LeeSpo/portable-display-epass-EVT1-minboot-r1/README.md

# Portable Display ePass

当前自研硬件为 **38 × 64 mm、四层 split-power 工程候选**，尚未放行生产。

- [打开当前 KiCad 工程与运行验证](portable-display/hardware/v1-WEB6-redesign/split-power-candidate/README_CN.md)
- [未完成项与实板验收](portable-display/hardware/v1-WEB6-redesign/split-power-candidate/OPEN_ISSUES_CN.md)
- [JLC 报价/预览包（未放行）](portable-display/hardware/v1-WEB6-redesign/split-power-candidate/verification/production_20261015/README_CN.md)
- [开发板学习资料](portable-display/hardware/v2-dev-board/README_CN.md)
- [项目进展、分支与旧稿恢复](portable-display/docs/PROJECT_STATUS_CN.md)

仓库只保留最新工程和验证包。旧版本、布线试验和历史报告通过 Git 历史追溯；不重写历史。
