LeeSpo/portable-display-epass-EVT1-minboot-r1/portable-display/README.md

# Portable Display

当前硬件为 38 × 64 mm 四层工程候选。电源冷启动、屏幕装配和实板功能尚未验收，**未放行投板、贴片或上电**。

| 入口 | 内容 |
|---|---|
| [当前自研工程](hardware/v1-WEB6-redesign/split-power-candidate/README_CN.md) | 原理图、PCB、本地库、约束及独立验证工具 |
| [当前工程验收记录](hardware/v1-WEB6-redesign/split-power-candidate/OPEN_ISSUES_CN.md) | 尚未关闭的工程与实板事项 |
| [开发板资料](hardware/v2-dev-board/README_CN.md) | YuzukiHD-Lizard 文档和图片，不是自研板的下一硬件版本 |
| [产品和屏幕资料](docs/README.md) | 屏幕规范、机械装配评估和项目状态 |
| [原始参考资料](reference/README.md) | 芯片/连接器资料、原始引脚表 |

工程使用 `${KIPRJMOD}` 本地库。运行命令见当前工程 README；无需历史硬件目录。
