LeeSpo/portable-display-epass-EVT1-minboot-r1/portable-display/docs/README.md

# 产品和工程文档

- [项目进展、分支及旧稿恢复](PROJECT_STATUS_CN.md)
- [屏幕/PCB 装配评估](SCREEN_STACK_CN.md)
- [KD024 屏幕工程规格](kd024_screen/KD024EGOIN152-01_engineering_spec.md)
- [KD024 原始规格书](kd024_screen/raw-pdf/KD024EGOIN152-01_SPEC_V1.pdf)
- [原始参考资料](../reference/README.md)

当前硬件入口：[split-power-candidate](../hardware/v1-WEB6-redesign/split-power-candidate/README_CN.md)。
