LeeSpo/portable-display-epass-EVT1-minboot-r1/portable-display/hardware/v1-WEB6-redesign/README_CN.md

# WEB6 自研硬件

唯一维护的硬件是 [split-power-candidate](split-power-candidate/README_CN.md)。
用 KiCad 10 打开该目录的 `ak_display_38x64_SPLIT_POWER_CANDIDATE.kicad_pro`。

旧 placement-only 布局和路由试验已从当前文件树移除；[项目状态及恢复方法](../../docs/PROJECT_STATUS_CN.md)记录其 Git 来源。
当前工程仍未放行生产。
