LeeSpo/portable-display-epass-EVT1-minboot-r1/portable-display/hardware/v2-dev-board/README_CN.md

# V851S 开发板参考资料

从 `dev-board` 的 `13f46d0` 合入。目录名 `v2-dev-board` 沿用原分支，内容是 YuzukiHD-Lizard 学习资料，并非自研 PCB 的 EVT2。

- [开发板介绍](YuzukiHD-Lizard/01-BoardIntroduction.md)
- [配套资源](YuzukiHD-Lizard/02-SupportingResources.md)
- [快速开始](YuzukiHD-Lizard/03-QuickStart.md)
- [开发环境](YuzukiHD-Lizard/06-ConfigHostEnv.md)
- [Tina SDK 开发](YuzukiHD-Lizard/07-TinaSDK_DevelopmentGuide.md)

已保留原分支的 50 个文档/图片文件，内容未修改；重复 ZIP 已移除。文档内外部资源为原资料记录，本次未重新验证其时效性。
