LeeSpo/portable-display-epass-EVT1-minboot-r1/portable-display/hardware/v1-WEB6-redesign/split-power-candidate/OPTIMIZATION_20261018_CN.md

# 2026-10-18 PCB 优化记录

本轮保留全部功能、38 × 64 mm 板框、四层叠层及原有规则。目标是改善调试、局部去耦和可制造性；工程候选状态不变。

## 已实施修改

| 修改 | 目的与范围 |
|---|---|
| TP1–TP10 裸测试点 | 从既有过孔引出十个直径 1 mm 的背面探针焊盘；只有铜和阻焊开窗，无锡膏，不采购、不贴装 |
| 电池线序丝印 | 背面新增 `1+ 2NTC 3-`，对应 J2 的 VBAT / BAT_NTC / GND；仍须按插座针号确认线材极性 |
| U2-47 独立去耦 | 增加 C64：100 nF / 0402 / C1525，复用现有料号；47 脚就近进入独立 3V3 过孔，C57 继续服务 55 脚 |
| DSI D0N 调长拐角 | 将 16 个直角换成 45° 转折，保持 0.127 mm 线宽、F.Cu 和长度匹配；D0 仍是两根独立走线 |
| 三处非 EP 过孔外移 | 外移原与 U1.6/7、C1.1、C46.2 重叠的过孔；保留 0.60/0.30 mm 尺寸，增加五段 0.30 mm 同网短线 |
| 生产包核对 | 逐颗检查 BOM 型号、封装、料号、数量，以及 CPL 坐标、面和角度；增加错误包回归案例 |

C64 位于 B 面 `(13.3, 26.1)`、180°；新 3V3 过孔位于 `(12.8, 25.025)`，新 GND 过孔位于 `(14.32, 26.425)`。为腾出回路，只调整局部 SOC_AVCC、FEL_KEY_N、PMIC_SDA 走线；C35、WAKE 和 ADC 路线保留。SOC_AVCC 末端有短段 0.127 mm 细颈，其余局部线路保持 0.18 mm；这不是载流或噪声实测结论。

新增 GND 过孔的铜环与 C64.1 角落略有重叠，钻孔本身未进入焊盘（孔边到焊盘约 0.07 mm）；该局部折中仍依赖既有全孔 POFV，不能当作普通开放通孔设计。

## 测试点

下表坐标是 KiCad 板坐标，均在 B 面；从背面查看时图像需要镜像。机器可读映射见 [testpoint_map.json](testpoint_map.json)。

| 位号 | 网络 | X / Y（mm） |
|---|---|---|
| TP1 | CORE_0V93 | 19.400 / 46.700 |
| TP2 | DRAM_1V5 | 29.550 / 44.900 |
| TP3 | 1V8 | 12.834 / 23.516 |
| TP4 | RTC_3V3 | 34.750 / 12.400 |
| TP5 | VSYS | 19.900 / 50.700 |
| TP6 | ELVDD | 6.900 / 41.100 |
| TP7 | ELVSS | 9.200 / 43.100 |
| TP8 | PMIC_SCL | 14.734 / 19.366 |
| TP9 | PMIC_SDA | 6.500 / 17.700 |
| TP10 | GND | 4.491 / 47.142 |

探针焊盘用于测量，不作为带载供电入口；PMIC I²C 测量设备须适配实际电源域。首次上电步骤见 [BRINGUP_CN.md](BRINGUP_CN.md)。

## 制造与预算影响

- 贴装数量由 130 增至 **131 颗：117 正面 / 14 背面**。C64 归入既有 C1525 行，BOM 仍为 54 行；测试点不进入 BOM/CPL。
- 本轮外移三处过孔后，U1/U2 EP 等区域仍有焊盘内过孔，**POFV 必须保留**；双面标准型贴片要求也保留。
- U12/U13 没有向 TF 卡座移动：卡座的机械占位和 courtyard 限制了位置，不宜仅按连通图强行靠近。
- 两块个人样机应按 **2 PCS 完整单板**核价。`3×2` 拼板的 `2 SET` 对应 12 PCS，不能据此当作两块单板的器件成本。
- 本轮不承诺总价 600 元。先纠正数量，再用新 BOM/CPL 取得包含 PCB、POFV 和全部贴装的正式报价。

## 验证与未完成项

当前源哈希、完整检查和预览见 [工程入口](README_CN.md)、[本轮验证](verification/current_20261018/README_CN.md)及[新生产预览包](verification/production_20261018/README_CN.md)。填铜在隔离编辑副本中受控保存；正式验证另用隔离副本，不保存维护源文件，不修改规则或豁免。

PMIC 批次 OTP 冷启动、屏幕/FPC 实物适配、装联/X-Ray、高速阻抗与实板波形仍需验收。DSI 等长和原生 DRC 通过都不能替代这些验收，详见 [OPEN_ISSUES_CN.md](OPEN_ISSUES_CN.md)。
