LeeSpo/portable-display-epass-EVT1-minboot-r1/portable-display/hardware/v1-WEB6-redesign/split-power-candidate/PREFLIGHT_DECISIONS_CN.md

# 预投板阻塞项修复：决策日志（fix/preflight-blockers）

> 历史工程决策记录：器件数量、哈希、图片和检查结果对应各段原日期。当前状态见 [README](README_CN.md)、[未完成项](OPEN_ISSUES_CN.md)及本轮验证；旧报告从固定 Git 提交读取。

> 用户把所有选择都交给了我们，原则是：**先保证能工作，再尽量便宜**。优先选 JLC/LCSC 有库存的料，basic 库优先。
> DRC 规则一律不放宽，也不加任何豁免。过孔统一 0.60/0.30。U1/U2 不移动。fabrication 仍为 **未放行**。
> 价格和库存是 2026-10-15 查询 JLC/LCSC API 得到的。

## 1. FEL 铜皮 + 原理图同步
- 详见 `FEL_REPAIR_CN.md`。原理图由 `tools/build_candidate_schematic.py` 从 PCB 重新生成。parity 0 / ERC 0。

## 2. LCD_EN 默认关断：R35 10k（C25744，basic，LCSC $0.0033 @100）
- 评审建议在 R31 上贴 100k。核对后发现 **R31 不是下拉**，它是 LCD_SWIRE↔LCD_EN 之间的 0R 跨接，应保持 DNP。如果把它贴上，SWIRE 和 EN 会被短接，所以没有采纳这条建议。
- 因此新增 R35 下拉到 GND。阻值取 10k 而不是 100k：按 GPIO 漏电最坏 10 µA 估算，10k 上的压降 ≤0.1 V，可以可靠地保持 U8 / U10 CTRL 为低；换成 100k 最坏会到 1 V，不安全。PD21 驱动为高时，10k 上的电流是 0.33 mA，可以接受。

## 3. D6–D14 ESD：ESDLC5V0LB（扬杰，C20168172，$0.0297 @20+，库存约 2900）
- 5 V 双向，约 3 pF，适合 SD 和按键这类低速信号。原来的料与封装不一致。新建 `sameat.pretty/DFN1006-2`，焊盘按数据手册 p5 绘制（±0.425，0.55×0.60）。

## 4. J2 电池座：Megastar ZX-SH1.0-3PWT（C7430445，$0.0573，库存约 67k）
- J1 和 H4 之间只有 8.49 mm。PH2.0（11.7 mm）和 MX1.25（9.4 mm）都放不下，JST S3B-PH（C265101）也缺货。SH1.0 3P 卧式能放下。
- **注意 1**：每个触点额定 1 A。1S 锂电只要平均电流 <1 A 就可以用，峰值应该由 PMIC 限流。
- **注意 2**：电池线序是 1=VBAT、2=NTC、3=GND。市售 SH1.0 电池的线序**不统一**，接电前必须用万用表核对。
- 新封装 `SH1.0_3P_RA` 按厂家图纸绘制。VBAT/NTC/VBUS/PMIC_IRQ 已重新布线，并补了一条 In2 3V3 桥接，让 3V3 带状铺铜保持连续。

## 5. J5 microSD —— **未完成（开放项）**
- 原料 MUP-M617-2（C5205359）在 JLC 缺货。选定的替代是 **XKTF-0803-0（XKB，C381083，$0.2058，库存约 1613，push-push，11.25×6 mm）**，可以放进原来的位置。
- 封装 `sameat.pretty/XKTF-0803-0.kicad_mod` 已提交。焊盘与 JLC EasyEDA 官方封装和 XKB 图纸逐一核对过。
- 没有换上板的原因：换件后引脚顺序会整体反过来。原来的 SD 走线、以及 RTC_3V3 / PMIC_SDA / PWRON_N 的长线都需要重新布线。我们写的自动布线器做不到 0 违规（freerouting 2.1 也会卡在 11–18 根未布通）。为了不让分支变脏，**PCB 目前仍然是旧的 J5（BOM 里那个料缺货）**。
- 建议：在 KiCad GUI 里用交互式推挤布线完成，大约 1–2 小时。SD 走线放在 F/B 层，不要走 In2。可以顺便把 Y1 下方的 SD 线移开（见第 9 节）。

## 6. U8 输入电容（评审 g）
- C53 1 µF（CL05A105KA5NQNC，C52923，basic，$0.0079）+ C54 100 nF（CL05B104KO5NNNC，C1525，basic，LCSC $0.0046 @100）。两颗都在顶层，距离 U8.1 焊盘边 ≤0.65 mm。GND 过孔放在焊盘外，焊盘边到孔的距离 ≥0.15 mm。

## 7. VBUS 线宽（评审 h）
- J1→C32/U1.37 主路径上，B.Cu 的两段 0.25 mm 已加宽到 0.6 mm。
- J1 附近 F.Cu 的 0.25 mm 瓶颈没有加宽：加宽到 0.6 会碰到 CC2、SBU1 焊盘和 C2 的 GND，DRC 不过。J1 A4/B9 一侧另有一条 0.6 mm 并联路径。
- U1.37 的扇出保持 0.18 mm，这是焊盘间距限制的。
- 剩下的 0.127 mm 段在 U9 那条小电流支路上。

## 8. U2 去耦（评审 f）—— **未完成（开放项）**
- 我们对 U2 的 44/47/55（3V3）、37（1V8）、13/17/75（CORE）做了自动搜索：要求顶层 0402、距焊盘 ≤2 mm、GND 过孔在焊盘外，结果**都找不到合规位置**。U2 周围的扇出和其它 courtyard 已经占满，也不能改 U2 或它的 courtyard。底层附近又没有对应电源网络的铜皮可以接。
- 现状：最近的去耦电容离引脚 5.7–11 mm，但这些电源在 In2 都有平面，In1 是 GND，所以电源回路阻抗本身不算差。
- 建议：在 GUI 里重新整理 U2 扇出，为顶层电容腾出位置。另一条路是放到底层，直接贴在 U2 背面，但这样就变成**双面 SMT**，JLC 要多收一次底面贴装的工程费和钢网费，成本明显上升。因为用户要求便宜，我们没有自动这样做。

## 9. 其它评审项
- (b) PMIC_SCL：B.Cu 上一段走线从 L2/LX_CORE 投影下方穿过。核实后，中间的 In1 在该处是**完整的 GND 铺铜**（已用 pcbnew 采样点确认），F 层到 B 层的耦合被屏蔽；I2C 只有 100/400 kHz。**决定不改线**，避免引入新的违规。
- (c) Y1：In1 和 In2 在 Y1 正下方都是 GND。B.Cu 上有 SD_D0、SD_D2、SD_DET、SD_PWR_EN、SOC_LDO_1V8 从下方穿过，它们被 In1 GND 隔开。In2 上有 SD_DET、SD_PWR_EN 两段静态信号从边缘经过。XIN 5.4 mm、XOUT 7.4 mm，受限于 U2 不能动。**留到 J5 返工时一起把 SD 线移出 Y1 区域**。
- (d) MIPI DSI：D0 skew 11.05 mm、CK 5.00 mm，CKP 有一个 90° 拐角。J4 和屏幕都还没定，**本轮不改**，等 J4 定型后再做等长和 45° 拐角。
- (e) I2C0 上拉 R15/R16：**保持接在主 3V3**。
  - 3V3 关断时，总线被拉到约 0 V。U4（LIS2DW12）和 U5（RV-3028）由 RTC_3V3 供电，它们的 IO 处于低电平，这在允许范围内，不会倒灌。
  - 如果把上拉改到 RTC_3V3，3V3 关断时总线仍是 3.3 V，电流会通过 V851S 的 IO 钳位二极管倒灌进未上电的 SoC（10k 约 0.33 mA）。这种情况更糟。
  - 代价：SoC 关机时无法访问 I2C。这没有关系，唤醒走 INT 线（缓冲器 U11 支持 Ioff）。

## 10. P1 项（只记录，不编造测量值）
- RTCLDO 精度 ±10%（PMIC C3036461），而 LIS2DW12 绝对最大值是 3.6 V。如果出厂设定是 3.3 V，+10% = 3.63 V，会略超绝对最大值。**需要实测 RTC_3V3**，或者确认 OTP 设定值。
- VSYS 与 TPS65631（U10）的输入范围 2.9–4.5 V：电池电压 4.2 V 在范围内，但 VBUS 直通或充电时 VSYS 的上限必须由 PMIC 设定值保证。**需要实测**。
- PMIC OTP：C3036461 的出厂电压、使能和时序配置，在现有资料里没有说明（`check_power_contract` 的 remaining_blocker）。

## 验证（verification/preflight_fix_20261015）
- DRC（含 --schematic-parity --refill-zones --severity-all）：0 violations / 0 unconnected / 0 parity。
- ERC：0。
- check_power_contract / check_fel_recovery / check_usb_routing / check_wake_domain：static_checks_passed = true。

## J5 microSD 换座与重布线（2026-10-15，已完成）

- **J5 换为 XKTF-0803-0（LCSC C381083，有库存，自弹式，约 11.6×10.5 mm 封装）**。原 MUP-M617-2 无库存。备选 TF PUSH C393941（深约 15 mm）、LCK-TF-110（15 mm）、TF-110（11.3 mm）因深度/板边不合适，放弃。
- **SD ESD 方案改为 2× TPD4E05U06DQAR（U12/U13，LCSC C138714，约 $0.082，库存约 9.4 万，IO 电容 0.5 pF）**，替换原来 7 颗分立 ESDLC5V0LB（D6–D12，约 3 pF/颗）。原因：
  - 0.5 pF 远低于 3 pF，对 SD_CLK 更友好；
  - 流通式（flow-through）封装可以让 6 根 SD 线直接穿过，不需要再绕线。
  - U12 接 SD_D2/D3/CMD/DET，U13 接 SD_CLK/D0/D1，U13 的 1/10 脚留空（数据手册允许）。
  - D13/D14（CC1/CC2）保留 ESDLC5V0LB。
- **SD 总线全部改为 F.Cu 0.127 mm 平行走线**，路径是 U2 → 45° 斜线 → U12/U13 → J5，**Y1 晶振投影区下方已没有任何 SD 线**（脚本检查过：Y1 区域内只剩 GND 过孔）。
- **改动和移动的元件：**
  - C13 移到 (28.4,28.85)，XOUT 走线变短。
  - C14（3V3 100 nF）原位置被 SD 总线占用，改放在 Q3 输入旁 (28.6,36.7)，作为 SD 电源开关的输入去耦。
  - C34（SOC_LDO_1V8 2.2 µF）由 0603 改为 0402 CL05A225MQ5NSNC（C12530，basic 库，$0.0054），放到 **B 面** (24.05,29.275)，避开 Y1 投影。
- **重布的网络：** PMIC_SDA、PMIC_SCL、PMIC_IRQ_N、PWRON_N、RTC_3V3、DRAM_1V5、SOC_LDO_1V8、SD_PWR_GATE、SD_3V3、SD_PWR_EN。
  - SD_3V3 从 J5.4 引出的颈部是 0.15 mm、长约 0.8 mm，夹在 CMD 与 DET 两个焊盘之间，没有更宽的空间；SD 卡峰值电流约 100–200 mA，这个宽度足够。
  - SD_PWR_EN 与原设计一样借用 In2 走一段（在 U2 下方 15.68,24.32 → 19.5,33.2）。这是低速静态使能信号；In2 是电源层，不是参考地，DRC 确认没有产生孤岛或未连接。
- 检查结果：DRC 0 违规 / 0 未连接 / 0 原理图一致性问题；ERC 0；power_contract、fel_recovery、usb_routing、wake_domain 全部通过。输出在 [verification/preflight_j5_20261015/](https://github.com/LeeSpo/portable-display-epass-EVT1-minboot-r1/tree/b14e0fbead4cc5602254eedcb0fa77d3e3236ec2/portable-display/hardware/v1-WEB6-redesign/split-power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)。

## U10 TPS65631 改由 3V3 供电（2026-10-15）

- **原因：**
  - TPS65631 输入范围是 2.9–4.5 V（TI SLVSBK1E §7.3），绝对最大 6 V。
  - VSYS 在插着 USB 或充电时可能超过 4.5 V，所以改用稳定的 3V3（AXP2101 DCDC1）。
- **改动：**
  - U10-11（AVIN）、U10-12（PVIN）、L5.1（升压电感输入）以及原 VSYS 小岛（含过孔）全部改为 3V3，与 VSYS 主网断开。U1 的 VSYS 引脚不受影响。
  - **3V3 取点：** 在 U10 上方新增 2 个 3V3 过孔 (7.25,46.75)、(8.05,46.75)，打到 In2 的 3V3 铜皮（离 U2、Y1 很远）。F 面用 0.4 mm 线接到 U10-12/11。L5 的 B 面供电线由 0.18 mm 加宽到 0.3 mm；靠近 GND 过孔 (7.76,44.18) 的那一小段只能做到 0.2–0.25 mm。
  - **输入电容：**
    - C46、C47 由 0603 改为 0402 10 µF CL05A106MQ5NUNC（C15525，basic，$0.0257）。
    - 新增 C59 100 nF（C1525）。
    - 三颗都放在 **B 面 U10 正下方**，紧挨 3V3 过孔，焊盘到 U10-11/12 的距离 ≤1 mm（≤2 mm 要求）。
    - 原来顶面 C46 的位置被 ELVSS 走线隔开，没法近距离接到 U10。
    - 数据手册推荐 2×10 µF，本方案满足。
- **软启动：** 数据手册 §8.3.3 说明，CTRL 拉高后升压级先以较低的开关电流限值启动（软启动，限制浪涌），10 ms 后负压级才启动。关断时（CTRL=0）输出与输入断开并主动放电，关断电流 0.1 µA。R35 把 LCD_EN 默认下拉为低，所以上电时 U10 不工作。**结论：不需要额外的负载开关。**
- **AXP2101 DCDC1 电流预算：**
  - DCDC1 额定 2 A。
  - U10 典型负载（屏幕约 100 mA@4.6 V / −4 V，效率约 85%）时，3V3 输入约 0.3 A；数据手册满载（各 300 mA）最坏约 1.0 A。
  - 加上 SoC IO、SD 卡（峰值约 0.2 A）等其余负载，最坏合计约 1.4–1.5 A，低于 2 A。
  - 需要实测确认屏幕全白画面的电流。
- 检查：DRC 0/0/0，ERC 0，四项静态检查通过（[verification/preflight_u10_20261015/](https://github.com/LeeSpo/portable-display-epass-EVT1-minboot-r1/tree/b14e0fbead4cc5602254eedcb0fa77d3e3236ec2/portable-display/hardware/v1-WEB6-redesign/split-power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)）。

## 2026-10-15 · 0Ω 电源隔离链接（R36–R40）
- 在 AXP2101 每路输出与负载之间加 0402 0Ω（0402WGF0000TCE，C17168，basic，≈$0.0011）。成本几乎为零，可逐路隔离短路/OTP 错误。
- 3V3 分为两路：R39（B 面，主干，经新 3V3 via (16.1,49.95) 进入 In2 3V3 带）、R38（北支路 3V3_B）。原因：两片负载区在 U2 下方无法在负载侧互连（布线失败），因此各自从 PMIC 侧取电。3V3_B 原有 0.18 mm 线段仍偏细（负载 Q3/U2.5/U2.78/D1，电流小），列入 OPEN_ISSUES。
- 反馈点保持在 PMIC 侧（U1.4/U1.9），断链接时 PMIC 可空载上电。
- R40 原放在 FPC_MATING_PROVISIONAL keepout 内，移至 (24.6,44.5) 90°，不放宽规则。
- ERC：1V8_PMIC 由 U1.18（power_out）驱动，不能加 PWR_FLAG；改为对负载侧 1V8 加 SUPPLY_SOURCE 标记（EXTRA_SUPPLY_NETS）。
- 修复：footprint 复制（pcbnew.FOOTPRINT(src)）会复制 UUID，导致 DRC 报错张冠李戴；已为 10 个重复的 footprint 重新生成 UUID。
- 流程见 BRINGUP_CN.md。验证：verification/preflight_links_20261015（DRC 0 / ERC 0 / unconnected 0 / parity 0，power_contract / fel / usb / wake 全部 True）。

## 2026-10-15 · U2 左上角去耦（pin 44 / 47 / 37）
- F 面 U2 左上角无空间（U2 courtyard 到 12.76/22.75，C31/R4/R5 紧邻），按指示改在 B 面。
- 拆除并重布 B 面 STATUS_LED、UART0_RX、WAKE_PULSE_N、KEY_BACK（全部低速 GPIO）。KEY_BACK 35.6→39.6 mm，多 2 个 via；其余长度基本不变。
- 新增 C60 100nF（CL05B104KO5NNNC，C1525，basic）B 面 (12.93,21.78)，经新 3V3 via (13.7,20.915) 接 pin 44 扇出；原最近电容 C57 6.4 mm。
- 新增 C62 100nF（C1525）B 面 (19.43,24.3)，经 B 走线接 pin 37 的 1V8 via (16.75,22.9)；原最近电容 C17 8.2 mm（布线距离约 3 mm）。
- pin 47：F 面 3V3 走线 47→55 约 2.6 mm，与 pin 55 共用 C57（B 面，经 via 12.8,28.3）。再加电容需拆 PMIC_SDA/SCL/FEL_KEY_N，风险大于收益，暂不做，记录在 OPEN_ISSUES。
- 验证：verification/preflight_u2dec_20261015，全部 0。

## 2026-10-15 · 丝印 pin-1 圆点与二极管极性
- 在库 footprint（sameat.pretty）与板上实例同时加入 F.SilkS 标记，避免 lib_footprint_mismatch：
  - pin-1 实心圆点（Ø0.3 mm）：U1、U2、U4、U5、U6、U8、U9、U10、U11、U12/U13、Q1–Q3、J2、J3、J4、J5、Y1。位置由脚本在所有实例上同时检查：与任何焊盘/丝印 ≥0.16 mm、离板边 ≥0.3 mm。
  - 阴极条（0.15 mm 线）：D1/D5 LED0603 在 pin 2（阴极，pin 1 = 阳极 3V3_B / STATUS_LED_A）；D2/D3 SOD-123 在 pin 1（阴极接 RTC_INT_N / ACCEL_INT_N，WAKE_REQ_N 为阳极侧）。
  - D13/D14 ESDLC5V0LB 为双向 TVS（Yangjie 规格书：Bidirectional，无极性标记），不加极性标记。
- L1–L3/L5/L6 电感、J1 USB-C 无方向要求。
- 注意：D2/D3 仍无 MPN/LCSC（见 OPEN_ISSUES），阴极映射需按最终选型的 SOD-123 规格书再次确认。
- 验证：verification/preflight_silk_20261015，全部 0。

## 2026-10-15 · 焊盘内过孔（via-in-pad）外移
- 脚本 /workspace/t/vmove.py：对每个与 SMD 焊盘重叠的 via（排除 U1/U2/U10 EP、J1、J5 屏蔽脚，VSYS 因 In2 孤岛风险不动），在 0.45–1.2 mm 环上寻找新位置：与任何焊盘 ≥0.1 mm、异网 ≥0.15 mm、孔间距 ≥0.6 mm 中心距、不进 keepout；原连线在各层补短线。
- 已外移 18 个：C37.2、C39.2、J4.8、C10.2、J4.30、U6.4、C17.2(一个)、C14.1、D13.2、C51.2、Y1.4、C43.1、U8.6(一个)、C4.1、U6.6、C59.2、R5.1、U5.4。明细：verification/preflight_vip_20261015/via_moves.json。
- 仍在焊盘内（20 个，空间不足）：U9.2、C18.1/.2、J4.3/.5/.9、C17.2(另一个)、C29.2、R20.1、C12.2、U8.6(另一个)、R22.1、L1.2、C23.1、C46.2、C32.1、U5.3、U5.8、C37.1、VSYS C1/C40。
  - 处理建议：下单时选 JLC “盘中孔 树脂塞孔+电镀盖帽 (POFV)” 工艺，或至少对这些 via 阻焊塞孔。四层板 POFV 加价需在下单时确认（不在本 PR 内采购）。
- 验证：verification/preflight_vip_20261015，全部 0。

## 2026-10-15 · J4 定型 + DSI 等长
- **J4 定型：Molex 502598-4593，LCSC C5365339**（JLC 扩展库，库存约 1.7 万，≈$0.46）。KD024 规格书（../../../docs/kd024_screen/KD024EGOIN152-01_engineering_spec.md）推荐 502598-4591，该型号已停产，DigiKey 标注 -4593 为直接替代（同系列 BackFlip，45P/0.3 mm，双面触点，高 1.14 mm）。
- 引脚对照 KD024 pinout.csv（与 ../../../docs/kd024_screen/KD024EGOIN152-01_pinout.csv 一致）逐脚核对：GND/ELVSS/ELVDD/VCI(LCD_3V3)/VDDIO(LCD_1V8)/TE/RESX/SWIRE/D0P/D0N/CLKP/CLKN 均正确；IM1/IM0（31/32）接 GND = MIPI 模式（规格书 §5）；MTP(43) 接 GND 符合“开路或接地”；MCU 总线 18–29 不用、悬空；TE1(13) 悬空。
- 焊盘与 LCSC/EasyEDA C5365339 封装对比：45 个信号焊盘位置/尺寸一致（行距 3.065 vs 3.06 mm，差 5 µm）；MP1/MP2 固定脚差 0.17 mm(x)/0.1 mm(y)。项目库基于 Molex SD-502598-003 图纸审过，保留不改；Molex 官网图纸此次无法下载（连接被拒），列入 OPEN_ISSUES 待人工对照。
- **DSI 等长**：错位双排使 P 线（远排）必须绕行，拓扑无法缩短。改为在 N 线上加蛇形（0.127 mm 线宽，0.3 mm 节距，与异网 ≥0.17 mm）：
  - D0：P 19.009 / N 19.007 mm（原 N 7.957）
  - CK：P 12.871 / N 12.874 mm（原 N 7.874）
  - 线对内偏差 ≤0.003 mm。D0 和 CK 之间差 6.1 mm（约 41 ps），远小于 456 Mbps 时 D-PHY 允许的时钟-数据偏差（±0.15 UI ≈ ±330 ps）。
  - 蛇形切断了 F 面一小块 GND 铺铜孤岛，新增 GND via (18.3,35.9) 接回。
  - 差分阻抗（100 Ω）和耦合：仍是单根走线、没有紧耦合，阻抗未经仿真，记录在 OPEN_ISSUES。
- 验证：verification/preflight_j4dsi_20261015（全部 0，dsi_lengths.txt）。

## 2026-10-15 · FEL_N In1 槽缩短、PMIC_SCL 说明、3V3_B 加宽
- **FEL_N**：原来在 In1(GND) 上走 8.76 mm（14.32,28.24 → 6.0,28.2），把 CORE_0V93/3V3/BOOT0/BOOT1（F）的回流参考切开。重布：In1 只剩 4.48 mm（14.32,28.24 → 10.3,27.15），之后经 via (10.3,27.15) → B 1.45 mm → via (9.4,28.225) → F 到 R33/R34。via 6.0,28.2 已删除（只剩 F 单层连接）。F/B 完全不经 In1 的路线需要绕行 72 mm，不采用。FEL_N 是上电时采样的静态 strap，没有信号完整性要求。
- **PMIC_SCL（2026-10-15 更正）：**
  - **从 L2/LX_CORE 投影下方穿过的那一段在 B.Cu 上**，就是 (27.4, 53.1) → (32.4, 48.1)。它和 F 层的 L2 之间隔着 **In1 GND** 铺铜做屏蔽，**和 In2 无关**。
  - 另有一段 2.65 mm 的内层跳线在 In2 上，位置是 x 25.1–27.5、y 15.35–15.95，离 L2 很远，在板子北侧。那里的 In2 是 GND 铺铜。
  - 以前的写法容易让人以为"L2 下方那段走在 In2 上"，这里更正。I2C 只有 100/400 kHz，两处都不改线。
- **3V3_B**：12 段 0.18 mm 加宽到 0.25 mm（含 R38 出口的一段），1 段加到 0.22 mm（受 DRAM_1V5 via 间距限制）。剩下 12 段 0.18 mm 是 U2.78 旁边贴着 DSI_D0N 的扇出线，以及 DRAM via 旁 3 段很短的线，加宽会违反 0.127 mm 间距。3V3_B 负载很小（Q3 栅极、U2.5/78 IO 电源、D1 LED），0.18 mm 足够。
- 验证：verification/preflight_fel_20261015，全部 0。

## 2026-10-15 · D2/D3 选型：BAT54W（Yangjie，LCSC C699107）
- 电路：RTC_INT_N / ACCEL_INT_N（开漏，R17/R18 10 kΩ 上拉到 RTC_3V3）经 D2/D3 做“线与”，驱动 WAKE_REQ_N → U6。阴极接 INT（pin 1），阳极接 WAKE_REQ_N（pin 2）。
- 候选对比：
  - B5819W C8598（basic，40 V/1 A）：IR 为 1 mA@40 V。一路触发时另一只管子反偏约 3 V，高温下几十到几百 µA 的漏电流流过 10 kΩ 上拉，会把未触发的 INT 拉低 0.5–3 V。可能误判，**不满足“works first”**。
  - **BAT54W C699107**（extended，库存约 2.3 万，$0.032，IR 2 µA@25 V）：漏电流小两到三个数量级。Vf 约 0.25 V@0.33 mA，WAKE_REQ_N 低电平 ≈ 0.4 + 0.25 ≈ 0.65 V，低于 74LVC1G123 的 VIL 0.8 V。选用它，代价是 JLC extended 换料费。
- 极性核对：EasyEDA C699107 符号 pin 1 = C（阴极），封装 pad 1 在 −x 并有阴极条；本库 D_SOD123 的 pad 1 在 −x，丝印阴极条在 −2.1 mm，三者一致。
- 焊盘：原 land（±1.25，1.2×1.1）外缘只到 1.85 mm，覆盖不到 SOD-123 引脚尖（最大 1.93 mm）。改为 ±1.33、1.1×1.1，外缘 1.88 mm。再往外会与 KEY_BACK 过孔和 RTC_3V3 走线冲突。库和板同步修改。
- 验证：verification/preflight_d23_20261015，全部 0。

## 2026-10-15 · J4 固定脚 MP1/MP2 按 Molex 原图修正

- 依据是 Molex 官网 SD-502598-003（5025984593_sd.pdf）的推荐焊盘图：
  - 固定脚中心在 1 脚外侧 0.975 mm 处，比信号焊盘行再往上偏一点。
  - 45 针时，尺寸表 D = 12.6、B = 13.2、A = 15.6、C = 15.15。
  - 信号焊盘 0.3 mm 宽，间距 0.6 mm 交错排列，奇数脚焊盘长 0.67 mm。这些和现在的封装一致。
- 改动：
  - MP1/MP2 的局部坐标从 (∓7.4, −0.365) 改成 (∓7.575, −0.26)，焊盘尺寸 0.35×1.0 不变。
  - 改动和 EasyEDA C5365339 的封装一致。板上和 sameat.pretty/FPC45.kicad_mod 都改了。
- 附带改动：
  - 1V8 过孔 (23.8, 43.55) 移到 (24.2, 43.55)。
  - USB_DM 在 MP1 旁边的走线随 USB 线对一起重布。

## 2026-10-15 · 阻抗叠层与 USB/DSI 耦合线对

- **叠层选 JLC04101H-3313，不选 7628。**
  - 7628（介质 h = 0.21 mm）：90 Ω 需要 w0.233/s0.15，100 Ω 需要 w0.172/s0.15，两个数都来自 JITX 发布的 JLC 数据。
  - 实测 U2 到 J4/U9 之间的走线通道只有约 0.38–0.40 mm 宽，连 0.2/0.127 的线对都放不下（router 直接失败）。要放下就得重新布局 U2 西侧。
  - 3313（h = 0.0994 mm，εr 4.1）在现有通道里就能做到目标阻抗。
- **计算方法：**
  - 用 IPC-2141 / Wadell 的边耦合微带公式：Z0 = 87/√(εr+1.41)·ln(5.98h/(0.8w+t))，Zdiff = 2Z0(1−0.48e^(−0.96s/h))，t = 0.035 mm。
  - 校准：用同一公式算 JITX/JLC 发布的 7628 数据（90 Ω 和 100 Ω 各一组），公式结果平均偏高 7.1%。下面 3313 的数值都已经除以 1.071，相当于把阻焊和 JLC 场求解器的修正折算进去了。
  - 下单时开阻抗控制，JLC 会按自己的场求解器微调线宽。
- **USB（90 Ω）：**
  - 几何：w 0.127 / s 0.140，计算值约 89 Ω（h 取 0.089 时约 84 Ω），在 USB 90 Ω ±15% 范围内。
  - 走线：U2.76/77 → U9.3/U9.1 全程在 F 层耦合，中心距 0.267，耦合段 31.24 mm。
  - 等长：正插/反插的名义路径差 0.285/0.259 mm。
  - tools/check_usb_routing.py 的线对中心距窗口改成 0.262–0.287 mm（几何 0.267，45° 斜接拐角留 −0.005/+0.020 余量），≥90% 覆盖的门槛不变：DP 96.5%，DM 91.3%。
  - 为了让线对通过，挪了几个过孔：
    - CORE_0V93 过孔到 (15.375, 33.625)，ELVDD 的一个折点移了 0.023 mm。
    - ELVSS 过孔到 (9.79, 44.41)，LCD_TE 过孔到 (11.21, 44.04)，LCD_EN 过孔到 (13.468, 33.807)。
    - J4 西侧的 GND 缝合过孔从 (9.4, 41.7) 移到 (9.6, 40.525)。这个过孔给 F 层的一块 GND 小岛接地，不在任何焊盘内。
- **DSI（100 Ω）：**
  - **CK 线对：**
    - 几何：w 0.100 / s 0.150，计算值约 101 Ω。
    - 走线：从 U2.84/85 出发，经 J4 右端进入两排焊盘之间的通道，耦合段 10.87 mm（其中 2.12 mm 收窄到 s 0.127，约 98 Ω）。CKN 从下方接近端焊盘 40，CKP 从上方接远端焊盘 39。
    - 为腾出通道，通道里的 GND 过孔 (22.08, 41.39) 移到 (22.10, 42.05)。
    - 等长：CKN 用一个 0.455 mm 的凸起补偿，结果 13.111/13.111 mm。
  - **D0 线对不做紧耦合：**
    - U2 上 D0N/D0P 在 CK 线对左边，J4 上 D0P 在远端那排。单层布线的话，D0P 必须从 CK 线对的上方和右侧绕过去（拓扑上一定会交叉）。要紧耦合就得给 D0P 加两个换层过孔，而且换到 B 层后参考面是电源和 GND 混合的 In2，反而更差。
    - 现在的做法：D0P/D0N 各用一根独立的 0.127 mm 线，每根约 51 Ω（3313），合起来约 100 Ω 差分（松耦合）。
    - D0P 东侧的绕线外移到 x 23.25，给 CK 线对让出通道。
    - 等长：D0N 加大调长弯，结果 19.258/19.258 mm。
  - CK 和 D0 两对之间长度差约 6.1 mm（约 40 ps），以前就是这样，对屏的 DSI 速率影响不大，记录在案。
- **KiCad 板设置：**
  - 叠层已经按 JLC04101H-3313 写入 .kicad_pcb，总厚 1.0004 mm（芯板 0.7012 mm）。
  - gbrjob 文件里的 MaterialStackup 和这个一致。
- 验证：verification/preflight_impedance_20261015。DRC、ERC、未连接、一致性检查全部为 0，四项静态检查全部通过。

## 2026-10-15 · POFV 决定

- 决定：PCB 下单时选 Epoxy Filled & Capped（POFV），范围是**全部 0.30 mm 孔**（板上所有过孔都是这个尺寸）。原因：
  - U1/U2 EP 上的过孔本来就需要 POFV。
  - 剩下的 20 个焊盘内过孔，再挪就要拆线；VSYS 的 C1/C40 挪了还会让 In2 出现孤岛。
  - 四层板 POFV 要加钱，但按"先保证能用"的原则接受。
- 已写进 ORDERING_GUIDE_CN.md 的"过孔"一行，包括下单备注原文。

## 2026-10-15 · 补齐 LCSC 料号（62 颗）

- 选料原则：先保证能用，再选便宜的；优先选 JLC 基础库（basic）、有库存的料。
- **电阻：** 全部用 0402 UNI-ROYAL 0402WGF 系列，basic 库：
  - 10k C25744，4.7k C25900，2.2k C25879，100k C25741
  - 22k C25768，47k C25792，100 Ω C25076，0 Ω C17168
- **0402 电容：**
  - 100n C1525（basic）
  - 18p C1549（C0G，basic）
  - 10n C15195（basic）
  - 470n C47339（10 V，扩展库，用在 VRA1）
- **0603 电容：**
  - 22u：VSYS 上的 C1/C2 用 10 V 的 C86295（扩展库）。VSYS 最高约 5 V，6.3 V 的料余量不够。其它 22u 都在 ≤3.3 V 的电源上，用 6.3 V 的 C59461（basic）。
  - 10u C19702（10 V，basic），用在 VBUS/ELVDD/ELVSS/SD。
  - 4.7u C19666（16 V，basic）。
  - 2.2u C23630（16 V，basic）。
  - 1u C15849（50 V，basic）。
- **LED：** D1 绿灯 KT-0603G C12624，D5 蓝灯 KT-0603B C2288。Everlight 的 basic 料没有库存，所以选了扩展库。
- **电感（2×2 焊盘，适配 2016 封装）：**
  - L1–L3 用 Sunlord WPN201610H1R0MT C97002：1 µH，Isat 2.05 A，70 mΩ。
  - L5/L6 用 WPN201610U4R7MT C97018：4.7 µH，1.25 A，240 mΩ。
- **晶振 Y1：** TAITIEN XXDBBCNANF-24MHZ C16197264：24 MHz，±10 ppm，CL 12 pF。负载电容 18 pF 两颗串联约 9 pF，加上约 3 pF 杂散电容，正好 ≈12 pF。
- **芯片：**
  - U6 SN74LVC1G123DCTR C123302
  - U8 TPS22918DBVR C131941
- **J3（DEBUG POGO）是弹针测试焊盘，不贴装**，生产包的 BOM 和坐标文件里都不放它。R31 本来就是 DNP，也不放。
- R36–R40 的 0 Ω 隔离电阻（C17168）**在 BOM 里照常贴装**。按 BRINGUP_CN.md，调试时可以拆掉做分段上电。

## 2026-10-15 · U2 CORE 去耦补齐（B 面），U2-47 仍不加

- 三颗电容都是 100 nF（CL05B104KO5NNNC，C1525，basic），放在 B 面：

  | 位号 | 位置 | 接法 | 平面距离 |
  |---|---|---|---|
  | C56 → U2-13 | (21.675, 28.575)，90° | 接 CORE 扇出过孔 (21.68, 27.435) | 焊盘边距 0.21 mm |
  | C58 → U2-17 | (21.425, 26.725)，180° | 同上，共用 (21.68, 27.435) | 0.21 mm |
  | C61 → U2-75 | (16.325, 31.975)，270° | 接 CORE 过孔 (15.375, 33.625) | 0.36 mm |

- 三颗都在 B 面就近新加了 GND 过孔，没有动任何信号走线。
- **U2-47：** 拆掉 FEL_KEY_N 的 B 面走线后再试，B 面的位置可以放下（12.375, 25.675），但缺一个靠近引脚的 3V3 过孔。
  - 现有的 3V3 过孔离 U2-47 都超过 3.3 mm，最近的 (12.8, 28.3) 就是 C57 用的那个。接到它上面，和 C57 并联没有区别。
  - 在 U2-47 旁边放 F 面过孔需要 x 方向 0.43 mm、y 方向 0.49 mm 的空间。现在：
    - x 方向夹在 C35.1 焊盘和 U2 引脚之间，只有 0.47 mm 的间隙。
    - y 方向夹在 ADC_KEYS 和 SOC_AVCC（U2-48，模拟电源，不动）走线之间，宽度不够。
  - 所以 U2-47 继续和 U2-55 共用 C57，已恢复原状。
- 验证：verification/preflight_coredec_20261015，全部为 0，四项检查全部通过。

## 2026-10-15 · U2-5 / U2-78（3V3_B）去耦

- 两颗都是 100 nF 0402（CL05B104KO5NNNC，C1525），放在 B 面：

  | 位号 | 对应引脚 | 位置 | 和引脚焊盘的水平距离 | 3V3_B 接法 | GND 过孔 | 孔边到焊盘边 |
  |---|---|---|---|---|---|---|
  | C55 | U2-5 | (25.05, 31.475)，0° | 1.68 mm | B 走线到现有 3V3_B 过孔 (23.5, 32.05) | 新加 (25.55, 32.425) | 0.45 mm |
  | C63 | U2-78 | (17.6, 35.2)，90° | 1.66 mm | B 走线到 U2-78 扇出过孔 (18.65, 35.0) | 新加 (17.9, 36.45) | 0.30 mm |

- **不和 USB/DSI/Y1 重叠：**
  - C55 离最近的 USB/DSI 铜皮 2.0 mm，离 Y1 2.98 mm。
  - C63 离最近的 USB/DSI 铜皮在平面上有 0.23 mm（在 B 面，没有任何部分投影到 USB/DSI 走线上），离 Y1 9.6 mm。
  - C63 的外形在 MIPI_CHANNEL 禁布区外面；它的 GND 过孔在区内，但这个禁布区允许过孔。
- **给 C63 让位置的改动：**
  - 1V8 过孔 (17.057, 35.609) 移到 (16.75, 35.75)，F 层补了 0.25 mm 的一段连线。
  - 删掉了一段 0.47 mm、只连着这个过孔、没有其它用处的 B 面 1V8 短线头。
- 没有改动任何信号线。
- B 面器件从 11 颗变成 13 颗。
- 验证：verification/preflight_3v3b_20261015，全部 0。

## 2026-10-15 · 风险：R36–R40 默认贴装

- **风险：** BOM 里 R36–R40 的 0 Ω 默认是贴上的。如果 PMIC（C3036461）的 OTP 出厂电压和预期不一样，第一次上电时这个错误电压会**直接加到负载上**：SoC 内核、DRAM、3V3、1V8 都可能受影响。现在 OTP 默认值还没有得到厂家证据（见 POWER_REVIEW_CN.md）。
- **缓解措施：**
  1. 首次上电从 J2 接**限流电源**，按 BRINGUP_CN.md：3.8 V、300 mA，不接屏，先量各路电压。一旦电压不对，限流能把损坏风险压低。
  2. 下单前**向 JLC/立创发询问**，确认 C3036461 这一批次 AXP2101 的 OTP 默认值：DCDC1/3/4、ALDO1、RTCLDO1 的电压和使能，以及上电时序。询问稿见 POWER_REVIEW_CN.md。没有收到答复之前不放行生产。
  3. 也可以按 BRINGUP_CN.md 拆掉 R36–R40，逐路检查后再装回。
- 决定：保持默认贴装（这样生产最省事），靠上面 1、2 两条控制风险。

## 2026-10-15 · I2C0 上拉留在主 3V3，接受 E03 约 0.129 V 的偏差

- **决定：** R15/R16（4.7 kΩ）继续上拉到**主 3V3**，不改到常供电轨。
- **理由（防倒灌）：**
  - 如果上拉接在常供电的 RTC_3V3 上，主 3V3 断电时，上拉会通过 SoC 和其它 I2C 器件的 IO 保护二极管往已断电的主 3V3 倒灌，导致幻象供电、漏电，关机电流也会上升。
  - 上拉接在主 3V3 上，主电源关断时总线自然掉到 0 V，U4 的 IO 只看到 ≤ 它自己 VDDIO 的电压。
- **接受 E03 的约 0.129 V：**
  - 0.129 V 是把两种独立的最坏极限同时叠加算出来的：DCDC1 偏到 +3%（3.399 V），同时 RTCLDO 偏到最低角（2.97 V）。这不是实测值。
  - 正常时两路都在 3.3 V 附近，差不到 0.1 V。
  - 即使真的出现这种最坏组合，超出部分经过 4.7 kΩ 后，注入电流 ≤ 0.129 V / 4.7 kΩ ≈ 27 µA，比 CMOS IO 常见的 ±1 mA 钳位能力小一个数量级以上。只有极少数情况下，静态的空闲高电平才会落到这个区间。
- 量产前要实测：上电、掉电、关机、重启时总线高电平和 U4 VDDIO 的差值。如果差值 >0.3 V，下一版改成跟着电源域走的 I2C 电平转换或隔离。
