LeeSpo/portable-display-epass-EVT1-minboot-r1/screen.md

# Display selection is not frozen

The original screen discussion is retained under `reference/original_notes/screen.md`.
It is historical context, not an approved panel specification.

The current PCB still contains the original 20-pin FPC placeholder and TFT/backlight circuitry. This revision does not select IPS versus OLED or certify its voltage/pinout.

Before completing the display region, provide the exact module part number and its datasheet, including FPC pin numbering/contact side, rails, DSI lane count/polarity/timing, reset sequence and LED/backlight requirements. A controller name alone (for example ST7701S) does not identify a module pinout.
