LeeSpo/portable-display-epass-EVT1-minboot-r1/reference/original_notes/screen.md

目前我们实际讨论过的屏幕，大致可以分成 4 类。其中只有 **4.0" 480×800 MIPI IPS** 是目前比较接近 V1.0 主线方案的，其余主要是为了评估 AMOLED / AOD 可行性。

| 屏幕方案 | 尺寸 | 分辨率 | 接口 | DDIC / 驱动 IC | 典型模组尺寸 | AOD / Self Refresh | 特点 | 对 V1.0 的评价 |
| --- | ---: | ---: | --- | --- | --- | --- | --- | --- |
| **4.0" IPS 方案 A** | 4.0" | **480×800** | **MIPI DSI** | **ST7701S**  | 约**58.26 × 98.10 mm** | ❌ | 尺寸小、成熟、便宜、资料相对容易找 | **目前首选方向** |
| **4.0" IPS 方案 B** | 4.0" | **480×800** | MIPI DSI | ST7701S 类 | 约**59.54 × 101 mm** | ❌ | 和方案 A 类似，供应商/结构尺寸不同 | **可作为备选** |
| **5.0" AMOLED** | 5.0" | **720×1280** | MIPI DSI | **RM67295**  | 约**64.12 × 116.72 mm**，部分约 **70.52 × 123.12 mm** | ⚠️ 不是真正理想 AOD | AMOLED、黑色功耗低、显示效果好，但驱动为 RAM-less | **不建议首版** |
| **RM690B0 AMOLED**  | 常见约 2.4" | 常见约 480×600 级 | MIPI / SPI 视模组  | **RM690B0**  | 明显小于目标 4" | ✅ 较有希望 | 内部显示 RAM、面向可穿戴、小尺寸 AOD 很有价值 | **尺寸不合适** |
| **ICNA3312 AMOLED** | 常见约 2.4" | **450×600** 左右 | MIPI 类 | **ICNA3312** | 小尺寸 | ✅/较有希望 | Smart AOD、低刷新等方向比较符合我们的理想架构 | **尺寸不合适** |

### 1. 目前最现实的是 4.0" IPS

我们现在最倾向：

**4.0 英寸 / 480×800 / MIPI DSI / ST7701S**

它最大的优势不是显示效果最好，而是**工程风险最低**。

对于 V851s：

```text
V851s
   │
   │ 2-lane MIPI DSI
   ▼
ST7701S
   │
   ▼
4.0" 480×800 IPS
```

这个组合比较接近已有 V851s 开发板/参考项目使用过的配置。

所以驱动、初始化、MIPI 时序方面更容易找到参考。

---

### 2. 4 英寸的真实尺寸比原来设想稍大

我们原来希望：

**整机约 50 × 100 mm**

但是屏幕本身就已经差不多：

**58～60 × 98～101 mm**

所以还要算上：

* 外壳边框
* FPC
* PCB
* 按键
* USB-C
* 电池

因此目前比较现实的整机尺寸是：

**约 62～65 × 105～110 mm**

而不是 50 × 100 mm。

---

### 3. 5" AMOLED 显示效果更好，但尺寸明显变大

我们讨论过：

**5.0" / 720×1280 / RM67295**

尺寸大约已经达到：

**64 × 117 mm**

部分甚至：

**70.5 × 123 mm**

所以整机最后很可能会到：

**70～75 × 125～130 mm**

这已经和最开始“小型”的目标有一定偏离。

另外还有一个更重要的问题。

RM67295 是：

**RAM-less AMOLED Driver**

简单理解：

屏幕里面没有一个可以独立保存完整图像的大 Frame Buffer。

所以你不能很理想地做到：

```text
V851s 睡眠
   ↓
屏幕继续自己显示时钟
   ↓
只消耗极低功耗
```

这就削弱了我们最想要的 AOD。

因此暂时不选它。

---

### 4. RM690B0 是我们讨论过最有意思的 AOD 方向之一

RM690B0 比较符合：

* AMOLED
* 内置显示 RAM
* 低功耗显示
* 可穿戴设备
* AOD

所以从**技术思路**上，它其实非常适合我们的 Portable Display。

问题是公开市场目前比较容易找到的 RM690B0 屏，大多数只有：

**约 2.4 英寸**

而我们的目标是：

**4～5 英寸**

因此最大的障碍不是芯片能力，而是：

> **找不到合适尺寸、资料开放、可以买到的屏幕模组。**

---

### 5. ICNA3312 情况也类似

我们找到的方向大概是：

**2.4" / 450×600 / AMOLED**

它同样比较偏：

* Smart AOD
* Wearable
* 低刷新率
* 小尺寸 AMOLED

从低功耗方向非常漂亮。

但：

**2.4 英寸太小。**

除非以后把 Portable Display 做一个 Mini 版本，否则目前不会作为 V1.0 主屏。

### 所以现在真正要找的“完美屏幕”

如果继续搜 AMOLED，我认为我们的筛选条件应该直接锁死为：

```text
尺寸：
3.8" ～ 4.3"

分辨率：
480×800
540×960
720×1280
均可考虑

接口：
2-lane MIPI DSI 优先

技术：
AMOLED

必须：
公开 Datasheet
完整 FPC Pinout
初始化寄存器代码
长期可以买到

最好：
内置 GRAM / Frame Buffer
Self Refresh
Smart AOD
1Hz / 10Hz 低刷新
Deep Standby

模组宽度：
≤ 62 mm

模组长度：
≤ 105 mm
```

如果找不到满足这些条件的 AMOLED，**V1.0 ** 就使用普通OLED，不再继续为 AOD 延误整个项目。
