LeeSpo/portable-display-epass-EVT1-minboot-r1/portable-display/reference/README.md

# 原始参考资料

- [V851S 引脚表](v851s_pinout_v0.1.xlsx)
- [Molex SD-502598-003 连接器机械图](datasheets/molex_SD-502598-003.pdf)
- [TPS65631 数据手册](datasheets/tps65631.pdf)
- [屏幕原始规格书](../docs/kd024_screen/raw-pdf/KD024EGOIN152-01_SPEC_V1.pdf)
- [屏幕工程规格](../docs/kd024_screen/KD024EGOIN152-01_engineering_spec.md)、[引脚表](../docs/kd024_screen/KD024EGOIN152-01_pinout.csv)与[结构化数据](../docs/kd024_screen/KD024EGOIN152-01_structured.json)：统一保留用户资料的有效副本，旧 `display_*_supplied.*` 与这些文件内容一致。

这些资料不构成装配或生产放行。历史工程通过 [Git 恢复索引](../docs/PROJECT_STATUS_CN.md)追溯。
