LeeSpo/portable-display-epass-EVT1-minboot-r1/portable-display/hardware/v1-WEB6-redesign/critical_pad_distances.csv

Function | From_ref | From_pad | To_ref | To_pad | Straight_line_pad_center_distance_mm | Important_note
MIPI_D0P | U2 | 81 | J4 | 35 | 10.257 | Geometric distance only; NOT routed length, impedance, timing, or electrical approval
MIPI_D0N | U2 | 80 | J4 | 36 | 7.258 | Geometric distance only; NOT routed length, impedance, timing, or electrical approval
MIPI_CKP | U2 | 85 | J4 | 39 | 10.251 | Geometric distance only; NOT routed length, impedance, timing, or electrical approval
MIPI_CKN | U2 | 84 | J4 | 40 | 7.232 | Geometric distance only; NOT routed length, impedance, timing, or electrical approval
PMIC_VBAT_BYPASS | U1 | 33 | C3 | 1 | 1.946 | Geometric distance only; NOT routed length, impedance, timing, or electrical approval
PMIC_SYS_BULK_A | U1 | 34 | C1 | 1 | 2.62 | Geometric distance only; NOT routed length, impedance, timing, or electrical approval
PMIC_SYS_BULK_B | U1 | 34 | C2 | 1 | 3.868 | Geometric distance only; NOT routed length, impedance, timing, or electrical approval
PMIC_VREF | U1 | 2 | C11 | 1 | 2.157 | Geometric distance only; NOT routed length, impedance, timing, or electrical approval
PMIC_VRTC | U1 | 28 | C33 | 1 | 1.408 | Geometric distance only; NOT routed length, impedance, timing, or electrical approval
PMIC_VIN3 | U1 | 6 | C41 | 1 | 1.991 | Geometric distance only; NOT routed length, impedance, timing, or electrical approval
PMIC_VIN1 | U1 | 23 | C40 | 1 | 1.53 | Geometric distance only; NOT routed length, impedance, timing, or electrical approval
PMIC_3V3_SWITCH | U1 | 22 | L1 | 1 | 3.4 | Geometric distance only; NOT routed length, impedance, timing, or electrical approval
PMIC_CORE_SWITCH | U1 | 5 | L2 | 1 | 2.731 | Geometric distance only; NOT routed length, impedance, timing, or electrical approval
PMIC_DRAM_SWITCH | U1 | 8 | L3 | 1 | 3.397 | Geometric distance only; NOT routed length, impedance, timing, or electrical approval
OLED_INPUT | U10 | 12 | C46 | 1 | 1.915 | Geometric distance only; NOT routed length, impedance, timing, or electrical approval
OLED_ELVDD_OUTPUT | U10 | 3 | C48 | 1 | 1.555 | Geometric distance only; NOT routed length, impedance, timing, or electrical approval
OLED_POSITIVE_SWITCH | U10 | 1 | L5 | 2 | 1.743 | Geometric distance only; NOT routed length, impedance, timing, or electrical approval
OLED_NEGATIVE_SWITCH | U10 | 10 | L6 | 1 | 2.0 | Geometric distance only; NOT routed length, impedance, timing, or electrical approval
