LeeSpo/portable-display-epass-EVT1-minboot-r1/portable-display/hardware/v1-WEB6-redesign/split-power-candidate/four_layers.png

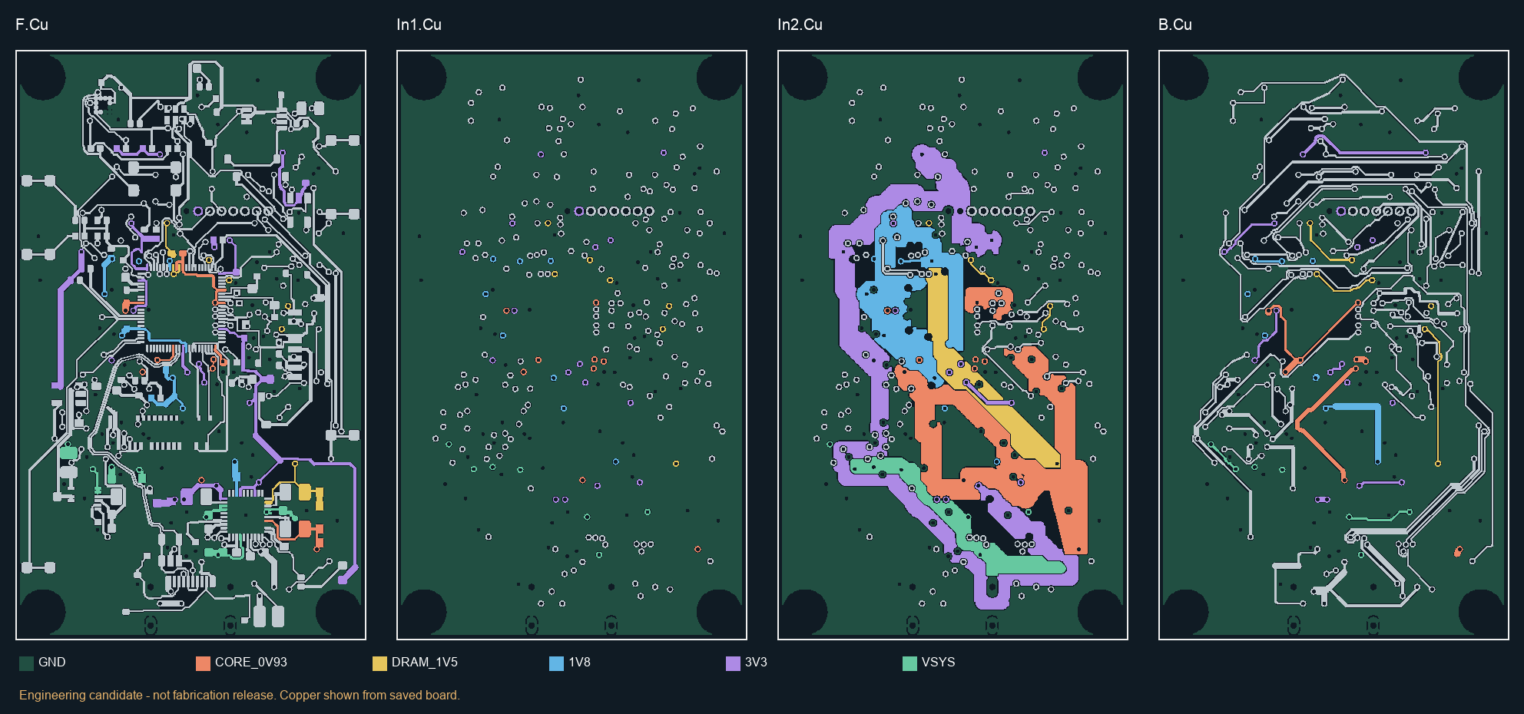
portable-display/hardware/v1-WEB6-redesign/split-power-candidate/four_layers.png
