LeeSpo/portable-display-epass-EVT1-minboot-r1/portable-display/hardware/v1-WEB6-redesign/split-power-candidate/verification/preflight_review_20261009/sources/MUP_M617_2_mechanical.png

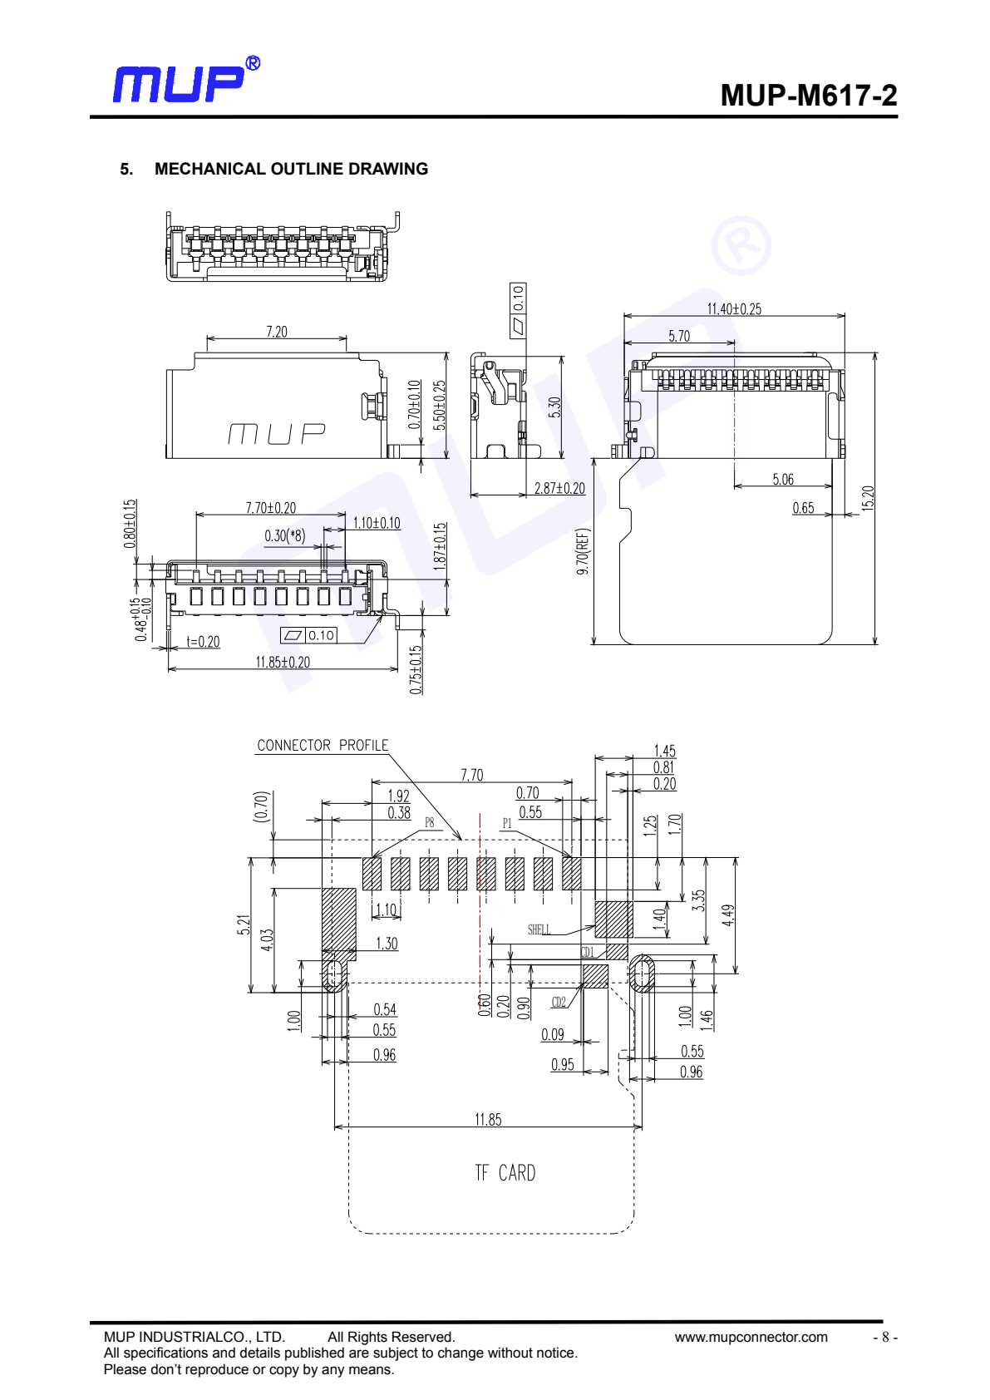
portable-display/hardware/v1-WEB6-redesign/split-power-candidate/verification/preflight_review_20261009/sources/MUP_M617_2_mechanical.png
