LeeSpo/portable-display-epass-EVT1-minboot-r1/portable-display/hardware/v1-WEB6-redesign/split-power-candidate/verification/production_20261018/BOM_JLC.csv

Comment | Designator | Footprint | LCSC Part # | Quantity
22u | C1,C2 | 0603 | C86295 | 2
1u | C3,C11,C33,C40,C41,C42,C44 | 0603 | C15849 | 7
22u | C4,C5,C6,C7,C8,C9 | 0603 | C59461 | 6
2.2u | C10,C35,C38 | 0603 | C23630 | 3
18p | C12,C13 | 0402 | C1549 | 2
100n | C14,C15,C16,C17,C18,C19,C20,C21,C24,C25,C26,C37,C39,C43,C45,C51,C52,C54,C55,C56,C57,C58,C59,C60,C61,C62,C63,C64 | 0402 | C1525 | 28
3.3u | C23 | C_0805_2012Metric | C7393948 | 1
4.7u | C29 | 0603 | C19666 | 1
10u | C30,C32,C48,C49,C50 | 0603 | C19702 | 5
10n | C31 | 0402 | C15195 | 1
2.2u | C34 | 0402 | C12530 | 1
470n | C36 | 0402 | C47339 | 1
10u | C46,C47 | 0402 | C15525 | 2
1u | C53 | 0402 | C52923 | 1
CHARGE | D1 | LED0603 | C12624 | 1
BAT54 | D2,D3 | D_SOD123 | C699107 | 2
STATUS | D5 | LED0603 | C2288 | 1
ESDLC5V0LB | D13,D14 | DFN1006-2 | C20168172 | 2
USB4105-GF-A-060 | J1 | USB4105 | C3025063 | 1
1S LiPo + NTC | J2 | SH1.0_3P_RA | C7430445 | 1
KD024EGOIN152-01 | J4 | FPC45 | C5365339 | 1
MicroSD | J5 | XKTF-0803-0 | C381083 | 1
1uH/2A | L1,L2,L3 | IND_2x2 | C97002 | 3
4.7uH | L5,L6 | IND_2x2 | C97018 | 2
2N7002 | Q1,Q2 | SOT23-3 | C8545 | 2
AO3401A | Q3 | SOT23-3 | C15127 | 1
5.1k | R1,R2 | 0402 | C25905 | 2
4.7k | R3,R15,R16 | 0402 | C25900 | 3
2.2k | R4,R5,R6,R27 | 0402 | C25879 | 4
10k | R10,R11,R13,R14,R17,R18,R20,R28,R32,R34,R35 | 0402 | C25744 | 11
910k | R12 | 0402 | C352384 | 1
100 | R21 | 0402 | C25076 | 1
100k | R22,R26 | 0402 | C25741 | 2
0R | R23,R29,R36,R37,R38,R39,R40 | 0402 | C17168 | 7
22k | R24 | 0402 | C25768 | 1
47k | R25 | 0402 | C25792 | 1
1k | R33 | 0402 | C11702 | 1
UP | SW1 | SW_SIDE | C5117859 | 1
DOWN | SW2 | SW_SIDE | C5117859 | 1
OK | SW3 | SW_SIDE | C5117859 | 1
BACK | SW4 | SW_SIDE | C5117859 | 1
POWER | SW5 | SW_SIDE | C5117859 | 1
FEL | SW6 | SW_SIDE | C5117859 | 1
AXP2101 | U1 | QFN40 | C3036461 | 1
V851s | U2 | QFN88 | C5365286 | 1
LIS2DW12TR | U4 | LGA-12 | C189624 | 1
RV-3028-C7 | U5 | RTC-8 | C3019759 | 1
SN74LVC1G123DCTR | U6 | SN74LVC1G123_DCT8 | C123302 | 1
TPS22918DBVR | U8 | TPS22918_DBV6 | C131941 | 1
USBLC6-2SC6 | U9 | USBLC6-2SC6_SOT23-6 | C2827654 | 1
TPS65631DPDR | U10 | WSON-12 | C165127 | 1
SN74LVC2G17DBVR | U11 | SN74LVC2G17_DBV6 | C10429 | 1
TPD4E05U06DQAR | U12,U13 | TPD4E05U06_DQA | C138714 | 2
24MHz 10ppm | Y1 | XTAL4 | C16197264 | 1
