LeeSpo/portable-display-epass-EVT1-minboot-r1/verification/native-20260905T074102Z-76d649/net_pin_report.csv

Reference | Pin | Pin Name | Net
J1 | A1 | GND | GND
J1 | A4 | VBUS | VBUS
J1 | A5 | CC1 | USB_CC1
J1 | A6 | DP1 | USB_DP
J1 | A7 | DM1 | USB_DM
J1 | A8 | SBU1 | NC
J1 | A9 | VBUS | VBUS
J1 | A12 | GND | GND
J1 | B1 | GND | GND
J1 | B4 | VBUS | VBUS
J1 | B5 | CC2 | USB_CC2
J1 | B6 | DP2 | USB_DP
J1 | B7 | DM2 | USB_DM
J1 | B8 | SBU2 | NC
J1 | B9 | VBUS | VBUS
J1 | B12 | GND | GND
J1 | SH1 | SHIELD | GND
J1 | SH2 | SHIELD | GND
J1 | SH3 | SHIELD | GND
J1 | SH4 | SHIELD | GND
R1 | 1 | 1 | USB_CC1
R1 | 2 | 2 | GND
R2 | 1 | 1 | USB_CC2
R2 | 2 | 2 | GND
U1 | 1 | CHGLED | CHGLED_N
U1 | 2 | VREF | VREF
U1 | 3 | GND | GND
U1 | 4 | FB3 | CORE_0V93
U1 | 5 | LX3 | LX_CORE
U1 | 6 | VIN3 | VSYS
U1 | 7 | VIN4 | VSYS
U1 | 8 | LX4 | LX_DRAM
U1 | 9 | FB4 | DRAM_1V5
U1 | 10 | CPUSLDO | NC
U1 | 11 | DLDO2_DC4SW | NC
U1 | 12 | BLDO1 | NC
U1 | 13 | BLDOIN | 3V3
U1 | 14 | BLDO2 | NC
U1 | 15 | ALDO4 | NC
U1 | 16 | ALDO3 | NC
U1 | 17 | ALDOIN | 3V3
U1 | 18 | ALDO1 | 1V8
U1 | 19 | ALDO2 | NC
U1 | 20 | DLDO1_DC1SW | NC
U1 | 21 | FB1 | 3V3
U1 | 22 | LX1 | LX_3V3
U1 | 23 | VIN1 | VSYS
U1 | 24 | VIN2 | VSYS
U1 | 25 | LX2 | NC
U1 | 26 | FB2 | NC
U1 | 27 | VBACKUP | PMIC_BACKUP
U1 | 28 | VRTC | RTC_3V3
U1 | 29 | PWROK | NC
U1 | 30 | PWRON | PWRON_N
U1 | 31 | TS | BAT_NTC
U1 | 32 | GPIO1_FB5_RTCLDO2 | NC
U1 | 33 | BAT | VBAT
U1 | 34 | VSYS | VSYS
U1 | 35 | SW | NC
U1 | 36 | VMID | VSYS
U1 | 37 | VBUS | VBUS
U1 | 38 | IRQ | PMIC_IRQ_N
U1 | 39 | SDA | PMIC_SDA
U1 | 40 | SCK | PMIC_SCL
U1 | 41 | EPAD | GND
L1 | 1 | 1 | LX_3V3
L1 | 2 | 2 | 3V3
L2 | 1 | 1 | LX_CORE
L2 | 2 | 2 | CORE_0V93
L3 | 1 | 1 | LX_DRAM
L3 | 2 | 2 | DRAM_1V5
C1 | 1 | 1 | VSYS
C1 | 2 | 2 | GND
C2 | 1 | 1 | VSYS
C2 | 2 | 2 | GND
C3 | 1 | 1 | VBAT
C3 | 2 | 2 | GND
C4 | 1 | 1 | 3V3
C4 | 2 | 2 | GND
C5 | 1 | 1 | 3V3
C5 | 2 | 2 | GND
C6 | 1 | 1 | CORE_0V93
C6 | 2 | 2 | GND
C7 | 1 | 1 | CORE_0V93
C7 | 2 | 2 | GND
C8 | 1 | 1 | DRAM_1V5
C8 | 2 | 2 | GND
C9 | 1 | 1 | DRAM_1V5
C9 | 2 | 2 | GND
C10 | 1 | 1 | 1V8
C10 | 2 | 2 | GND
C11 | 1 | 1 | VREF
C11 | 2 | 2 | GND
J2 | 1 | VBAT | VBAT
J2 | 2 | NTC | BAT_NTC
J2 | 3 | GND | GND
SW5 | 1 | PWRON | PWRON_N
SW5 | 2 | PWRON | PWRON_N
SW5 | 3 | GND | GND
R3 | 1 | 1 | 3V3
R3 | 2 | 2 | PMIC_IRQ_N
R4 | 1 | 1 | 3V3
R4 | 2 | 2 | PMIC_SCL
R5 | 1 | 1 | 3V3
R5 | 2 | 2 | PMIC_SDA
D1 | 1 | 1 | 3V3
D1 | 2 | 2 | CHGLED_A
R6 | 1 | 1 | CHGLED_A
R6 | 2 | 2 | CHGLED_N
U9 | 1 | I/O1 | USB_DP
U9 | 2 | GND | GND
U9 | 3 | I/O2 | USB_DM
U9 | 4 | I/O2 | USB_DM
U9 | 5 | VBUS | VBUS
U9 | 6 | I/O1 | USB_DP
D13 | 1 | 1 | USB_CC1
D13 | 2 | 2 | GND
D14 | 1 | 1 | USB_CC2
D14 | 2 | 2 | GND
C32 | 1 | 1 | VBUS
C32 | 2 | 2 | GND
C33 | 1 | 1 | RTC_3V3
C33 | 2 | 2 | GND
C38 | 1 | 1 | VSYS
C38 | 2 | 2 | GND
C39 | 1 | 1 | PMIC_BACKUP
C39 | 2 | 2 | GND
C40 | 1 | 1 | VSYS
C40 | 2 | 2 | GND
C41 | 1 | 1 | VSYS
C41 | 2 | 2 | GND
U2 | 1 | PD18 | NC
U2 | 2 | PD19 | LCD_RST
U2 | 3 | PD20 | LCD_PWM
U2 | 4 | PD21 | LCD_EN
U2 | 5 | VCC33_PF_PD | 3V3
U2 | 6 | PF0_SDC0_D1 | SD_D1
U2 | 7 | PF1_SDC0_D0 | SD_D0
U2 | 8 | PF2_SDC0_CLK | SD_CLK
U2 | 9 | PF3_SDC0_CMD | SD_CMD
U2 | 10 | PF4_SDC0_D3 | SD_D3
U2 | 11 | PF5_SDC0_D2 | SD_D2
U2 | 12 | PF6_DBG_CLK | SD_DET
U2 | 13 | VDD_SYS0 | CORE_0V93
U2 | 14 | VCC_LDOA_PLL | SOC_LDO_1V8
U2 | 15 | DXOUT | XOUT
U2 | 16 | DXIN | XIN
U2 | 17 | VDD_SYS1 | CORE_0V93
U2 | 18 | PE13 | NC
U2 | 19 | PE12 | NC
U2 | 20 | PE11 | NC
U2 | 21 | PE4 | I2C0_SCL
U2 | 22 | VCC_PE | 3V3
U2 | 23 | PE2 | PMIC_IRQ_N
U2 | 24 | PE7 | RTC_INT_N
U2 | 25 | PE0 | E907_TX
U2 | 26 | PE5 | I2C0_SDA
U2 | 27 | PE8 | NC
U2 | 28 | PE9 | NC
U2 | 29 | PE3 | NC
U2 | 30 | PE6 | ACCEL_INT_N
U2 | 31 | PE1 | E907_RX
U2 | 32 | PE10 | NC
U2 | 33 | VDD_SYS2 | CORE_0V93
U2 | 34 | VCC_DRAM0 | DRAM_1V5
U2 | 35 | VDD_SYS3 | CORE_0V93
U2 | 36 | VCC_DRAM1 | DRAM_1V5
U2 | 37 | VDD18_DRAM | SOC_LDO_1V8
U2 | 38 | PH14 | PMIC_SDA
U2 | 39 | PH13 | PMIC_SCL
U2 | 40 | PH12 | SD_PWR_EN
U2 | 41 | PH11 | STATUS_LED
U2 | 42 | PH10 | UART0_RX
U2 | 43 | PH9 | UART0_TX
U2 | 44 | VCC_IO | 3V3
U2 | 45 | PH0 | WAKE_PULSE_N
U2 | 46 | GPADC0 | ADC_KEYS
U2 | 47 | VDD33 | 3V3
U2 | 48 | AVCC | SOC_AVCC
U2 | 49 | LINEOUTP | NC
U2 | 50 | VRA1 | VRA1
U2 | 51 | AGND | GND
U2 | 52 | MICIN1N | NC
U2 | 53 | MICIN1P | NC
U2 | 54 | VDD_SYS4 | CORE_0V93
U2 | 55 | VCC_PC | 3V3
U2 | 56 | PC1_SPI0_CS | NAND_CS
U2 | 57 | PC0_SPI0_CLK | NAND_CLK
U2 | 58 | PC3_SPI0_MISO_BOOT1 | NAND_MISO
U2 | 59 | PC2_SPI0_MOSI_BOOT0 | NAND_MOSI
U2 | 60 | PC5_SPI0_HOLD | NAND_HOLD
U2 | 61 | PC4_SPI0_WP | NAND_WP
U2 | 62 | VCC_PA_MCSI | SOC_LDO_1V8
U2 | 63 | PA11 | NC
U2 | 64 | PA10 | NC
U2 | 65 | PA9 | NC
U2 | 66 | PA8 | NC
U2 | 67 | PA7 | NC
U2 | 68 | PA6 | NC
U2 | 69 | PA5 | NC
U2 | 70 | PA4 | NC
U2 | 71 | PA3 | NC
U2 | 72 | PA2 | NC
U2 | 73 | PA1 | NC
U2 | 74 | PA0 | NC
U2 | 75 | VDD_SYS5 | CORE_0V93
U2 | 76 | USB0_DP | USB_DP
U2 | 77 | USB0_DM | USB_DM
U2 | 78 | VCC33_USB | 3V3
U2 | 79 | VCC18_MDSI | SOC_LDO_1V8
U2 | 80 | PD1_DSI_D0N | DSI_D0N
U2 | 81 | PD2_DSI_D0P | DSI_D0P
U2 | 82 | PD3_DSI_D1N | DSI_D1N
U2 | 83 | PD4_DSI_D1P | DSI_D1P
U2 | 84 | PD5_DSI_CKN | DSI_CKN
U2 | 85 | PD6_DSI_CKP | DSI_CKP
U2 | 86 | PD7 | NC
U2 | 87 | PD8 | NC
U2 | 88 | VDD_SYS6 | CORE_0V93
U2 | 89 | EPAD | GND
Y1 | 1 | XIN | XIN
Y1 | 2 | GND | GND
Y1 | 3 | XOUT | XOUT
Y1 | 4 | GND | GND
C12 | 1 | 1 | XIN
C12 | 2 | 2 | GND
C13 | 1 | 1 | XOUT
C13 | 2 | 2 | GND
C34 | 1 | 1 | SOC_LDO_1V8
C34 | 2 | 2 | GND
C35 | 1 | 1 | SOC_AVCC
C35 | 2 | 2 | GND
C36 | 1 | 1 | VRA1
C36 | 2 | 2 | GND
C37 | 1 | 1 | SOC_LDO_1V8
C37 | 2 | 2 | GND
C14 | 1 | 1 | 3V3
C14 | 2 | 2 | GND
C15 | 1 | 1 | 3V3
C15 | 2 | 2 | GND
C16 | 1 | 1 | 1V8
C16 | 2 | 2 | GND
C17 | 1 | 1 | 1V8
C17 | 2 | 2 | GND
C18 | 1 | 1 | CORE_0V93
C18 | 2 | 2 | GND
C19 | 1 | 1 | CORE_0V93
C19 | 2 | 2 | GND
C20 | 1 | 1 | CORE_0V93
C20 | 2 | 2 | GND
C21 | 1 | 1 | DRAM_1V5
C21 | 2 | 2 | GND
U3 | 1 | CS | NAND_CS
U3 | 2 | MISO | NAND_MISO
U3 | 3 | WP | NAND_WP
U3 | 4 | GND | GND
U3 | 5 | MOSI | NAND_MOSI
U3 | 6 | CLK | NAND_CLK
U3 | 7 | HOLD | NAND_HOLD
U3 | 8 | VCC | 3V3
C22 | 1 | 1 | 3V3
C22 | 2 | 2 | GND
R7 | 1 | 1 | 3V3
R7 | 2 | 2 | NAND_CS
R8 | 1 | 1 | 3V3
R8 | 2 | 2 | NAND_WP
R9 | 1 | 1 | 3V3
R9 | 2 | 2 | NAND_HOLD
J3 | 1 | GND | GND
J3 | 2 | 3V3 | 3V3
J3 | 3 | UART0_TX | UART0_TX
J3 | 4 | UART0_RX | UART0_RX
J3 | 5 | E907_TX | E907_TX
J3 | 6 | E907_RX | E907_RX
J3 | 7 | FEL_PC2 | NAND_MOSI
J3 | 8 | PWRON_N | PWRON_N
SW6 | 1 | FEL_PC2 | NAND_MOSI
SW6 | 2 | FEL_PC2 | NAND_MOSI
SW6 | 3 | GND | GND
R10 | 1 | 1 | 3V3
R10 | 2 | 2 | NAND_MOSI
R28 | 1 | 1 | 3V3
R28 | 2 | 2 | NAND_MISO
U4 | 1 | SCL | I2C0_SCL
U4 | 2 | CS | RTC_3V3
U4 | 3 | SDO_SA0 | NC
U4 | 4 | SDA | I2C0_SDA
U4 | 5 | NC | NC
U4 | 6 | GND | GND
U4 | 7 | RES | GND
U4 | 8 | GND | GND
U4 | 9 | VDD | RTC_3V3
U4 | 10 | VDDIO | RTC_3V3
U4 | 11 | INT2 | NC
U4 | 12 | INT1 | ACCEL_INT_N
U5 | 1 | CLKOUT | NC
U5 | 2 | INT | RTC_INT_N
U5 | 3 | SCL | I2C0_SCL
U5 | 4 | SDA | I2C0_SDA
U5 | 5 | VSS | GND
U5 | 6 | VBACKUP | RTC_VBACKUP
U5 | 7 | VDD | RTC_3V3
U5 | 8 | EVI | RTC_EVI
U6 | 1 | Q | WAKE_PULSE
U6 | 2 | GND | GND
U6 | 3 | CEXT | WAKE_CEXT
U6 | 4 | REXT_CEXT | WAKE_REXT
U6 | 5 | A | WAKE_REQ_N
U6 | 6 | B | RTC_3V3
U6 | 7 | CLR | RTC_3V3
U6 | 8 | VCC | RTC_3V3
Q1 | 1 | G | WAKE_PULSE
Q1 | 2 | S | GND
Q1 | 3 | D | PWRON_N
Q2 | 1 | G | WAKE_PULSE
Q2 | 2 | S | GND
Q2 | 3 | D | WAKE_PULSE_N
R11 | 1 | 1 | RTC_3V3
R11 | 2 | 2 | WAKE_REQ_N
R12 | 1 | 1 | RTC_3V3
R12 | 2 | 2 | WAKE_REXT
C23 | 1 | 1 | WAKE_REXT
C23 | 2 | 2 | WAKE_CEXT
R13 | 1 | 1 | RTC_VBACKUP
R13 | 2 | 2 | GND
R14 | 1 | 1 | RTC_EVI
R14 | 2 | 2 | GND
R15 | 1 | 1 | 3V3
R15 | 2 | 2 | I2C0_SCL
R16 | 1 | 1 | 3V3
R16 | 2 | 2 | I2C0_SDA
R17 | 1 | 1 | 3V3
R17 | 2 | 2 | RTC_INT_N
R18 | 1 | 1 | 3V3
R18 | 2 | 2 | ACCEL_INT_N
D2 | 1 | 1 | RTC_INT_N
D2 | 2 | 2 | WAKE_REQ_N
D3 | 1 | 1 | ACCEL_INT_N
D3 | 2 | 2 | WAKE_REQ_N
C24 | 1 | 1 | RTC_3V3
C24 | 2 | 2 | GND
C25 | 1 | 1 | RTC_3V3
C25 | 2 | 2 | GND
C26 | 1 | 1 | RTC_3V3
C26 | 2 | 2 | GND
J4 | 1 | PIN1 | NC
J4 | 2 | PIN2 | NC
J4 | 3 | PIN3 | NC
J4 | 4 | PIN4 | NC
J4 | 5 | PIN5 | NC
J4 | 6 | VCI | LCD_3V3
J4 | 7 | IOVCC | LCD_3V3
J4 | 8 | GND | GND
J4 | 9 | D1P | DSI_D1P
J4 | 10 | D1N | DSI_D1N
J4 | 11 | GND | GND
J4 | 12 | DCKP | DSI_CKP
J4 | 13 | DCKN | DSI_CKN
J4 | 14 | GND | GND
J4 | 15 | D0P | DSI_D0P
J4 | 16 | D0N | DSI_D0N
J4 | 17 | GND | GND
J4 | 18 | RESX | LCD_RST
J4 | 19 | LEDK | LEDK
J4 | 20 | LEDA | LEDA
U7 | 1 | SW | BL_SW
U7 | 2 | GND | GND
U7 | 3 | FB | LEDK
U7 | 4 | CTRL | LCD_PWM
U7 | 5 | VIN | VSYS
L4 | 1 | 1 | VSYS
L4 | 2 | 2 | BL_SW
D4 | 1 | 1 | BL_SW
D4 | 2 | 2 | LEDA
R19 | 1 | 1 | LEDK
R19 | 2 | 2 | GND
C27 | 1 | 1 | LEDA
C27 | 2 | 2 | GND
C28 | 1 | 1 | VSYS
C28 | 2 | 2 | GND
U8 | 1 | VIN | 3V3
U8 | 2 | GND | GND
U8 | 3 | ON | LCD_EN
U8 | 4 | CT | NC
U8 | 5 | QOD | NC
U8 | 6 | VOUT | LCD_3V3
C29 | 1 | 1 | LCD_3V3
C29 | 2 | 2 | GND
J5 | 1 | DAT2 | SD_D2
J5 | 2 | DAT3 | SD_D3
J5 | 3 | CMD | SD_CMD
J5 | 4 | VDD | SD_3V3
J5 | 5 | CLK | SD_CLK
J5 | 6 | VSS | GND
J5 | 7 | DAT0 | SD_D0
J5 | 8 | DAT1 | SD_D1
J5 | 9 | CD | SD_DET
J5 | 10 | SH | GND
J5 | 11 | SH | GND
J5 | 12 | SH | GND
J5 | 13 | SH | GND
Q3 | 1 | G | SD_PWR_GATE
Q3 | 2 | S | 3V3
Q3 | 3 | D | SD_3V3
R20 | 1 | 1 | 3V3
R20 | 2 | 2 | SD_PWR_GATE
R21 | 1 | 1 | SD_PWR_EN
R21 | 2 | 2 | SD_PWR_GATE
C30 | 1 | 1 | SD_3V3
C30 | 2 | 2 | GND
D6 | 1 | 1 | SD_D2
D6 | 2 | 2 | GND
D7 | 1 | 1 | SD_D3
D7 | 2 | 2 | GND
D8 | 1 | 1 | SD_CMD
D8 | 2 | 2 | GND
D9 | 1 | 1 | SD_CLK
D9 | 2 | 2 | GND
D10 | 1 | 1 | SD_D0
D10 | 2 | 2 | GND
D11 | 1 | 1 | SD_D1
D11 | 2 | 2 | GND
D12 | 1 | 1 | SD_DET
D12 | 2 | 2 | GND
SW1 | 1 | KEY | KEY_UP
SW1 | 2 | KEY | KEY_UP
SW1 | 3 | GND | GND
SW2 | 1 | KEY | KEY_DOWN
SW2 | 2 | KEY | KEY_DOWN
SW2 | 3 | GND | GND
SW3 | 1 | KEY | KEY_OK
SW3 | 2 | KEY | KEY_OK
SW3 | 3 | GND | GND
SW4 | 1 | KEY | KEY_BACK
SW4 | 2 | KEY | KEY_BACK
SW4 | 3 | GND | GND
R22 | 1 | 1 | 1V8
R22 | 2 | 2 | ADC_KEYS
R23 | 1 | 1 | KEY_UP
R23 | 2 | 2 | ADC_KEYS
R24 | 1 | 1 | KEY_DOWN
R24 | 2 | 2 | ADC_KEYS
R25 | 1 | 1 | KEY_OK
R25 | 2 | 2 | ADC_KEYS
R26 | 1 | 1 | KEY_BACK
R26 | 2 | 2 | ADC_KEYS
C31 | 1 | 1 | ADC_KEYS
C31 | 2 | 2 | GND
D5 | 1 | 1 | STATUS_LED_A
D5 | 2 | 2 | GND
R27 | 1 | 1 | STATUS_LED
R27 | 2 | 2 | STATUS_LED_A
