LeeSpo/portable-display-epass-EVT1-minboot-r1/verification/design_metadata/placement_PREVIEW_NOT_FOR_ASSEMBLY.csv

Reference | X_mm_from_origin | Y_mm_up_from_origin | Side | KiCad_Rotation_deg | Board_X_mm | Board_Y_mm | Status
J1 | 29.0 | 4.0 | Top | 0.0 | 29.0 | 106.0 | PREVIEW - feeder rotation and assembly not approved
R1 | 20.0 | 9.0 | Top | 0.0 | 20.0 | 101.0 | PREVIEW - feeder rotation and assembly not approved
R2 | 22.0 | 9.0 | Top | 0.0 | 22.0 | 101.0 | PREVIEW - feeder rotation and assembly not approved
U1 | 18.0 | 25.0 | Top | 0.0 | 18.0 | 85.0 | PREVIEW - feeder rotation and assembly not approved
L1 | 9.0 | 26.0 | Top | 0.0 | 9.0 | 84.0 | PREVIEW - feeder rotation and assembly not approved
L2 | 9.0 | 22.0 | Top | 0.0 | 9.0 | 88.0 | PREVIEW - feeder rotation and assembly not approved
L3 | 9.0 | 18.0 | Top | 0.0 | 9.0 | 92.0 | PREVIEW - feeder rotation and assembly not approved
C1 | 10.0 | 32.0 | Top | 0.0 | 10.0 | 78.0 | PREVIEW - feeder rotation and assembly not approved
C2 | 14.0 | 32.0 | Top | 0.0 | 14.0 | 78.0 | PREVIEW - feeder rotation and assembly not approved
C3 | 18.0 | 32.0 | Top | 0.0 | 18.0 | 78.0 | PREVIEW - feeder rotation and assembly not approved
C4 | 5.0 | 28.0 | Top | 0.0 | 5.0 | 82.0 | PREVIEW - feeder rotation and assembly not approved
C5 | 5.0 | 25.0 | Top | 0.0 | 5.0 | 85.0 | PREVIEW - feeder rotation and assembly not approved
C6 | 5.0 | 22.0 | Top | 0.0 | 5.0 | 88.0 | PREVIEW - feeder rotation and assembly not approved
C7 | 5.0 | 19.0 | Top | 0.0 | 5.0 | 91.0 | PREVIEW - feeder rotation and assembly not approved
C8 | 5.0 | 16.0 | Top | 0.0 | 5.0 | 94.0 | PREVIEW - feeder rotation and assembly not approved
C9 | 5.0 | 13.0 | Top | 0.0 | 5.0 | 97.0 | PREVIEW - feeder rotation and assembly not approved
C10 | 13.0 | 17.0 | Top | 0.0 | 13.0 | 93.0 | PREVIEW - feeder rotation and assembly not approved
C11 | 13.0 | 14.0 | Top | 0.0 | 13.0 | 96.0 | PREVIEW - feeder rotation and assembly not approved
J2 | 45.0 | 11.0 | Top | 0.0 | 45.0 | 99.0 | PREVIEW - feeder rotation and assembly not approved
SW5 | 55.0 | 28.0 | Top | 90.0 | 55.0 | 82.0 | PREVIEW - feeder rotation and assembly not approved
R3 | 22.0 | 32.0 | Top | 0.0 | 22.0 | 78.0 | PREVIEW - feeder rotation and assembly not approved
R4 | 24.0 | 32.0 | Top | 0.0 | 24.0 | 78.0 | PREVIEW - feeder rotation and assembly not approved
R5 | 26.0 | 32.0 | Top | 0.0 | 26.0 | 78.0 | PREVIEW - feeder rotation and assembly not approved
D1 | 30.0 | 28.0 | Top | 0.0 | 30.0 | 82.0 | PREVIEW - feeder rotation and assembly not approved
R6 | 34.0 | 28.0 | Top | 0.0 | 34.0 | 82.0 | PREVIEW - feeder rotation and assembly not approved
U9 | 29.0 | 12.0 | Top | 90.0 | 29.0 | 98.0 | PREVIEW - feeder rotation and assembly not approved
D13 | 19.5 | 6.0 | Top | 0.0 | 19.5 | 104.0 | PREVIEW - feeder rotation and assembly not approved
D14 | 38.5 | 6.0 | Top | 0.0 | 38.5 | 104.0 | PREVIEW - feeder rotation and assembly not approved
C32 | 15.0 | 9.0 | Top | 0.0 | 15.0 | 101.0 | PREVIEW - feeder rotation and assembly not approved
C33 | 13.0 | 20.0 | Top | 0.0 | 13.0 | 90.0 | PREVIEW - feeder rotation and assembly not approved
C38 | 22.0 | 29.0 | Top | 0.0 | 22.0 | 81.0 | PREVIEW - feeder rotation and assembly not approved
C39 | 18.0 | 19.0 | Top | 0.0 | 18.0 | 91.0 | PREVIEW - feeder rotation and assembly not approved
C40 | 13.0 | 27.0 | Top | 0.0 | 13.0 | 83.0 | PREVIEW - feeder rotation and assembly not approved
C41 | 23.0 | 23.0 | Top | 0.0 | 23.0 | 87.0 | PREVIEW - feeder rotation and assembly not approved
U2 | 30.0 | 54.0 | Top | 0.0 | 30.0 | 56.0 | PREVIEW - feeder rotation and assembly not approved
Y1 | 19.0 | 54.0 | Top | 0.0 | 19.0 | 56.0 | PREVIEW - feeder rotation and assembly not approved
C12 | 17.0 | 57.0 | Top | 0.0 | 17.0 | 53.0 | PREVIEW - feeder rotation and assembly not approved
C13 | 17.0 | 51.0 | Top | 0.0 | 17.0 | 59.0 | PREVIEW - feeder rotation and assembly not approved
C34 | 15.5 | 49.0 | Top | 0.0 | 15.5 | 61.0 | PREVIEW - feeder rotation and assembly not approved
C35 | 40.0 | 54.0 | Top | 0.0 | 40.0 | 56.0 | PREVIEW - feeder rotation and assembly not approved
C36 | 40.0 | 52.0 | Top | 0.0 | 40.0 | 58.0 | PREVIEW - feeder rotation and assembly not approved
C37 | 20.5 | 50.0 | Top | 0.0 | 20.5 | 60.0 | PREVIEW - feeder rotation and assembly not approved
C14 | 40.0 | 50.0 | Top | 0.0 | 40.0 | 60.0 | PREVIEW - feeder rotation and assembly not approved
C15 | 44.0 | 50.0 | Top | 0.0 | 44.0 | 60.0 | PREVIEW - feeder rotation and assembly not approved
C16 | 40.0 | 47.0 | Top | 0.0 | 40.0 | 63.0 | PREVIEW - feeder rotation and assembly not approved
C17 | 44.0 | 47.0 | Top | 0.0 | 44.0 | 63.0 | PREVIEW - feeder rotation and assembly not approved
C18 | 40.0 | 44.0 | Top | 0.0 | 40.0 | 66.0 | PREVIEW - feeder rotation and assembly not approved
C19 | 44.0 | 44.0 | Top | 0.0 | 44.0 | 66.0 | PREVIEW - feeder rotation and assembly not approved
C20 | 40.0 | 41.0 | Top | 0.0 | 40.0 | 69.0 | PREVIEW - feeder rotation and assembly not approved
C21 | 44.0 | 41.0 | Top | 0.0 | 44.0 | 69.0 | PREVIEW - feeder rotation and assembly not approved
U3 | 50.0 | 48.0 | Top | 0.0 | 50.0 | 62.0 | PREVIEW - feeder rotation and assembly not approved
C22 | 50.0 | 43.0 | Top | 0.0 | 50.0 | 67.0 | PREVIEW - feeder rotation and assembly not approved
R7 | 50.0 | 35.0 | Top | 0.0 | 50.0 | 75.0 | PREVIEW - feeder rotation and assembly not approved
R8 | 53.0 | 35.0 | Top | 0.0 | 53.0 | 75.0 | PREVIEW - feeder rotation and assembly not approved
R9 | 56.0 | 35.0 | Top | 0.0 | 56.0 | 75.0 | PREVIEW - feeder rotation and assembly not approved
J3 | 44.0 | 38.0 | Top | 0.0 | 44.0 | 72.0 | PREVIEW - feeder rotation and assembly not approved
SW6 | 55.0 | 19.0 | Top | 90.0 | 55.0 | 91.0 | PREVIEW - feeder rotation and assembly not approved
R10 | 47.0 | 19.0 | Top | 0.0 | 47.0 | 91.0 | PREVIEW - feeder rotation and assembly not approved
R28 | 44.0 | 19.0 | Top | 0.0 | 44.0 | 91.0 | PREVIEW - feeder rotation and assembly not approved
U4 | 8.0 | 91.0 | Top | 0.0 | 8.0 | 19.0 | PREVIEW - feeder rotation and assembly not approved
U5 | 15.0 | 91.0 | Top | 0.0 | 15.0 | 19.0 | PREVIEW - feeder rotation and assembly not approved
U6 | 24.0 | 91.0 | Top | 0.0 | 24.0 | 19.0 | PREVIEW - feeder rotation and assembly not approved
Q1 | 32.0 | 91.0 | Top | 0.0 | 32.0 | 19.0 | PREVIEW - feeder rotation and assembly not approved
Q2 | 38.0 | 91.0 | Top | 0.0 | 38.0 | 19.0 | PREVIEW - feeder rotation and assembly not approved
R11 | 10.0 | 86.0 | Top | 0.0 | 10.0 | 24.0 | PREVIEW - feeder rotation and assembly not approved
R12 | 24.0 | 86.0 | Top | 0.0 | 24.0 | 24.0 | PREVIEW - feeder rotation and assembly not approved
C23 | 28.0 | 86.0 | Top | 0.0 | 28.0 | 24.0 | PREVIEW - feeder rotation and assembly not approved
R13 | 15.0 | 86.0 | Top | 0.0 | 15.0 | 24.0 | PREVIEW - feeder rotation and assembly not approved
R14 | 17.0 | 86.0 | Top | 0.0 | 17.0 | 24.0 | PREVIEW - feeder rotation and assembly not approved
R15 | 8.0 | 83.0 | Top | 0.0 | 8.0 | 27.0 | PREVIEW - feeder rotation and assembly not approved
R16 | 10.0 | 83.0 | Top | 0.0 | 10.0 | 27.0 | PREVIEW - feeder rotation and assembly not approved
R17 | 12.0 | 83.0 | Top | 0.0 | 12.0 | 27.0 | PREVIEW - feeder rotation and assembly not approved
R18 | 14.0 | 83.0 | Top | 0.0 | 14.0 | 27.0 | PREVIEW - feeder rotation and assembly not approved
D2 | 17.0 | 82.0 | Top | 90.0 | 17.0 | 28.0 | PREVIEW - feeder rotation and assembly not approved
D3 | 21.0 | 82.0 | Top | 90.0 | 21.0 | 28.0 | PREVIEW - feeder rotation and assembly not approved
C24 | 8.0 | 79.0 | Top | 0.0 | 8.0 | 31.0 | PREVIEW - feeder rotation and assembly not approved
C25 | 15.0 | 79.0 | Top | 0.0 | 15.0 | 31.0 | PREVIEW - feeder rotation and assembly not approved
C26 | 24.0 | 79.0 | Top | 0.0 | 24.0 | 31.0 | PREVIEW - feeder rotation and assembly not approved
J4 | 30.0 | 71.0 | Top | 0.0 | 30.0 | 39.0 | PREVIEW - feeder rotation and assembly not approved
U7 | 45.0 | 68.0 | Top | 0.0 | 45.0 | 42.0 | PREVIEW - feeder rotation and assembly not approved
L4 | 45.0 | 74.0 | Top | 0.0 | 45.0 | 36.0 | PREVIEW - feeder rotation and assembly not approved
D4 | 49.0 | 74.0 | Top | 0.0 | 49.0 | 36.0 | PREVIEW - feeder rotation and assembly not approved
R19 | 49.0 | 68.0 | Top | 0.0 | 49.0 | 42.0 | PREVIEW - feeder rotation and assembly not approved
C27 | 46.0 | 78.0 | Top | 0.0 | 46.0 | 32.0 | PREVIEW - feeder rotation and assembly not approved
C28 | 42.0 | 64.0 | Top | 0.0 | 42.0 | 46.0 | PREVIEW - feeder rotation and assembly not approved
U8 | 20.0 | 70.0 | Top | 0.0 | 20.0 | 40.0 | PREVIEW - feeder rotation and assembly not approved
C29 | 16.0 | 70.0 | Top | 0.0 | 16.0 | 40.0 | PREVIEW - feeder rotation and assembly not approved
J5 | 29.0 | 103.0 | Top | 0.0 | 29.0 | 7.0 | PREVIEW - feeder rotation and assembly not approved
Q3 | 41.0 | 102.0 | Top | 0.0 | 41.0 | 8.0 | PREVIEW - feeder rotation and assembly not approved
R20 | 45.0 | 102.0 | Top | 0.0 | 45.0 | 8.0 | PREVIEW - feeder rotation and assembly not approved
R21 | 49.0 | 102.0 | Top | 0.0 | 49.0 | 8.0 | PREVIEW - feeder rotation and assembly not approved
C30 | 39.0 | 98.0 | Top | 0.0 | 39.0 | 12.0 | PREVIEW - feeder rotation and assembly not approved
D6 | 36.0 | 95.0 | Top | 270.0 | 36.0 | 15.0 | PREVIEW - feeder rotation and assembly not approved
D7 | 38.2 | 95.0 | Top | 270.0 | 38.2 | 15.0 | PREVIEW - feeder rotation and assembly not approved
D8 | 40.4 | 95.0 | Top | 270.0 | 40.4 | 15.0 | PREVIEW - feeder rotation and assembly not approved
D9 | 42.6 | 95.0 | Top | 270.0 | 42.6 | 15.0 | PREVIEW - feeder rotation and assembly not approved
D10 | 44.8 | 95.0 | Top | 270.0 | 44.8 | 15.0 | PREVIEW - feeder rotation and assembly not approved
D11 | 47.0 | 95.0 | Top | 270.0 | 47.0 | 15.0 | PREVIEW - feeder rotation and assembly not approved
D12 | 49.2 | 95.0 | Top | 270.0 | 49.2 | 15.0 | PREVIEW - feeder rotation and assembly not approved
SW1 | 3.0 | 80.0 | Top | 90.0 | 3.0 | 30.0 | PREVIEW - feeder rotation and assembly not approved
SW2 | 3.0 | 70.0 | Top | 90.0 | 3.0 | 40.0 | PREVIEW - feeder rotation and assembly not approved
SW3 | 55.0 | 80.0 | Top | 270.0 | 55.0 | 30.0 | PREVIEW - feeder rotation and assembly not approved
SW4 | 55.0 | 70.0 | Top | 270.0 | 55.0 | 40.0 | PREVIEW - feeder rotation and assembly not approved
R22 | 47.0 | 60.0 | Top | 0.0 | 47.0 | 50.0 | PREVIEW - feeder rotation and assembly not approved
R23 | 49.0 | 60.0 | Top | 0.0 | 49.0 | 50.0 | PREVIEW - feeder rotation and assembly not approved
R24 | 51.0 | 60.0 | Top | 0.0 | 51.0 | 50.0 | PREVIEW - feeder rotation and assembly not approved
R25 | 53.0 | 60.0 | Top | 0.0 | 53.0 | 50.0 | PREVIEW - feeder rotation and assembly not approved
R26 | 55.0 | 60.0 | Top | 0.0 | 55.0 | 50.0 | PREVIEW - feeder rotation and assembly not approved
C31 | 45.0 | 60.0 | Top | 0.0 | 45.0 | 50.0 | PREVIEW - feeder rotation and assembly not approved
D5 | 45.0 | 55.0 | Top | 0.0 | 45.0 | 55.0 | PREVIEW - feeder rotation and assembly not approved
R27 | 42.0 | 58.0 | Top | 0.0 | 42.0 | 52.0 | PREVIEW - feeder rotation and assembly not approved
