LeeSpo/portable-display-epass-EVT1-minboot-r1/portable-display/hardware/v1-WEB6-redesign/placement_coordinates.csv

Reference | Value | X_mm | Y_mm | KiCad_rotation_deg | Side | Footprint | Status
C1 | 22u | 26.35 | 58.3 | 270 | F | Sameat:0603 | PLACEMENT ONLY - DO NOT ASSEMBLE
C2 | 22u | 27.85 | 58.3 | 270 | F | Sameat:0603 | PLACEMENT ONLY - DO NOT ASSEMBLE
C3 | 1u | 24.85 | 58.3 | 270 | F | Sameat:0603 | PLACEMENT ONLY - DO NOT ASSEMBLE
C4 | 22u | 14.6 | 51.5 | 90 | F | Sameat:0603 | PLACEMENT ONLY - DO NOT ASSEMBLE
C5 | 22u | 15.45 | 49.25 | 180 | F | Sameat:0603 | PLACEMENT ONLY - DO NOT ASSEMBLE
C6 | 22u | 34.75 | 52.1 | 0 | F | Sameat:0603 | PLACEMENT ONLY - DO NOT ASSEMBLE
C7 | 22u | 33.8 | 54.3 | 0 | F | Sameat:0603 | PLACEMENT ONLY - DO NOT ASSEMBLE
C8 | 22u | 34.75 | 49.7 | 0 | F | Sameat:0603 | PLACEMENT ONLY - DO NOT ASSEMBLE
C9 | 22u | 34.75 | 47.95 | 0 | F | Sameat:0603 | PLACEMENT ONLY - DO NOT ASSEMBLE
C10 | 2.2u | 24.1 | 47.8 | 90 | F | Sameat:0603 | PLACEMENT ONLY - DO NOT ASSEMBLE
C11 | 1u | 30.1 | 55.9 | 0 | F | Sameat:0603 | PLACEMENT ONLY - DO NOT ASSEMBLE
C12 | 18p | 28.1 | 29.8 | 0 | F | Sameat:0402 | PLACEMENT ONLY - DO NOT ASSEMBLE
C13 | 18p | 24.8 | 29.8 | 180 | F | Sameat:0402 | PLACEMENT ONLY - DO NOT ASSEMBLE
C14 | 100n | 25.2 | 31.05 | 0 | F | Sameat:0402 | PLACEMENT ONLY - DO NOT ASSEMBLE
C15 | 100n | 24.8 | 23.9 | 0 | F | Sameat:0402 | PLACEMENT ONLY - DO NOT ASSEMBLE
C16 | 100n | 17.25 | 34.8 | 270 | F | Sameat:0402 | PLACEMENT ONLY - DO NOT ASSEMBLE
C17 | 100n | 10.2 | 32.3 | 180 | F | Sameat:0402 | PLACEMENT ONLY - DO NOT ASSEMBLE
C18 | 100n | 25.2 | 32.7 | 0 | F | Sameat:0402 | PLACEMENT ONLY - DO NOT ASSEMBLE
C19 | 100n | 18.0 | 21.55 | 90 | F | Sameat:0402 | PLACEMENT ONLY - DO NOT ASSEMBLE
C20 | 100n | 10.3 | 25.75 | 180 | F | Sameat:0402 | PLACEMENT ONLY - DO NOT ASSEMBLE
C21 | 100n | 16.7 | 21.35 | 90 | F | Sameat:0402 | PLACEMENT ONLY - DO NOT ASSEMBLE
C22 | 100n | 11.9 | 30.8 | 270 | F | Sameat:0402 | PLACEMENT ONLY - DO NOT ASSEMBLE
C23 | 100n | 31.0 | 9.3 | 0 | F | Sameat:0402 | PLACEMENT ONLY - DO NOT ASSEMBLE
C24 | 100n | 9.8 | 3.55 | 0 | F | Sameat:0402 | PLACEMENT ONLY - DO NOT ASSEMBLE
C25 | 100n | 21.35 | 6.75 | 180 | F | Sameat:0402 | PLACEMENT ONLY - DO NOT ASSEMBLE
C26 | 100n | 30.7 | 6.55 | 180 | F | Sameat:0402 | PLACEMENT ONLY - DO NOT ASSEMBLE
C29 | 4.7u | 8.8 | 37.3 | 270 | F | Sameat:0603 | PLACEMENT ONLY - DO NOT ASSEMBLE
C30 | 10u | 27.2 | 39.85 | 90 | F | Sameat:0603 | PLACEMENT ONLY - DO NOT ASSEMBLE
C31 | 10n | 11.7 | 22.3 | 90 | F | Sameat:0402 | PLACEMENT ONLY - DO NOT ASSEMBLE
C32 | 10u | 29.35 | 58.3 | 270 | F | Sameat:0603 | PLACEMENT ONLY - DO NOT ASSEMBLE
C33 | 1u | 20.1 | 53.6 | 180 | F | Sameat:0603 | PLACEMENT ONLY - DO NOT ASSEMBLE
C34 | 2.2u | 26.8 | 23.6 | 90 | F | Sameat:0603 | PLACEMENT ONLY - DO NOT ASSEMBLE
C35 | 2.2u | 10.3 | 24.35 | 180 | F | Sameat:0603 | PLACEMENT ONLY - DO NOT ASSEMBLE
C36 | 470n | 11.9 | 27.45 | 270 | F | Sameat:0402 | PLACEMENT ONLY - DO NOT ASSEMBLE
C37 | 100n | 19.45 | 21.5 | 90 | F | Sameat:0402 | PLACEMENT ONLY - DO NOT ASSEMBLE
C38 | 2.2u | 33.3 | 56.7 | 0 | F | Sameat:0603 | PLACEMENT ONLY - DO NOT ASSEMBLE
C39 | 100n | 20.45 | 55.85 | 180 | F | Sameat:0402 | PLACEMENT ONLY - DO NOT ASSEMBLE
C40 | 1u | 20.75 | 50.9 | 90 | F | Sameat:0603 | PLACEMENT ONLY - DO NOT ASSEMBLE
C41 | 1u | 30.1 | 54.05 | 0 | F | Sameat:0603 | PLACEMENT ONLY - DO NOT ASSEMBLE
C42 | 1u | 6.9 | 41.3 | 270 | F | Sameat:0603 | PLACEMENT ONLY - DO NOT ASSEMBLE
C43 | 100n | 15.1 | 47.85 | 0 | F | Sameat:0402 | PLACEMENT ONLY - DO NOT ASSEMBLE
C44 | 1u | 11.0 | 37.75 | 270 | F | Sameat:0603 | PLACEMENT ONLY - DO NOT ASSEMBLE
C45 | 100n | 13.4 | 38.0 | 270 | F | Sameat:0402 | PLACEMENT ONLY - DO NOT ASSEMBLE
C46 | 10u | 11.3 | 46.45 | 0 | F | Sameat:0603 | PLACEMENT ONLY - DO NOT ASSEMBLE
C47 | 10u | 14.8 | 46.4 | 180 | F | Sameat:0603 | PLACEMENT ONLY - DO NOT ASSEMBLE
C48 | 10u | 3.7 | 48.6 | 180 | F | Sameat:0603 | PLACEMENT ONLY - DO NOT ASSEMBLE
C49 | 10u | 12.0 | 51.0 | 0 | F | Sameat:0603 | PLACEMENT ONLY - DO NOT ASSEMBLE
C50 | 10u | 12.0 | 53.1 | 0 | F | Sameat:0603 | PLACEMENT ONLY - DO NOT ASSEMBLE
C51 | 100n | 9.4 | 52.3 | 180 | F | Sameat:0402 | PLACEMENT ONLY - DO NOT ASSEMBLE
D1 | CHARGE | 35.5 | 56.75 | 90 | F | Sameat:LED0603 | PLACEMENT ONLY - DO NOT ASSEMBLE
D2 | BAT54 | 17.4 | 14.0 | 90 | F | Sameat:D_SOD123 | PLACEMENT ONLY - DO NOT ASSEMBLE
D3 | BAT54 | 12.8 | 14.0 | 90 | F | Sameat:D_SOD123 | PLACEMENT ONLY - DO NOT ASSEMBLE
D5 | STATUS | 20.5 | 2.0 | 0 | F | Sameat:LED0603 | PLACEMENT ONLY - DO NOT ASSEMBLE
D6 | PESD4V0 | 28.1 | 34.25 | 180 | F | Sameat:0402 | PLACEMENT ONLY - DO NOT ASSEMBLE
D7 | PESD4V0 | 28.1 | 33.0 | 180 | F | Sameat:0402 | PLACEMENT ONLY - DO NOT ASSEMBLE
D8 | PESD4V0 | 28.1 | 31.75 | 180 | F | Sameat:0402 | PLACEMENT ONLY - DO NOT ASSEMBLE
D9 | PESD4V0 | 25.85 | 34.0 | 180 | F | Sameat:0402 | PLACEMENT ONLY - DO NOT ASSEMBLE
D10 | PESD4V0 | 24.1 | 28.0 | 270 | F | Sameat:0402 | PLACEMENT ONLY - DO NOT ASSEMBLE
D11 | PESD4V0 | 28.85 | 24.25 | 180 | F | Sameat:0402 | PLACEMENT ONLY - DO NOT ASSEMBLE
D12 | PESD4V0 | 31.15 | 24.4 | 180 | F | Sameat:0402 | PLACEMENT ONLY - DO NOT ASSEMBLE
D13 | PESD4V0 | 13.25 | 57.5 | 270 | F | Sameat:0402 | PLACEMENT ONLY - DO NOT ASSEMBLE
D14 | PESD4V0 | 24.85 | 61.4 | 90 | F | Sameat:0402 | PLACEMENT ONLY - DO NOT ASSEMBLE
H1 | M2 | 3 | 3 | 0 | F | MountingHole_1 | PLACEMENT ONLY - DO NOT ASSEMBLE
H2 | M2 | 35 | 3 | 0 | F | MountingHole_2 | PLACEMENT ONLY - DO NOT ASSEMBLE
H3 | M2 | 3 | 61 | 0 | F | MountingHole_3 | PLACEMENT ONLY - DO NOT ASSEMBLE
H4 | M2 | 35 | 61 | 0 | F | MountingHole_4 | PLACEMENT ONLY - DO NOT ASSEMBLE
J1 | USB4105-GF-A-060 | 19 | 61.4 | 0 | F | Sameat:USB4105 | PLACEMENT ONLY - DO NOT ASSEMBLE
J2 | 1S LiPo + NTC | 28.5 | 61.5 | 0 | F | Sameat:BAT3 | PLACEMENT ONLY - DO NOT ASSEMBLE
J3 | DEBUG POGO | 23 | 17.5 | 0 | F | Sameat:HDR8 | PLACEMENT ONLY - DO NOT ASSEMBLE
J4 | KD024EGOIN152-01 | 16 | 43 | 0 | F | Sameat:FPC45 | PLACEMENT ONLY - DO NOT ASSEMBLE
J5 | MicroSD | 34.7 | 32 | 90 | F | Sameat:MICROSD | PLACEMENT ONLY - DO NOT ASSEMBLE
L1 | 1uH/2A | 17.8 | 51.6 | 180 | F | Sameat:IND_2x2 | PLACEMENT ONLY - DO NOT ASSEMBLE
L2 | 1uH/2A | 31.3 | 52.1 | 0 | F | Sameat:IND_2x2 | PLACEMENT ONLY - DO NOT ASSEMBLE
L3 | 1uH/2A | 31.3 | 49.7 | 0 | F | Sameat:IND_2x2 | PLACEMENT ONLY - DO NOT ASSEMBLE
L5 | 4.7uH | 5.8 | 44.8 | 270 | F | Sameat:IND_2x2 | PLACEMENT ONLY - DO NOT ASSEMBLE
L6 | 4.7uH | 12 | 48.5 | 0 | F | Sameat:IND_2x2 | PLACEMENT ONLY - DO NOT ASSEMBLE
Q1 | 2N7002 | 24 | 12.8 | 0 | F | Sameat:SOT23-3 | PLACEMENT ONLY - DO NOT ASSEMBLE
Q2 | 2N7002 | 29.3 | 12.8 | 0 | F | Sameat:SOT23-3 | PLACEMENT ONLY - DO NOT ASSEMBLE
Q3 | AO3401A | 26.7 | 36.7 | 0 | F | Sameat:SOT23-3 | PLACEMENT ONLY - DO NOT ASSEMBLE
R1 | 5.1k | 14.75 | 55.5 | 270 | F | Sameat:0402 | PLACEMENT ONLY - DO NOT ASSEMBLE
R2 | 5.1k | 12.0 | 60.5 | 90 | F | Sameat:0402 | PLACEMENT ONLY - DO NOT ASSEMBLE
R3 | 4.7k | 22.0 | 20.6 | 0 | F | Sameat:0402 | PLACEMENT ONLY - DO NOT ASSEMBLE
R4 | 2.2k | 15.3 | 20.0 | 90 | F | Sameat:0402 | PLACEMENT ONLY - DO NOT ASSEMBLE
R5 | 2.2k | 14.0 | 20.0 | 90 | F | Sameat:0402 | PLACEMENT ONLY - DO NOT ASSEMBLE
R6 | 2.2k | 31.0 | 57.75 | 90 | F | Sameat:0402 | PLACEMENT ONLY - DO NOT ASSEMBLE
R7 | 10k | 8.0 | 33.5 | 0 | F | Sameat:0402 | PLACEMENT ONLY - DO NOT ASSEMBLE
R8 | 10k | 10.5 | 33.75 | 0 | F | Sameat:0402 | PLACEMENT ONLY - DO NOT ASSEMBLE
R9 | 10k | 5.5 | 33.5 | 0 | F | Sameat:0402 | PLACEMENT ONLY - DO NOT ASSEMBLE
R10 | 10k | 6.5 | 25.0 | 0 | F | Sameat:0402 | PLACEMENT ONLY - DO NOT ASSEMBLE
R11 | 10k | 13.0 | 8.0 | 0 | F | Sameat:0402 | PLACEMENT ONLY - DO NOT ASSEMBLE
R12 | 820k | 31.0 | 8.0 | 0 | F | Sameat:0402 | PLACEMENT ONLY - DO NOT ASSEMBLE
R13 | 10k | 21.0 | 9.6 | 90 | F | Sameat:0402 | PLACEMENT ONLY - DO NOT ASSEMBLE
R14 | 10k | 21.25 | 5.3 | 180 | F | Sameat:0402 | PLACEMENT ONLY - DO NOT ASSEMBLE
R15 | 4.7k | 11.5 | 10.7 | 0 | F | Sameat:0402 | PLACEMENT ONLY - DO NOT ASSEMBLE
R16 | 4.7k | 14.3 | 10.7 | 0 | F | Sameat:0402 | PLACEMENT ONLY - DO NOT ASSEMBLE
R17 | 10k | 17.1 | 10.7 | 0 | F | Sameat:0402 | PLACEMENT ONLY - DO NOT ASSEMBLE
R18 | 10k | 8.7 | 10.7 | 0 | F | Sameat:0402 | PLACEMENT ONLY - DO NOT ASSEMBLE
R20 | 100k | 24.05 | 34.4 | 90 | F | Sameat:0402 | PLACEMENT ONLY - DO NOT ASSEMBLE
R21 | 10k | 24.0 | 36.15 | 180 | F | Sameat:0402 | PLACEMENT ONLY - DO NOT ASSEMBLE
R22 | 100k | 10.4 | 22.1 | 90 | F | Sameat:0402 | PLACEMENT ONLY - DO NOT ASSEMBLE
R23 | 0R | 7.0 | 18.5 | 0 | F | Sameat:0402 | PLACEMENT ONLY - DO NOT ASSEMBLE
R24 | 22k | 7.0 | 20.2 | 0 | F | Sameat:0402 | PLACEMENT ONLY - DO NOT ASSEMBLE
R25 | 47k | 9.4 | 18.5 | 0 | F | Sameat:0402 | PLACEMENT ONLY - DO NOT ASSEMBLE
R26 | 100k | 9.4 | 20.2 | 0 | F | Sameat:0402 | PLACEMENT ONLY - DO NOT ASSEMBLE
R27 | 2.2k | 20.5 | 4.0 | 0 | F | Sameat:0402 | PLACEMENT ONLY - DO NOT ASSEMBLE
R28 | 10k | 7.65 | 23.75 | 0 | F | Sameat:0402 | PLACEMENT ONLY - DO NOT ASSEMBLE
R29 | 0R | 15.25 | 37.8 | 0 | F | Sameat:0402 | PLACEMENT ONLY - DO NOT ASSEMBLE
R31 | 0R | 13.5 | 35.9 | 0 | F | Sameat:0402 | PLACEMENT ONLY - DO NOT ASSEMBLE
SW1 | UP | 2.5 | 12 | 90 | F | Sameat:SW_SIDE | PLACEMENT ONLY - DO NOT ASSEMBLE
SW2 | DOWN | 2.5 | 20 | 90 | F | Sameat:SW_SIDE | PLACEMENT ONLY - DO NOT ASSEMBLE
SW3 | OK | 35.5 | 12 | 270 | F | Sameat:SW_SIDE | PLACEMENT ONLY - DO NOT ASSEMBLE
SW4 | BACK | 35.5 | 20 | 270 | F | Sameat:SW_SIDE | PLACEMENT ONLY - DO NOT ASSEMBLE
SW5 | POWER | 35.5 | 44 | 270 | F | Sameat:SW_SIDE | PLACEMENT ONLY - DO NOT ASSEMBLE
SW6 | FEL | 2.5 | 54 | 90 | F | Sameat:SW_SIDE | PLACEMENT ONLY - DO NOT ASSEMBLE
U1 | AXP2101 | 25 | 53 | 180 | F | Sameat:QFN40 | PLACEMENT ONLY - DO NOT ASSEMBLE
U2 | V851s | 18 | 28 | 180 | F | Sameat:QFN88 | PLACEMENT ONLY - DO NOT ASSEMBLE
U3 | W25N01GVZEIG | 6.9 | 29 | 180 | F | Sameat:WSON-8 | PLACEMENT ONLY - DO NOT ASSEMBLE
U4 | LIS2DW12TR | 9.5 | 6 | 0 | F | Sameat:LGA-12 | PLACEMENT ONLY - DO NOT ASSEMBLE
U5 | RV-3028-C7 | 17.8 | 7 | 0 | F | Sameat:RTC-8 | PLACEMENT ONLY - DO NOT ASSEMBLE
U6 | SN74LVC1G123DCTR | 27 | 7.5 | 0 | F | Sameat:SSOP-8 | PLACEMENT ONLY - DO NOT ASSEMBLE
U8 | TPS22918DBVR | 6.1 | 37.5 | 0 | F | Sameat:SOT23-6 | PLACEMENT ONLY - DO NOT ASSEMBLE
U9 | USBLC6-2SC6 | 17.05 | 54.75 | 270 | F | Sameat:SOT23-6 | PLACEMENT ONLY - DO NOT ASSEMBLE
U10 | TPS65631DPDR | 7.5 | 48.7 | 0 | F | Sameat:WSON-12 | PLACEMENT ONLY - DO NOT ASSEMBLE
Y1 | 24MHz 10ppm | 26.9 | 26.8 | 180 | F | Sameat:XTAL4 | PLACEMENT ONLY - DO NOT ASSEMBLE
