LeeSpo/portable-display-epass-EVT1-minboot-r1/verification/design_metadata/bom_PREVIEW_NOT_FOR_PURCHASE.csv

Reference | Value | Footprint | Manufacturer Part | LCSC | Datasheet | DNP | Status
J1 | USB4105-GF-A-060 | Sameat:USB4105 | USB4105-GF-A-060 | C3025063 | https://gct.co/files/drawings/usb4105.pdf | no | ENGINEERING PREVIEW
R1 | 5.1k | Sameat:0402 | 0402 5.1k 1% | C25905 |  | no | ENGINEERING PREVIEW
R2 | 5.1k | Sameat:0402 | 0402 5.1k 1% | C25905 |  | no | ENGINEERING PREVIEW
U1 | AXP2101 | Sameat:QFN40 | AXP2101 | C3036461 | https://www.x-powers.com/en.php/Info/product_detail/article_id/95 | no | ENGINEERING PREVIEW
L1 | 1uH/2A | Sameat:IND_2x2 | 1uH 2A shielded |  |  | no | ENGINEERING PREVIEW
L2 | 1uH/2A | Sameat:IND_2x2 | 1uH 2A shielded |  |  | no | ENGINEERING PREVIEW
L3 | 1uH/2A | Sameat:IND_2x2 | 1uH 2A shielded |  |  | no | ENGINEERING PREVIEW
C1 | 22u | Sameat:0603 | 0603 22u X5R |  |  | no | ENGINEERING PREVIEW
C2 | 22u | Sameat:0603 | 0603 22u X5R |  |  | no | ENGINEERING PREVIEW
C3 | 1u | Sameat:0603 | 0603 1u X5R |  |  | no | ENGINEERING PREVIEW
C4 | 22u | Sameat:0603 | 0603 22u X5R |  |  | no | ENGINEERING PREVIEW
C5 | 22u | Sameat:0603 | 0603 22u X5R |  |  | no | ENGINEERING PREVIEW
C6 | 22u | Sameat:0603 | 0603 22u X5R |  |  | no | ENGINEERING PREVIEW
C7 | 22u | Sameat:0603 | 0603 22u X5R |  |  | no | ENGINEERING PREVIEW
C8 | 22u | Sameat:0603 | 0603 22u X5R |  |  | no | ENGINEERING PREVIEW
C9 | 22u | Sameat:0603 | 0603 22u X5R |  |  | no | ENGINEERING PREVIEW
C10 | 2.2u | Sameat:0603 | 0603 2.2u X5R |  |  | no | ENGINEERING PREVIEW
C11 | 1u | Sameat:0603 | 0603 1u X5R |  |  | no | ENGINEERING PREVIEW
J2 | 1S LiPo + NTC | Sameat:BAT3 | S3B-PH-SM4-TB(LF)(SN) | C265101 |  | no | ENGINEERING PREVIEW
SW5 | POWER | Sameat:SW_SIDE | GT-TC072B-H045-L1 | C5117859 |  | no | ENGINEERING PREVIEW
R3 | 4.7k | Sameat:0402 |  | C25900 |  | no | ENGINEERING PREVIEW
R4 | 2.2k | Sameat:0402 |  | C25879 |  | no | ENGINEERING PREVIEW
R5 | 2.2k | Sameat:0402 |  | C25879 |  | no | ENGINEERING PREVIEW
D1 | CHARGE | Sameat:LED0603 | 0603 Green LED |  |  | no | ENGINEERING PREVIEW
R6 | 2.2k | Sameat:0402 |  | C25879 |  | no | ENGINEERING PREVIEW
U9 | USBLC6-2SC6 | Sameat:SOT23-6 | USBLC6-2SC6 | C2827654 | https://www.st.com/resource/en/datasheet/usblc6-2.pdf | no | ENGINEERING PREVIEW
D13 | PESD4V0 | Sameat:0402 | PESD4V0Y1BBSF |  |  | no | ENGINEERING PREVIEW
D14 | PESD4V0 | Sameat:0402 | PESD4V0Y1BBSF |  |  | no | ENGINEERING PREVIEW
C32 | 10u | Sameat:0603 | 0603 10u X5R |  |  | no | ENGINEERING PREVIEW
C33 | 1u | Sameat:0603 | 0603 1u X5R |  |  | no | ENGINEERING PREVIEW
C38 | 2.2u | Sameat:0603 |  |  |  | no | ENGINEERING PREVIEW
C39 | 100n | Sameat:0402 |  |  |  | no | ENGINEERING PREVIEW
C40 | 1u | Sameat:0603 |  |  |  | no | ENGINEERING PREVIEW
C41 | 1u | Sameat:0603 |  |  |  | no | ENGINEERING PREVIEW
U2 | V851s | Sameat:QFN88 | V851s | C5365286 | https://www.allwinnertech.com/index.php?a=index&c=product&id=118 | no | ENGINEERING PREVIEW
Y1 | 24MHz 10ppm | Sameat:XTAL4 | 24MHz 10ppm 3225 |  |  | no | ENGINEERING PREVIEW
C12 | 18p | Sameat:0402 |  |  |  | no | ENGINEERING PREVIEW
C13 | 18p | Sameat:0402 |  |  |  | no | ENGINEERING PREVIEW
C34 | 2.2u | Sameat:0603 |  |  |  | no | ENGINEERING PREVIEW
C35 | 2.2u | Sameat:0603 |  |  |  | no | ENGINEERING PREVIEW
C36 | 470n | Sameat:0402 |  |  |  | no | ENGINEERING PREVIEW
C37 | 100n | Sameat:0402 |  |  |  | no | ENGINEERING PREVIEW
C14 | 100n | Sameat:0402 | 0402 100n X7R | C1525 |  | no | ENGINEERING PREVIEW
C15 | 100n | Sameat:0402 | 0402 100n X7R | C1525 |  | no | ENGINEERING PREVIEW
C16 | 100n | Sameat:0402 | 0402 100n X7R | C1525 |  | no | ENGINEERING PREVIEW
C17 | 100n | Sameat:0402 | 0402 100n X7R | C1525 |  | no | ENGINEERING PREVIEW
C18 | 100n | Sameat:0402 | 0402 100n X7R | C1525 |  | no | ENGINEERING PREVIEW
C19 | 100n | Sameat:0402 | 0402 100n X7R | C1525 |  | no | ENGINEERING PREVIEW
C20 | 100n | Sameat:0402 | 0402 100n X7R | C1525 |  | no | ENGINEERING PREVIEW
C21 | 100n | Sameat:0402 | 0402 100n X7R | C1525 |  | no | ENGINEERING PREVIEW
U3 | W25N01GVZEIG | Sameat:WSON-8 | W25N01GVZEIG | C907680 | https://www.winbond.com/hq/product/code-storage-flash-memory/qspinand-flash/?__locale=en&partNo=W25N01GV | no | ENGINEERING PREVIEW
C22 | 100n | Sameat:0402 |  | C1525 |  | no | ENGINEERING PREVIEW
R7 | 10k | Sameat:0402 |  |  |  | no | ENGINEERING PREVIEW
R8 | 10k | Sameat:0402 |  |  |  | no | ENGINEERING PREVIEW
R9 | 10k | Sameat:0402 |  |  |  | no | ENGINEERING PREVIEW
J3 | DEBUG POGO | Sameat:HDR8 |  |  |  | no | ENGINEERING PREVIEW
SW6 | FEL | Sameat:SW_SIDE | GT-TC072B-H045-L1 | C5117859 |  | no | ENGINEERING PREVIEW
R10 | 10k | Sameat:0402 |  |  |  | no | ENGINEERING PREVIEW
R28 | 10k | Sameat:0402 |  |  |  | no | ENGINEERING PREVIEW
U4 | LIS2DW12TR | Sameat:LGA-12 | LIS2DW12TR | C189624 | https://www.st.com/resource/en/datasheet/lis2dw12.pdf | no | ENGINEERING PREVIEW
U5 | RV-3028-C7 | Sameat:RTC-8 | RV-3028-C7-32.768kHz-1ppm-TA-QC | C3019759 | https://www.microcrystal.com/fileadmin/Media/Products/RTC/App.Manual/RV-3028-C7_App-Manual.pdf | no | ENGINEERING PREVIEW
U6 | SN74LVC1G123DCTR | Sameat:SSOP-8 | SN74LVC1G123DCTR |  | https://www.ti.com/lit/ds/symlink/sn74lvc1g123.pdf | no | ENGINEERING PREVIEW
Q1 | 2N7002 | Sameat:SOT23-3 | 2N7002 | C8545 |  | no | ENGINEERING PREVIEW
Q2 | 2N7002 | Sameat:SOT23-3 | 2N7002 | C8545 |  | no | ENGINEERING PREVIEW
R11 | 10k | Sameat:0402 |  |  |  | no | ENGINEERING PREVIEW
R12 | 820k | Sameat:0402 |  |  |  | no | ENGINEERING PREVIEW
C23 | 100n | Sameat:0402 |  |  |  | no | ENGINEERING PREVIEW
R13 | 10k | Sameat:0402 |  |  |  | no | ENGINEERING PREVIEW
R14 | 10k | Sameat:0402 |  |  |  | no | ENGINEERING PREVIEW
R15 | 4.7k | Sameat:0402 |  |  |  | no | ENGINEERING PREVIEW
R16 | 4.7k | Sameat:0402 |  |  |  | no | ENGINEERING PREVIEW
R17 | 10k | Sameat:0402 |  |  |  | no | ENGINEERING PREVIEW
R18 | 10k | Sameat:0402 |  |  |  | no | ENGINEERING PREVIEW
D2 | BAT54 | Sameat:D_SOD123 |  |  |  | no | ENGINEERING PREVIEW
D3 | BAT54 | Sameat:D_SOD123 |  |  |  | no | ENGINEERING PREVIEW
C24 | 100n | Sameat:0402 |  | C1525 |  | no | ENGINEERING PREVIEW
C25 | 100n | Sameat:0402 |  | C1525 |  | no | ENGINEERING PREVIEW
C26 | 100n | Sameat:0402 |  | C1525 |  | no | ENGINEERING PREVIEW
J4 | TFT-H035B22WVIST8N20_V3-0 | Sameat:FPC20 | FH12-20S-0.5SH(55) | C596730 | https://www.hotlcd.com/productdetail/1973 | no | ENGINEERING PREVIEW
U7 | TPS61169DCKR | Sameat:SC70-5 | TPS61169DCKR | C71045 | https://www.ti.com/lit/ds/symlink/tps61169.pdf | no | ENGINEERING PREVIEW
L4 | 10uH/1.5A | Sameat:IND_2x2 |  |  |  | no | ENGINEERING PREVIEW
D4 | SS16 | Sameat:D_SOD123 |  |  |  | no | ENGINEERING PREVIEW
R19 | 2.55R 1% | Sameat:0603 |  |  |  | no | ENGINEERING PREVIEW
C27 | 1u/25V | Sameat:0603 |  |  |  | no | ENGINEERING PREVIEW
C28 | 100n | Sameat:0402 |  |  |  | no | ENGINEERING PREVIEW
U8 | TPS22918DBVR | Sameat:SOT23-6 | TPS22918DBVR |  | https://www.ti.com/lit/ds/symlink/tps22918.pdf | no | ENGINEERING PREVIEW
C29 | 4.7u | Sameat:0603 |  |  |  | no | ENGINEERING PREVIEW
J5 | MicroSD | Sameat:MICROSD | MUP-M617-2 | C5205359 |  | no | ENGINEERING PREVIEW
Q3 | AO3401A | Sameat:SOT23-3 | AO3401A | C15127 |  | no | ENGINEERING PREVIEW
R20 | 100k | Sameat:0402 |  |  |  | no | ENGINEERING PREVIEW
R21 | 10k | Sameat:0402 |  |  |  | no | ENGINEERING PREVIEW
C30 | 10u | Sameat:0603 |  |  |  | no | ENGINEERING PREVIEW
D6 | PESD4V0 | Sameat:0402 | PESD4V0Y1BBSF |  |  | no | ENGINEERING PREVIEW
D7 | PESD4V0 | Sameat:0402 | PESD4V0Y1BBSF |  |  | no | ENGINEERING PREVIEW
D8 | PESD4V0 | Sameat:0402 | PESD4V0Y1BBSF |  |  | no | ENGINEERING PREVIEW
D9 | PESD4V0 | Sameat:0402 | PESD4V0Y1BBSF |  |  | no | ENGINEERING PREVIEW
D10 | PESD4V0 | Sameat:0402 | PESD4V0Y1BBSF |  |  | no | ENGINEERING PREVIEW
D11 | PESD4V0 | Sameat:0402 | PESD4V0Y1BBSF |  |  | no | ENGINEERING PREVIEW
D12 | PESD4V0 | Sameat:0402 | PESD4V0Y1BBSF |  |  | no | ENGINEERING PREVIEW
SW1 | UP | Sameat:SW_SIDE | GT-TC072B-H045-L1 | C5117859 |  | no | ENGINEERING PREVIEW
SW2 | DOWN | Sameat:SW_SIDE | GT-TC072B-H045-L1 | C5117859 |  | no | ENGINEERING PREVIEW
SW3 | OK | Sameat:SW_SIDE | GT-TC072B-H045-L1 | C5117859 |  | no | ENGINEERING PREVIEW
SW4 | BACK | Sameat:SW_SIDE | GT-TC072B-H045-L1 | C5117859 |  | no | ENGINEERING PREVIEW
R22 | 100k | Sameat:0402 |  |  |  | no | ENGINEERING PREVIEW
R23 | 0R | Sameat:0402 |  |  |  | no | ENGINEERING PREVIEW
R24 | 22k | Sameat:0402 |  |  |  | no | ENGINEERING PREVIEW
R25 | 47k | Sameat:0402 |  |  |  | no | ENGINEERING PREVIEW
R26 | 100k | Sameat:0402 |  |  |  | no | ENGINEERING PREVIEW
C31 | 10n | Sameat:0402 |  |  |  | no | ENGINEERING PREVIEW
D5 | STATUS | Sameat:LED0603 | 0603 Blue LED |  |  | no | ENGINEERING PREVIEW
R27 | 2.2k | Sameat:0402 |  |  |  | no | ENGINEERING PREVIEW
