LeeSpo/portable-display-epass-EVT1-minboot-r1/portable-display/hardware/v1-WEB6-redesign/split-power-candidate/ORDERING_GUIDE_CN.md

# 嘉立创（JLC）下单指南（候选版，尚未放行生产）

> **重要：当前板子仍是 `fabrication_released = false`。** 在电源 OTP 回复、J4 最终确认和下面 OPEN_ISSUES 列出的工程项关闭之前，本文只用来报价和预览，不要直接下单生产。

## PCB 选项

| 选项 | 选择 | 原因 |
|---|---|---|
| 层数 | 4 层 | F / In1(GND) / In2(GND+电源) / B |
| 板厚 | **1.0 mm** | USB/DSI 走线按 1.0 mm 叠层规划 |
| 叠层 | **阻抗控制：是；叠层选 JLC04101H-3313**（L1/L2 和 L3/L4 之间是 3313 半固化片 0.0994 mm、εr 4.1；芯板约 0.70 mm、εr 4.6；外层 1 oz，内层 0.5 oz）。KiCad 板设置里的叠层已经按这个填好 | 顶层走线的参考平面是 In1 GND。USB 90 Ω 用 0.127/0.140 mm（线宽/线距）耦合线对；MIPI CK 100 Ω 用 0.100/0.150 mm 耦合线对；MIPI D0 用两根独立的 0.127 mm 线（每根约 50 Ω，合起来约 100 Ω 差分）。**不要选 7628 叠层**：7628 的介质厚度是 0.21 mm，在这块板的空间里线宽做不到 90/100 Ω。下单备注：`Impedance control: USB 90ohm diff w0.127/s0.14, MIPI 100ohm diff w0.10/s0.15, both on L1 ref L2, stackup JLC04101H-3313` |
| 表面处理 | **ENIG（沉金）** | U2 为 0.35 mm、U1 为 0.40 mm 间距 QFN，需平整焊盘并审核钢网 |
| 过孔 | 0.60/0.30 mm；**决定：Via Covering 选 "Epoxy Filled & Capped"（POFV，树脂塞孔 + 电镀封帽），范围是全部 0.30 mm 孔**。下单备注：`POFV all 0.30mm vias (via-in-pad on U1/U2 EP and small passives)` | 板上所有过孔都是 0.30 mm 孔，所以"全部 0.30 mm 孔做 POFV"就能覆盖 U1/U2 EP 过孔和仍保留的其他焊盘内过孔，不用一个个标注。POFV 的具体费用以工厂报价为准。按"先保证能用"的原则接受这笔费用。不做 POFV 的话，锡会被吸进 EP 和 0402 焊盘里的孔，可能造成虚焊或立碑 |
| 最小线宽/间距 | **0.100 mm 线宽 / 约 0.127 mm 级间距（4/5 mil）** | DSI CK 实际使用 0.100 mm 线宽，不能按 5/5 mil 核价；最终以 Gerber DFM 和指定叠层确认 |
| 铜厚 | 外层 1 oz，内层 0.5 oz（默认） | |
| 阻焊/丝印 | 任意颜色；丝印白色 | |
| 安装孔 | 4 × 2.4 mm（M2 螺丝） | 保持不变 |

## SMT 贴片选项

- **贴片面：双面**（B 面 14 颗，见下面"预览检查"第 5 条）。除顶面外，**底面（B 面）也有 0402 器件**，例如：
  - C34：SOC_LDO_1V8 2.2 µF
  - C57：U2-55 3V3 100 nF
- **全部功能器件由工厂完成双面贴装。** 底面去耦与供电链接照常贴装，不能为省第二面费用直接设为 DNP。裸测试点 TP1–TP10 没有钢网开口，不采购、不贴装，不进入 BOM/CPL。
- **嘉立创标准型 PCBA。** U2 的引脚间距为 0.35 mm；[国内产线说明](https://www.jlc.com/portal/server_guide_30669.html)列明经济型不支持引脚中心距 ≤0.35 mm 的芯片。即使将来改为单面，也不能仅凭贴装面数认定可走经济型。U1/U2 隐蔽焊点及 EP 仍须装联与 X-Ray 验收。
- BOM 和坐标文件（CPL）由 KiCad 导出；导出前确认 LCSC 字段都已填写。

## 两块个人样机的数量口径

- 目标是 **2 PCS 单板完整 PCBA**，不是两个拼板 SET。
- 例如 `3×2` 拼板选 `2 SET` 会制造、贴装 **12 PCS**；元件用量也按 12 块计算。这是此前报价偏高的主要原因。
- 由工厂安排工艺边和生产拼板时，确认最终交货的已贴装单板数量，并区分 PCB 裸板数量、拼板数量和 SMT 数量。数量页面须明确显示两块单板，不能只看数字“2”。
- 当前仍有双面贴装、POFV 和标准型固定费用；本次工程优化不构成两块合计 600 元的报价承诺。

## 首次上电用的线材（另外采购）

- 买一根 **SH1.0（1.0 mm 间距）3 针单头引线**：一头是 SH1.0 母头，另一头是裸线，用来把 J2 接到限流电源。
- **插到 J2 之后、给电之前，先用万用表确认 pin1 是正极**（pin3 是 GND）。不同厂家的单头线颜色顺序可能不一样，不能看线的颜色。和 BRINGUP_CN.md 第一步的极性检查是同一件事。板上没有反接保护。

## JLC 预览时必须检查的方向

在 JLC 的 PCBA 预览页面，逐个确认：

1. **U1（AXP2101）、U2（V851s）、U4、U5、U6、U8、U9、U11、U12、U13** 的 1 脚圆点与丝印 1 脚标记对齐。
2. **J1（USB-C）** 开口朝板边；**J5（XKTF-0803-0 TF 座）** 插卡口朝板边。
3. **D1/D2/D3/D5** 的阴极方向与丝印一致。D13/D14（ESDLC5V0LB）为双向器件，无极性。
4. **Q1/Q2/Q3**（SOT-23）三个脚的位置。
5. 底面器件（14 颗：C34/C46/C47/C55/C56/C57/C58/C59/C60/C61/C62/C63/C64/R39）显示在底面视图里。

如果发现任何器件旋转了 90°/180°，在 JLC 页面上手动修正，并把修正结果记录回本仓库。
