LeeSpo/portable-display-epass-EVT1-minboot-r1/portable-display/hardware/v1-WEB6-redesign/split-power-candidate/verification/preflight_review_20261009/MANUFACTURING_REVIEW_CN.md

# 制造、封装与机械审查

初审：2026-10-09；完成及重新核对：2026-10-14（Asia/Shanghai）。审查对象为 split-power-candidate 当前工作区，包含未提交 FEL 修改。源 PCB SHA-256：`9801b487f879cf5314230d11dbd18dc759a0dfbec91ab028c0c4b6da58afe1ae`；本次没有修改任何设计文件。

**结论：发现三组明确的实际料号/封装不匹配，当前不能按现有 BOM 投板贴装。** 本次复算为 124 个封装（120 个电气器件、4 个机械孔）。120 个 Sameat 电气封装的焊盘几何均与本地库一致；这不能证明库本身适合实际器件。完整字段、焊盘坐标、原厂依据、库哈希及物料缺口见 [结构化审查](manufacturing_audit.json)。

## 1. 已确认的制造阻断

| 优先级 / 对象 | 当前设计 | 原厂依据 | 影响与处置 |
|---|---|---|---|
| P1 — J5 MicroSD | MPN=`MUP-M617-2`，LCSC=`C5205359`，封装 `Sameat:MICROSD`；8 个信号焊盘节距 **1.00 mm**、首尾 **7.00 mm** | MUP 型号相同的厂家原始 PDF Rev 1.1，2017-08-02，第 8 页机械及推荐板图：节距 **1.10 mm**、首尾 **7.70 mm** | 与指定连接器不匹配；TF 供电逻辑通过也不能保证可装配/启动。按最终采购图重建封装，整体核对 CD1/CD2、壳体脚、定位结构、视图和脚序，再布线及 DRC。 |
| P1 — J2 电池座 | MPN=`S3B-PH-SM4-TB(LF)(SN)`；`Sameat:BAT3` 仅 3 个 1.2×2.2 mm 信号焊盘，无固定脚；Fab/Courtyard 仅 **5.4×2.4 mm** | JST 官方 PH 资料第 4 页 SMT Side entry 表：3 位型号宽度 B=**9.9 mm**；第 2 页侧插推荐板图有 **2 个加固焊盘** | 缺固定焊盘且装配包络失真，DRC无法按实物排除干涉；需重建专用封装并复查 USB 邻近布局、板边、出线和外壳空间。 |
| P1 — D6–D14 ESD | 9 个器件 MPN=`PESD4V0Y1BBSF`，均使用 `Sameat:0402`：焊盘中心距 **1.00 mm**、单焊盘 **0.60×0.70 mm** | Nexperia 官方产品页确认 DSN0603-2 / SOD962-2；2021-01-06 包封 PDF 第 1–2 页：端子节距 **0.40 mm**、本体 **0.60×0.30×0.30 mm**，第 3 页有专用 land 图 | 实际器件不是英制0402。不能签核当前焊盘上的可靠装配；更换专用封装或明确采用匹配封装且电气合格的替代料。D6–D12涉及 SD 数据、时钟、命令、检测，D13/D14涉及 USB CC1/CC2。 |

设计定位均相对本候选目录：

- J5：主 PCB Reference 第 16081 行；`sameat.pretty/MICROSD.kicad_mod` 第 11–18 行为八个信号焊盘。
- J2：主 PCB Reference 第 2971 行；`sameat.pretty/BAT3.kicad_mod` 第 28–39 行为包络，第 57–74 行为全部三个焊盘。
- ESD：主 PCB D6 Reference 第 6523 行、D14 第 5632 行；`sameat.pretty/0402.kicad_mod` 第 11–12 行为两焊盘。

以上是料号与物理几何不一致，并非静态网表短路结论；不能依靠放宽 DRC 或复制板上封装到库来关闭。

## 2. 原厂来源及证据边界

- **J5**：[MUP-M617-2 厂家原始 PDF](https://p.globalsources.com/IMAGES/PDT/SPEC/363/K1189584363.pdf)，由 GlobalSources 托管，文件署名 MUP INDUSTRIAL CO., LTD。第 1 页型号/版本和第 8 页型号标题、机械图已目视重核；不是相似型号的图。第 7 页通用信号说明含 M616 字样，本次没有用该处作为机械依据。2026-10-14 重新下载 SHA-256 为 `85b1f6a7ae7be07a5e930ea74d76a56aa939231379391acf11ad1ebc2882657f`，与初审相同。
- **J2**：[JST 官方 PH 数据手册](https://www.jst-mfg.com/product/pdf/eng/ePH.pdf)，第 2 页侧插板图、第 4 页型号尺寸表。图中有两个固定焊脚，信号脚节距为 2 mm。3.4 mm 是相对位置标注，不能将其当作固定焊盘长度；本报告不据此给出完整固定焊盘 XY 尺寸，修复应按受控连接器图落实。2026-10-14 重新下载并目视复核，SHA-256 为 `447624f4f2f7d37c58c1eaa7ee314ad757fe7aff48f6186491ef6f69fbc00b96`，与初审相同。
- **ESD**：[Nexperia 官方型号页](https://www.nexperia.com/product/PESD4V0Y1BBSF)、[官方封装页](https://www.nexperia.com/packages/SOD962-2.html)、[SOD962-2 包封 PDF](https://assets.nexperia.com/documents/package-information/SOD962-2.pdf)。2026-10-14 已重新读取官方产品页和 PDF 文本；PDF 下载端点返回 HTTP 403，因此没有声称保存了本地原厂 PDF。封装型号、端子节距和本体尺寸同时可由官方 HTML 复核。

## 3. 保留修复与剩余签核条件

**已保留的修复。** U1/U2 外围铜焊盘、EP 与钢网分窗的工程修复仍在；其余此前专用封装修复不能重新报成旧故障。独立库比较包含所有焊盘的编号、类型、形状、局部位置、对称旋转、尺寸、钻孔、层、圆角及 mask/paste 设置，至 1 nm 精度归一后 120/120 相同。该比较不代替厂商 land、三维包络或全图形审查。

**物料仍未定版。** 120 个电气器件中 54 个 MPN 字段空白、79 个 LCSC 字段空白，包含 J3 调试焊盘；空平台料号本身不是电气错误。非空 MPN 也可能只是描述：L1–L3 为 `1uH 2A shielded`，L5/L6 为 `4.7uH 1.5A`，Y1 为 `24MHz 10ppm 3225`，部分电容为 `0603 22u X5R`。电感具体 Isat/Irms/DCR、MLCC 耐压和直流偏压有效容量、晶振 CL/ESR/驱动等级均不能据此验收。D2/D3 的 BAT54 值与二脚 SOD123 库也必须由最终明确 MPN 核定，本次不把缺料号直接判作已确定封装错误。

**层叠和工艺未定。** 当前 PCB 仅声明总厚 1.0 mm，无显式 stackup、分层介质厚度、Dk 或铜厚，不能签核 USB/MIPI 实际阻抗、电源载流或压降。setup 仅启用 tenting，covering/plugging/capping/filling 均为 no；现存焊盘内过孔详见本轮 [几何证据](via_in_pad_audit.json)，不能把阻焊盖孔视作填孔封帽。最终板厂工艺、钢网厚度、锡膏转移、QFN 空洞率及试焊仍未验收。

**J4 是已按工程图建立、但装配未确认的候选。** 当前 `502598-4593` 含 45 个信号及 2 个固定焊盘；仓库 Molex SD-502598-003 厂家图的 0.3 mm 配接/0.6 mm 交错尾端节距、45 位对应 B=13.2、D=12.6、A=15.6 mm，与当前基本几何相符。仍需落实屏幕指定 -4591 与本板 -4593 的实际兼容、FPC Pin1/触点方向、0.20±0.03 mm 厚度、折弯/插拔/架高空间。不能把 J4 与仅三个焊盘的 J2 占位混为同一问题。[Molex 官方产品页](https://www.molex.com/en-us/products/part-detail/5025984593)。

本审查未进行实物贴装、上电或功能测量，也未生成生产文件。修正以上确定问题后仍须同步 PCB、原理图、本地库与 BOM，重新跑 ERC/DRC/一致性检查并完成装配和功能验收。
