LeeSpo/portable-display-epass-EVT1-minboot-r1/portable-display/hardware/v1-WEB6-redesign/split-power-candidate/verification/production_20261018/preview/front_assembly.png

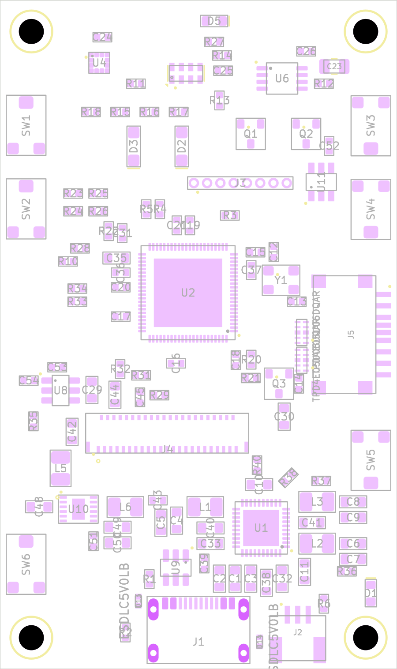
portable-display/hardware/v1-WEB6-redesign/split-power-candidate/verification/production_20261018/preview/front_assembly.png
