LeeSpo/portable-display-epass-EVT1-minboot-r1/portable-display/hardware/v1-WEB6-redesign/split-power-candidate/BRINGUP_CN.md

# 首次上电 / Bring-up 流程（EVT1 split-power candidate）

> 状态：设计文档。Fabrication **NOT released**。

## 0Ω 隔离链接（全部 0402WGF0000TCE，LCSC C17168，JLC basic，≈$0.0011）

| 位号 | PMIC 侧网络 | 负载侧网络 | 位置 / 层 | 隔离的负载 |
|---|---|---|---|---|
| R39 | 3V3_PMIC (L1.2, C4, C5, U1.13/17/21) | 3V3 | (17.6,50.2) B.Cu | 3V3 主干：U10(AMOLED 偏置电源)、U8、U2.22/44/47/55、SD、传感器… |
| R38 | 3V3_PMIC | 3V3_B | (27.6,45.7) F.Cu 45° | 北侧支路：Q3.2、U2.5、U2.78、D1.1、C14 |
| R36 | CORE_0V93_PMIC (L2.2, C6, C7, U1.4 FB) | CORE_0V93 | (33.2,54.65) F.Cu | V851S 内核 |
| R37 | DRAM_1V5_PMIC (L3.2, C8, C9, U1.9 FB) | DRAM_1V5 | (30.75,46.0) F.Cu | 片内 DRAM |
| R40 | 1V8_PMIC (U1.18 ALDO1, C10) | 1V8 | (24.6,44.5) F.Cu 90° | U2.37/62/79 等 1V8 负载 |

注意：DCDC 反馈点（U1.4 / U1.9）在 PMIC 侧，链接断开时 PMIC 可空载稳压；链接压降（<50mΩ×电流）在负载侧不被补偿，CORE 在 ~0.5A 时约 −10…−25 mV，可接受，首板实测确认。

交付板的 R36–R40 **全部由工厂贴装**。下面拆除/恢复链接的步骤用于故障定位，由具备返修条件的工厂或实验室执行；正常交付不要求用户补焊。

## 背面探针焊盘

新增 TP1=CORE_0V93、TP2=DRAM_1V5、TP3=1V8、TP4=RTC_3V3、TP5=VSYS、TP6=ELVDD、TP7=ELVSS、TP8=PMIC_SCL、TP9=PMIC_SDA、TP10=GND。测量电源时可用 TP10 作参考地；观察 PMIC I²C 需匹配实际电源域。测试点不作为带载供电入口。

[测试点坐标与改动说明](OPTIMIZATION_20261018_CN.md)；[背面预览](verification/production_20261018/preview/bottom_assembly.png)。

## 首次上电：从 J2 接限流电源（不要先接 USB）

> 下面的电压和限流值是**保守的经验值，不是实测值**。首板量到实际数据后再修订。

1. **先确认 J2 极性。** 板上没有反接保护，接反会直接损坏 PMIC。
   - J2 是 SH1.0 3 针：pin1 = VBAT（+），pin2 = BAT_NTC，pin3 = GND（−）。
   - 用 SH1.0 单头引线（采购见 ORDERING_GUIDE_CN.md）。线插上 J2 之后、给电之前，用万用表确认 **pin1 是正极**、pin3 是 GND。
   - pin2（NTC）悬空，或者接一个 10 kΩ 电阻到 GND。
2. **第一阶段：不接屏（J4 不插排线）。**
   - 电源设 **3.8 V、限流 300 mA**，从 J2 的 pin1/pin3 接入。
   - 按 PWRON。量 **3V3、CORE_0V93、DRAM_1V5（1V5）、1V8**，和 POWER_REVIEW 的预期值对照。
   - 如果碰到限流（电压被拉低）或者有一路电压不对，马上断电，按下面的流程拆 R36–R40 排查。
3. **第二阶段：接屏。** 断电后插上屏，限流改为 **500 mA**，重新上电，检查 ELVDD/ELVSS 及点屏。
4. 上面两步都正常之后，再试 USB 供电（VBUS）和枚举。**不要一开始就从 USB 上电**：USB 口一般没有可调限流，PMIC 默认电压不对的时候保护不了负载。

## 逐路排查流程（建议使用限流电源，VBAT/VBUS 先限 200 mA）

1. **目检**：U1/U2 方向、J4/J5、二极管极性丝印。
2. **对地电阻（不上电）**：分别量 3V3、3V3_B、CORE_0V93、DRAM_1V5、1V8、VSYS、VBUS 及各 *_PMIC 网络对 GND。任何 <10 Ω（CORE 允许较低但应 >1 Ω）先排查短路。
3. **拆链接上电**：R36–R40 全部开路，接电池/USB，按 PWRON。量 3V3_PMIC≈3.3V、CORE_0V93_PMIC≈0.93V、DRAM_1V5_PMIC≈1.5V、1V8_PMIC≈1.8V、VSYS。核对与 OTP 默认值一致（见 POWER_REVIEW_CN.md / power_requirements.json rail_requirements；VSYS-max OTP 问题仍待 X-Powers 确认）。电压不对 → 不要装链接，先查 OTP/I²C（PMIC_SDA/SCL 可用 I²C 读 0x82/0x84/0x85/0x92）。
4. **逐路恢复**（每步断电焊接，复测电流和电压）：
   1. R39（3V3 主干）→ 电流应 <30 mA（U10 关断，LCD_EN 低）。
   2. R38（3V3_B 北支路）。
   3. R40（1V8）。
   4. R37（DRAM 1.5V）。
   5. R36（CORE 0.93V）→ SoC 开始启动，电流跳升正常；观察 UART / USB FEL。
5. **功能**：FEL（按 FEL 键上电）、USB 枚举、SD、LCD_EN→U10 AMOLED 偏置电源（TPS65631）。
6. 任何一步电流异常或电压跌落：立即断电，记录网络和电流，不要继续下一步。
