LeeSpo/portable-display-epass-EVT1-minboot-r1/portable-display/hardware/v1-WEB6-redesign/split-power-candidate/verification/preflight_review_20261009/REVIEW_CN.md

# 电源、USB 与关键信号投板前审查

原生检查日期：2026-10-09；DRC 重新核验：2026-10-14。报告整理、资料复核和当前源文件确认：2026-10-14（Asia/Shanghai）。对象为 `split-power-candidate` 当前工作区，包括未提交的 FEL 修改。源 PCB SHA-256：`9801b487f879cf5314230d11dbd18dc759a0dfbec91ab028c0c4b6da58afe1ae`。

**结论：当前不能投板放行，也不能认定整板功能可用。** 明确问题包括 FEL 铜连接未完成、PCB 与原理图不同步，以及指定器件与封装不匹配。USB 的候选布线检查通过，其他既有电路修复仍保留；电源冷启动、容差、高速接口和制造条件尚有未验收项。本次只新增审查证据，没有修改电路、工程规则、本地库或器件要求。

## 1. 实际检查结果

| 检查 | 当前结果 | 证据与边界 |
|---|---|---|
| KiCad 原生 ERC，全严重级 | 0 项 | [erc.json](erc.json)；检查的是尚未同步 FEL 的原理图，不能据此认可新 PCB |
| 原生 DRC，一致性、全部走线错误、重新填铜 | 3 项悬空警告、5 项未连接、9 项一致性问题 | [drc.json](drc.json)；非零退出码 5；包括全部严重级，未降低规则或新增豁免 |
| 独立逐脚、数值及原生报告检查 | 总体失败 | [power_audit.json](power_audit.json)；120 个电气器件、503 个唯一编号焊盘；168 项指定焊盘网络声明符合约束，但原理图差异和 DRC 失败仍存在 |
| 填铜后的实际焊盘连通组 | 84 个非 NC 网络中，81 个各有一个焊盘组；3 个网络断开 | [geometry_audit.json](geometry_audit.json)；断开的是 `3V3`、`FEL_KEY_N`、`FEL_N` |
| USB 专项候选几何 | 通过 | [usb_audit.json](usb_audit.json)；未验证实际阻抗、眼图、480 Mb/s 通信或系统 ESD |
| 唤醒域拓扑与装配约束 | 通过；6 项故障注入均被拒绝 | [wake_audit.json](wake_audit.json)、[wake_faults.json](wake_faults.json)；不证明实板脉宽、关机保持或重复唤醒 |
| FEL 网络声明及电阻静态计算 | 通过声明约束，实际铜连通失败 | [fel_audit.json](fel_audit.json)；不能作为下载入口已修复的证据 |
| 焊盘内过孔复核 | 38 处交叠，涉及 37 个过孔 | [via_in_pad_audit.json](via_in_pad_audit.json)；含边界相切，需与板厂确认填孔封帽或移孔 |
| 原厂规格、封装及接口对照 | 有新发现和未闭合项 | [电气依据](ELECTRICAL_REVIEW_CN.md)、[制造审查](MANUFACTURING_REVIEW_CN.md) |

填铜只保存到隔离副本。检查副本 SHA-256 为 `6921247488934becacd4f2205facfa68f950939ae91285556c1f78c191d273b7`；与原件的封装、走线、过孔及板框几何在数值规范化后相同，差别包括保存格式及铜区填充。2026-10-14 恢复隔离副本并重新执行同版本 DRC，填铜哈希及全部发现与初审完全一致，见 [重新核验](drc_revalidation_20261014.json)和[原生报告](drc_refill_20261014.json)。各专项报告记录的是检查副本哈希，源文件哈希及对应关系见 [provenance.json](provenance.json)。

ERC/DRC、逐脚比对和几何报告中可能重复描述同一个问题，不能把所有记录条数相加当作独立故障数量。原理图部分引脚类型为 passive，且由 PCB 连接恢复，仍需依据器件手册独立核对功能。

## 2. 明确的连接与装配问题

### P1：FEL 实际布线未完成

当前修改意图是 `SW6 / J3.7 → R33 1 kΩ → U2.56 / PC1`，以 R34 10 kΩ 上拉到主 3V3，BOOT0/BOOT1 独立保持 `11`。但实际铜连通结果为：

| 网络 | 分离的焊盘组 | 影响 |
|---|---|---|
| `3V3` | 既有主 3V3 焊盘组；单独的 `R34.1` | 新 FEL 上拉未得到供电；不是所有既有主控 3V3 焊盘都断电 |
| `FEL_KEY_N` | `R33.1`；`J3.7`；`SW6.1/SW6.2` | 按键、治具和串联电阻之间没有完整通路 |
| `FEL_N` | `R33.2`；`U2.56`；`R34.2` | 串联电阻、CPU 输入和上拉彼此断开 |

原生 DRC 另报告 FEL_KEY_N 悬空走线和两颗 FEL 相关悬空过孔。位置及对象 UUID 保存在原始报告中；[FEL 铜线图](fel_copper.png)白圈标出原生发现。必须完成铜连接并重跑所有相关检查，不能只依赖焊盘具有相同网络名。

### P1：FEL 修改尚未同步到原理图

原理图缺少 R33/R34，SW6/J3.7 仍属于 BOOT0，U2.56 仍为 NC。原生一致性报告包含 6 项错误和 3 项属性警告。独立比对另产生 11 条器件、数值或逐脚差异，与原生问题有重叠。`power_requirements.json` 引用的 `FEL_REPAIR_CN.md` 也未提供。

修复时先按原厂脚位与功能确定最终电路，再同步原理图、PCB、本地符号和要求。重新生成原理图不能代替独立电气审查。当前审查保留了旧图与新板的差异证据。

### P1：BOM 指定型号与实际焊盘不匹配

制造审查发现以下需要修正的对象，尺寸、料号和原厂依据见 [MANUFACTURING_REVIEW_CN.md](MANUFACTURING_REVIEW_CN.md)：

- D6–D14 指定 `PESD4V0Y1BBSF`，使用通用 `Sameat:0402`。该器件的 DSN0603-2 / SOD962-2 机械封装需对应专用焊盘，不能按当前通用 0402 默认装配。
- J2 指定 `JST S3B-PH-SM4-TB`，当前 `BAT3` 仅有三个信号焊盘，机械外形与固定脚未与所选侧插连接器图匹配。
- J5 指定 `MUP-M617-2`，当前 `MICROSD` 信号焊盘节距 1.00 mm；所查厂家型号图给出 1.10 mm，并包含卡检测及机械结构。

这些问题涉及实物贴装与接口功能。板上封装与本地库一致、DRC 无封装间距错误，都不能证明它们与采购器件匹配。应修正对应封装并重布，或选择与已审核封装匹配的器件；完成原厂图、BOM、板上封装和装配空间一致性验收。

## 3. 电源与电平的未闭合项

### P1：PMIC 冷启动配置缺少批次证据

目标分配为 DCDC1 → 3V3、DCDC3 → CORE 0.93 V、DCDC4 → DRAM 1.5 V、ALDO1 → 1.8 V、RTCLDO1 → 常供电 3.3 V。VMID 与 VSYS、主控内部 LDOA 与外部 1V8 保持独立。网络连接符合设计意图，但 C3036461 批次的默认电压、使能、顺序、PWRON 模式及未用 DCDC2/5 关闭状态尚无证据。

必须由可追溯批次配置和冷启动波形共同验收；主控启动后写 I²C 寄存器不能证明第一次启动满足供电要求。依据：[AXP2101 V1.4](https://wiki.lilygo.cc/datasheet/AXP2101_Datasheet_V1.4_en.pdf)、[V851S 原厂数据手册](https://bbs.aw-ol.com/assets/uploads/files/1664112156052-c55b9458-9847-4731-873e-c98d352589ea-v851s-amp-v851se_datasheet_v0.1.pdf)，具体页码见电气依据。

### P1：常供电域及 I²C 的最坏角电压裕量不足

公开 AXP2101 手册给 RTCLDO ±10% 精度，3.3 V 目标包络为 2.97–3.63 V，超出 LIS2DW12 正常工作上限 3.6 V，也未完整覆盖现有唤醒定时验收假设 3.0–3.6 V。

R15/R16 将 I²C 上拉至主 3V3，U4 VDDIO 使用常供电域。若 DCDC1 在 PWM 模式按公开 ±3% 取高角 3.399 V，同时 RTCLDO 取低角 2.97 V，LIS2DW12 控制脚 `VDDIO+0.3 V` 为 3.27 V，独立最坏角可能相差约 129 mV。这里是缺少关联或更紧保证时的规格包络分析，没有实测过压证据。

需要收紧供电保证、调整供电/接口方案或提供覆盖全工况的依据，并检查启动顺序及关机漏电。不能直接把上拉迁入常供电域，否则还需处理掉电主控输入。依据：[LIS2DW12 Rev9](https://www.st.com/resource/en/datasheet/lis2dw12.pdf)、AXP2101，页码与计算条件见电气依据。

### P1：VSYS 与屏幕偏压芯片输入范围尚未兼容验收

U10 TPS65631 的 AVIN/PVIN 接 VSYS，其推荐工作输入为 2.9–4.5 V。AXP2101 的 VSYS DPM 默认设置为 4.7 V；该设置不是恒定输出电压或实测值，但说明不能从连接名直接推断输入总在 U10 工作范围内。

要覆盖 USB 单供电、电池单供电、充电、热插拔、低电量及负载跳变，保证偏压开启时输入在允许范围，或修改供电路径/器件。依据：[TPS65631](https://www.ti.com/lit/ds/symlink/tps65631.pdf)和 AXP2101。

### P1：LCD_EN 默认关屏与掉电时序缺少保证

LCD_EN 同时接主控 PD21、U8 TPS22918 ON 和 U10 CTRL，没有外部下拉。U10 内部下拉最弱角不足以覆盖主控允许漏电，不能证明复位高阻期间必然满足有效低电平。U8 QOD 未接，VCI 放电时间也尚未受控。

应补明确的默认电平保证并验收复位、爬升及掉电。屏资料中的电源图标注 SPI Interface，而本板使用 MIPI，共用 VCI/偏压使能方案需屏厂确认。依据：[TPS22918](https://www.ti.com/lit/ds/symlink/tps22918.pdf)、TPS65631、V851S 和项目原始面板规格。

### P1：电池、充电与热保护配置未定版

BAT_NTC 接 J2.2/U1.31，但电池化学体系、容量、保护板、NTC 曲线及最终充电参数缺失。AXP2101 的 TS 模式/电流源配置含 EFUSE 条件，不能由连上 NTC 认定温度保护已工作。输入限流、终止电压/电流及温升需与实际电池及 USB 供电条件匹配；原厂部分热阈值说明存在差异，需按实际寄存器和温度试验验收。

CC 的 5.1 kΩ 下拉只建立受电端连接条件。当前没有 CC 电流能力检测路径的证据；AXP2101 REG16 的通用 POR 输入限流为 1.5 A，不能把该数值当成所接 USB 主机或电源已经允许的电流，也不能当作 C3036461 的已验证批次配置。需要启动前和枚举后的输入电流策略、供电能力识别或受限的使用条件，才能验收 USB 供电。具体寄存器与版本依据见电气审查。

## 4. USB、显示与其余关键信号

| 子系统 | 当前能确认的内容 | 继续验收要求 |
|---|---|---|
| USB-C 输入 | CC1/CC2 各经 5.1 kΩ 下拉，VBUS/GND 连通 | 输入电流限制、插拔、压降、充电及热测试；Rd 不代替可用输入电流配置 |
| USB 数据 | DP/DM 正反插和 U9 通道对应，实际铜路径连通；正插差 0.4036 mm，反插名义差 0.3773 mm | 实际 90 Ω、正反插枚举/480 Mb/s/持续传输/ESD；反插值包含按 1.0 mm 板厚估计的两次过孔 |
| USB 参考地 | 填铜后候选中心线覆盖检查通过；底层短支路 1.0698 mm | 完整回流和阻抗需实际层叠，中心线覆盖不是场分析 |
| TF | SDC0 引脚对应、PH12 高阻/低默认开卡、高关卡的修复保留 | 先修正 J5 实物封装；再验不同卡启动、读写、断电防倒灌；无 1.8 V 总线切换结构，软件不得启用该电压切换 |
| FEL | PC1 接法有官方参考依据，BOOT0/1 与按键独立 | 先补铜与同步原理图；再测有有效 TF 卡时强制进入、无卡回退、按键释放启动；BROM 先 UART 握手、超时后 USB |
| LCD RESET/TE | PA8/PA9 与 VDDIO 共 1.8 V；R29 0 Ω 和 R32 下拉保留 | 固件迁脚、复位低脉宽、sleep-out 等待及 TE 中断 |
| 屏偏压 | 默认 +4.6/−4.0 V 在面板给出的 DC 条件范围内 | 与典型 ±3.6 V 测试点不同，工作点、功耗、光学和时序需确认；不能仅因不同于典型值判为过压 |
| UART / I²C | PH9/10 UART0、PE0/1 UART3、PH13/14 TWI3、PE4/5 TWI0 的映射相符 | 固件复用、日志路由、地址、总线恢复；治具供电跟随或隔离，避免向掉电主板输入高电平 |
| 唤醒 | 常供电上拉与 U11 隔离修复保留 | RTC 常供电保持、低有效开漏锁存初始化、2.2–3.8 s 实际脉宽、连续触发和反复唤醒；LIS2DW12 默认 INT1 状态需初始化 |
| PH0 唤醒通知 | Q2 开漏连接 PH0 | 没有外部上拉，需可靠固件上拉或硬件保证；PH0 不等同于主控硬复位 |
| 24 MHz | XIN/XOUT 顶层连通、无过孔，C12/C13 为 18 pF | Y1 准确料号、CL/ESR、起振及频偏 |
| ADC 按键 | 梯形电阻与 1V8/GPADC0 路径合理 | 电源/ADC/电阻容差下阈值、去抖及同时按键行为 |

SA0 有内部上拉，不能把当前未外接判为浮空地址错误。I²C 使用主电源上拉，传感器相关脚为输入/开漏，未发现常供电强拉高通路，不能仅因跨域就断言关机必倒灌；仍需电压裕量和关机电流测量。详见电气依据。

### MIPI 仍需重审耦合与匹配

| 差分对 | N 总铜长 | P 总铜长 | 铜长差 |
|---|---:|---:|---:|
| CK | 7.8743 mm | 12.8715 mm | 4.9972 mm |
| D0 | 7.9571 mm | 19.0095 mm | 11.0524 mm |

四线均在 F.Cu、无过孔，但当前长距离分离路径不能作为已验收高速接口。屏厂资料已经给出 MIPI 参考参数 456 MHz、DCLK 18.5 MHz；仍需确认该参数含义、最终主控配置、叠层和允许时延差，不能仅由总铜长差宣称某个协议限值超标或一定无法亮屏。先定 J4/FPC 实物，再按受控阻抗和时延预算重布。见 [MIPI 铜线图](mipi_copper.png)。

屏资料还包含复位和初始化等待参数：RESX 低至少 30 μs、sleep-out 后等待 120 ms 再显示开启等，具体条件见电气依据。不能沿用历史报告中“无任何速率或时序资料”的表述。

## 5. 制造与采购门槛

当前 PCB 只有名义 1.0 mm 板厚，缺少板厂确认的介质厚度、介电常数、成品铜厚和阻抗控制条件。0.127 mm 线宽及当前线距不能据此称为实际 90 Ω USB 或合格 MIPI。

焊盘内过孔需要板厂/装联确认；当前数量已重新计算，不能默认按普通开放通孔生产。U1/U2 修复后的 EP、钢网分窗仍需钢网厚度、填孔封帽、空洞率和试焊资格。J4/FPC 的接触面、连接器型号、折弯及插拔空间未定版。通用电感、晶体、电容、二极管等还需准确料号和特性；名义电容及连通不能证明有效容量、稳定性、载流、压降或温升。详见制造审查和电气依据。

## 6. 关闭顺序与验收条件

**投板前设计门槛：** 完成 FEL 铜与原理图同步；修正 BOM/封装；关闭电源域容差、VSYS 输入和 LCD_EN 默认态问题；确定 PMIC 采购配置、电池/NTC、连接器和层叠；完成 MIPI/USB 受控参数、载流与装联审核。然后重跑原生 ERC/DRC、一致性、逐脚/数值及专项约束，相关问题须有明确关闭证据。

**首板功能验收：** 在设计门槛满足后进行下表测试；本次没有执行实板测量，也没有可核验配套固件。测试记录必须包含源文件哈希、器件批次、固件版本、仪器、条件和原始波形/日志。

| 顺序 | 条件与操作 | 接受证据 |
|---|---|---|
| 1 | 上电前测短路；在匹配电池/充电配置和限流条件下测试 USB 单供电、电池单供电及切换 | 所有负载端电压、纹波、压降与上下电时序满足受控规格；未用 PMIC 通道关闭；U10 输入及常供电容差合格 |
| 2 | 冷启动、低电量及负载跳变 | 电源时序、24 MHz 起振/频偏、UART 启动日志；不依赖启动后补配置来维持首次启动 |
| 3 | USB 正反插；有有效 TF 启动卡时按住 FEL；无卡回退；正常释放启动 | BROM UART 超时后的 USB 枚举、目标高速模式及持续传输正常；有卡强制入口确实跳过启动；按键不影响正常 BOOT 绑带 |
| 4 | 多种 TF 卡冷启动和目标速率读写；按流程停总线再关卡 | 启动、读写校验、掉电/重初始化、残压与倒灌电流满足要求；禁用不支持的 1.8 V 切换 |
| 5 | I²C 通信、关机、常供电棕断电和卡低恢复；分别触发 RTC/加速度计并重复测试 | 默认配置恢复可靠、关机电流与常供电保持合格、唤醒脉宽合格、无连续触发误关机；PH0 输入有效 |
| 6 | 按面板确认的偏压/VCI/RESET 顺序点屏，执行 TE 和目标 MIPI 配置 | 开关屏和复位符合时序，图像稳定；包含低电量、热插拔和工作温度条件 |
| 7 | 电池充电、NTC 开短路/冷热、峰值负载及 ESD | 充电和温保阈值/行为与电池及输入条件匹配；温升、压降、热稳定和系统 ESD 有实测记录 |

本审查提出修复要求和验收标准，不构成生产 Gerber、PCBA 订单或硬件放行。

## 7. 证据与复现

- [源文件与执行记录](provenance.json)、[专项执行命令](checks_execution.json)、[原生 ERC](erc_execution.json)、[DRC](drc_execution.json)、[网表导出](netlist_execution.json)。
- [审查源快照](reviewed_sources.zip)同时保存原 PCB 和填铜后的完整候选工程/本地库/检查依赖。解压后 `checked_sources` 内保留原相对目录；原 PCB 单独位于 `original_board`。它不是已修复或可生产版本。
- [JST 原厂资料](sources/JST_PH.pdf)、[MUP 厂家型号资料](sources/MUP_M617_2.pdf)及关键机械图已归档。J2 固定焊盘尺寸误读已在最终报告中删除，见 [独立制造复核](manufacturing_crosscheck.json)。
- [几何复核脚本](audit_geometry.py)读取工程并生成报告/区域图；二维模型仅补充原生检查，不进行阻抗、载流或功能仿真。
- [USB 铜线图](usb_copper.png)、[电源铜线图](power_copper.png)、[FEL 铜线图](fel_copper.png)、[MIPI 铜线图](mipi_copper.png)均从实际几何生成。
- 核查时保留完整本地符号/封装库和原有相对目录。执行命令中的临时绝对路径应替换为解压后的隔离副本路径；`--save-board` 只可用于该副本。
- Python 依赖采用仓库 `v0_legacy/requirements.txt`，区域图另需 Pillow。没有安装到项目源目录，也没有执行原理图生成器、布线修复器或生产导出。
- 原生填铜曾在沙箱中因 macOS 图形服务初始化崩溃。最终在沙箱外检查隔离副本，成功生成报告；失败日志一并保留，最终 DRC 结果是发现问题，不是工具崩溃。

历史 2026-10-04 的全通过报告对应不同 PCB 哈希，不能覆盖当前未完成的 FEL 改动。报告后任何设计、规则、料号或层叠变化均需产生对应新证据。
