LeeSpo/portable-display-epass-EVT1-minboot-r1/verification/routing_backlog.csv

Net | Group | Distinct_pad_groups_excluding_zones | Minimum_joins_excluding_zones | Endpoints | Status
1V8 | Power / ground; zones excluded | 5 | 4 | U1.18; C10.1; C16.1; C17.1; R22.1 | STATIC ESTIMATE - not KiCad DRC; plane connections excluded
3V3 | Power / ground; zones excluded | 33 | 32 | U1.13; U1.17; U1.21; L1.2; C4.1; C5.1; R3.1; R4.1; R5.1; D1.1; U2.5; U2.22; U2.44; U2.47; U2.55; U2.78; C14.1; C15.1; U3.8; C22.1; R7.1; R8.1; R9.1; J3.2; R10.1; R28.1; R15.1; R16.1; R17.1; R18.1; U8.1; Q3.2; R20.1 | STATIC ESTIMATE - not KiCad DRC; plane connections excluded
ACCEL_INT_N | Other control / sensor / keys | 4 | 3 | U2.30; U4.12; R18.2; D3.1 | STATIC ESTIMATE - not KiCad DRC; plane connections excluded
ADC_KEYS | Other control / sensor / keys | 7 | 6 | U2.46; R22.2; R23.2; R24.2; R25.2; R26.2; C31.1 | STATIC ESTIMATE - not KiCad DRC; plane connections excluded
BAT_NTC | Other control / sensor / keys | 2 | 1 | U1.31; J2.2 | STATIC ESTIMATE - not KiCad DRC; plane connections excluded
BL_SW | Display - model not frozen | 3 | 2 | U7.1; L4.2; D4.1 | STATIC ESTIMATE - not KiCad DRC; plane connections excluded
CHGLED_A | Other control / sensor / keys | 2 | 1 | D1.2; R6.1 | STATIC ESTIMATE - not KiCad DRC; plane connections excluded
CHGLED_N | Other control / sensor / keys | 2 | 1 | U1.1; R6.2 | STATIC ESTIMATE - not KiCad DRC; plane connections excluded
CORE_0V93 | Power / ground; zones excluded | 14 | 13 | U1.4; L2.2; C6.1; C7.1; U2.13; U2.17; U2.33; U2.35; U2.54; U2.75; U2.88; C18.1; C19.1; C20.1 | STATIC ESTIMATE - not KiCad DRC; plane connections excluded
DRAM_1V5 | Power / ground; zones excluded | 7 | 6 | U1.9; L3.2; C8.1; C9.1; U2.34; U2.36; C21.1 | STATIC ESTIMATE - not KiCad DRC; plane connections excluded
DSI_CKN | Display - model not frozen | 2 | 1 | U2.84; J4.13 | STATIC ESTIMATE - not KiCad DRC; plane connections excluded
DSI_CKP | Display - model not frozen | 2 | 1 | U2.85; J4.12 | STATIC ESTIMATE - not KiCad DRC; plane connections excluded
DSI_D0N | Display - model not frozen | 2 | 1 | U2.80; J4.16 | STATIC ESTIMATE - not KiCad DRC; plane connections excluded
DSI_D0P | Display - model not frozen | 2 | 1 | U2.81; J4.15 | STATIC ESTIMATE - not KiCad DRC; plane connections excluded
DSI_D1N | Display - model not frozen | 2 | 1 | U2.82; J4.10 | STATIC ESTIMATE - not KiCad DRC; plane connections excluded
DSI_D1P | Display - model not frozen | 2 | 1 | U2.83; J4.9 | STATIC ESTIMATE - not KiCad DRC; plane connections excluded
E907_RX | Other control / sensor / keys | 2 | 1 | U2.31; J3.6 | STATIC ESTIMATE - not KiCad DRC; plane connections excluded
E907_TX | Other control / sensor / keys | 2 | 1 | U2.25; J3.5 | STATIC ESTIMATE - not KiCad DRC; plane connections excluded
GND | Power / ground; zones excluded | 95 | 94 | J1.A1; J1.A12; J1.B1; J1.B12; J1.SH1; J1.SH2; J1.SH3; J1.SH4; R1.2; R2.2; U1.3; U1.41; C1.2; C2.2; C3.2; C4.2; C5.2; C6.2; C7.2; C8.2; C9.2; C10.2; C11.2; J2.3; SW5.3; U9.2; D13.2; D14.2; C32.2; C33.2; C38.2; C39.2; C40.2; C41.2; U2.51; U2.89; Y1.2; Y1.4; C12.2; C13.2; C34.2; C35.2; C36.2; C37.2; C14.2; C15.2; C16.2; C17.2; C18.2; C19.2; C20.2; C21.2; U3.4; C22.2; J3.1; SW6.3; U4.6; U4.7; U4.8; U5.5; U6.2; Q1.2; Q2.2; R13.2; R14.2; C24.2; C25.2; C26.2; J4.8; J4.11; J4.14; J4.17; U7.2; R19.2; C27.2; C28.2; U8.2; C29.2; J5.6; J5.10; J5.11; J5.12; J5.13; C30.2; D6.2; D7.2; D8.2; D9.2; D10.2; D11.2; D12.2; SW1.3; SW2.3; SW3.3; SW4.3; C31.2; D5.2 | STATIC ESTIMATE - not KiCad DRC; plane connections excluded
I2C0_SCL | Other control / sensor / keys | 4 | 3 | U2.21; U4.1; U5.3; R15.2 | STATIC ESTIMATE - not KiCad DRC; plane connections excluded
I2C0_SDA | Other control / sensor / keys | 4 | 3 | U2.26; U4.4; U5.4; R16.2 | STATIC ESTIMATE - not KiCad DRC; plane connections excluded
KEY_BACK | Other control / sensor / keys | 3 | 2 | SW4.1; SW4.2; R26.1 | STATIC ESTIMATE - not KiCad DRC; plane connections excluded
KEY_DOWN | Other control / sensor / keys | 3 | 2 | SW2.1; SW2.2; R24.1 | STATIC ESTIMATE - not KiCad DRC; plane connections excluded
KEY_OK | Other control / sensor / keys | 3 | 2 | SW3.1; SW3.2; R25.1 | STATIC ESTIMATE - not KiCad DRC; plane connections excluded
KEY_UP | Other control / sensor / keys | 3 | 2 | SW1.1; SW1.2; R23.1 | STATIC ESTIMATE - not KiCad DRC; plane connections excluded
LCD_3V3 | Display - model not frozen | 4 | 3 | J4.6; J4.7; U8.6; C29.1 | STATIC ESTIMATE - not KiCad DRC; plane connections excluded
LCD_EN | Display - model not frozen | 2 | 1 | U2.4; U8.3 | STATIC ESTIMATE - not KiCad DRC; plane connections excluded
LCD_PWM | Display - model not frozen | 2 | 1 | U2.3; U7.4 | STATIC ESTIMATE - not KiCad DRC; plane connections excluded
LCD_RST | Display - model not frozen | 2 | 1 | U2.2; J4.18 | STATIC ESTIMATE - not KiCad DRC; plane connections excluded
LEDA | Display - model not frozen | 3 | 2 | J4.20; D4.2; C27.1 | STATIC ESTIMATE - not KiCad DRC; plane connections excluded
LEDK | Display - model not frozen | 3 | 2 | J4.19; U7.3; R19.1 | STATIC ESTIMATE - not KiCad DRC; plane connections excluded
LX_3V3 | Other control / sensor / keys | 2 | 1 | U1.22; L1.1 | STATIC ESTIMATE - not KiCad DRC; plane connections excluded
LX_CORE | Other control / sensor / keys | 2 | 1 | U1.5; L2.1 | STATIC ESTIMATE - not KiCad DRC; plane connections excluded
LX_DRAM | Other control / sensor / keys | 2 | 1 | U1.8; L3.1 | STATIC ESTIMATE - not KiCad DRC; plane connections excluded
NAND_CLK | NAND | 2 | 1 | U2.57; U3.6 | STATIC ESTIMATE - not KiCad DRC; plane connections excluded
NAND_CS | NAND | 3 | 2 | U2.56; U3.1; R7.2 | STATIC ESTIMATE - not KiCad DRC; plane connections excluded
NAND_HOLD | NAND | 3 | 2 | U2.60; U3.7; R9.2 | STATIC ESTIMATE - not KiCad DRC; plane connections excluded
NAND_MISO | NAND | 3 | 2 | U2.58; U3.2; R28.2 | STATIC ESTIMATE - not KiCad DRC; plane connections excluded
NAND_MOSI | NAND | 6 | 5 | U2.59; U3.5; J3.7; SW6.1; SW6.2; R10.2 | STATIC ESTIMATE - not KiCad DRC; plane connections excluded
NAND_WP | NAND | 3 | 2 | U2.61; U3.3; R8.2 | STATIC ESTIMATE - not KiCad DRC; plane connections excluded
PMIC_BACKUP | PMIC control / power | 2 | 1 | U1.27; C39.1 | STATIC ESTIMATE - not KiCad DRC; plane connections excluded
PMIC_IRQ_N | PMIC control / power | 3 | 2 | U1.38; R3.2; U2.23 | STATIC ESTIMATE - not KiCad DRC; plane connections excluded
PMIC_SCL | PMIC control / power | 3 | 2 | U1.40; R4.2; U2.39 | STATIC ESTIMATE - not KiCad DRC; plane connections excluded
PMIC_SDA | PMIC control / power | 3 | 2 | U1.39; R5.2; U2.38 | STATIC ESTIMATE - not KiCad DRC; plane connections excluded
PWRON_N | Other control / sensor / keys | 5 | 4 | U1.30; SW5.1; SW5.2; J3.8; Q1.3 | STATIC ESTIMATE - not KiCad DRC; plane connections excluded
RTC_3V3 | Power / ground; zones excluded | 14 | 13 | U1.28; C33.1; U4.2; U4.9; U4.10; U5.7; U6.6; U6.7; U6.8; R11.1; R12.1; C24.1; C25.1; C26.1 | STATIC ESTIMATE - not KiCad DRC; plane connections excluded
RTC_EVI | Power / ground; zones excluded | 2 | 1 | U5.8; R14.1 | STATIC ESTIMATE - not KiCad DRC; plane connections excluded
RTC_INT_N | Power / ground; zones excluded | 4 | 3 | U2.24; U5.2; R17.2; D2.1 | STATIC ESTIMATE - not KiCad DRC; plane connections excluded
RTC_VBACKUP | Power / ground; zones excluded | 2 | 1 | U5.6; R13.1 | STATIC ESTIMATE - not KiCad DRC; plane connections excluded
SD_3V3 | SD | 3 | 2 | J5.4; Q3.3; C30.1 | STATIC ESTIMATE - not KiCad DRC; plane connections excluded
SD_CLK | SD | 3 | 2 | U2.8; J5.5; D9.1 | STATIC ESTIMATE - not KiCad DRC; plane connections excluded
SD_CMD | SD | 3 | 2 | U2.9; J5.3; D8.1 | STATIC ESTIMATE - not KiCad DRC; plane connections excluded
SD_D0 | SD | 3 | 2 | U2.7; J5.7; D10.1 | STATIC ESTIMATE - not KiCad DRC; plane connections excluded
SD_D1 | SD | 3 | 2 | U2.6; J5.8; D11.1 | STATIC ESTIMATE - not KiCad DRC; plane connections excluded
SD_D2 | SD | 3 | 2 | U2.11; J5.1; D6.1 | STATIC ESTIMATE - not KiCad DRC; plane connections excluded
SD_D3 | SD | 3 | 2 | U2.10; J5.2; D7.1 | STATIC ESTIMATE - not KiCad DRC; plane connections excluded
SD_DET | SD | 3 | 2 | U2.12; J5.9; D12.1 | STATIC ESTIMATE - not KiCad DRC; plane connections excluded
SD_PWR_EN | SD | 2 | 1 | U2.40; R21.1 | STATIC ESTIMATE - not KiCad DRC; plane connections excluded
SD_PWR_GATE | SD | 3 | 2 | Q3.1; R20.2; R21.2 | STATIC ESTIMATE - not KiCad DRC; plane connections excluded
SOC_AVCC | Power / ground; zones excluded | 2 | 1 | U2.48; C35.1 | STATIC ESTIMATE - not KiCad DRC; plane connections excluded
SOC_LDO_1V8 | Power / ground; zones excluded | 6 | 5 | U2.14; U2.37; U2.62; U2.79; C34.1; C37.1 | STATIC ESTIMATE - not KiCad DRC; plane connections excluded
STATUS_LED | Other control / sensor / keys | 2 | 1 | U2.41; R27.1 | STATIC ESTIMATE - not KiCad DRC; plane connections excluded
STATUS_LED_A | Other control / sensor / keys | 2 | 1 | D5.1; R27.2 | STATIC ESTIMATE - not KiCad DRC; plane connections excluded
UART0_RX | Other control / sensor / keys | 2 | 1 | U2.42; J3.4 | STATIC ESTIMATE - not KiCad DRC; plane connections excluded
UART0_TX | Other control / sensor / keys | 2 | 1 | U2.43; J3.3 | STATIC ESTIMATE - not KiCad DRC; plane connections excluded
USB_CC1 | USB | 3 | 2 | J1.A5; R1.1; D13.1 | STATIC ESTIMATE - not KiCad DRC; plane connections excluded
USB_CC2 | USB | 3 | 2 | J1.B5; R2.1; D14.1 | STATIC ESTIMATE - not KiCad DRC; plane connections excluded
USB_DM | USB | 5 | 4 | J1.A7; J1.B7; U9.3; U9.4; U2.77 | STATIC ESTIMATE - not KiCad DRC; plane connections excluded
USB_DP | USB | 5 | 4 | J1.A6; J1.B6; U9.1; U9.6; U2.76 | STATIC ESTIMATE - not KiCad DRC; plane connections excluded
VBAT | Power / ground; zones excluded | 3 | 2 | U1.33; C3.1; J2.1 | STATIC ESTIMATE - not KiCad DRC; plane connections excluded
VBUS | Power / ground; zones excluded | 5 | 4 | J1.A4; J1.A9; J1.B4; J1.B9; U1.37; U9.5; C32.1 | STATIC ESTIMATE - not KiCad DRC; plane connections excluded
VRA1 | Power / ground; zones excluded | 2 | 1 | U2.50; C36.1 | STATIC ESTIMATE - not KiCad DRC; plane connections excluded
VREF | Power / ground; zones excluded | 2 | 1 | U1.2; C11.1 | STATIC ESTIMATE - not KiCad DRC; plane connections excluded
VSYS | Power / ground; zones excluded | 12 | 11 | U1.6; U1.7; U1.23; U1.24; U1.34; U1.36; C1.1; C2.1; C38.1; C40.1; C41.1; U7.5; L4.1; C28.1 | STATIC ESTIMATE - not KiCad DRC; plane connections excluded
WAKE_CEXT | Other control / sensor / keys | 2 | 1 | U6.3; C23.2 | STATIC ESTIMATE - not KiCad DRC; plane connections excluded
WAKE_PULSE | Other control / sensor / keys | 3 | 2 | U6.1; Q1.1; Q2.1 | STATIC ESTIMATE - not KiCad DRC; plane connections excluded
WAKE_PULSE_N | Other control / sensor / keys | 2 | 1 | U2.45; Q2.3 | STATIC ESTIMATE - not KiCad DRC; plane connections excluded
WAKE_REQ_N | Other control / sensor / keys | 4 | 3 | U6.5; R11.2; D2.2; D3.2 | STATIC ESTIMATE - not KiCad DRC; plane connections excluded
WAKE_REXT | Other control / sensor / keys | 3 | 2 | U6.4; R12.2; C23.1 | STATIC ESTIMATE - not KiCad DRC; plane connections excluded
XIN | Other control / sensor / keys | 3 | 2 | U2.16; Y1.1; C12.1 | STATIC ESTIMATE - not KiCad DRC; plane connections excluded
XOUT | Other control / sensor / keys | 3 | 2 | U2.15; Y1.3; C13.1 | STATIC ESTIMATE - not KiCad DRC; plane connections excluded
