LeeSpo/portable-display-epass-EVT1-minboot-r1/portable-display/hardware/v0_legacy/verification/minboot_completion/README.md

# 布线过程证据

当前结论见 summary.json 和根目录 verification/latest_attempt.json。board_layers.png 是最终源 PCB 对应的原生重填铜皮预览。

本目录的 before、candidate、usb_candidate、round2 等 PCB 均为过程快照，只作追溯；请打开项目根目录的 portable_display_epass.kicad_pro。所有过程候选均不是制造输入。最终原生副本在 verification/native-20260905T074324Z-5a4357/checked_project。
