LeeSpo/portable-display-epass-EVT1-minboot-r1/portable-display/hardware/v1-WEB6-redesign/split-power-candidate/verification/preflight_review_20261009/usb_copper.png

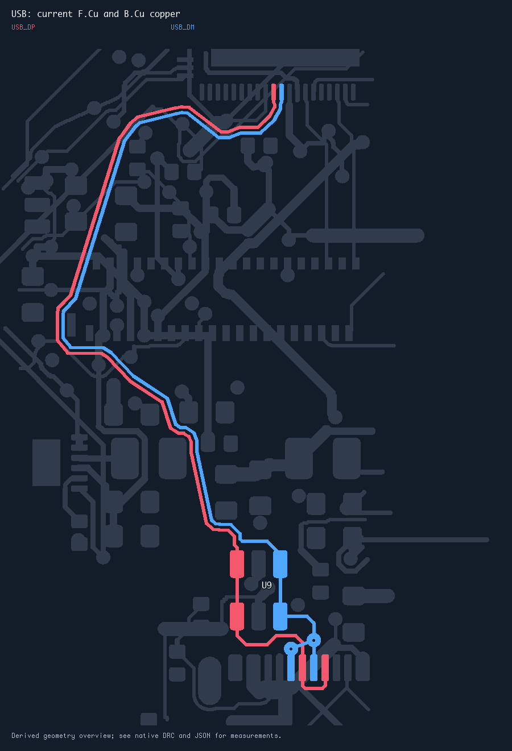
portable-display/hardware/v1-WEB6-redesign/split-power-candidate/verification/preflight_review_20261009/usb_copper.png
