LeeSpo/portable-display-epass-EVT1-minboot-r1/portable-display/hardware/v1-WEB6-redesign/split-power-candidate/verification/usb_routing_20261002/usb_before_after.png

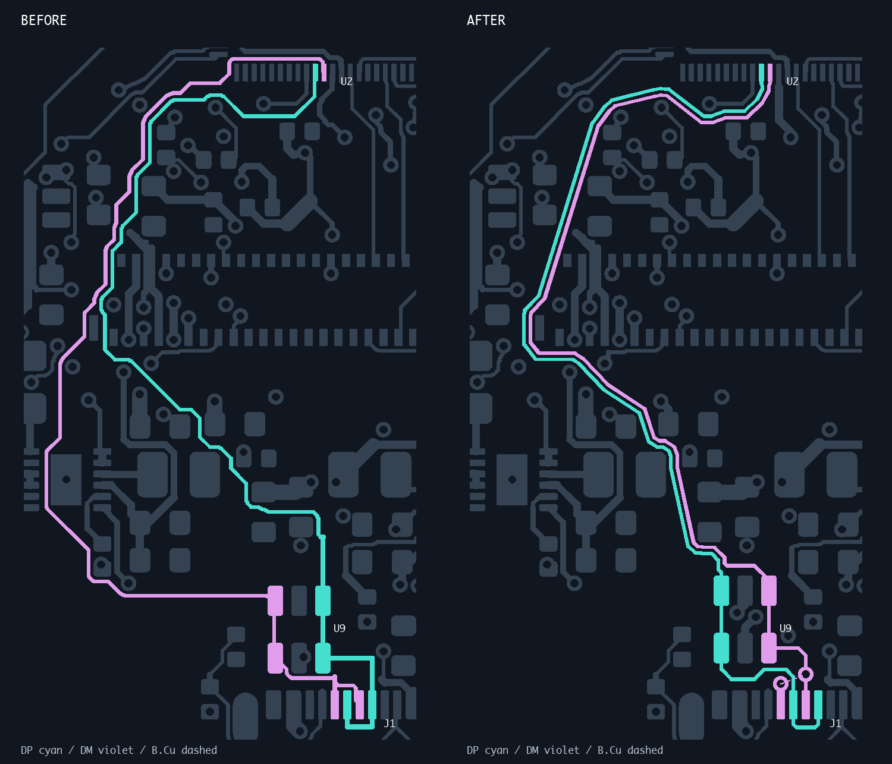
portable-display/hardware/v1-WEB6-redesign/split-power-candidate/verification/usb_routing_20261002/usb_before_after.png
