LeeSpo/portable-display-epass-EVT1-minboot-r1/verification/minboot_completion/F.Cu.png

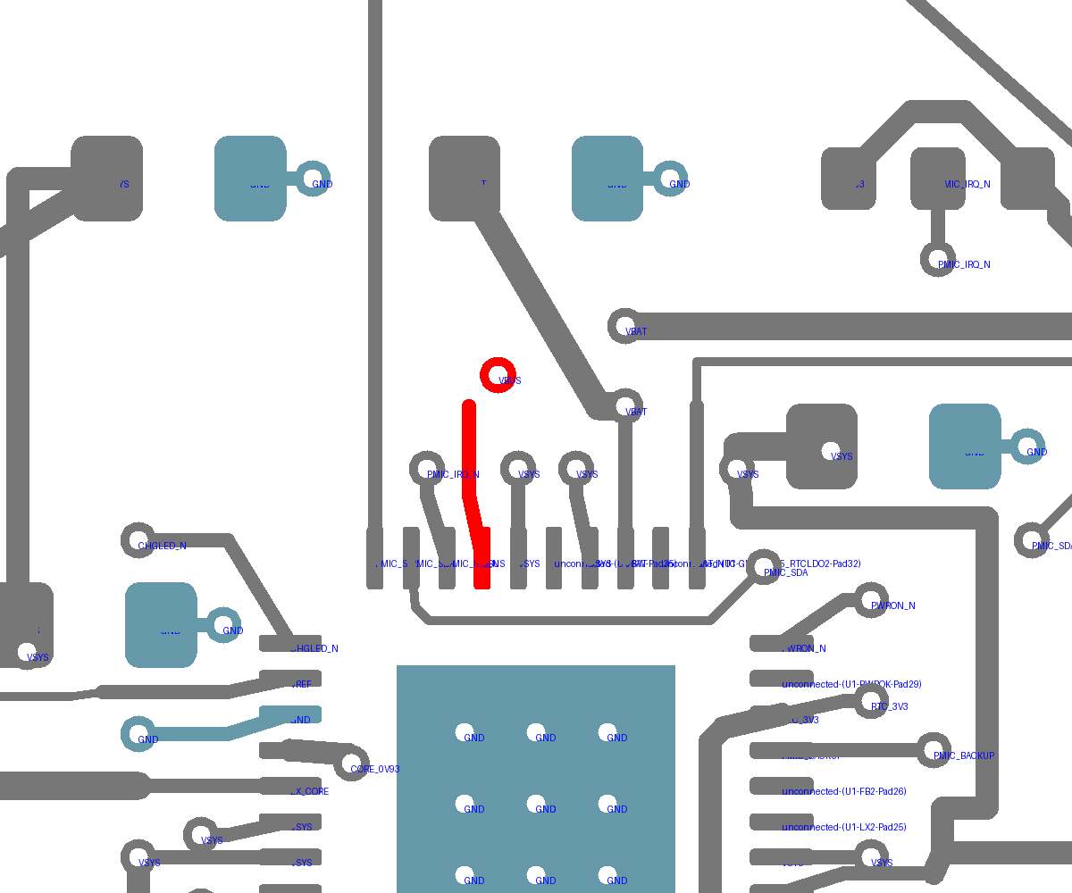
verification/minboot_completion/F.Cu.png
