LeeSpo/portable-display-epass-EVT1-minboot-r1/verification/minboot_completion/usb_back.png

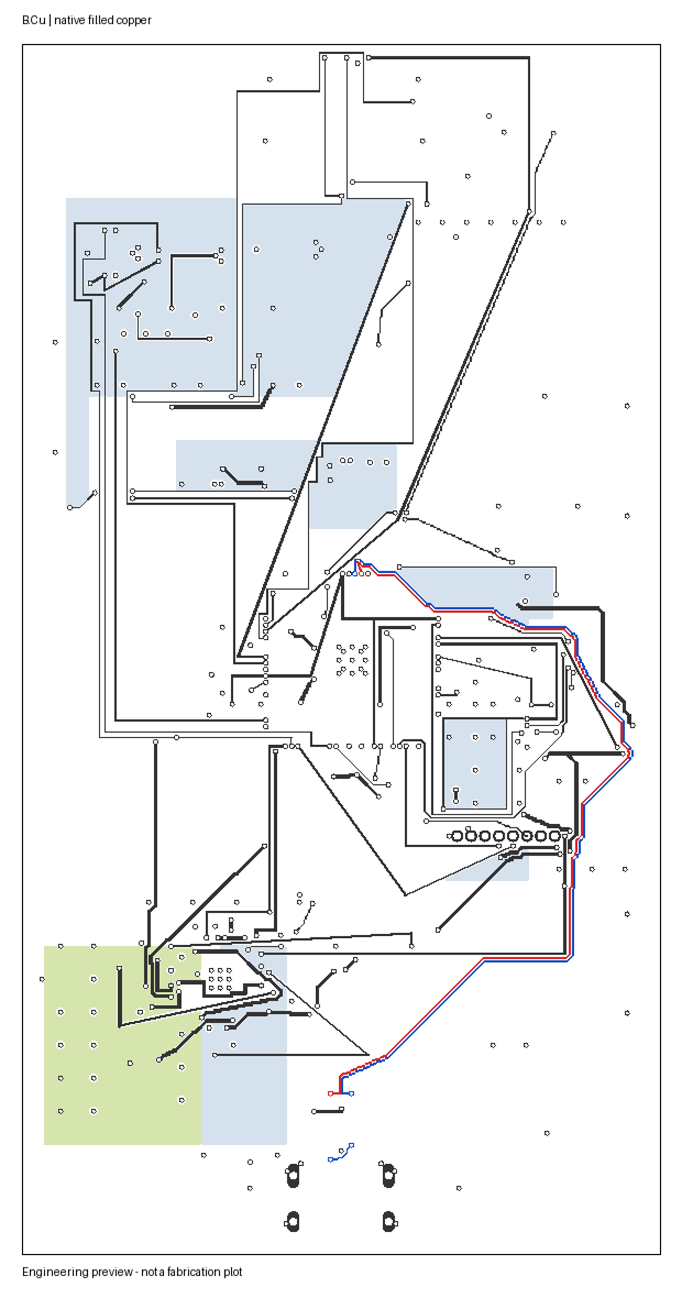
verification/minboot_completion/usb_back.png
