LeeSpo/portable-display-epass-EVT1-minboot-r1/verification/pcb_top_preview.png

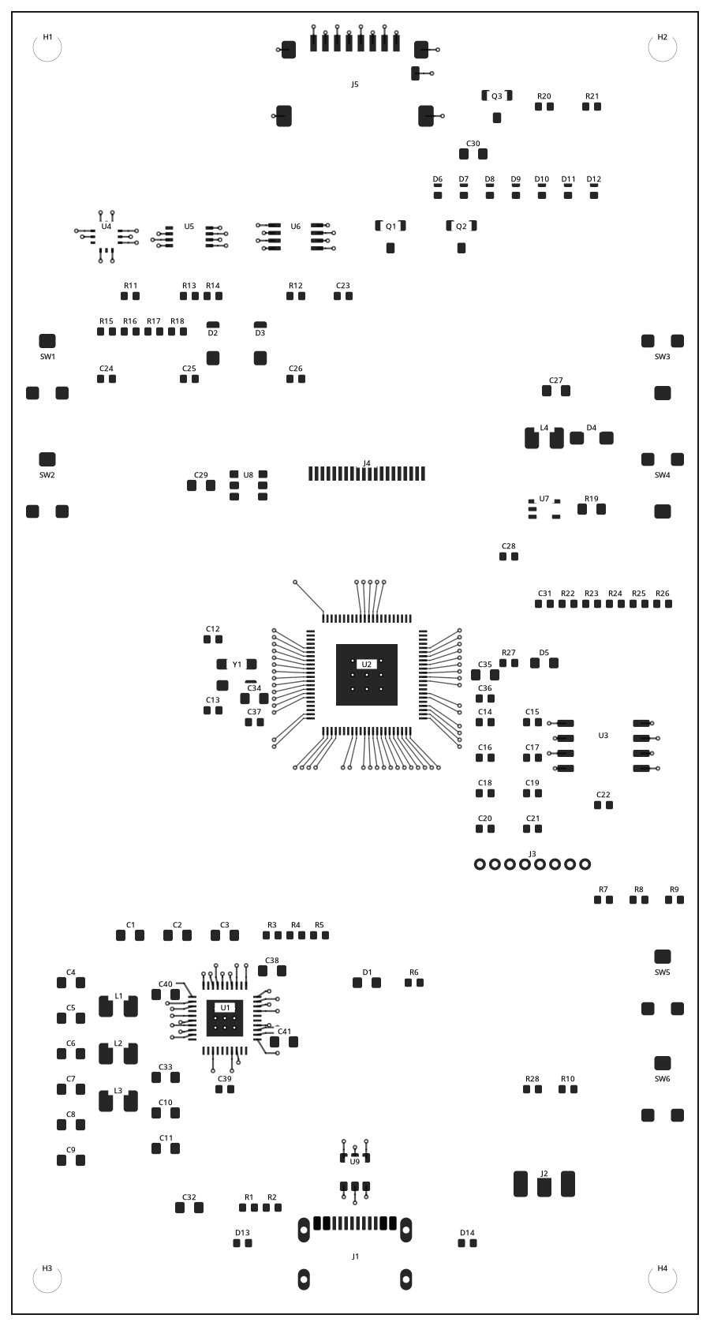
verification/pcb_top_preview.png
