LeeSpo/portable-display-epass-EVT1-minboot-r1/verification/u2_escape_preview.png

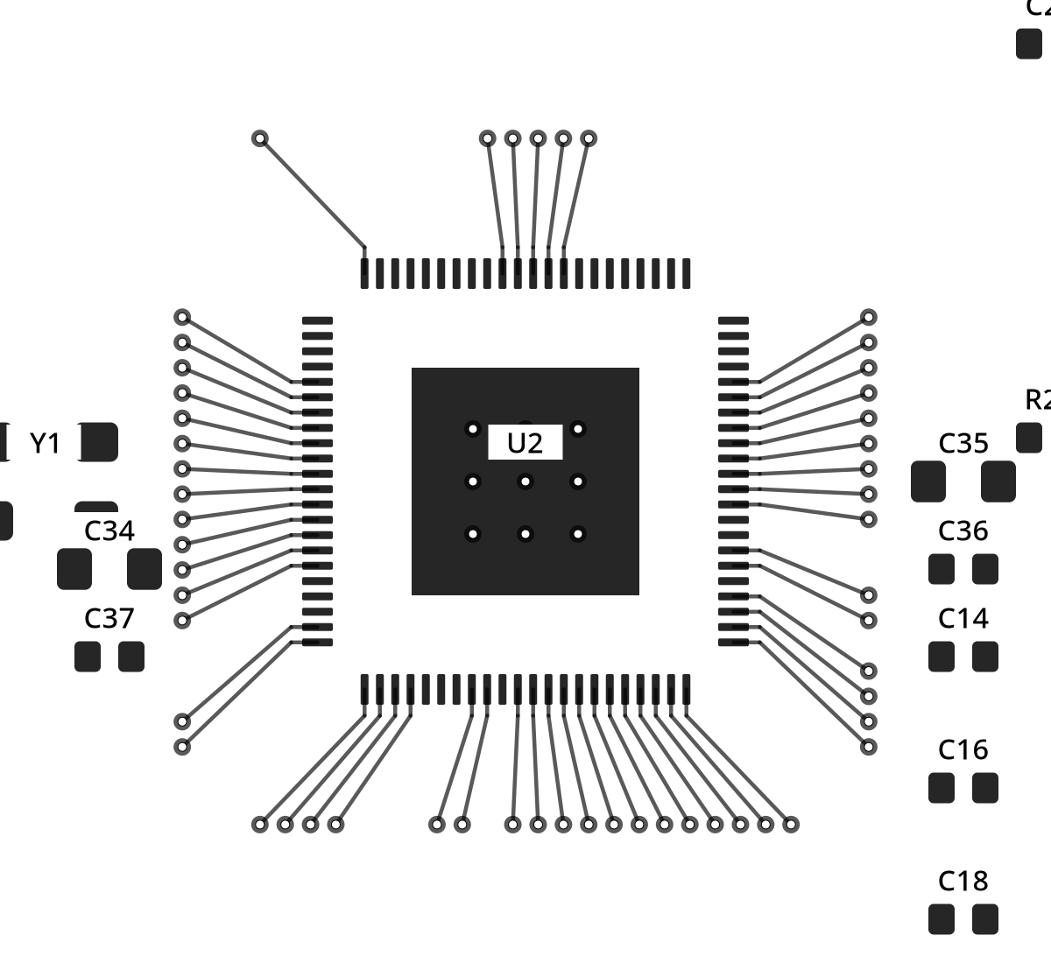
verification/u2_escape_preview.png
