LeeSpo/portable-display-epass-EVT1-minboot-r1/CHANGELOG.md

## 2026-09-05 最小系统布线闭合

- 补齐非显示信号和电源连接；原生 ERC / DRC / parity 无未解决项，保留 16 项显示未连接豁免。
- USB 主干并行布线；清理冗余过孔、悬空线段和丝印冲突。
- 静态 U2 逃逸检查支持实际同层焊盘连接，并新增断开 XIN 的负向测试。45 项测试通过。
- 未改变制造规则、显示豁免清单或人工放行项；未导出制造文件。

# EVT1-minboot-r1

基于上传根目录工作区；不是回退到旧 main。所有改变均为工程候选，原生与实物验证未通过。

- 本机 KiCad 10.0.6 首次跑通原生 ERC/DRC/覆铜重填。ERC 现为 0；庭院重叠、安装孔 extra footprint、NC 焊盘一致性已处理。
- 增加 `tools/route_minboot.py`：在现有 PCB 上追加电源缝合过孔、局部电源覆铜和部分非显示走线，不重生成整板。
- `PMIC_PWROK` 改为 no-connect；C34/R27 微移以消除庭院重叠。
- 接上 A* 走线并补 3V3/CORE/DRAM/VSYS/VBUS 局部覆铜。USB_DP、VSYS、NAND、多数 SD、PWRON 已连；USB_DM、PMIC_SDA、部分按键仍未连。原生检查仍未通过。

- 修复 PCB y-down 坐标系的旋转方向，以及旋转封装中的焊盘绝对角度。
- 按独立焊盘的物理连通链修正 U9 的 12 段走线、6 个过孔网络归属。
- U8 改为六脚 TPS22918，修正 CT/QOD/VOUT，原理图/PCB/库/引脚约定同步。
- 以单圈分散候选扇出替换 U2 原有 44 个非显示扇出，形成 54 个同网过孔连接。
- C34/C37 向左移动 0.5 mm；源生成器与实际 PCB 的其他电容位置同步。
- 修复残留 24 个重复铜线 UUID；路径补齐根原理图 UUID，补充层级实例记录。
- 清除过期覆铜填充缓存；辅助坐标原点设为 `(0,110)`，并明确坐标预览含义。
- 工程约束中最小铜间距设为 0.09 mm；若干连接/孔间距/一致性问题提升为 error，未降低规则绕过检查。
- 增加固定引脚约定、静态检查、原生验证隔离快照、哈希追踪、严格报表校验和人工发布门槛。
- 贴片坐标改从 PCB 导出，旧制造文件归档隔离。工程没有新的可投板 Gerber。
- 生成器不再默认写工程；整板重生成及旧坐标导出入口禁用。
- 子原理图使用 A2 纸张以容纳已有电路块；脚本标识如实标为第三方生成。
- 原文档与屏幕讨论移入 reference/original_notes，只作历史对照。
