LeeSpo/portable-display-epass-EVT1-minboot-r1/portable-display/hardware/v1-WEB6-redesign/split-power-candidate/OPEN_ISSUES_CN.md

# 未完成项与验收记录

更新：2026-10-18。**`fabrication_released = false`。**

PCB SHA-256：`514d29a0e2d06c731260da512aed54bfc88a098491cf9f4e367444c9fee9d8cc`。
最新结果见 [本轮验证](verification/current_20261018/README_CN.md)，对应生产预览见 [production_20261018](verification/production_20261018/README_CN.md)。

## 已完成的工程修改

既有 TF 默认供电、显示 1.8 V 电平、唤醒与中断隔离、PC1 FEL、U10 供电、隔离链接、J4 和指定叠层均保留。本轮新增 U2-47 独立去耦 C64、TP1–TP10、J2 电池线序丝印，改善 DSI D0N 拐角并外移三处非 EP 过孔，详见 [优化记录](OPTIMIZATION_20261018_CN.md)。BOM/CPL 为 131 颗，正面 117 / 背面 14。

旧保存铜皮与重新填铜不一致的问题已通过临时编辑副本受控填铜保存、源文件同步及重新导出处理。正式验证另在隔离副本运行，不保存维护源文件；保存铜皮和重新填铜的检查均保留，不再沿用旧生产包。

## 放行前必须确认

1. **PMIC 冷启动与批次 OTP。** C3036461 的 DCDC1/3/4、ALDO1、RTCLDO1 默认电压、使能和时序未获得证据；未用 DCDC2/5 的关闭状态也须确认。上电后 I²C 配置不能代替冷启动证据。见 [电源审查及询问稿](POWER_REVIEW_CN.md)。
2. **屏幕及机械接口。** J4 已选 502598-4593 / C5365339，但屏幕原规格所列连接器、排线触点面、针 1、折弯、支撑高度和插拔空间仍需实物核对。ELVDD/ELVSS 工作点尚未确认。见 [装配评估](../../../docs/SCREEN_STACK_CN.md)。
3. **装联资格和 POFV。** U1/U2 铜焊盘、EP、钢网分窗仍需钢网厚度、锡膏转移、空洞率、试焊及 X-Ray 验收。残留焊盘内过孔继续按全部 0.30 mm 孔树脂塞孔并电镀封帽处理，须由制造商确认。新包未取得工厂 DFM 与贴装方向签核。
4. **高速信号和实际阻抗。** USB 0.127/0.140、DSI CK 0.100/0.150 mm 来自指定叠层估算，尚无场求解及阻抗测试条结果。DSI D0N 的直角已改善，但 D0 仍是两根独立走线，等长不等于高速合格。USB 正反插高速、ESD 和实板点屏仍待验收。
5. **供电、回流与去耦。** U2-47 已增加独立 C64；连通和局部缩短不证明电源完整性、峰值载流、压降或温升。SOC_AVCC 局部细颈与内层跨接需结合铜厚、负载及噪声实测评估。
6. **功能及固件配合。** TF 冷启动/关断/重初始化，PA8 RESET 和 PA9 TE 的固件迁移，RTC 保持，锁存中断、关机漏电和重复唤醒均未完成实板验证。唤醒名义约 3 s，偏压/温度/批次下 2.2–3.8 s 窗口仍须实测，连续触发必须避免误关机。
7. **BOM 与装配方向。** 料号和导出一致不证明采购批次、实物封装或贴装方向合格。CPL 为 KiCad 原始旋转角，须按 [下单说明](ORDERING_GUIDE_CN.md)核对极性和针 1；保持全部功能器件由工厂贴装。

## 后续布局评估

结合首板波形、阻抗和温升评估 DSI D0 重新耦合及供电回流。U12/U13 暂不向 J5 移动：当前卡座机械占位限制了可用空间，后续须连同卡座/机构重新评估。

历史决策见 [PREFLIGHT_DECISIONS_CN.md](PREFLIGHT_DECISIONS_CN.md)及各修复说明；旧报告通过 [恢复索引](../../../docs/PROJECT_STATUS_CN.md)访问，不再作为当前结果。
