LeeSpo/portable-display-epass-EVT1-minboot-r1/portable-display/hardware/v1-WEB6-redesign/split-power-candidate/TF_POWER_REPAIR_CN.md

# TF 默认上电修复

> 历史工程决策记录：器件数量、哈希、图片和检查结果对应各段原日期。当前状态见 [README](README_CN.md)、[未完成项](OPEN_ISSUES_CN.md)及本轮验证；旧报告从固定 Git 提交读取。

2026-09-21，修订 TF-ON1。已修改候选 PCB、原理图及独立连接/阻值检查。此项关闭的是“主控复位高阻时，TF 被上拉栅极默认关断”的电路问题；实板启动尚未验证。第一项的 AXP2101 平台料默认配置仍待确认。

## 电路与控制

| 项目 | 修改前 | 修改后 |
|---|---|---|
| R20 | 100 kΩ，3V3 → SD_PWR_GATE | 10 kΩ，GND → SD_PWR_GATE；采购要求 1% |
| R21 | 10 kΩ，PH12 → SD_PWR_GATE | 100 Ω，PH12 → SD_PWR_GATE；采购要求 1% |
| Q3 | AO3401A，S 接 3V3、D 接 SD_3V3 | 保留，G 接 SD_PWR_GATE |

供电关系：3V3 → Q3 → SD_3V3 → J5.4；U2.40（PH12）经 R21 控制栅极。沿用网络名 `SD_PWR_EN`，其控制极性为低有效。

| PH12 状态 | 预期行为（3V3 已正常建立） |
|---|---|
| 复位高阻、无上拉 | R20 拉低栅极，TF 默认有电 |
| 输出低电平 | Q3 导通，TF 有电 |
| 输出高电平 | Q3 关断；卡侧残压取决于负载和其他引脚，不能保证瞬间为 0 V |

V851S 数据手册给出的 GPIO 高阻漏电流上限为 ±10 µA、VOH 下限为 VCC-IO−0.2 V。采用 10 kΩ 下拉，可将该漏电流引起的栅极抬升限制在约 0.10 V；保留原来的 100 kΩ 下拉则可能达到约 1 V。复位默认状态按 PH12 高阻设计，启动固件不得在卡初始化前启用 PH12 上拉或输出高电平。

3.3 V、理想高电平时，100 Ω/10 kΩ 分压使栅极约为 3.267 V，VGS 约 −0.033 V，静态电流约 0.327 mA（约 1.08 mW）。按 1% 阻值、3.0–3.6 V 供电范围作为计算条件，计入 VOH 最大 0.2 V 压降，关断时 |VGS| 约不超过 0.235 V；高阻时计入 GPIO 10 µA 和 MOS 栅漏 0.1 µA，3.0 V 下 |VGS| 仍约为 2.898 V。3.0–3.6 V 是本项裕量计算范围，不是对平台 PMIC 默认输出的确认。

AO3401A 的 RDS(on) 在 VGS=−2.5 V 下有规格；VGS(th) 的绝对值最小为 0.5 V（250 µA 测试条件）。阈值只用于关断趋势判断，不能当作充分导通条件，也不能证明卡侧无漏电或已放电。实际浪涌、压降和时序仍需测量。

依据：[AOS AO3401A 官方数据手册](https://www.aosmd.com/res/data_sheets/AO3401A.pdf)；[全志开发者社区提供的 V851S/V851SE 数据手册](https://bbs.aw-ol.com/assets/uploads/files/1664112156052-c55b9458-9847-4731-873e-c98d352589ea-v851s-amp-v851se_datasheet_v0.1.pdf)，GPIO DC 参数见印刷页 28（PDF 第 42 页）。

## PCB 与验证

R20 原 3V3 焊盘同时承担电源转接，不能只改网络名。现将该焊盘及原过孔改为 GND，绕开该焊盘重接顶层 3V3；原底层电源跨接改走 In2.Cu，新增一个 0.60/0.30 mm 3V3 过孔（25.4, 38.3），不在 SMD 焊盘内。所有器件位置、封装尺寸和其他信号走线保持不变；In1.Cu 仍无信号走线。

原生 KiCad 10.0.6 检查：DRC 0 违规、0 未连接、0 原理图一致性问题；ERC 0 违规。核对 115 个电气器件、489 个编号焊盘、84 项独立引脚约束和全部 115 个器件值，结果一致。另用“R20 恢复上拉”和“R21 恢复 10 kΩ”两种故障验证检查器，均被拒绝。未降低规则或新增豁免。

报告在 [verification/tf_power_20260921/](https://github.com/LeeSpo/portable-display-epass-EVT1-minboot-r1/tree/b14e0fbead4cc5602254eedcb0fa77d3e3236ec2/portable-display/hardware/v1-WEB6-redesign/split-power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)：`drc.json`、`erc.json`、`netlist.xml`、`power_audit.json`、`change_audit.json`、`negative_checks.json`、`provenance.json`。本次 PCB SHA-256：`05af2af6138012e6b749530d8bcedb3d7fa88d8564eebb4ffb727f2124159fbb`。旧报告仅用于追溯。四层预览已更新。

## 固件与实板验收

1. 上电保持 PH12 高阻且无上拉，或输出低；若使用 GPIO 控制的固定稳压器节点，应配置为低有效、启动默认开启。当前工程没有对应固件可同步修改。
2. 完全断电后冷启动，用示波器同时观察 3V3、SD_3V3、PH12 和 SD_CLK，确认卡电源先稳定，再发生初始化通信；测试多次启动和不同 TF 卡。
3. 软件关卡电源前先卸载文件系统、停止 SD 控制器，并将 CLK/CMD/DAT 配置为不会向断电卡灌电的状态，再拉高 PH12。复核断电残压、漏电及重新初始化。
4. 若平台 PMIC 默认未提供正常 3V3/其他必要电源，本修复仍不能让整板启动；必须同时关闭第一项遗留的出厂配置和冷启动验证问题。
