LeeSpo/portable-display-epass-EVT1-minboot-r1/portable-display/hardware/v1-WEB6-redesign/split-power-candidate/USB_ROUTING_REPAIR_CN.md

# USB 差分布线修复

> 历史工程决策记录：器件数量、哈希、图片和检查结果对应各段原日期。当前状态见 [README](README_CN.md)、[未完成项](OPEN_ISSUES_CN.md)及本轮验证；旧报告从固定 Git 提交读取。

更新：2026-10-02。主 PCB SHA-256：`c60d34a61d91977091526055a69a3e2fe428a5c76689d51b27c738f2bd9dcb34`。

**USB 布线候选已写回主工程并同步原理图。** 原生 ERC、DRC、未连接及原理图一致性检查均为 0 问题。此结论只覆盖连接与几何；90 Ω 阻抗、USB 高速通信和系统 ESD 尚未实测，整板尚未投板放行。MIPI 本次未修改。

[查看走线对照预览](https://github.com/LeeSpo/portable-display-epass-EVT1-minboot-r1/tree/b14e0fbead4cc5602254eedcb0fa77d3e3236ec2/portable-display/hardware/v1-WEB6-redesign/split-power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)。

## 电路和布局变化

- U2.76 / USB_DP 仍接 J1.A6、B6；U2.77 / USB_DM 仍接 J1.A7、B7，数据极性不变。
- U9 的等效保护通道对调：I/O2（3、4）用于 DP，I/O1（1、6）用于 DM；GND（2）和 VBUS（5）不变。器件仍为 USBLC6-2SC6。其厂家功能图明确了这两组通道，采用此映射是本板的布线选择。[ST 数据手册，首页及第 6、11 页](https://www.st.com/resource/en/datasheet/usblc6-2.pdf)
- 主干在 F.Cu 成对布线，线宽 0.127 mm，直线段边到边间距 0.130 mm；转弯和焊盘扇出另经原生间距检查。成对中心路径约 30.90 mm。CPU 到 ESD 的两根线路按 0.253–0.270 mm 中心距离采样，分别约 94.7% / 90.9% 具有邻近配对线；这是几何指标，不是电磁耦合仿真。
- J1.B7 重复触点采用 1.0698 mm 的 B.Cu 短支路、两颗 0.60/0.30 mm 通孔，位置为 (18.25, 56.88) 与 (19.25, 56.50) mm。主干与 A6/A7 路径无换层。DP 的 A6/B6 在连接器焊盘后方短接。重复触点支路仍须纳入实板正反插测试。
- U9 向板内移动 0.40 mm 至 (16.825, 54.30)；C47 向右移动 0.30 mm 至 (14.55, 46.475)，器件值不变。U2.78 到原 3V3 过孔的局部引出线重布；C47 的 VSYS 连接接回原过孔；LCD_TE 的过孔由 (10.90, 44.05) 移至 (11.20, 44.05)。
- U9 的 GND/VBUS 局部连接使用 0.30 mm 铜线，VBUS 原焊盘内过孔移出。增加 U9 接地过孔 (16.50, 54.03)，以及 USB 支路附近的接地过孔 (18.55, 54.95)。没有新增钻孔与 SMD 焊盘相交；全板此类交叠由 39 处 / 38 个过孔降为 38 处 / 37 个过孔，其余装联问题仍未关闭。

## 端到端长度

按实际走线图计算 U2 焊盘中心到对应 J1 焊盘中心的最短铜路径，不能用整条网络的总铜长代替。下表的修复后 B 方向 D− 长度包含两次 F/B 换层，各按工程当前名义板厚 **1.0 mm** 计；它是几何长度估算，不是传播时延或眼图结果。

| 插入方向对应触点 | 修复前 D+ / D−（mm） | 修复前差值 | 修复后 D+ / D−（mm） | 修复后差值 |
|---|---:|---:|---:|---:|
| A6 / A7 | 43.4277 / 44.5344 | 1.1067 | 40.2102 / 39.8067 | **0.4036** |
| B6 / B7 | 40.6677 / 43.7740 | 3.1062 | 42.8738 / 42.4964 | **0.3773** |

B7 路径的平面铜长单独为 40.4964 mm，加上两次 1.0 mm 过孔得到 42.4964 mm。实际板厚、过孔与 F/B 层传播速度改变时必须重新评估。本次独立检查采用不超过 1 mm 的名义几何差值目标；它不是 USB 协议认证限值。USB 2.0 的 90 Ω 差分阻抗和长度匹配原则参考 [TI USB 布局说明](https://www.ti.com/video/6087491555001)及[高速布局指南](https://www.ti.com/lit/an/slla414/slla414.pdf)。

## 验证和边界

- 120 个封装、116 个电气器件、491 个编号焊盘；仅 U9 的四个数据焊盘更换网络，126 个独立指定引脚及原理图网表比对通过。器件属性/数值、其余封装、MIPI 和其他非关联铜线均保持原样；板级规则和铜区边界未改。
- F.Cu 的参考层为 In1.Cu 地；B.Cu 短支路下方为 In2.Cu 地。排除 USB 信号过孔自身的 0.44 mm 半径避空窗口后，中心线未跨越参考地缺口；这项二维检查不代表完整回流场或阻抗分析。新增支路附近接地过孔距两个信号过孔约 1.70 / 1.95 mm。
- GND、VBUS、各复查电源、RESET/TE、唤醒定时与 PWRON 焊盘均为单一连通组。新增 USB 检查能拒绝保护通道接错、重复触点支路断线、线宽变更及 U9 未装配四类故障注入。
- 当前线宽/线距是已通过几何检查的候选参数。尚无嘉立创实际层叠、介质厚度/介电常数、成品铜厚或阻抗控制单，不能据此宣称已实现 90 Ω。确定层叠后须重新计算并必要时调整线宽、线距及局部避让。
- 实板需分别验证 Type-C 正反插的枚举、480 Mb/s 模式、持续传输与插拔；系统 ESD、连接器装配和参考地/电源噪声也需验收。PMIC C3036461 默认配置与冷启动、MIPI 差分、显示电源和其他未完成项仍见 [OPEN_ISSUES_CN.md](OPEN_ISSUES_CN.md)。

原生报告、独立检查、变化审计和哈希记录均在 [verification/usb_routing_20261002/](https://github.com/LeeSpo/portable-display-epass-EVT1-minboot-r1/tree/b14e0fbead4cc5602254eedcb0fa77d3e3236ec2/portable-display/hardware/v1-WEB6-redesign/split-power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)。`tools/check_usb_routing.py` 可复跑；检查通过不表示 `impedance_verified`、`hardware_verified` 或 `fabrication_released`。

## 2026-10-15 更新：阻抗几何

- 叠层定为 JLC04101H-3313：L1→L2 是 0.0994 mm 的 3313 半固化片，εr 4.1。
- U2 到 U9 这一段重布成 0.127/0.140 mm 的耦合线对，中心距 0.267 mm。按 IPC-2141 公式计算并用 JLC 数据校准后约 89 Ω。
- `tools/check_usb_routing.py` 的中心距窗口相应改成 0.262–0.287 mm，门槛仍是 ≥90%。
- 计算过程见 PREFLIGHT_DECISIONS_CN.md。
