LeeSpo/portable-display-epass-EVT1-minboot-r1/portable-display/hardware/v1-WEB6-redesign/split-power-candidate/WAKE_PULSE_REPAIR_CN.md

# 自动唤醒脉宽修复

> 历史工程决策记录：器件数量、哈希、图片和检查结果对应各段原日期。当前状态见 [README](README_CN.md)、[未完成项](OPEN_ISSUES_CN.md)及本轮验证；旧报告从固定 Git 提交读取。

2026-10-04 补充：中断上拉及跨主控电源域的连接已另行修复，见 [唤醒电源域修复](WAKE_DOMAIN_REPAIR_CN.md)。本记录的 R12 / C23 名义定时和实板验收要求继续适用。

2026-10-01。已完成定时电路候选修改及静态检查；实际脉宽、批次容差和整机唤醒尚未验收。

## 修改结果

| 器件 | 原值 | 当前值 / 平台料 |
|---|---|---|
| R12 | 820 kΩ，未绑定料号 | 910 kΩ ±1%，0402；RESI AECR0402F910KK9，C352384 |
| C23 | 100 nF，0402 | 3.3 µF ±10%，25 V X7R，0805；CCTC TCC0805X7R335K250FT，C7393948 |

C23 移至 (32.00, 6.35) mm，使用随工程保存的 `Sameat:C_0805_2012Metric` 封装。该封装来自 KiCad 标准库；焊盘 1.00×1.45 mm，中心间距 1.90 mm。已检查与安装孔及邻近器件的装配边界。平台料号已写入原理图和 PCB；以上为平台选型，未下单或锁定库存。

U6 保持 SN74LVC1G123DCTR：1=A、2=B、3=CLR、4=GND、5=Q、6=CEXT、7=REXT/CEXT、8=VCC。B、CLR、VCC 接 RTC_3V3；A 收到低有效中断下降沿后，Q 经 Q1 拉低 AXP2101 的 PWRON_N。Q2 同时拉低主控 PH0 / U2.45 的 WAKE_PULSE_N，它不是主控复位引脚。

R12 从 RTC_3V3 接到 U6.7；C23 跨接 U6.7 与 U6.6，不能把 CEXT 端改接地。仅重布 WAKE_REXT / WAKE_CEXT；其余器件位置、引脚网络、走线和电源区定义保持。铺铜已重新填充。

## 脉宽选择与边界

[AXP2101 厂家手册 V1.4](https://wiki.lilygo.cc/datasheet/AXP2101_Datasheet_V1.4_en.pdf) 第 19–20 页及第 38 页 REG27：PWRON 开机门限有 128 ms、512 ms、1 s、2 s 四档，默认来自 EFUSE；长按关机门限最短为 4 s。因此不能只围绕 128 ms 修改。

依据 [TI SN74LVC1G123 手册](https://www.ti.com/lit/ds/symlink/sn74lvc1g123.pdf) 第 9、15 页的典型定时曲线，以 K≈1 作初选，t≈KRC：原值约 82 ms，当前名义值约 3.003 s。R12 小于 1 MΩ，符合 [TI 对定时电阻漏电限制的建议](https://e2e.ti.com/support/logic-group/logic/f/logic-forum/992841/sn74lvc1g123-operation)。

只计 R ±1%、C ±10%，估算为 2.676–3.336 s；再单独叠加 X7R ±15% 温度变化，约为 2.274–3.837 s。这些数值**不是保证的最坏情况范围**，尚未覆盖电容偏压/老化、U6 系数和漏电、板面漏电及电源变化。25 V 额定值也不证明电容在 3.3 V 下没有衰减。现有资料不足以证明全温全批次满足 2–4 s，必须测量后确认或调整选型。

工程实测验收窗口设为 **PWRON_N 连续低电平 2.2–3.8 s**，给 2 s 开机和 4 s 关机门限留余量。这是验收要求，不是本次测量结果。RTC_3V3 需在关机时有效且维持 3.0–3.6 V；U1.30 必须配置为 PWRON，定制 EN 模式不适用。第一项 PMIC 出厂供电配置依然待确认。

## 中断及固件约束

U6 可重复触发，新的有效边沿会延长输出；本次没有增加硬件脉宽上限。RTC/加速度计必须配置为低有效、锁存中断，避免周期脉冲或抖动持续触发。主控应在初始化时读取唤醒原因，先屏蔽对应中断源，等待脉冲结束后清除并重新使能；两个来源先后触发也需验证。若产品必须在持续触发下硬性保证不超过 4 s，需另加不可重触发的定时/限宽电路，本项不能作为该功能已实现的证明。

固件还需识别自动唤醒产生的按键事件，避免把约 3 s 的合成按键当作用户关机请求。本仓库没有可直接同步的固件实现。这条路径是 PWRON 开机及主控 GPIO 通知，不等于已验证 AXP2101 的 REG26 睡眠恢复流程。

## 检查与实板验收

KiCad 10.0.6：ERC、DRC、未连接、原理图一致性均为 0 问题。116 个电气器件、491 个编号焊盘逐项一致，独立约束覆盖 114 个引脚；定时值、料号和封装已加入检查。负向检查能拒绝旧阻容值、缺失 C23 料号或 U6 不装配。

复查 GND、电源、显示及唤醒网络均为单个焊盘连通组；新增 4 个定时网络过孔均未与 SMD 焊盘钻孔相交。此前 TF 和屏幕电平修改保持。原生铺铜重新计算引起较多文件文本差异，语义比对确认其余网络走线不变。报告位于 [verification/wake_pulse_20261001/](https://github.com/LeeSpo/portable-display-epass-EVT1-minboot-r1/tree/b14e0fbead4cc5602254eedcb0fa77d3e3236ec2/portable-display/hardware/v1-WEB6-redesign/split-power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)。

实板应分别用 RTC 和加速度计触发，示波器同时观察 RTC_3V3、WAKE_REQ_N、WAKE_PULSE、PWRON_N 和主电源，检查低电量/温度/批次条件下的 2.2–3.8 s 窗口、可靠开机、松开和连续触发行为。包含已开机时触发及两个来源交错触发，确认不会长按关机。若不满足窗口，应调整 R12/C23 或定时方案后重测，不能只凭名义 RC 放行。

选型依据：[R12 嘉立创页面](https://jlcpcb.com/partdetail/RESI-AECR0402F910KK9/C352384)、[C23 嘉立创页面](https://jlcpcb.com/partdetail/CCTC-TCC0805X7R335K250FT/C7393948)。
