LeeSpo/portable-display-epass-EVT1-minboot-r1/portable-display/hardware/v1-WEB6-redesign/split-power-candidate/verification/u1u2_repair_20260919/topright.png

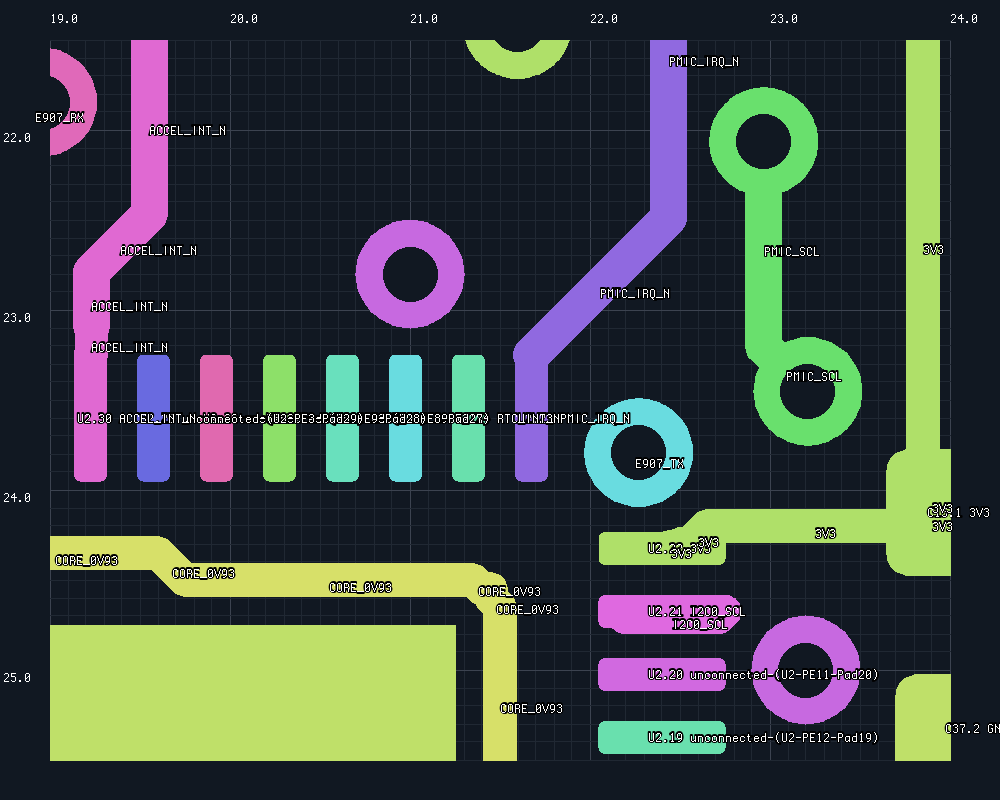
portable-display/hardware/v1-WEB6-redesign/split-power-candidate/verification/u1u2_repair_20260919/topright.png
