LeeSpo/portable-display-epass-EVT1-minboot-r1/portable-display/hardware/v1-WEB6-redesign/split-power-candidate/ak_display_38x64_SPLIT_POWER_CANDIDATE.kicad_pcb

## KiCad design portable-display/hardware/v1-WEB6-redesign/split-power-candidate/ak_display_38x64_SPLIT_POWER_CANDIDATE.kicad_pcb (2026-10-18)

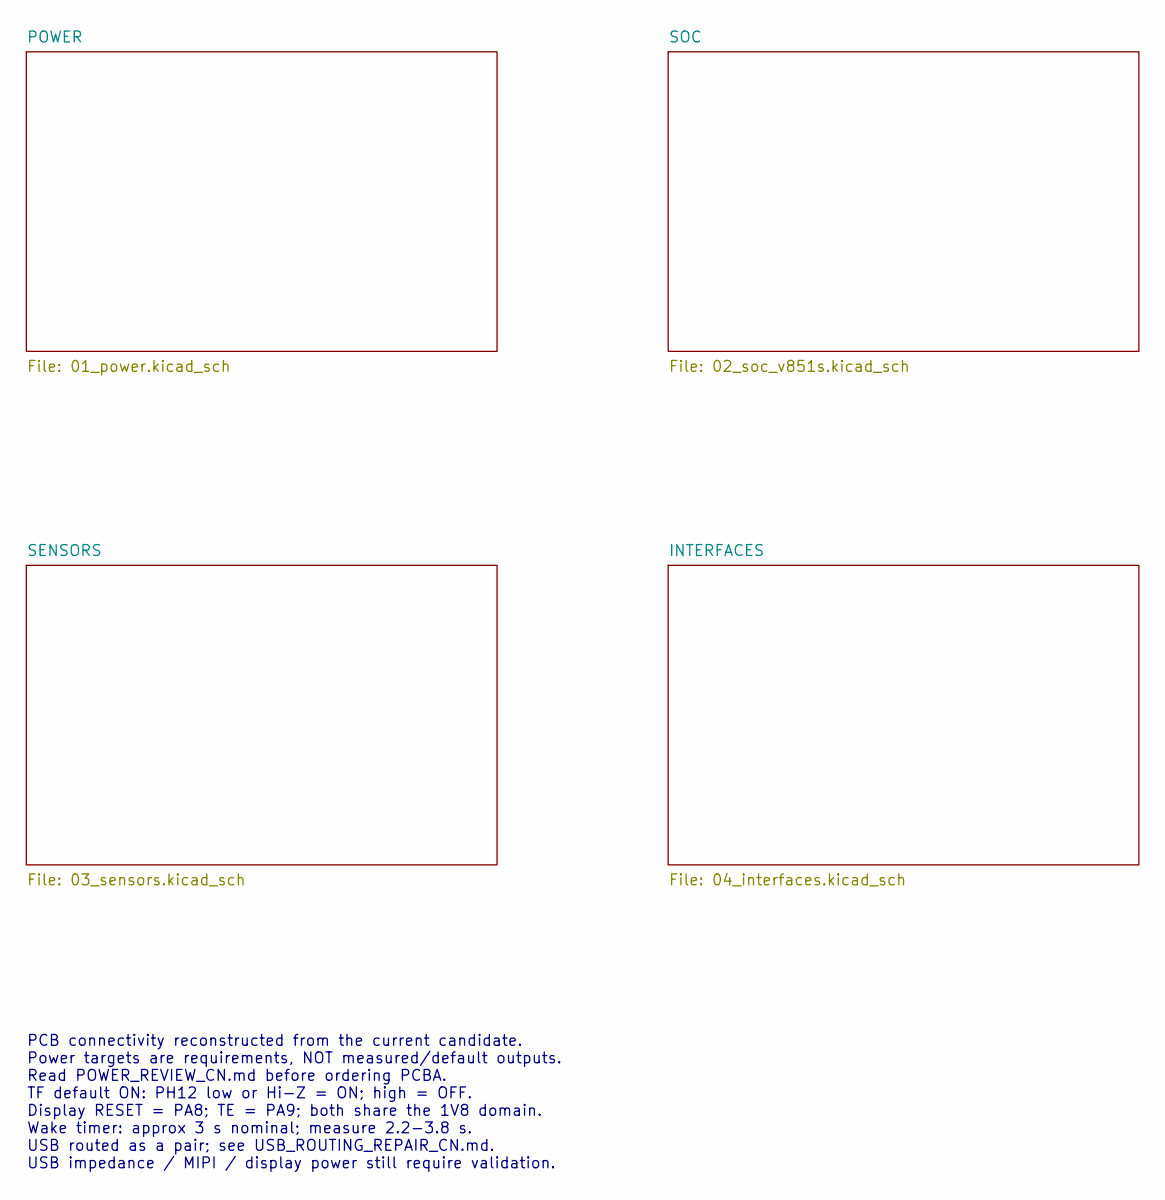
[picture p18: schematic ak_display_38x64_SPLIT_POWER_CANDIDATE.kicad_sch, 38x64 split-power candidate - connectivity schematic]

Notes on the sheet:
PCB connectivity reconstructed from the current candidate. Power targets are requirements, NOT measured/default outputs. Read POWER_REVIEW_CN.md before ordering PCBA. TF default ON: PH12 low or Hi-Z = ON; high = OFF. Display RESET = PA8; TE = PA9; both share the 1V8 domain. Wake timer: approx 3 s n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

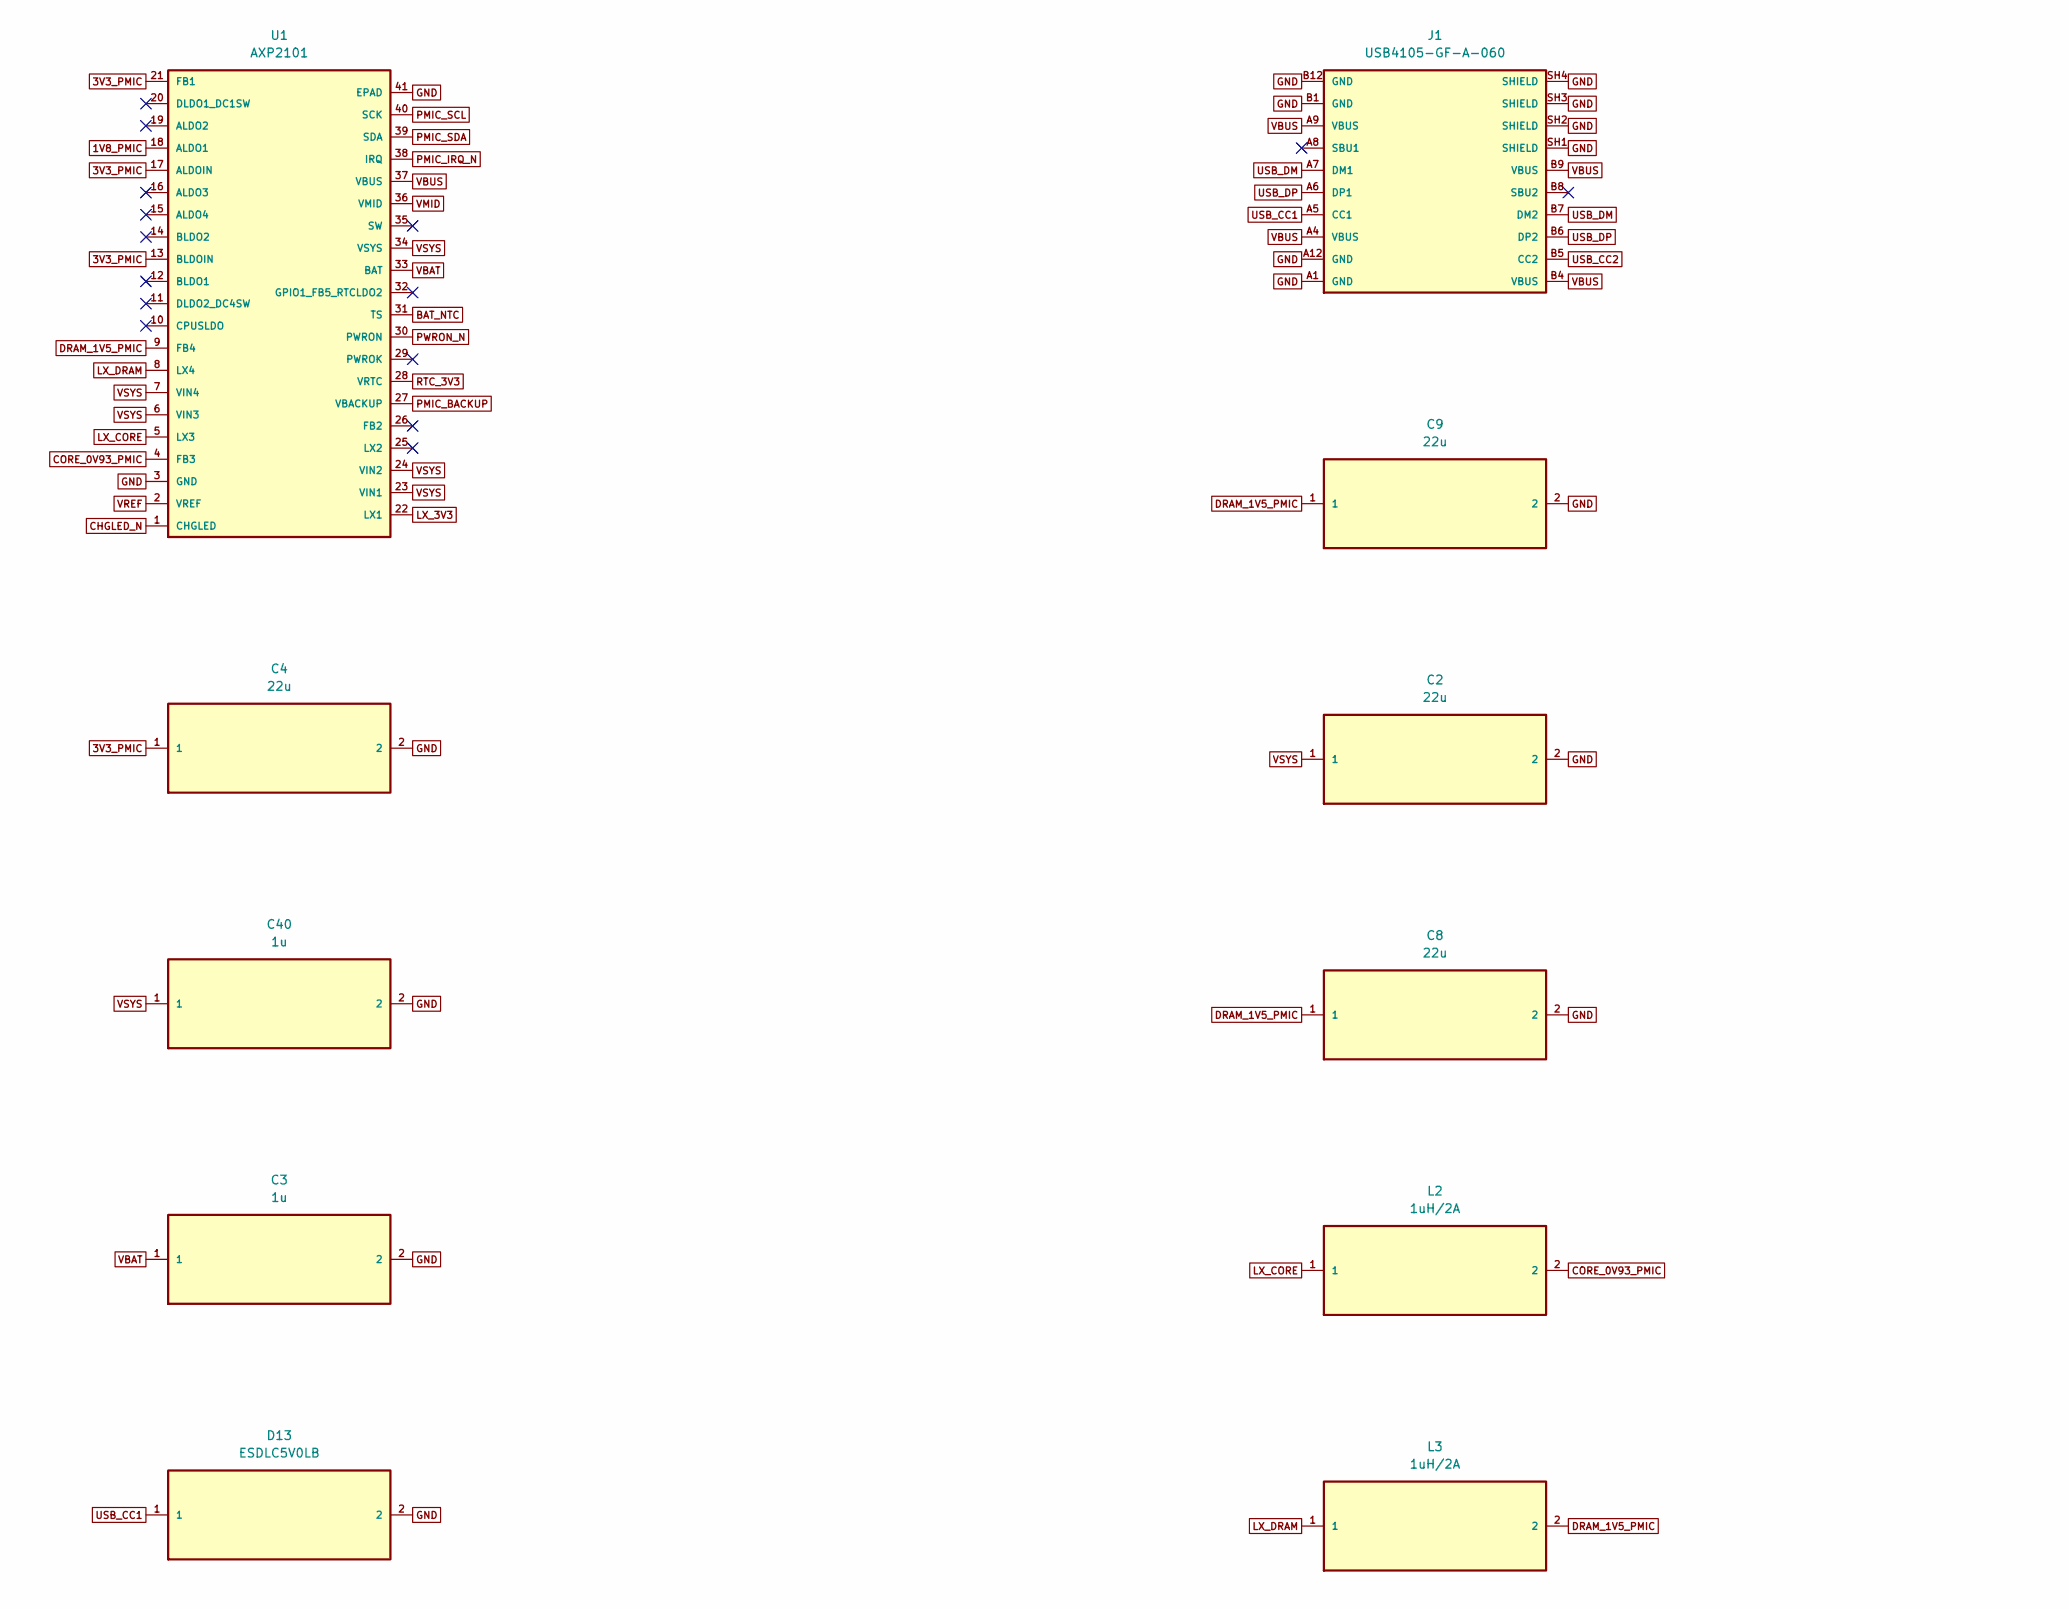
[picture p19: schematic 01_power.kicad_sch, 01 Power / Charger / PMIC, part in row 1, column 1]

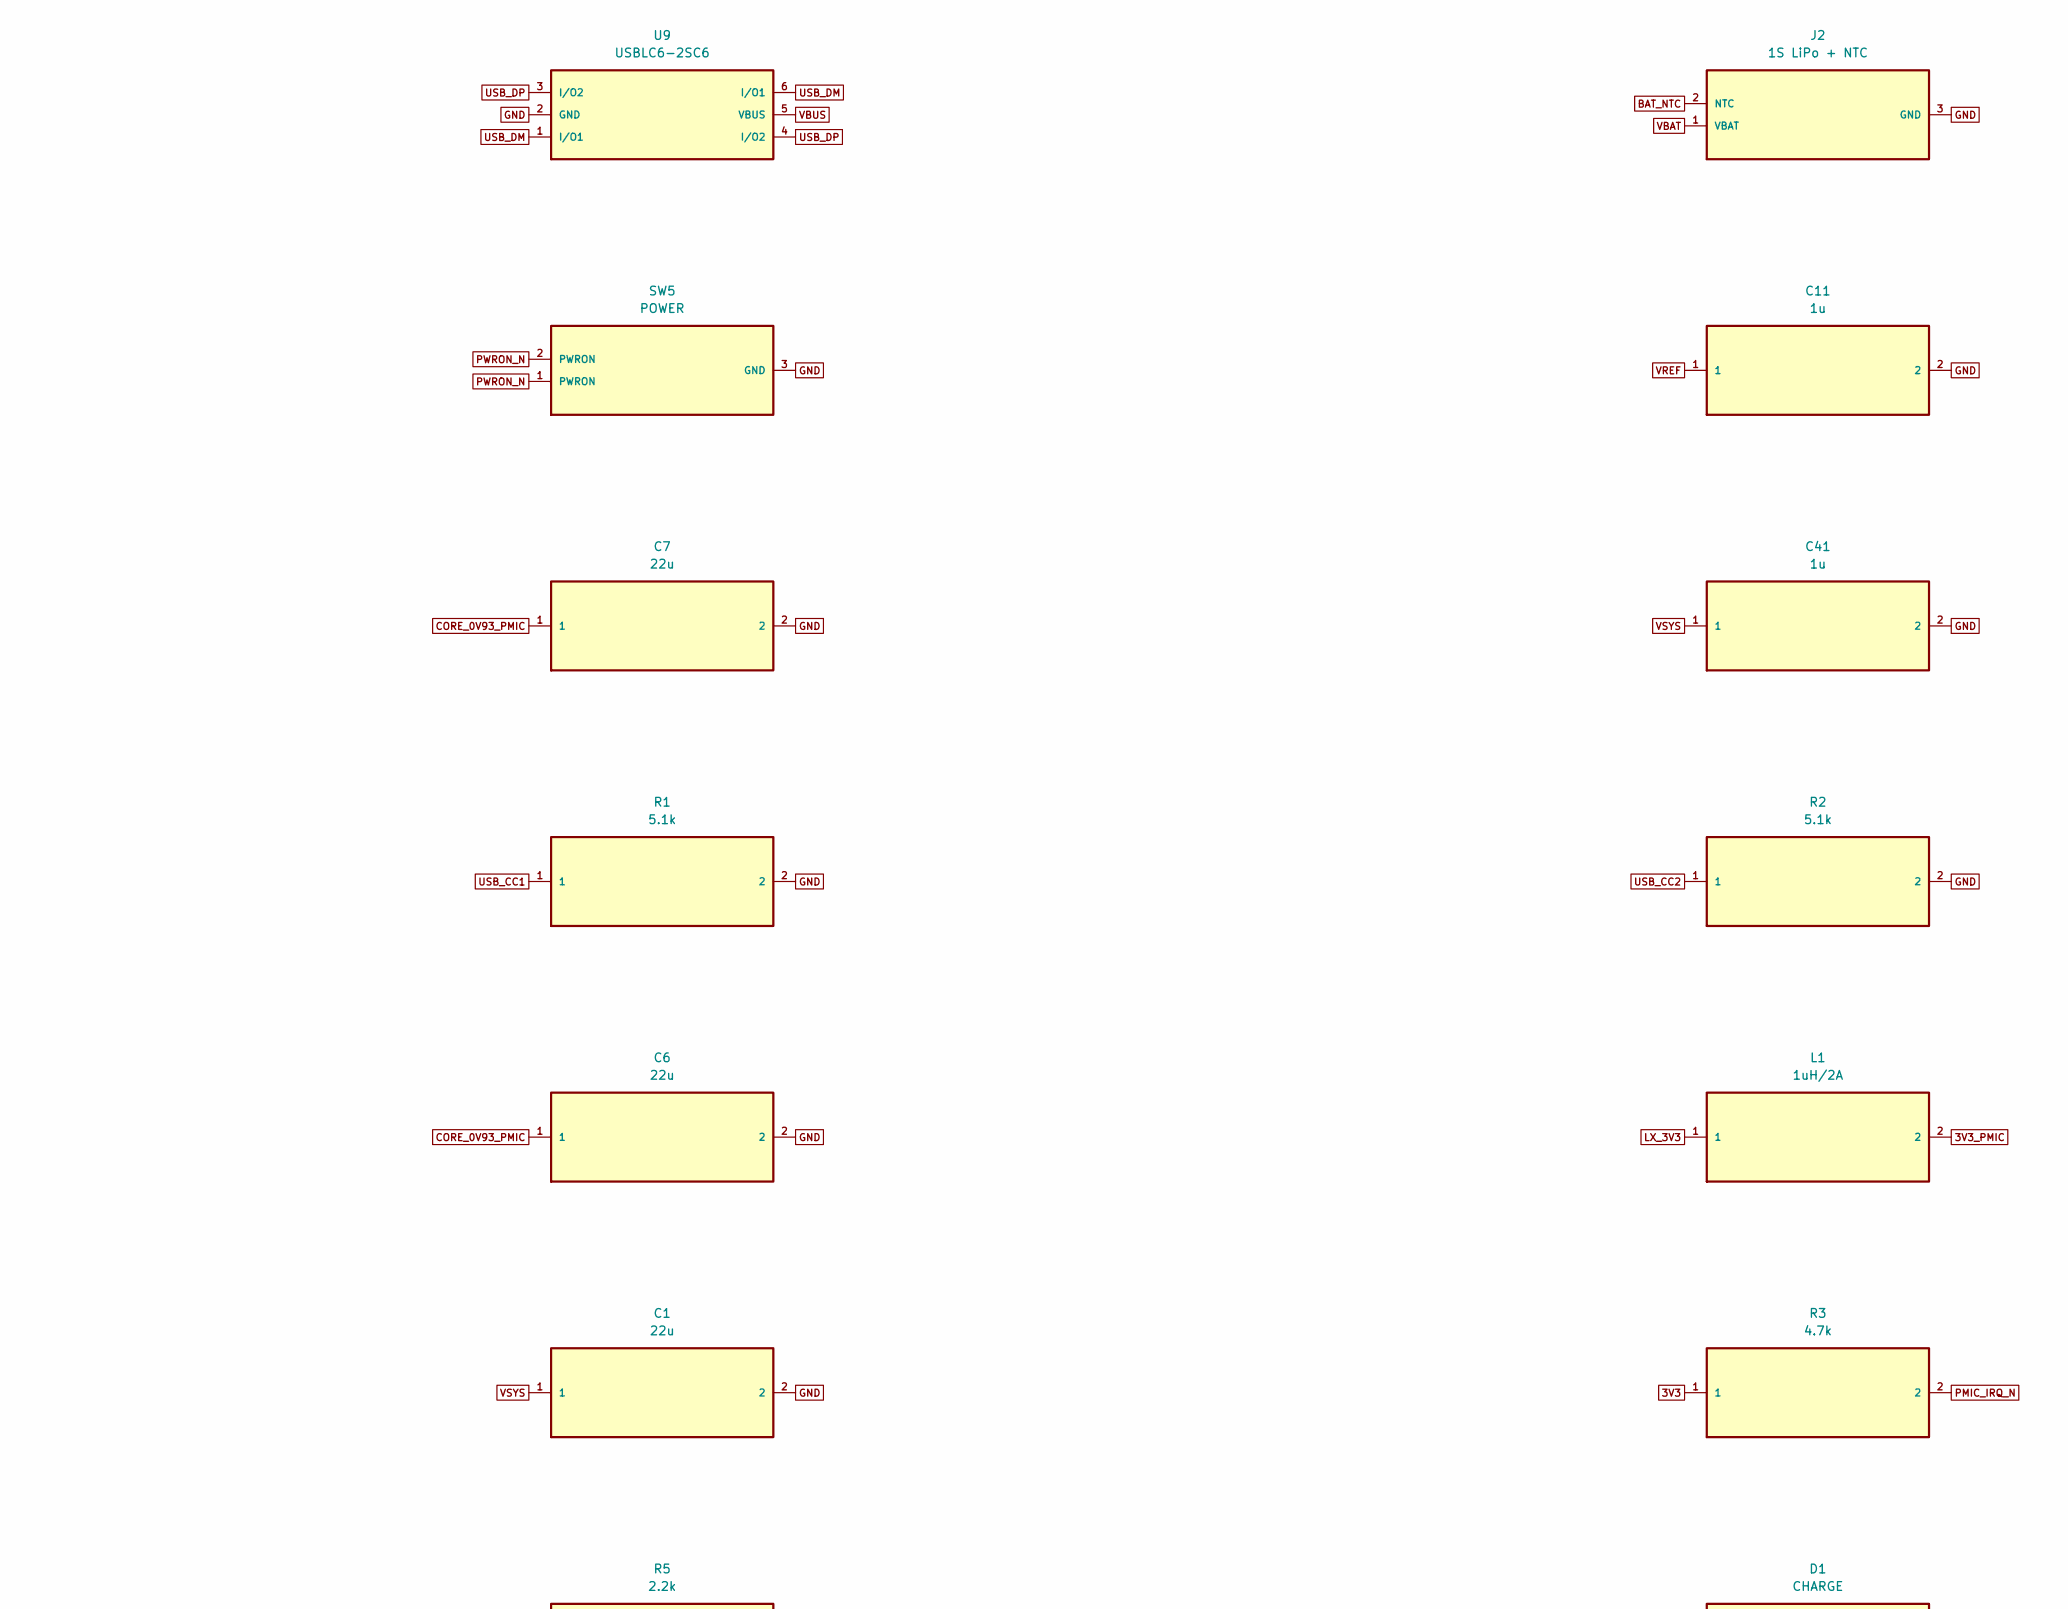
[picture p20: schematic 01_power.kicad_sch, 01 Power / Charger / PMIC, part in row 1, column 2]

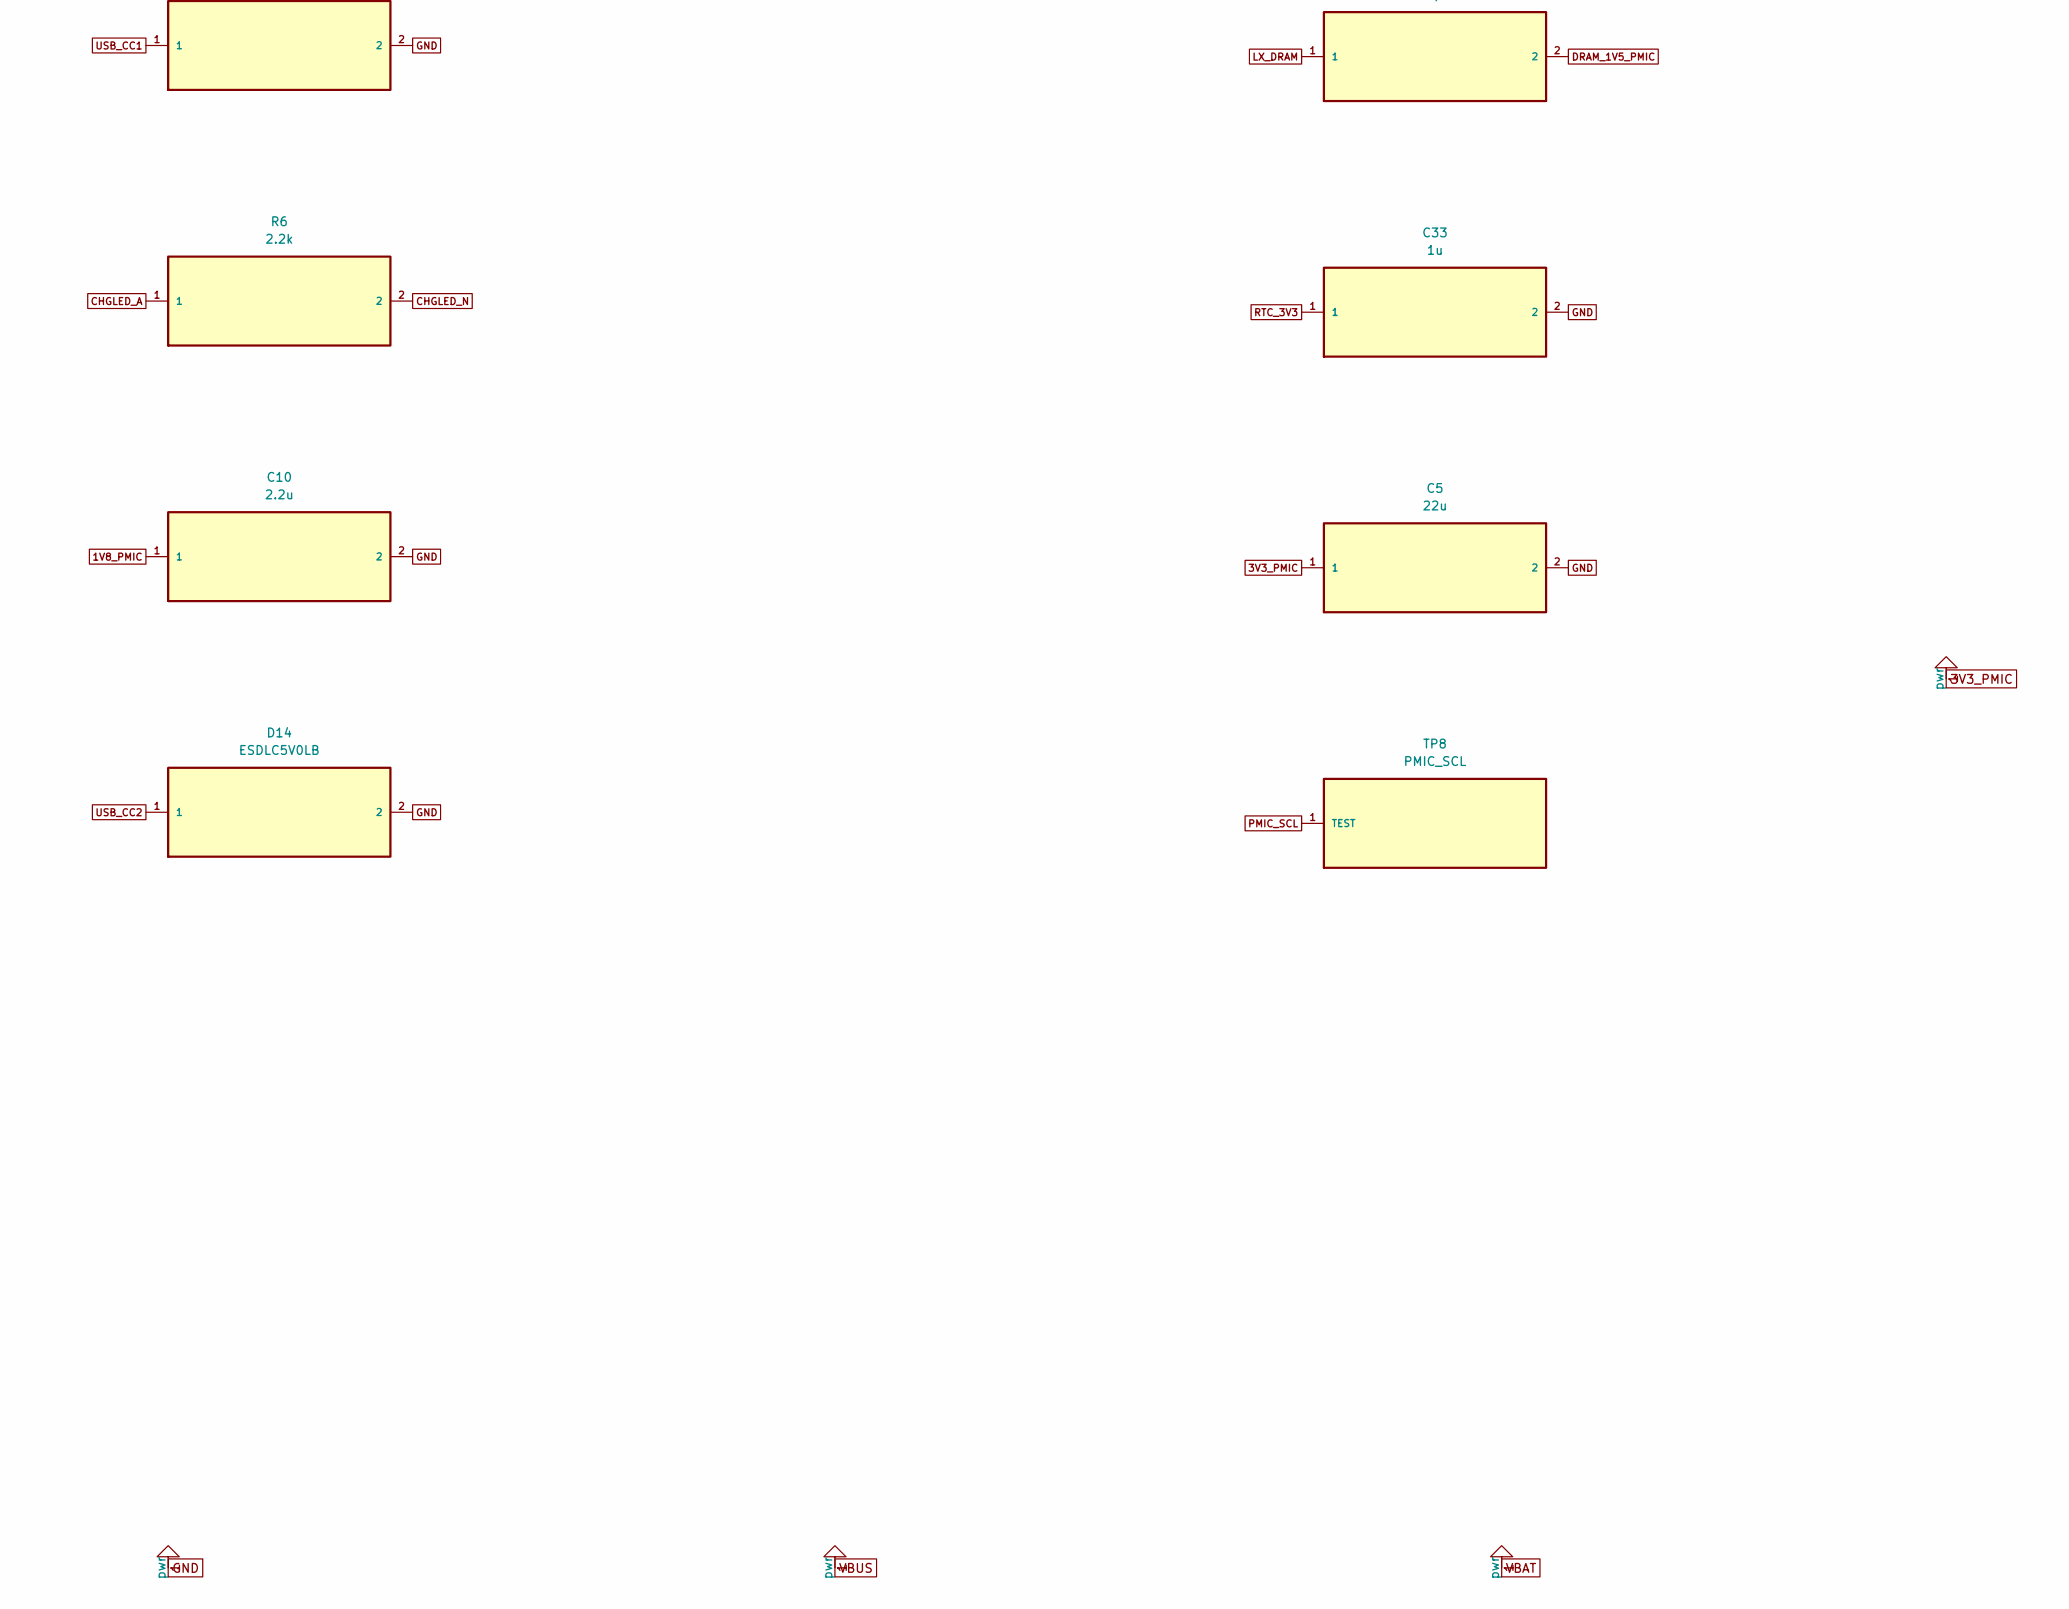
[picture p21: schematic 01_power.kicad_sch, 01 Power / Charger / PMIC, part in row 2, column 1]

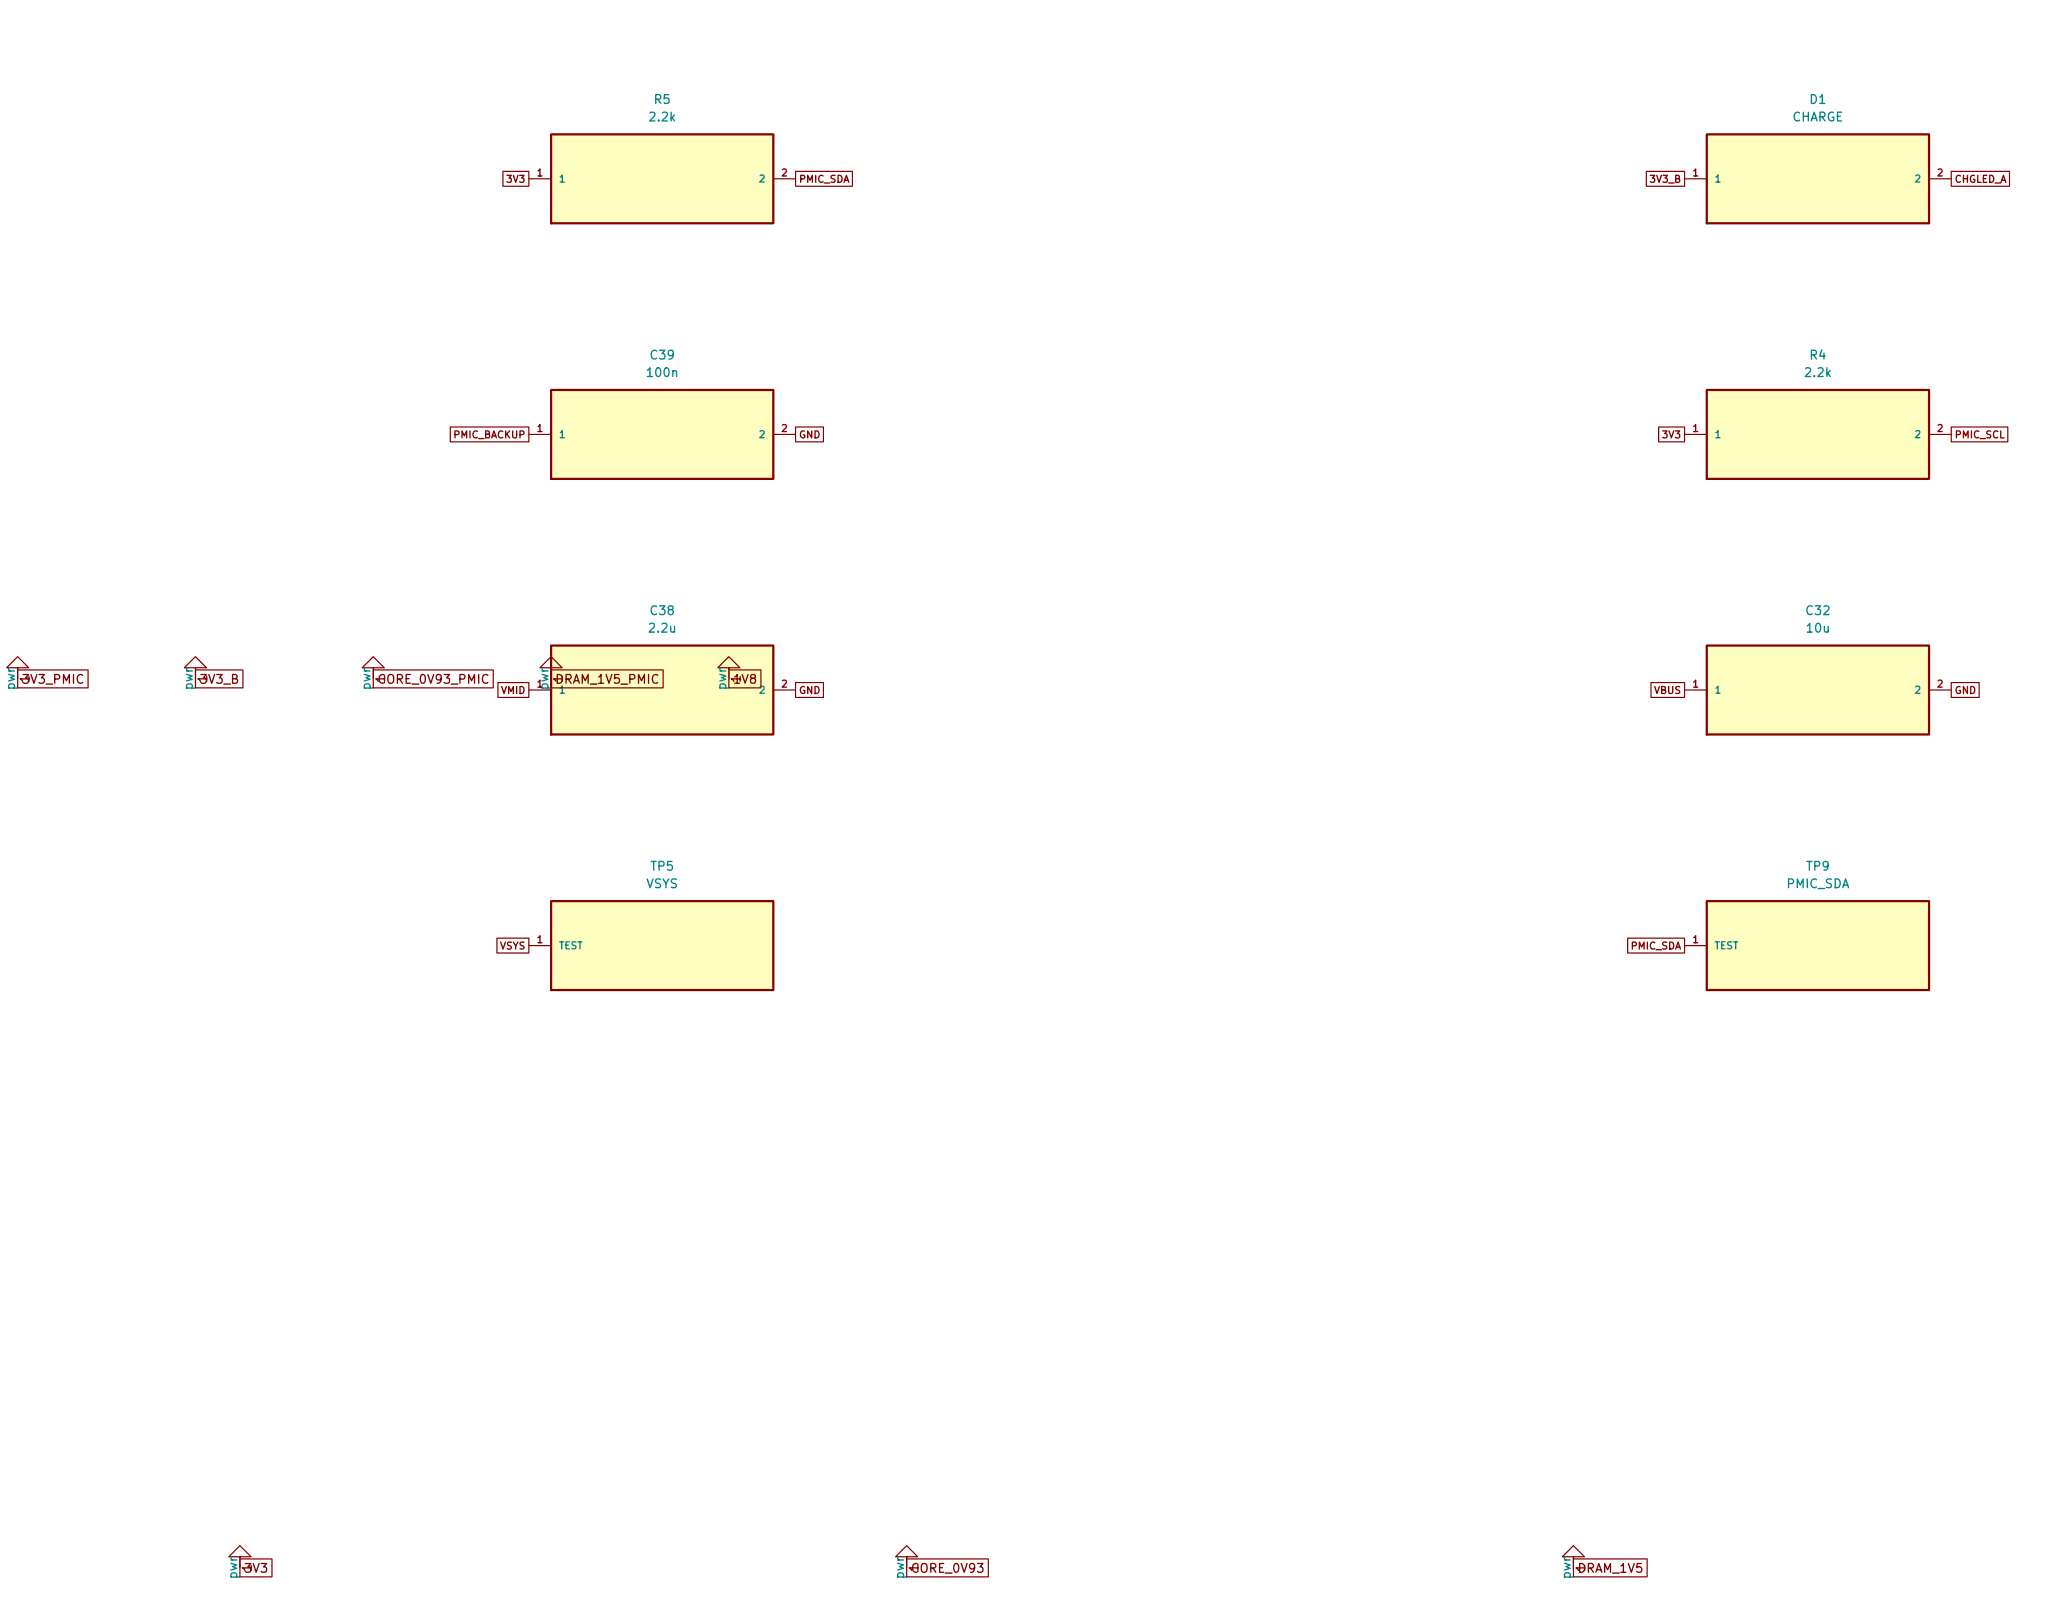
[picture p22: schematic 01_power.kicad_sch, 01 Power / Charger / PMIC, part in row 2, column 2]

Parts:
C1, C2: 22u; 0603; MPN CL10A226MP8NUNE; LCSC C86295
C3, C11, C33, C40, C41: 1u; 0603; MPN CL10A105KB8NNNC; LCSC C15849
C4, C5, C6, C7, C8, C9: 22u; 0603; MPN CL10A226MQ8NRNC; LCSC C59461
C10, C38: 2.2u; 0603; MPN CL10A225KO8NNNC; LCSC C23630
C32: 10u; 0603; MPN CL10A106KP8NNNC; LCSC C19702
C39: 100n; 0402; MPN CL05B104KO5NNNC; LCSC C1525
D1: CHARGE; LED0603; MPN KT-0603G; LCSC C12624
D13, D14: ESDLC5V0LB; DFN1006-2; MPN ESDLC5V0LB; LCSC C20168172
J1: USB4105-GF-A-060; USB4105; MPN USB4105-GF-A-060; LCSC C3025063
J2: 1S LiPo + NTC; SH1.0_3P_RA; MPN ZX-SH1.0-3PWT; LCSC C7430445
L1, L2, L3: 1uH/2A; IND_2x2; MPN WPN201610H1R0MT; LCSC C97002
R1, R2: 5.1k; 0402; MPN 0402 5.1k 1%; LCSC C25905
R3: 4.7k; 0402; LCSC C25900
R4, R5, R6: 2.2k; 0402; LCSC C25879
SW5: POWER; SW_SIDE; MPN GT-TC072B-H045-L1; LCSC C5117859
TP5: VSYS; TestPoint_Pad_D1.0mm
TP8: PMIC_SCL; TestPoint_Pad_D1.0mm
TP9: PMIC_SDA; TestPoint_Pad_D1.0mm
U1: AXP2101; QFN40; MPN AXP2101; LCSC C3036461
U9: USBLC6-2SC6; USBLC6-2SC6_SOT23-6; MPN USBLC6-2SC6; LCSC C2827654

Connections:
1V8_PMIC: C10.1, U1.18 (ALDO1); also elsewhere on the board
3V3: R3.1, R4.1, R5.1; also elsewhere on the board
3V3_B: D1.1; also elsewhere on the board
3V3_PMIC: C4.1, C5.1, L1.2, U1.13 (BLDOIN), U1.17 (ALDOIN), U1.21 (FB1); also elsewhere on the board
BAT_NTC: J2.2 (NTC), U1.31 (TS)
CHGLED_A: D1.2, R6.1
CHGLED_N: R6.2, U1.1 (CHGLED)
CORE_0V93_PMIC: C6.1, C7.1, L2.2, U1.4 (FB3); also elsewhere on the board
DRAM_1V5_PMIC: C8.1, C9.1, L3.2, U1.9 (FB4); also elsewhere on the board
GND: C1.2, C2.2, C3.2, C4.2, C5.2, C6.2, C7.2, C8.2, C9.2, C10.2, C11.2, C32.2, C33.2, C38.2, C39.2, C40.2, C41.2, D13.2, D14.2, J1.A1 (GND), J1.A12 (GND), J1.B1 (GND), J1.B12 (GND), J1.SH1 (SHIELD), J1.SH2 (SHIELD), J1.SH3 (SHIELD), J1.SH4 (SHIELD), J2.3 (GND), R1.2, R2.2, SW5.3 (GND), U1.3 (GND), U1.41 (EPAD), U9.2 (GND); also elsewhere on the board
LX_3V3: L1.1, U1.22 (LX1)
LX_CORE: L2.1, U1.5 (LX3)
LX_DRAM: L3.1, U1.8 (LX4)
PMIC_BACKUP: C39.1, U1.27 (VBACKUP)
PMIC_IRQ_N: R3.2, U1.38 (IRQ); also elsewhere on the board
PMIC_SCL: R4.2, TP8.1 (TEST), U1.40 (SCK); also elsewhere on the board
PMIC_SDA: R5.2, TP9.1 (TEST), U1.39 (SDA); also elsewhere on the board
PWRON_N: SW5.1 (PWRON), SW5.2 (PWRON), U1.30 (PWRON); also elsewhere on the board
RTC_3V3: C33.1, U1.28 (VRTC); also elsewhere on the board
USB_CC1: D13.1, J1.A5 (CC1), R1.1
USB_CC2: D14.1, J1.B5 (CC2), R2.1
USB_DM: J1.A7 (DM1), J1.B7 (DM2), U9.1 (I/O1), U9.6 (I/O1); also elsewhere on the board
USB_DP: J1.A6 (DP1), J1.B6 (DP2), U9.3 (I/O2), U9.4 (I/O2); also elsewhere on the board
VBAT: C3.1, J2.1 (VBAT), U1.33 (BAT)
VBUS: C32.1, J1.A4 (VBUS), J1.A9 (VBUS), J1.B4 (VBUS), J1.B9 (VBUS), U1.37 (VBUS), U9.5 (VBUS)
VMID: C38.1, U1.36 (VMID)
VREF: C11.1, U1.2 (VREF)
VSYS: C1.1, C2.1, C40.1, C41.1, TP5.1 (TEST), U1.6 (VIN3), U1.7 (VIN4), U1.23 (VIN1), U1.24 (VIN2), U1.34 (VSYS)
