LeeSpo/portable-display-epass-EVT1-minboot-r1/portable-display/hardware/v1-WEB6-redesign/split-power-candidate/ak_display_38x64_SPLIT_POWER_CANDIDATE.kicad_pcb

## KiCad design portable-display/hardware/v1-WEB6-redesign/split-power-candidate/ak_display_38x64_SPLIT_POWER_CANDIDATE.kicad_pcb (continued)

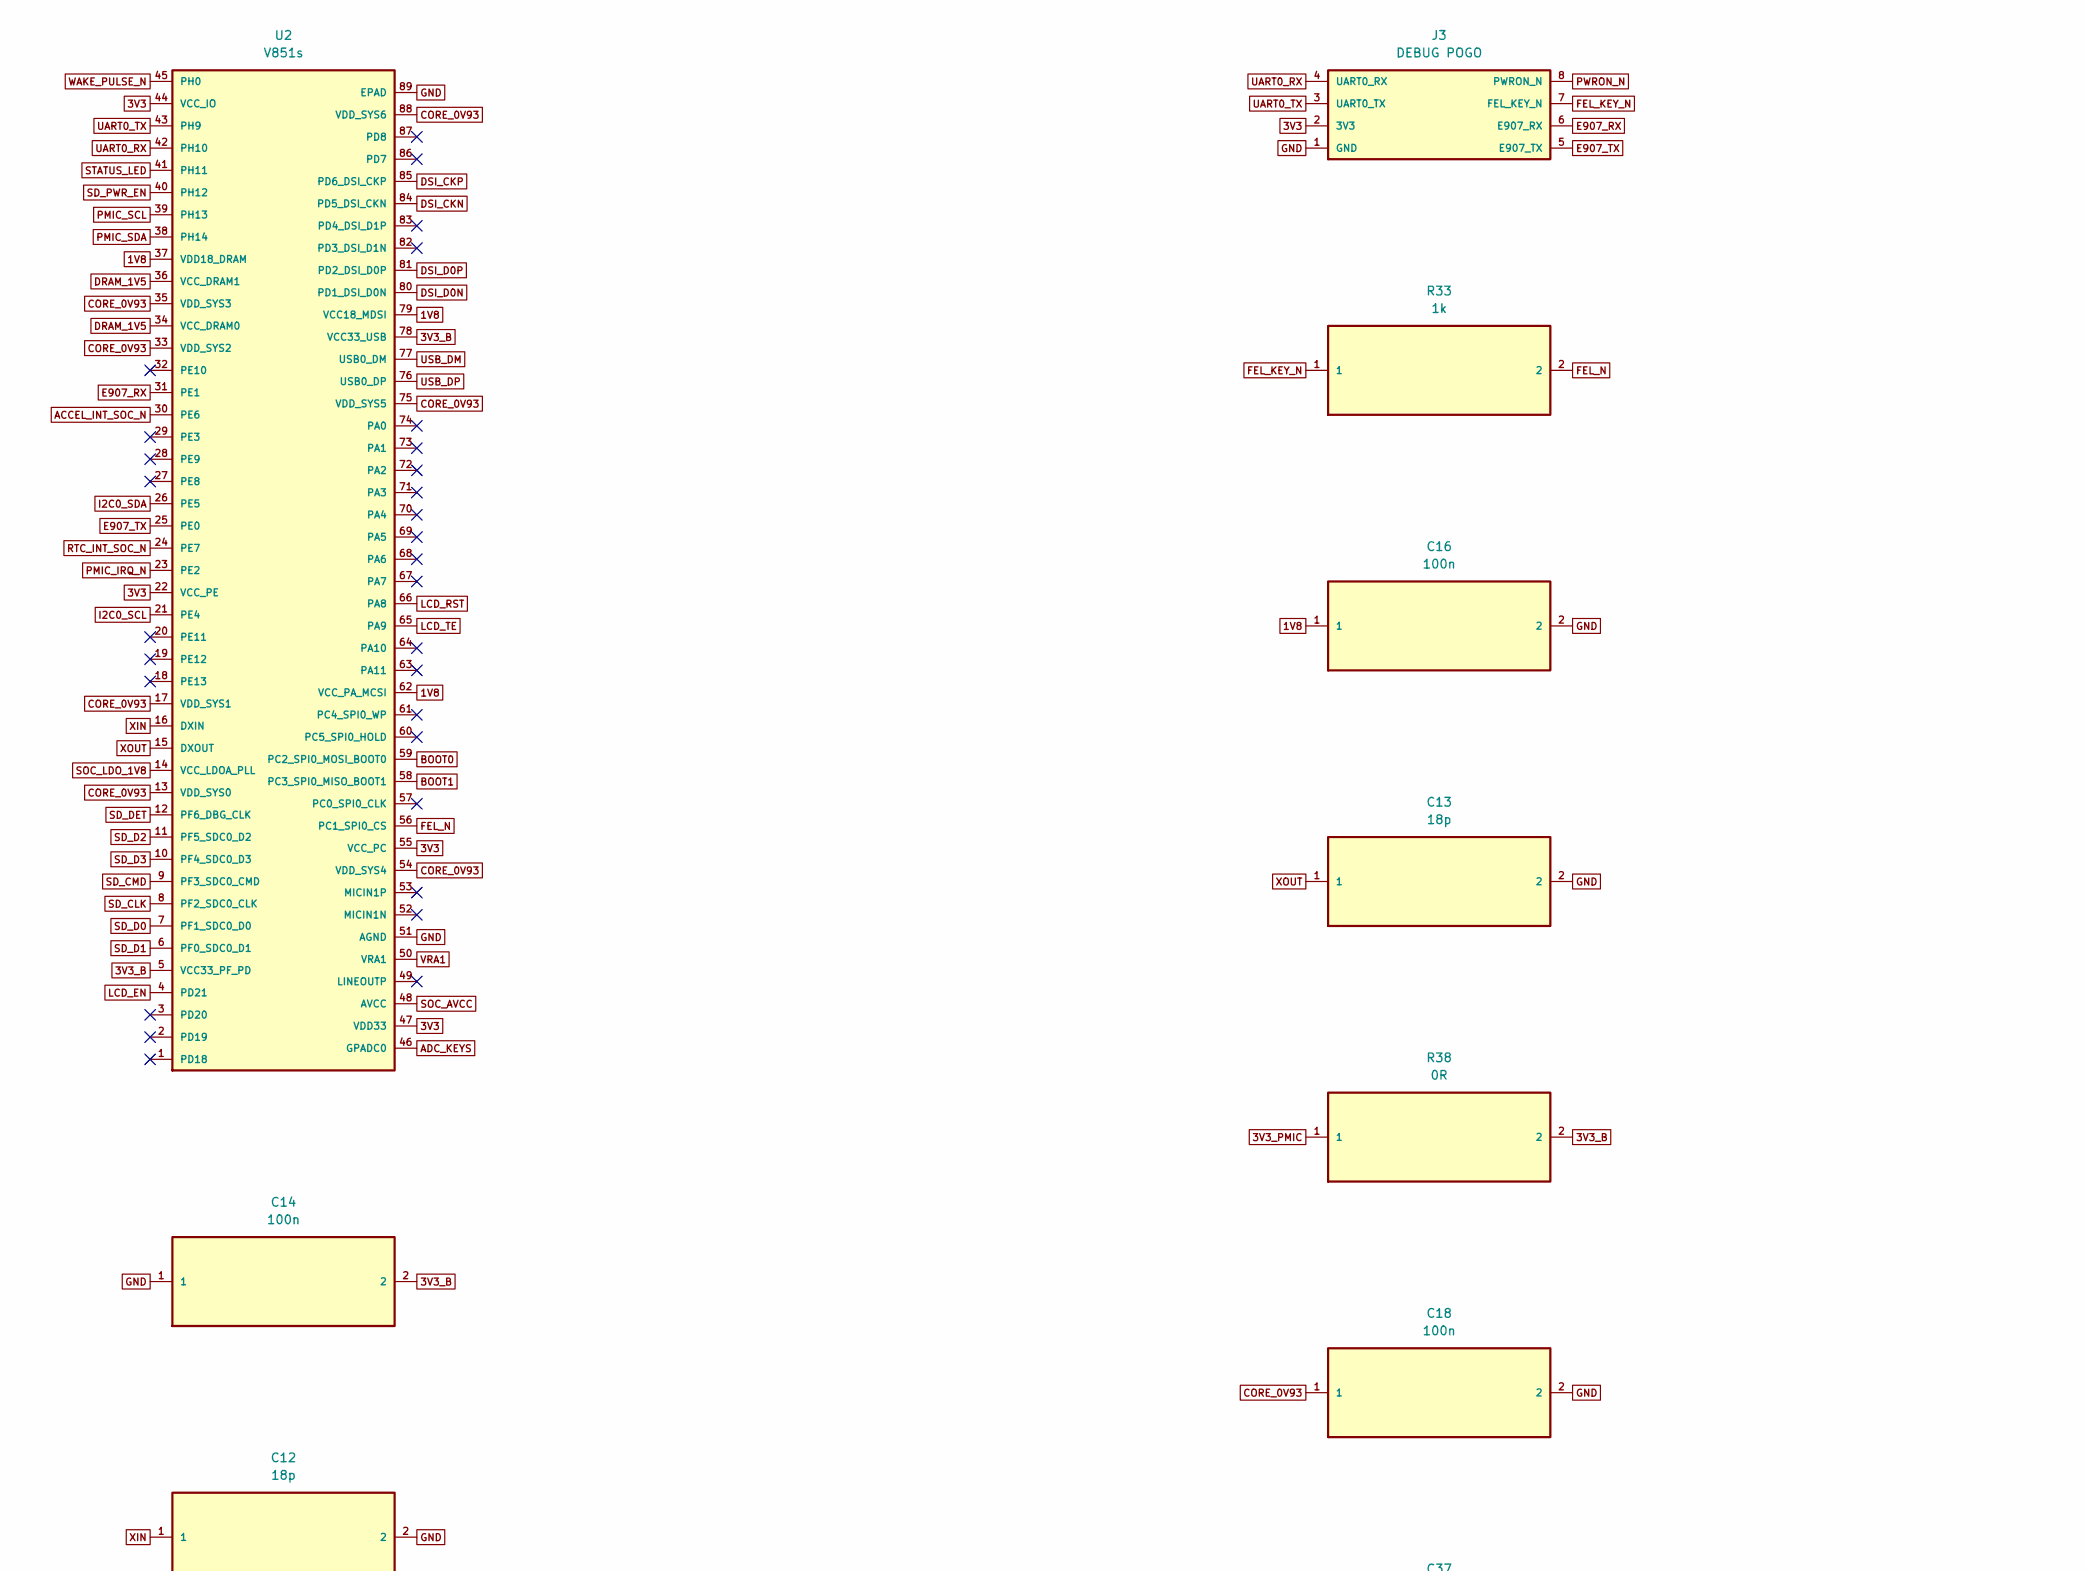
[picture p23: schematic 02_soc_v851s.kicad_sch, 02 V851s / Boot / Storage, part in row 1, column 1]

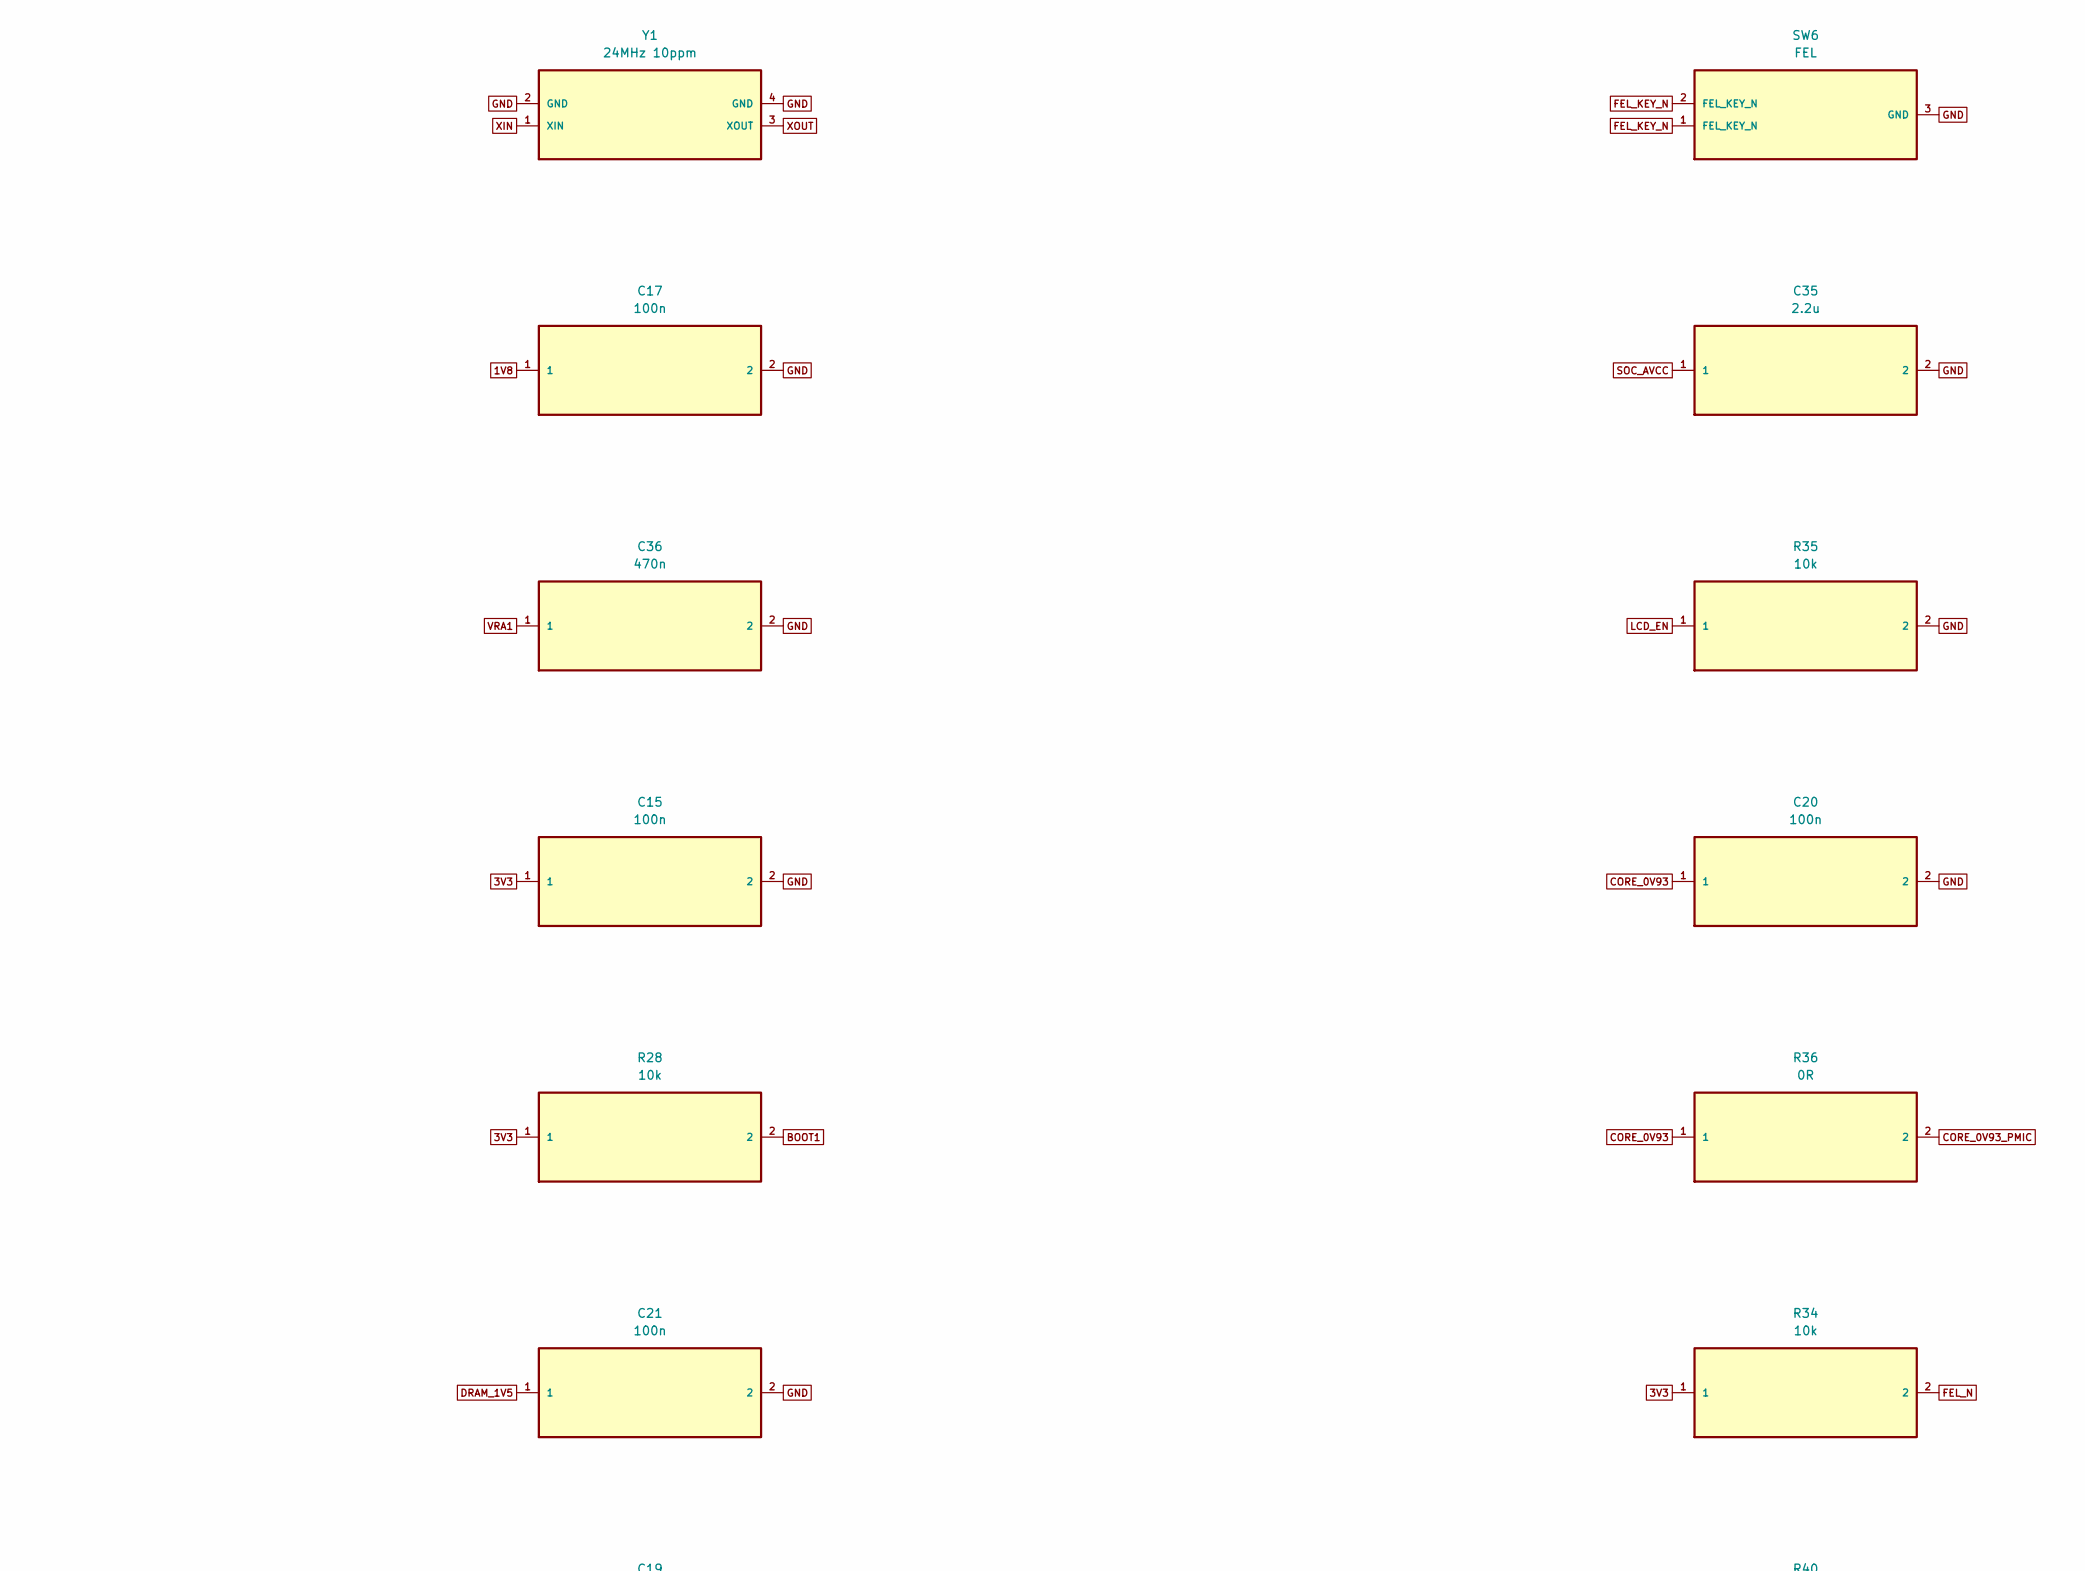
[picture p24: schematic 02_soc_v851s.kicad_sch, 02 V851s / Boot / Storage, part in row 1, column 2]

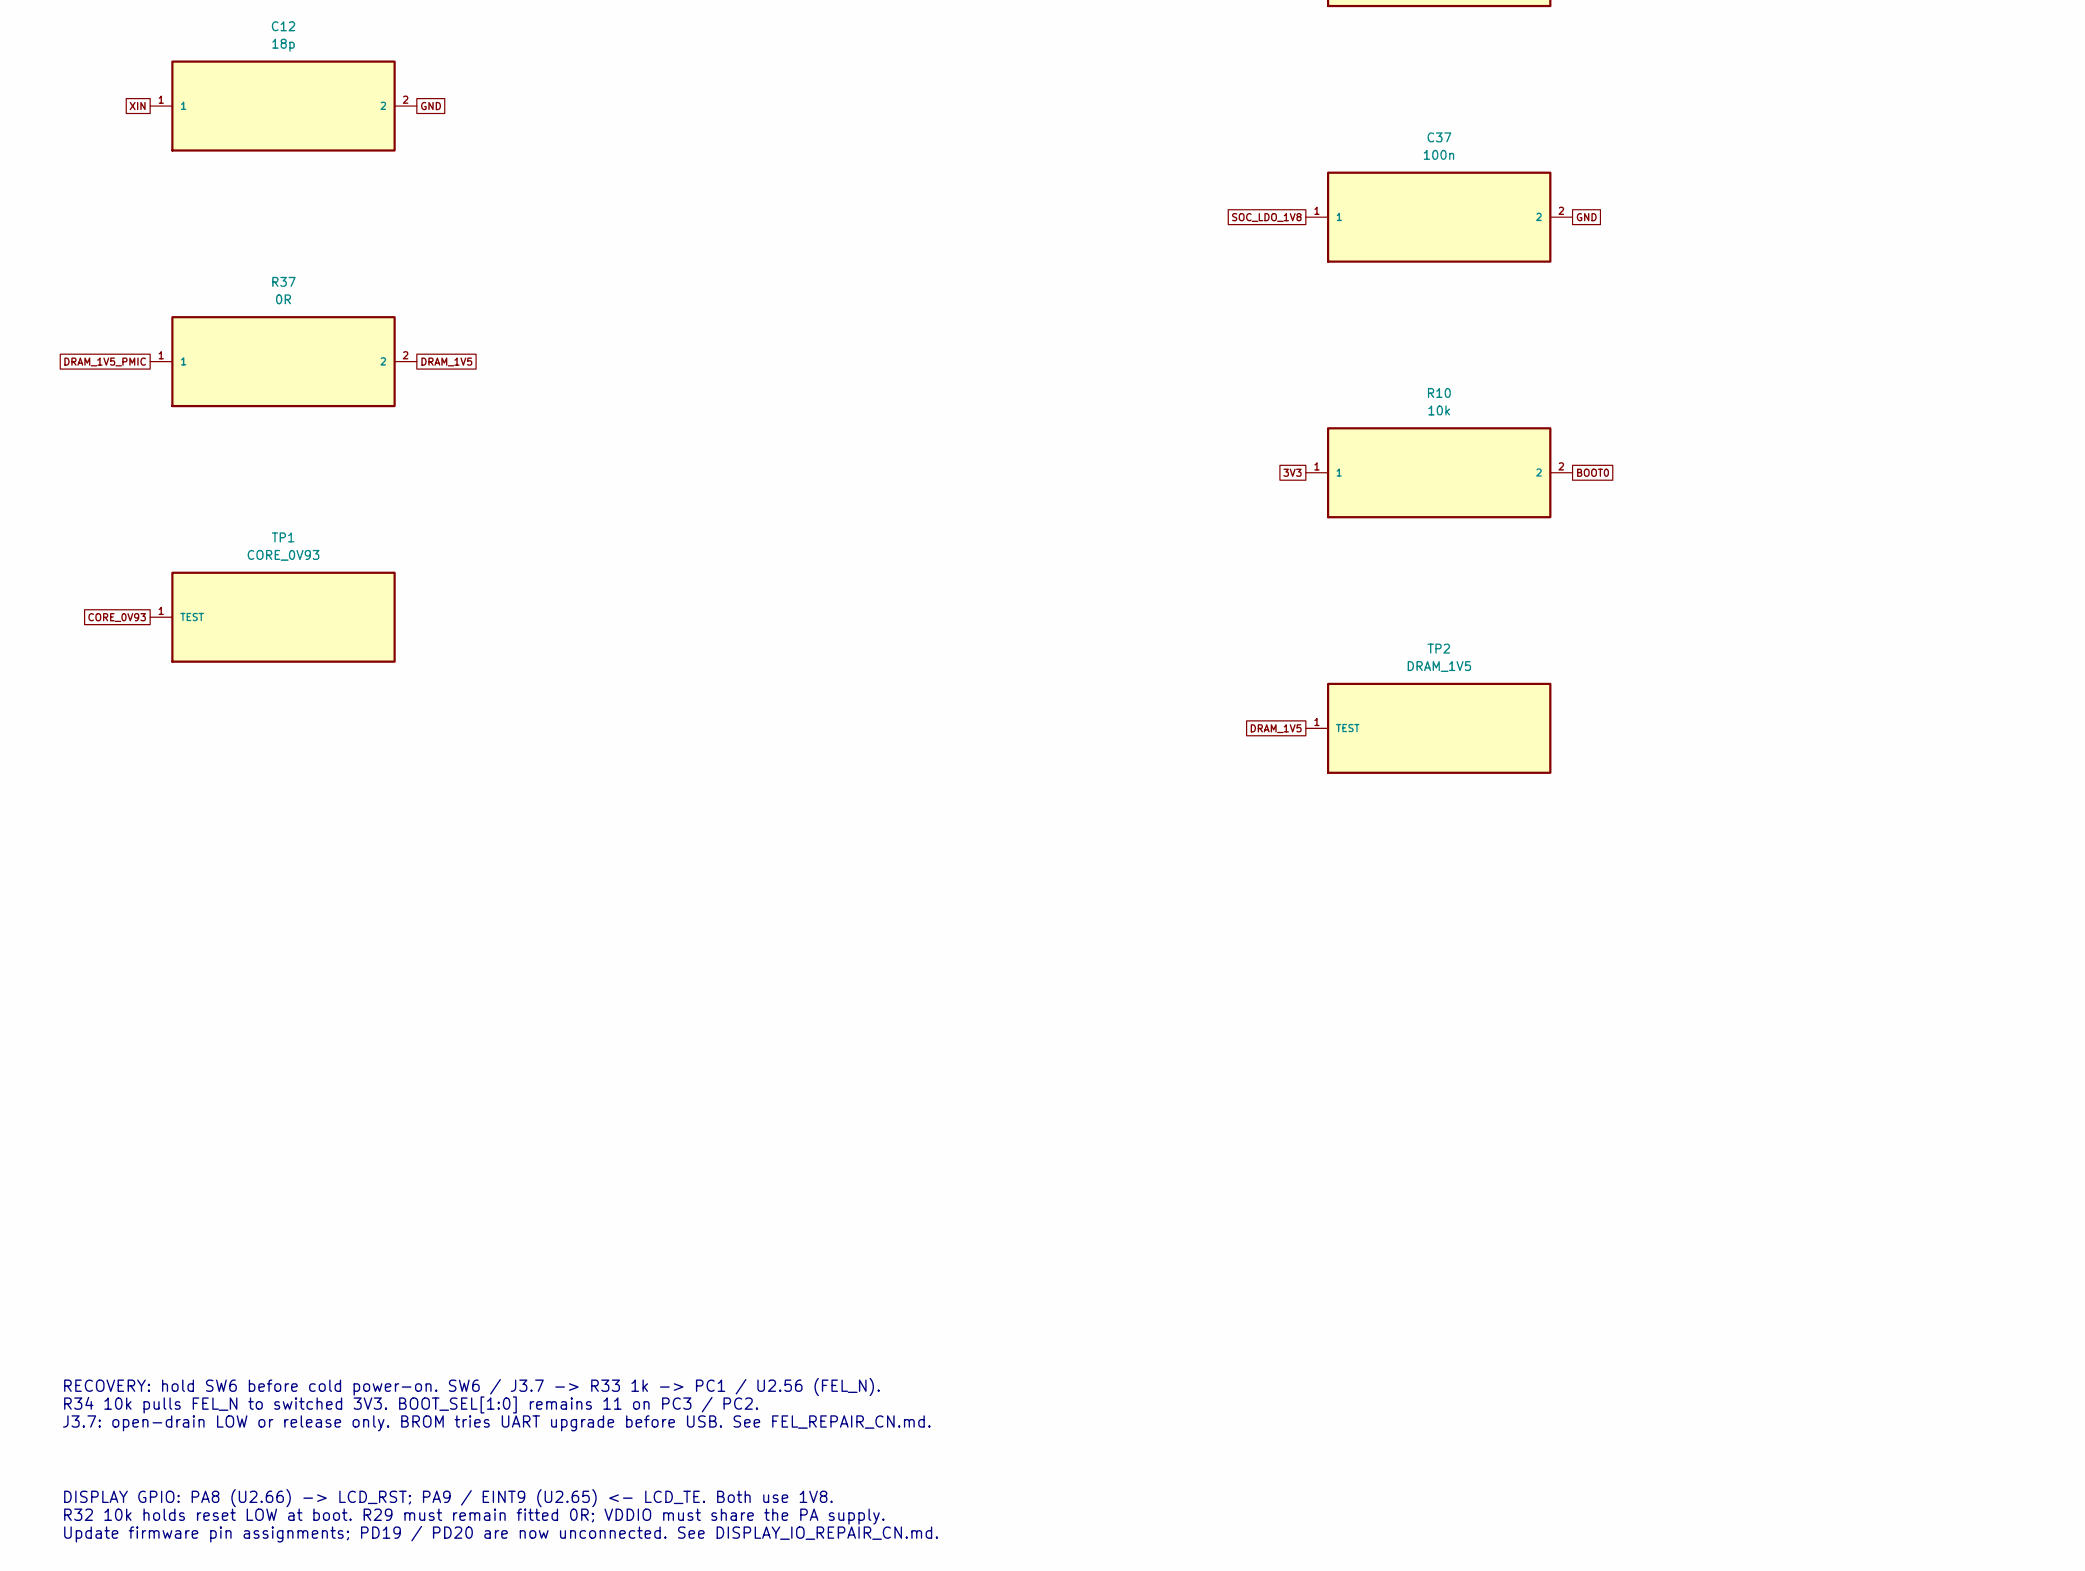
[picture p25: schematic 02_soc_v851s.kicad_sch, 02 V851s / Boot / Storage, part in row 2, column 1]

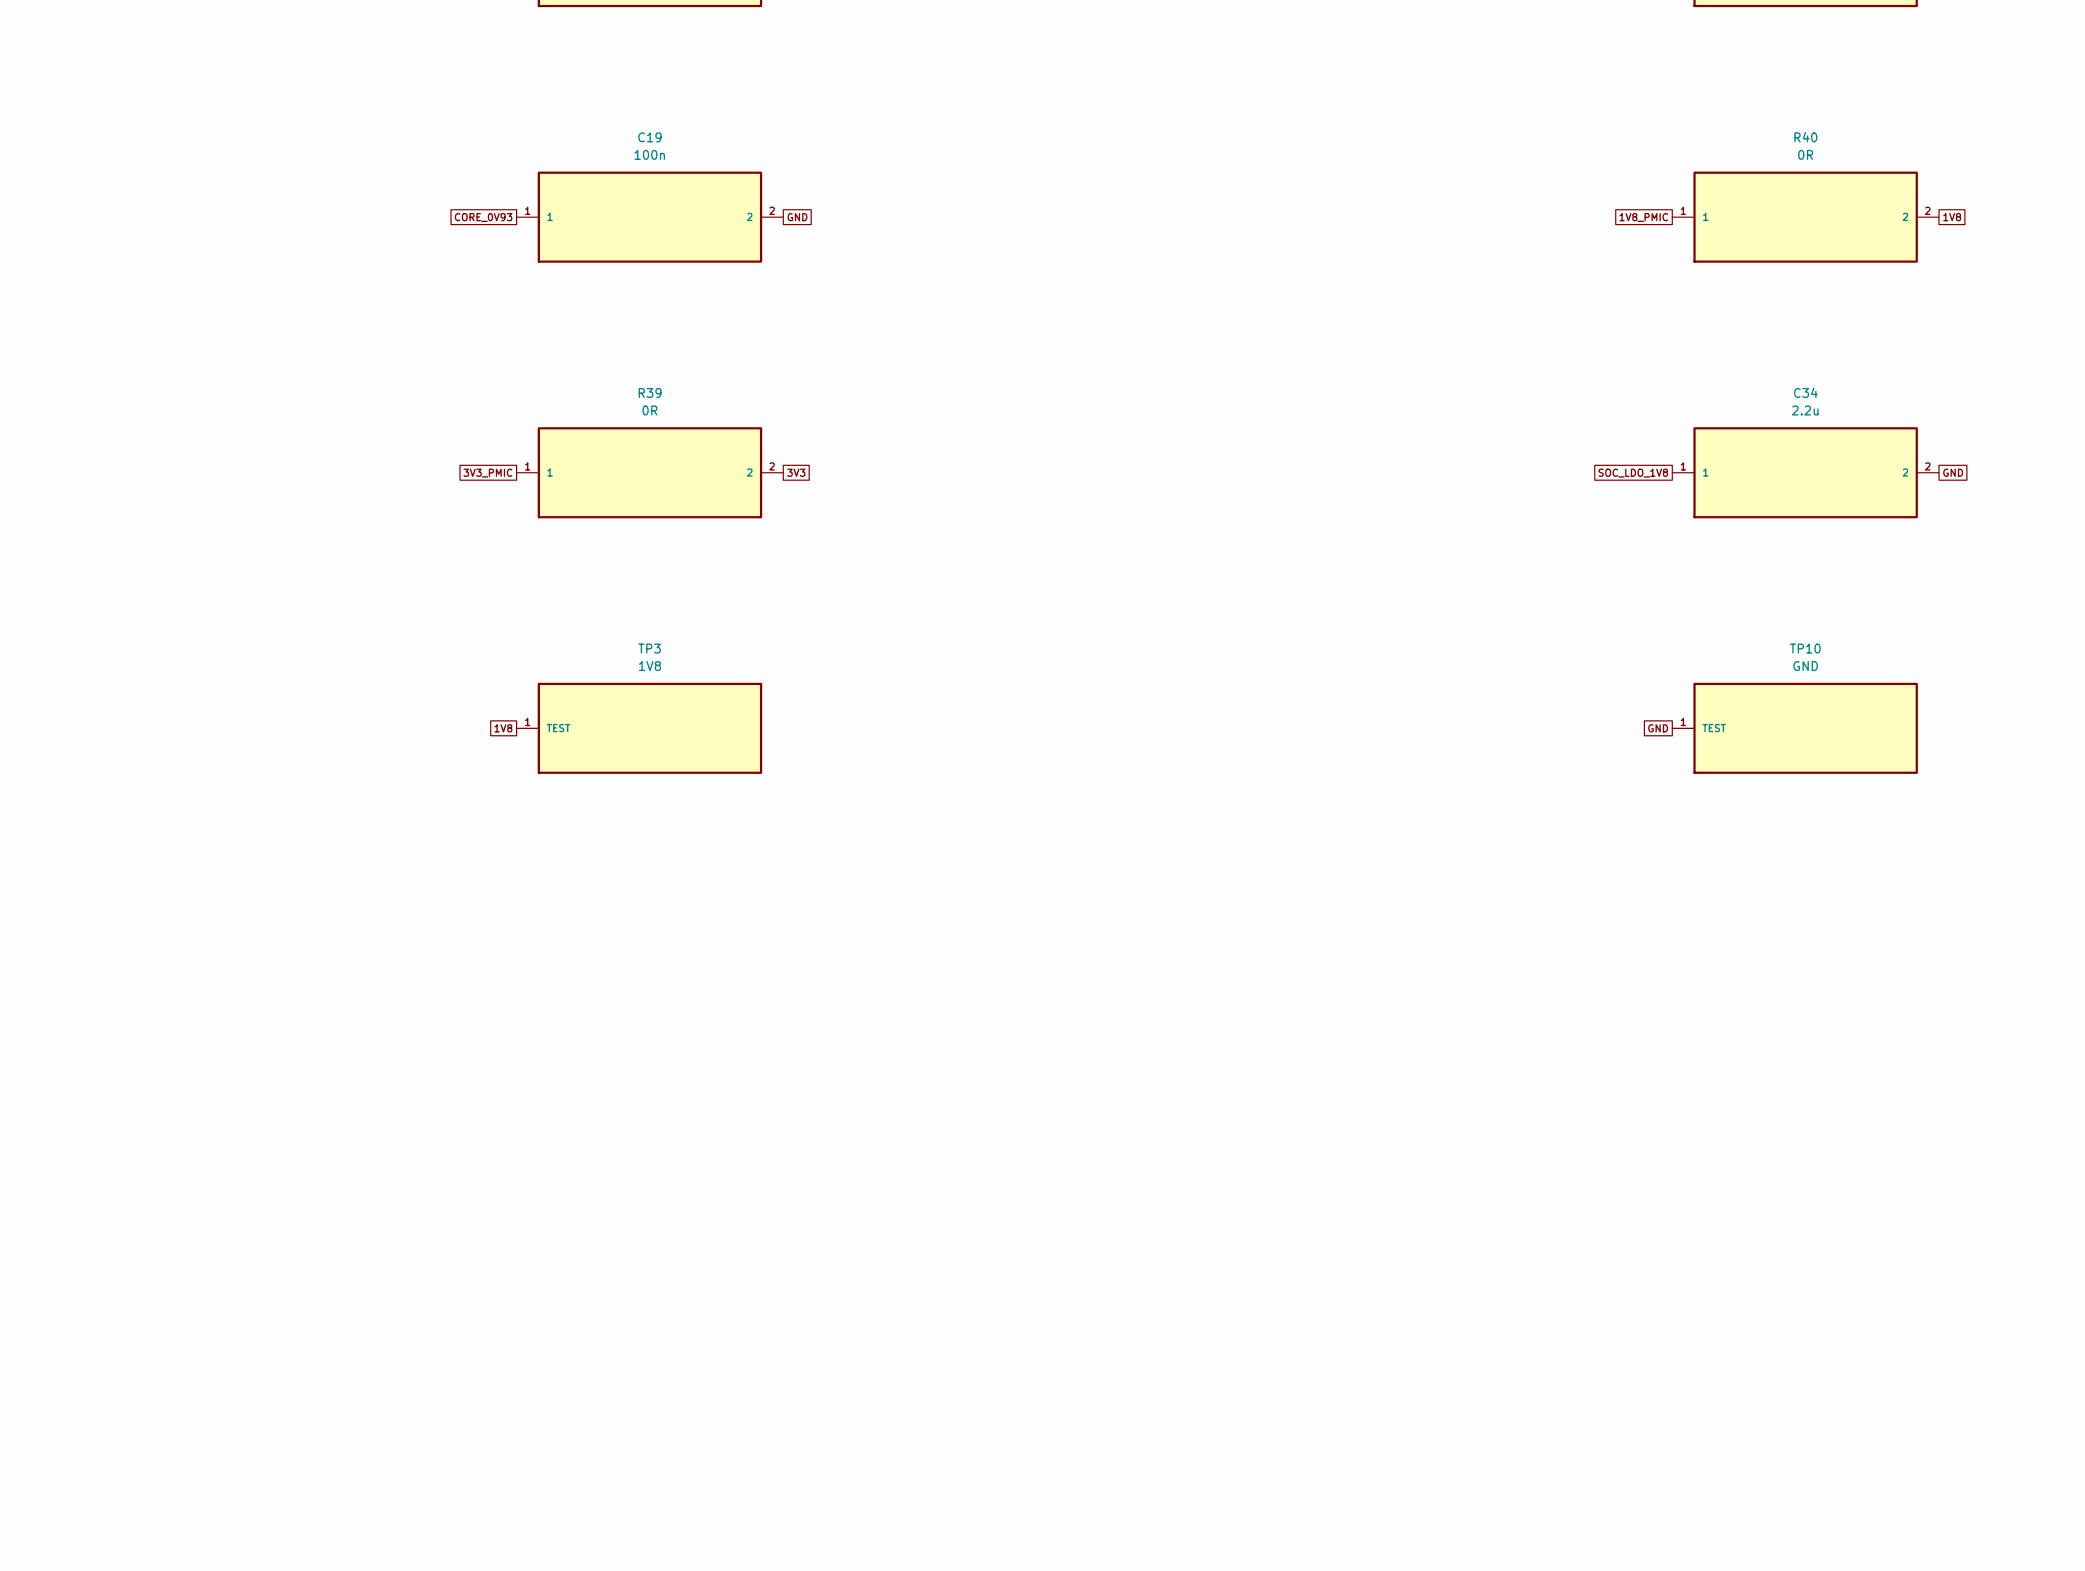
[picture p26: schematic 02_soc_v851s.kicad_sch, 02 V851s / Boot / Storage, part in row 2, column 2]

Parts:
C12, C13: 18p; 0402; MPN 0402CG180J500NT; LCSC C1549
C14, C37: 100n; 0402; MPN CL05B104KO5NNNC; LCSC C1525
C15, C16, C17, C18, C19, C20, C21: 100n; 0402; MPN 0402 100n X7R; LCSC C1525
C34: 2.2u; 0402; MPN CL05A225MQ5NSNC; LCSC C12530
C35: 2.2u; 0603; MPN CL10A225KO8NNNC; LCSC C23630
C36: 470n; 0402; MPN CL05A474KP5NNNC; LCSC C47339
J3: DEBUG POGO; HDR8
R10, R28, R34, R35: 10k; 0402; MPN 0402WGF1002TCE; LCSC C25744
R33: 1k; 0402; MPN 0402WGF1001TCE; LCSC C11702
R36, R37, R38, R39, R40: 0R; 0402; MPN 0402WGF0000TCE; LCSC C17168
SW6: FEL; SW_SIDE; MPN GT-TC072B-H045-L1; LCSC C5117859
TP1: CORE_0V93; TestPoint_Pad_D1.0mm
TP2: DRAM_1V5; TestPoint_Pad_D1.0mm
TP3: 1V8; TestPoint_Pad_D1.0mm
TP10: GND; TestPoint_Pad_D1.0mm
U2: V851s; QFN88; MPN V851s; LCSC C5365286
Y1: 24MHz 10ppm; XTAL4; MPN XXDBBCNANF-24MHZ; LCSC C16197264

Connections:
1V8: C16.1, C17.1, R40.2, TP3.1 (TEST), U2.37 (VDD18_DRAM), U2.62 (VCC_PA_MCSI), U2.79 (VCC18_MDSI); also elsewhere on the board
1V8_PMIC: R40.1; also elsewhere on the board
3V3: C15.1, J3.2 (3V3), R10.1, R28.1, R34.1, R39.2, U2.22 (VCC_PE), U2.44 (VCC_IO), U2.47 (VDD33), U2.55 (VCC_PC); also elsewhere on the board
3V3_B: C14.2, R38.2, U2.5 (VCC33_PF_PD), U2.78 (VCC33_USB); also elsewhere on the board
3V3_PMIC: R38.1, R39.1; also elsewhere on the board
ACCEL_INT_SOC_N: U2.30 (PE6); also elsewhere on the board
ADC_KEYS: U2.46 (GPADC0); also elsewhere on the board
BOOT0: R10.2, U2.59 (PC2_SPI0_MOSI_BOOT0)
BOOT1: R28.2, U2.58 (PC3_SPI0_MISO_BOOT1)
CORE_0V93: C18.1, C19.1, C20.1, R36.1, TP1.1 (TEST), U2.13 (VDD_SYS0), U2.17 (VDD_SYS1), U2.33 (VDD_SYS2), U2.35 (VDD_SYS3), U2.54 (VDD_SYS4), U2.75 (VDD_SYS5), U2.88 (VDD_SYS6); also elsewhere on the board
CORE_0V93_PMIC: R36.2; also elsewhere on the board
DRAM_1V5: C21.1, R37.2, TP2.1 (TEST), U2.34 (VCC_DRAM0), U2.36 (VCC_DRAM1)
DRAM_1V5_PMIC: R37.1; also elsewhere on the board
DSI_CKN: U2.84 (PD5_DSI_CKN); also elsewhere on the board
DSI_CKP: U2.85 (PD6_DSI_CKP); also elsewhere on the board
DSI_D0N: U2.80 (PD1_DSI_D0N); also elsewhere on the board
DSI_D0P: U2.81 (PD2_DSI_D0P); also elsewhere on the board
E907_RX: J3.6 (E907_RX), U2.31 (PE1)
E907_TX: J3.5 (E907_TX), U2.25 (PE0)
FEL_KEY_N: J3.7 (FEL_KEY_N), R33.1, SW6.1 (FEL_KEY_N), SW6.2 (FEL_KEY_N)
FEL_N: R33.2, R34.2, U2.56 (PC1_SPI0_CS)
GND: C12.2, C13.2, C14.1, C15.2, C16.2, C17.2, C18.2, C19.2, C20.2, C21.2, C34.2, C35.2, C36.2, C37.2, J3.1 (GND), R35.2, SW6.3 (GND), TP10.1 (TEST), U2.51 (AGND), U2.89 (EPAD), Y1.2 (GND), Y1.4 (GND); also elsewhere on the board
I2C0_SCL: U2.21 (PE4); also elsewhere on the board
I2C0_SDA: U2.26 (PE5); also elsewhere on the board
LCD_EN: R35.1, U2.4 (PD21); also elsewhere on the board
LCD_RST: U2.66 (PA8); also elsewhere on the board
LCD_TE: U2.65 (PA9); also elsewhere on the board
PMIC_IRQ_N: U2.23 (PE2); also elsewhere on the board
PMIC_SCL: U2.39 (PH13); also elsewhere on the board
PMIC_SDA: U2.38 (PH14); also elsewhere on the board
PWRON_N: J3.8 (PWRON_N); also elsewhere on the board
RTC_INT_SOC_N: U2.24 (PE7); also elsewhere on the board
SD_CLK: U2.8 (PF2_SDC0_CLK); also elsewhere on the board
SD_CMD: U2.9 (PF3_SDC0_CMD); also elsewhere on the board
SD_D0: U2.7 (PF1_SDC0_D0); also elsewhere on the board
SD_D1: U2.6 (PF0_SDC0_D1); also elsewhere on the board
SD_D2: U2.11 (PF5_SDC0_D2); also elsewhere on the board
SD_D3: U2.10 (PF4_SDC0_D3); also elsewhere on the board
SD_DET: U2.12 (PF6_DBG_CLK); also elsewhere on the board
SD_PWR_EN: U2.40 (PH12); also elsewhere on the board
SOC_AVCC: C35.1, U2.48 (AVCC)
SOC_LDO_1V8: C34.1, C37.1, U2.14 (VCC_LDOA_PLL)
STATUS_LED: U2.41 (PH11); also elsewhere on the board
UART0_RX: J3.4 (UART0_RX), U2.42 (PH10)
UART0_TX: J3.3 (UART0_TX), U2.43 (PH9)
USB_DM: U2.77 (USB0_DM); also elsewhere on the board
USB_DP: U2.76 (USB0_DP); also elsewhere on the board
VRA1: C36.1, U2.50 (VRA1)
WAKE_PULSE_N: U2.45 (PH0); also elsewhere on the board
XIN: C12.1, U2.16 (DXIN), Y1.1 (XIN)
XOUT: C13.1, U2.15 (DXOUT), Y1.3 (XOUT)

Notes on the sheet:
RECOVERY: hold SW6 before cold power-on. SW6 / J3.7 -> R33 1k -> PC1 / U2.56 (FEL_N). R34 10k pulls FEL_N to switched 3V3. BOOT_SEL[1:0] remains 11 on PC3 / PC2. J3.7: open-drain LOW or release only. BROM tries UART upgrade before USB. See FEL_REPAIR_CN.md.
DISPLAY GPIO: PA8 (U2.66) -> LCD_RST; PA9 / EINT9 (U2.65) <- LCD_TE. Both use 1V8. R32 10k holds reset LOW at boot. R29 must remain fitted 0R; VDDIO must share the PA supply. Update firmware pin assignments; PD19 / PD20 are now unconnected. See DISPLAY_IO_REPAIR_CN.md.
