LeeSpo/portable-display-epass-EVT1-minboot-r1/portable-display/hardware/v1-WEB6-redesign/split-power-candidate/ak_display_38x64_SPLIT_POWER_CANDIDATE.kicad_pcb

## KiCad design portable-display/hardware/v1-WEB6-redesign/split-power-candidate/ak_display_38x64_SPLIT_POWER_CANDIDATE.kicad_pcb (continued)

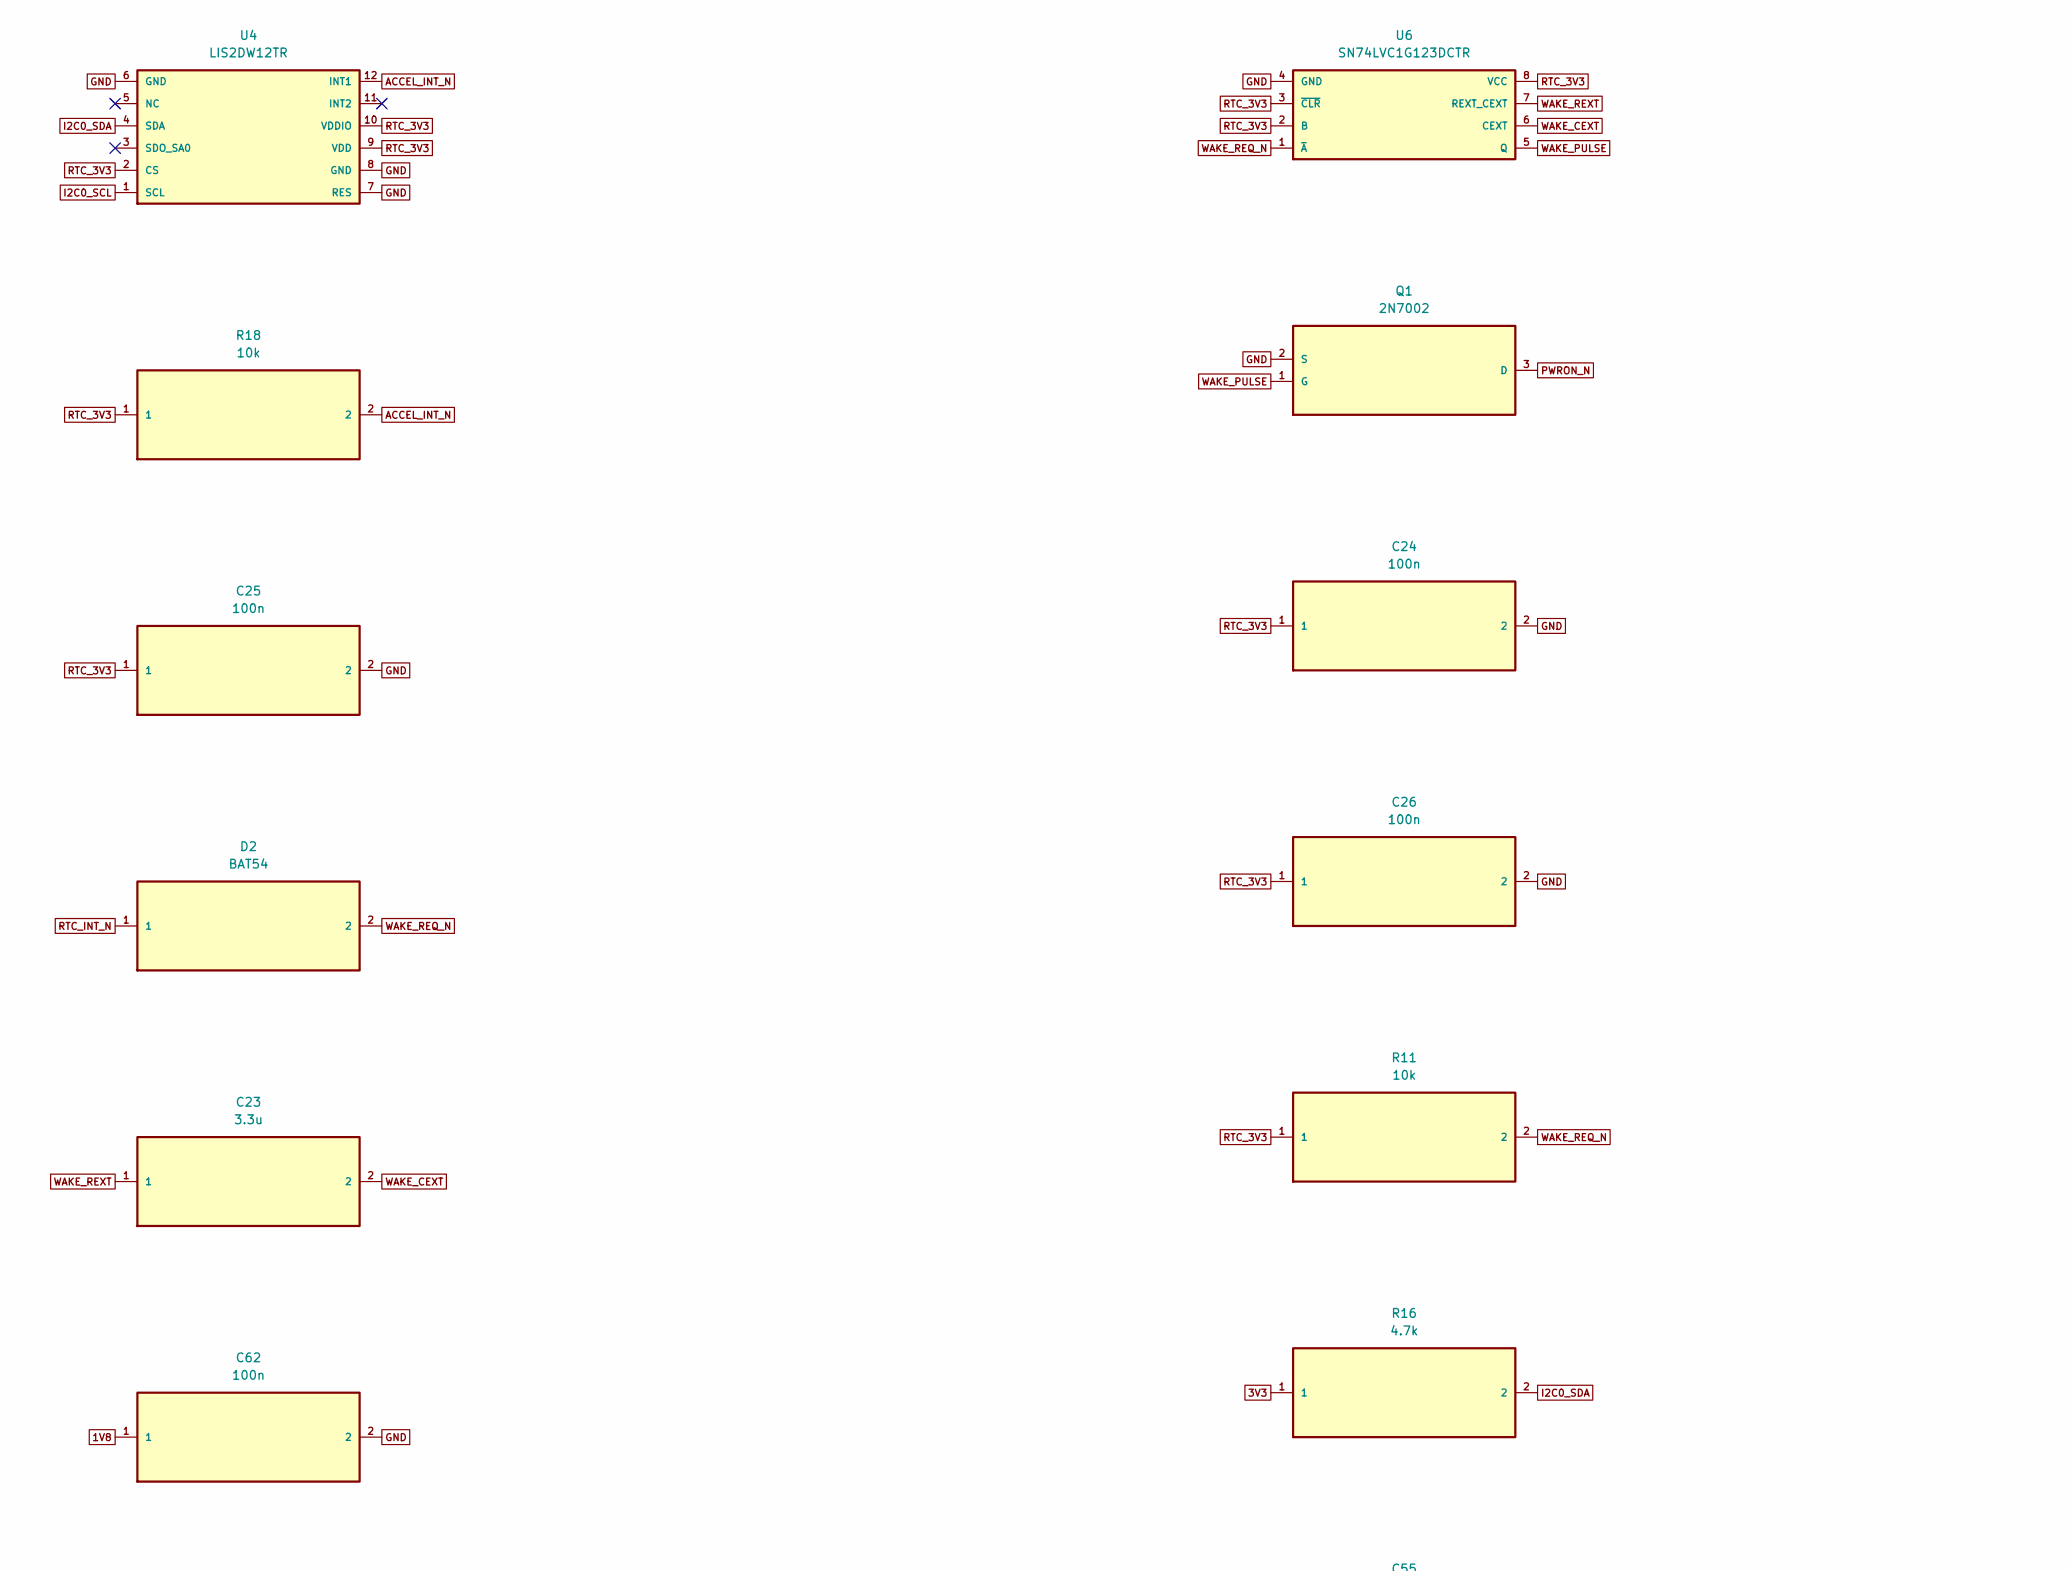
[picture p27: schematic 03_sensors.kicad_sch, 03 Always-on Sensors / Wake, part in row 1, column 1]

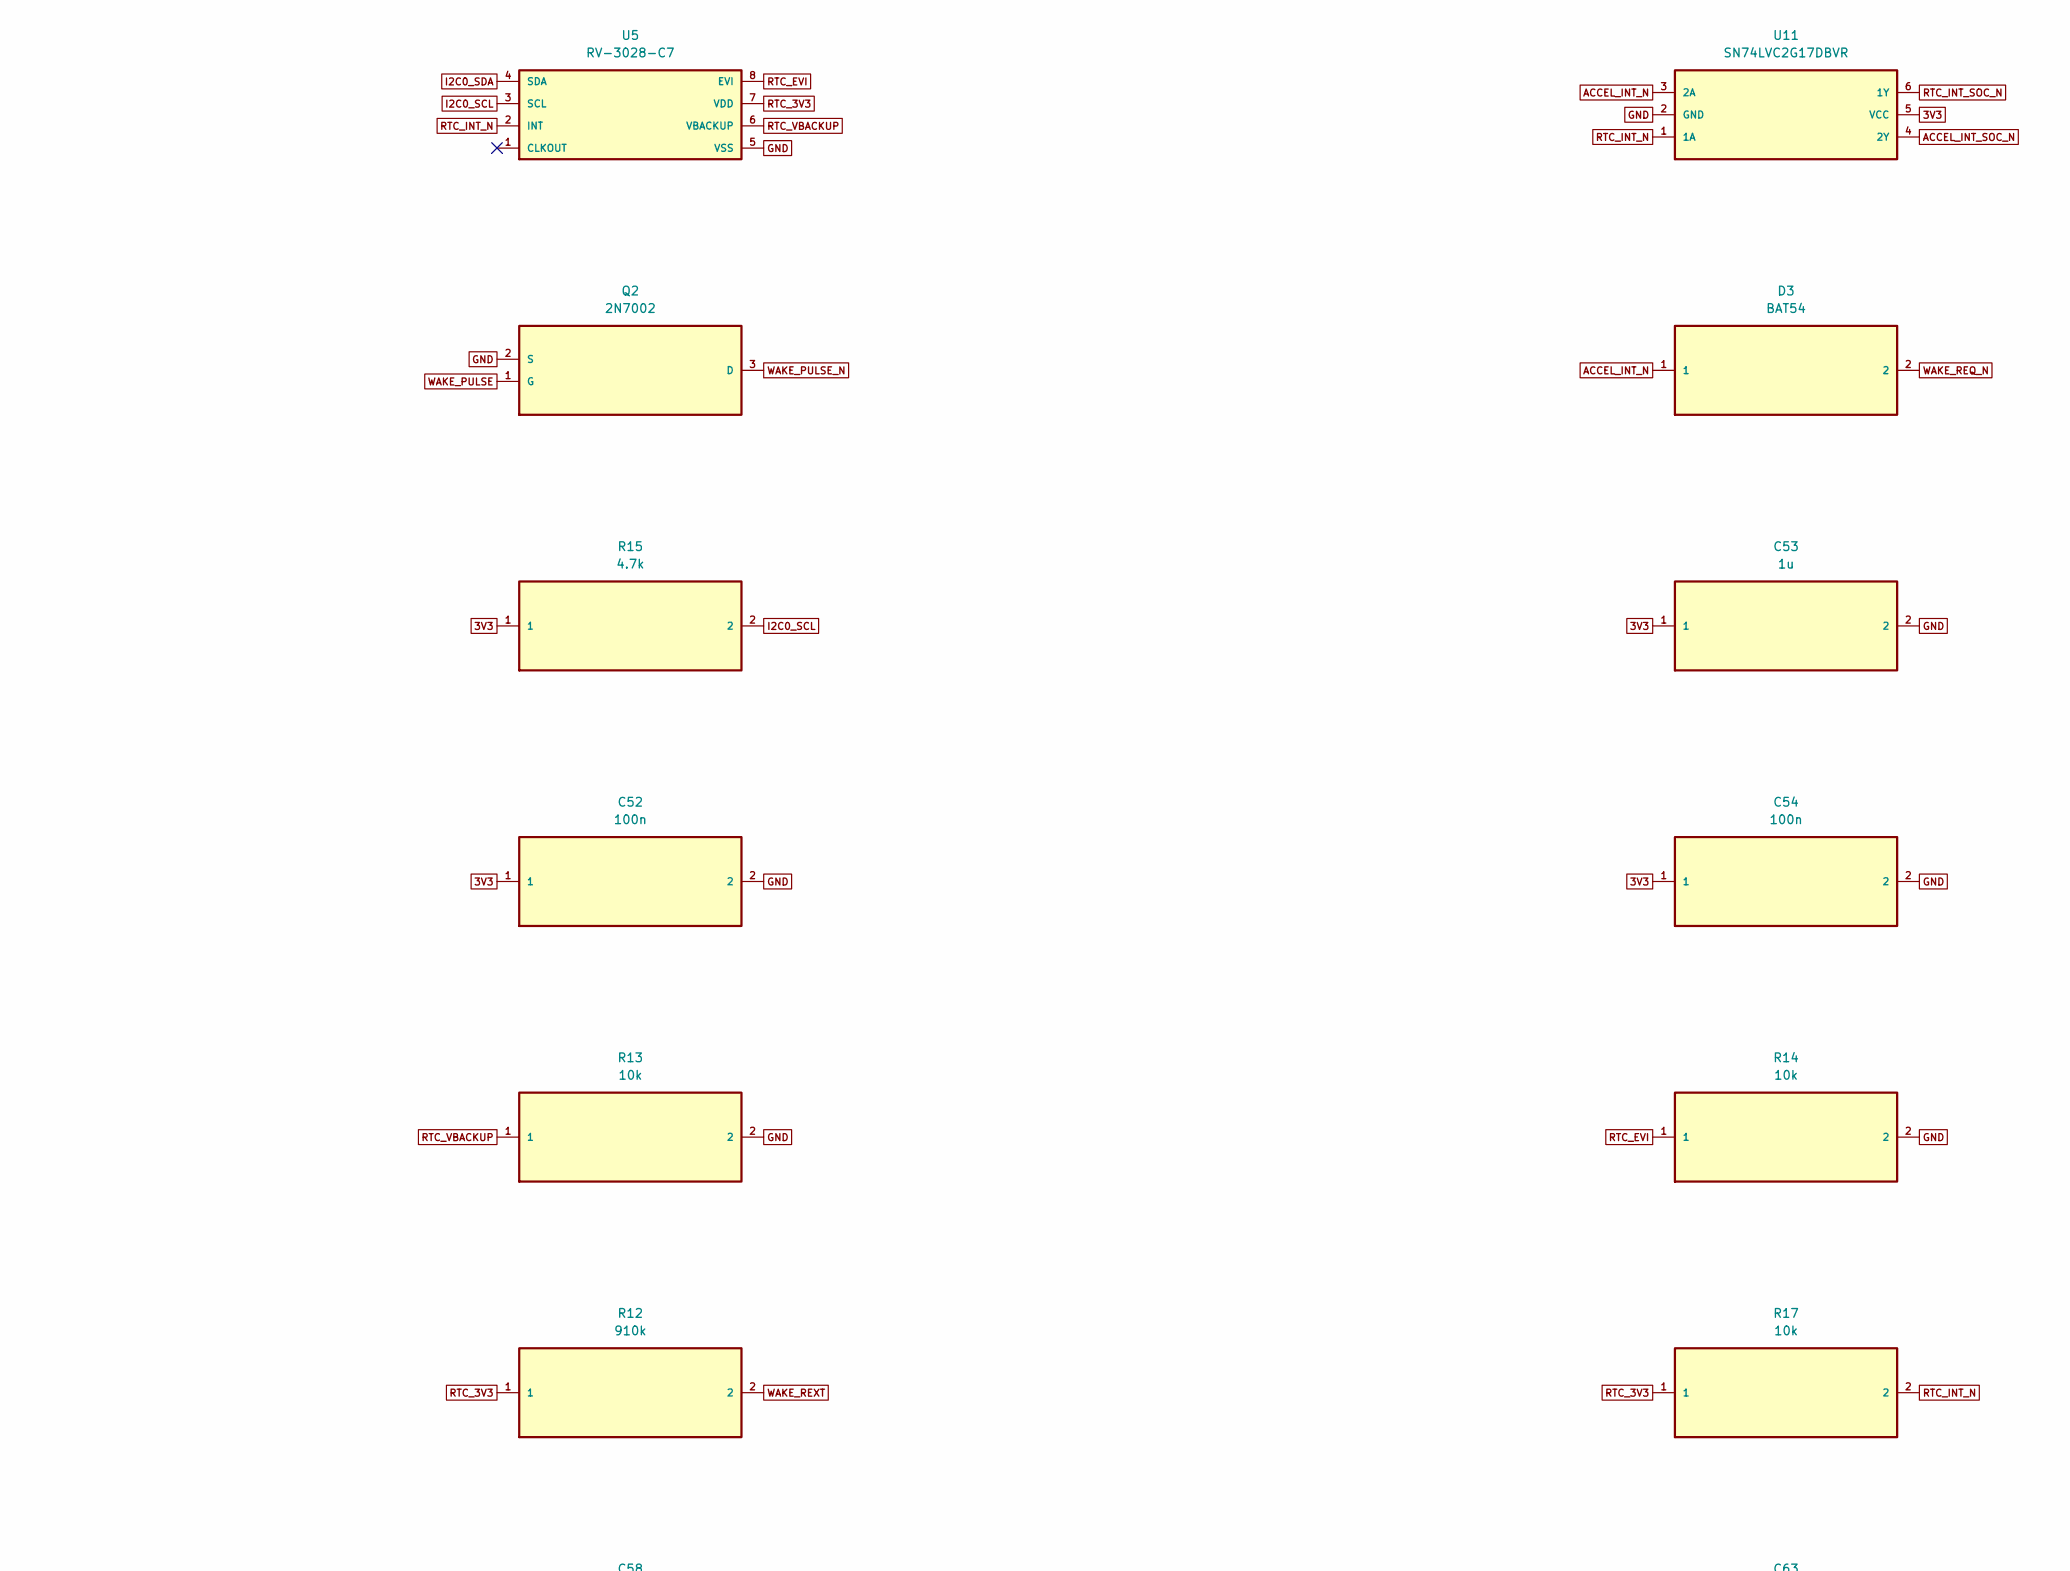
[picture p28: schematic 03_sensors.kicad_sch, 03 Always-on Sensors / Wake, part in row 1, column 2]

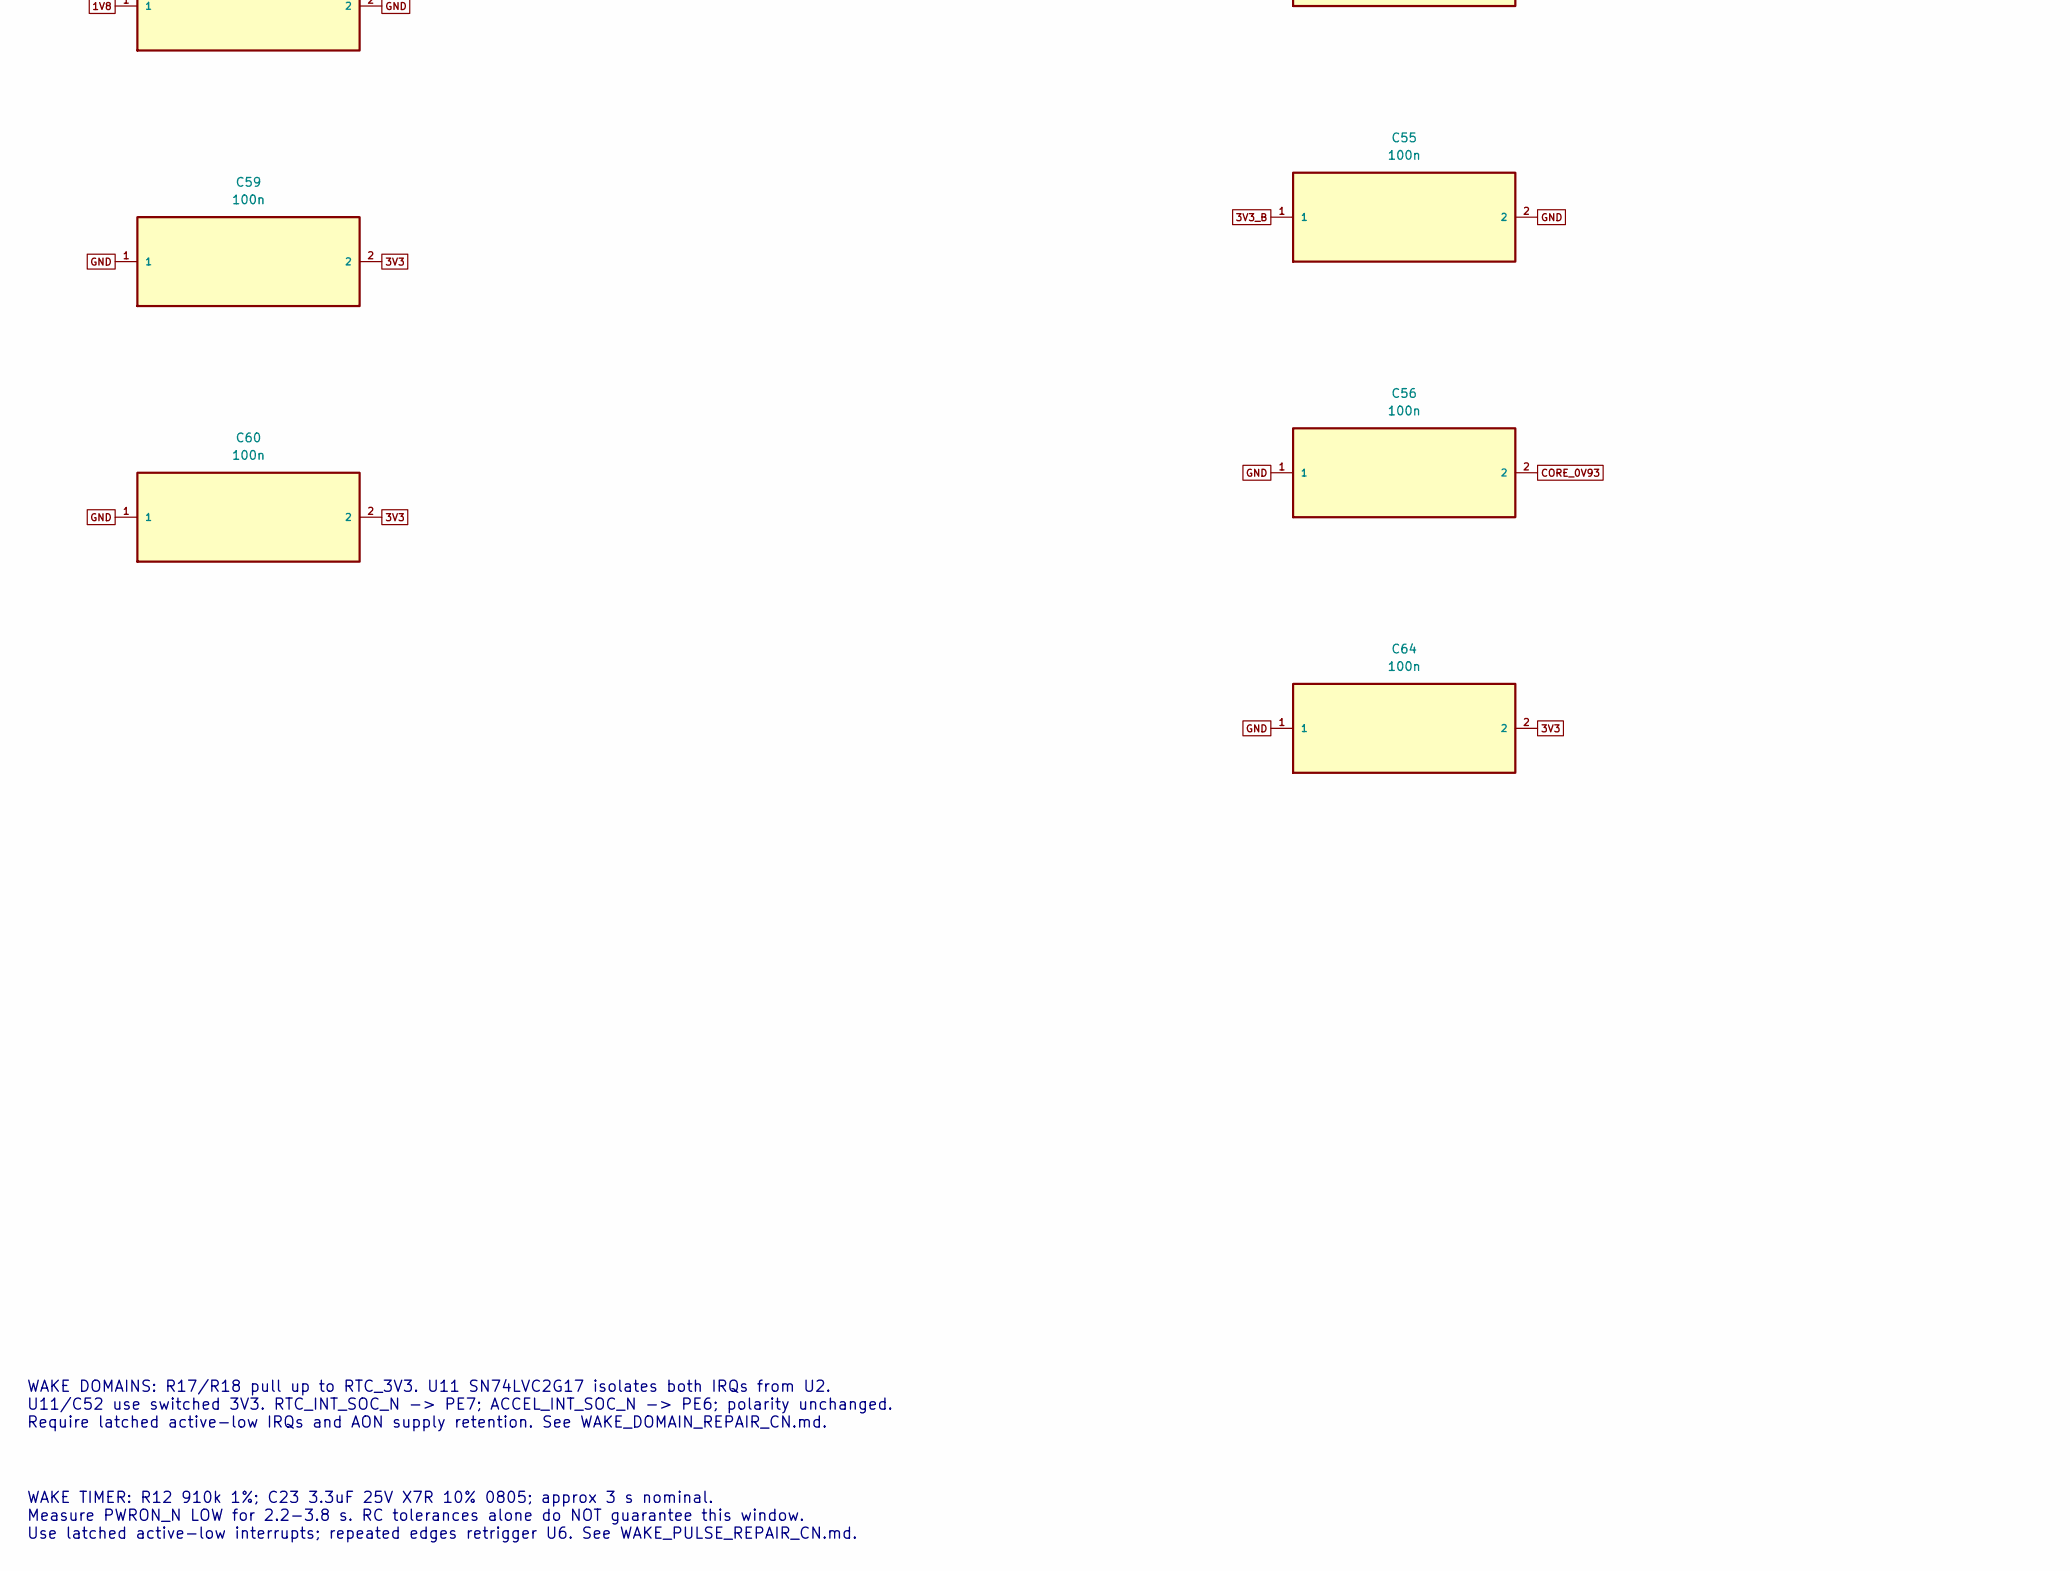
[picture p29: schematic 03_sensors.kicad_sch, 03 Always-on Sensors / Wake, part in row 2, column 1]

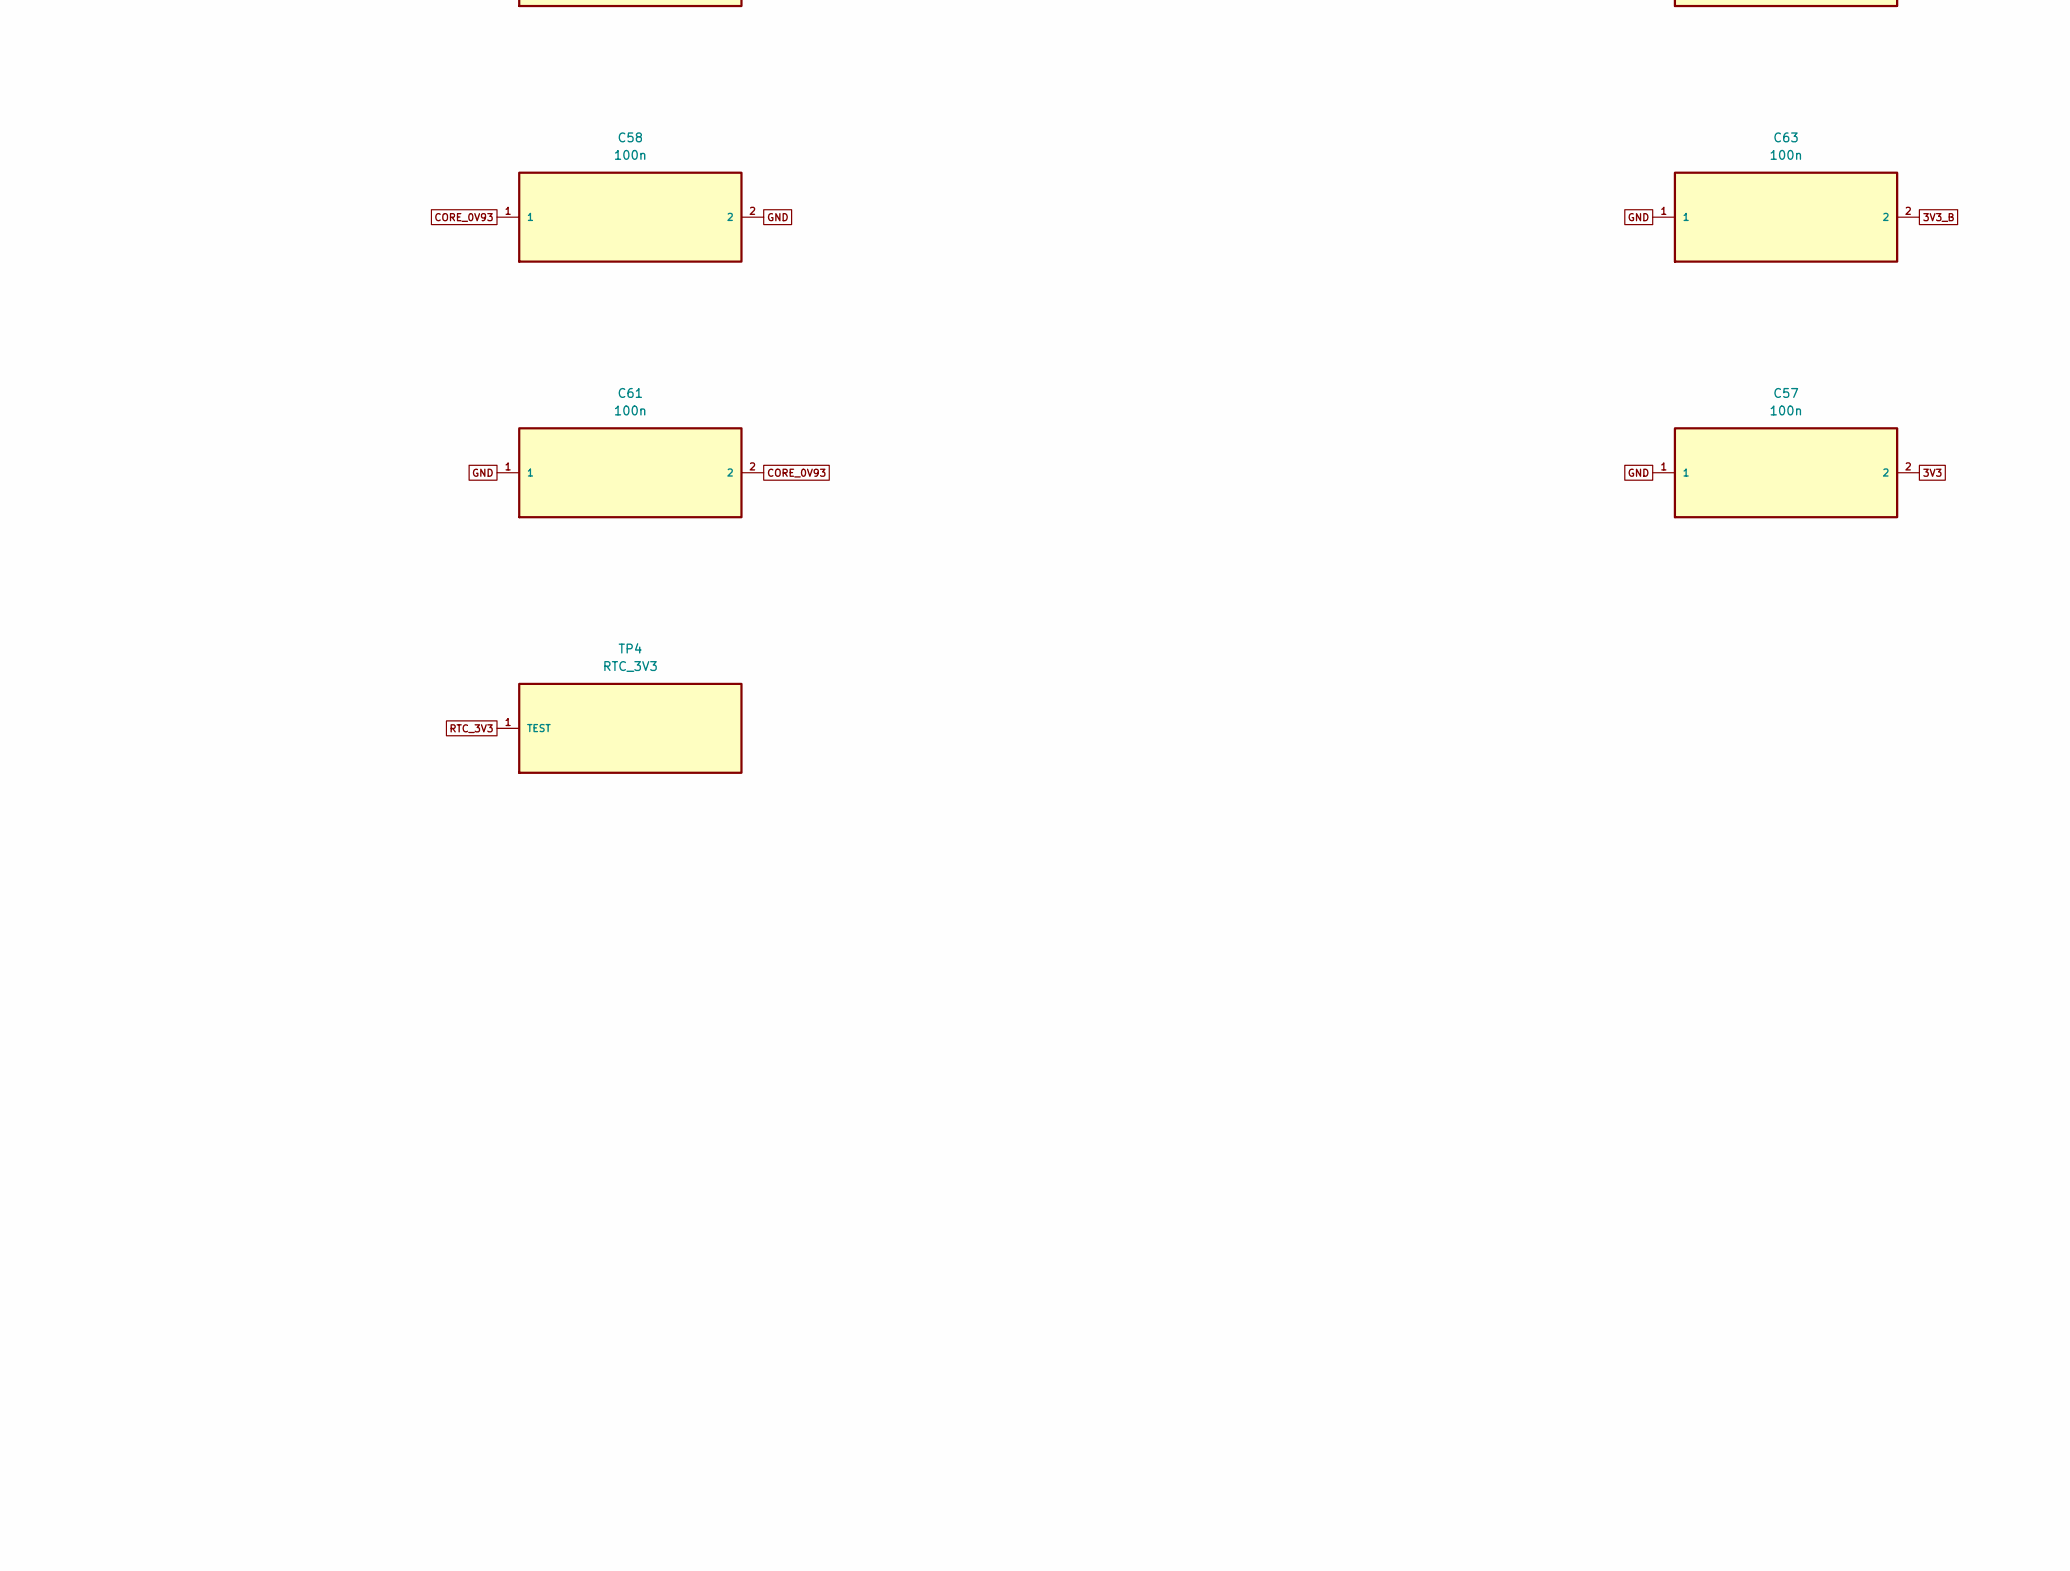
[picture p30: schematic 03_sensors.kicad_sch, 03 Always-on Sensors / Wake, part in row 2, column 2]

Parts:
C23: 3.3u; C_0805_2012Metric; MPN TCC0805X7R335K250FT; LCSC C7393948
C24, C25, C26, C52: 100n; 0402; LCSC C1525
C53: 1u; 0402; MPN CL05A105KA5NQNC; LCSC C52923
C54, C55, C56, C57, C58, C59, C60, C61, C62, C63, C64: 100n; 0402; MPN CL05B104KO5NNNC; LCSC C1525
D2, D3: BAT54; D_SOD123; MPN BAT54W; LCSC C699107
Q1, Q2: 2N7002; SOT23-3; MPN 2N7002; LCSC C8545
R11, R13, R14, R17, R18: 10k; 0402; MPN 0402WGF1002TCE; LCSC C25744
R12: 910k; 0402; MPN AECR0402F910KK9; LCSC C352384
R15, R16: 4.7k; 0402; MPN 0402WGF4701TCE; LCSC C25900
TP4: RTC_3V3; TestPoint_Pad_D1.0mm
U4: LIS2DW12TR; LGA-12; MPN LIS2DW12TR; LCSC C189624
U5: RV-3028-C7; RTC-8; MPN RV-3028-C7-32.768kHz-1ppm-TA-QC; LCSC C3019759
U6: SN74LVC1G123DCTR; SN74LVC1G123_DCT8; MPN SN74LVC1G123DCTR; LCSC C123302
U11: SN74LVC2G17DBVR; SN74LVC2G17_DBV6; MPN SN74LVC2G17DBVR; LCSC C10429

Connections:
1V8: C62.1; also elsewhere on the board
3V3: C52.1, C53.1, C54.1, C57.2, C59.2, C60.2, C64.2, R15.1, R16.1, U11.5 (VCC); also elsewhere on the board
3V3_B: C55.1, C63.2; also elsewhere on the board
ACCEL_INT_N: D3.1, R18.2, U4.12 (INT1), U11.3 (2A)
ACCEL_INT_SOC_N: U11.4 (2Y); also elsewhere on the board
CORE_0V93: C56.2, C58.1, C61.2; also elsewhere on the board
GND: C24.2, C25.2, C26.2, C52.2, C53.2, C54.2, C55.2, C56.1, C57.1, C58.2, C59.1, C60.1, C61.1, C62.2, C63.1, C64.1, Q1.2 (S), Q2.2 (S), R13.2, R14.2, U4.6 (GND), U4.7 (RES), U4.8 (GND), U5.5 (VSS), U6.4 (GND), U11.2 (GND); also elsewhere on the board
I2C0_SCL: R15.2, U4.1 (SCL), U5.3 (SCL); also elsewhere on the board
I2C0_SDA: R16.2, U4.4 (SDA), U5.4 (SDA); also elsewhere on the board
PWRON_N: Q1.3 (D); also elsewhere on the board
RTC_3V3: C24.1, C25.1, C26.1, R11.1, R12.1, R17.1, R18.1, TP4.1 (TEST), U4.2 (CS), U4.9 (VDD), U4.10 (VDDIO), U5.7 (VDD), U6.2 (B), U6.3 (/CLR), U6.8 (VCC); also elsewhere on the board
RTC_EVI: R14.1, U5.8 (EVI)
RTC_INT_N: D2.1, R17.2, U5.2 (INT), U11.1 (1A)
RTC_INT_SOC_N: U11.6 (1Y); also elsewhere on the board
RTC_VBACKUP: R13.1, U5.6 (VBACKUP)
WAKE_CEXT: C23.2, U6.6 (CEXT)
WAKE_PULSE: Q1.1 (G), Q2.1 (G), U6.5 (Q)
WAKE_PULSE_N: Q2.3 (D); also elsewhere on the board
WAKE_REQ_N: D2.2, D3.2, R11.2, U6.1 (/A)
WAKE_REXT: C23.1, R12.2, U6.7 (REXT_CEXT)

Notes on the sheet:
WAKE DOMAINS: R17/R18 pull up to RTC_3V3. U11 SN74LVC2G17 isolates both IRQs from U2. U11/C52 use switched 3V3. RTC_INT_SOC_N -> PE7; ACCEL_INT_SOC_N -> PE6; polarity unchanged. Require latched active-low IRQs and AON supply retention. See WAKE_DOMAIN_REPAIR_CN.md.
WAKE TIMER: R12 910k 1%; C23 3.3uF 25V X7R 10% 0805; approx 3 s nominal. Measure PWRON_N LOW for 2.2-3.8 s. RC tolerances alone do NOT guarantee this window. Use latched active-low interrupts; repeated edges retrigger U6. See WAKE_PULSE_REPAIR_CN.md.
