LeeSpo/portable-display-epass-EVT1-minboot-r1/portable-display/hardware/v1-WEB6-redesign/split-power-candidate/ak_display_38x64_SPLIT_POWER_CANDIDATE.kicad_pcb

## KiCad design portable-display/hardware/v1-WEB6-redesign/split-power-candidate/ak_display_38x64_SPLIT_POWER_CANDIDATE.kicad_pcb (continued)

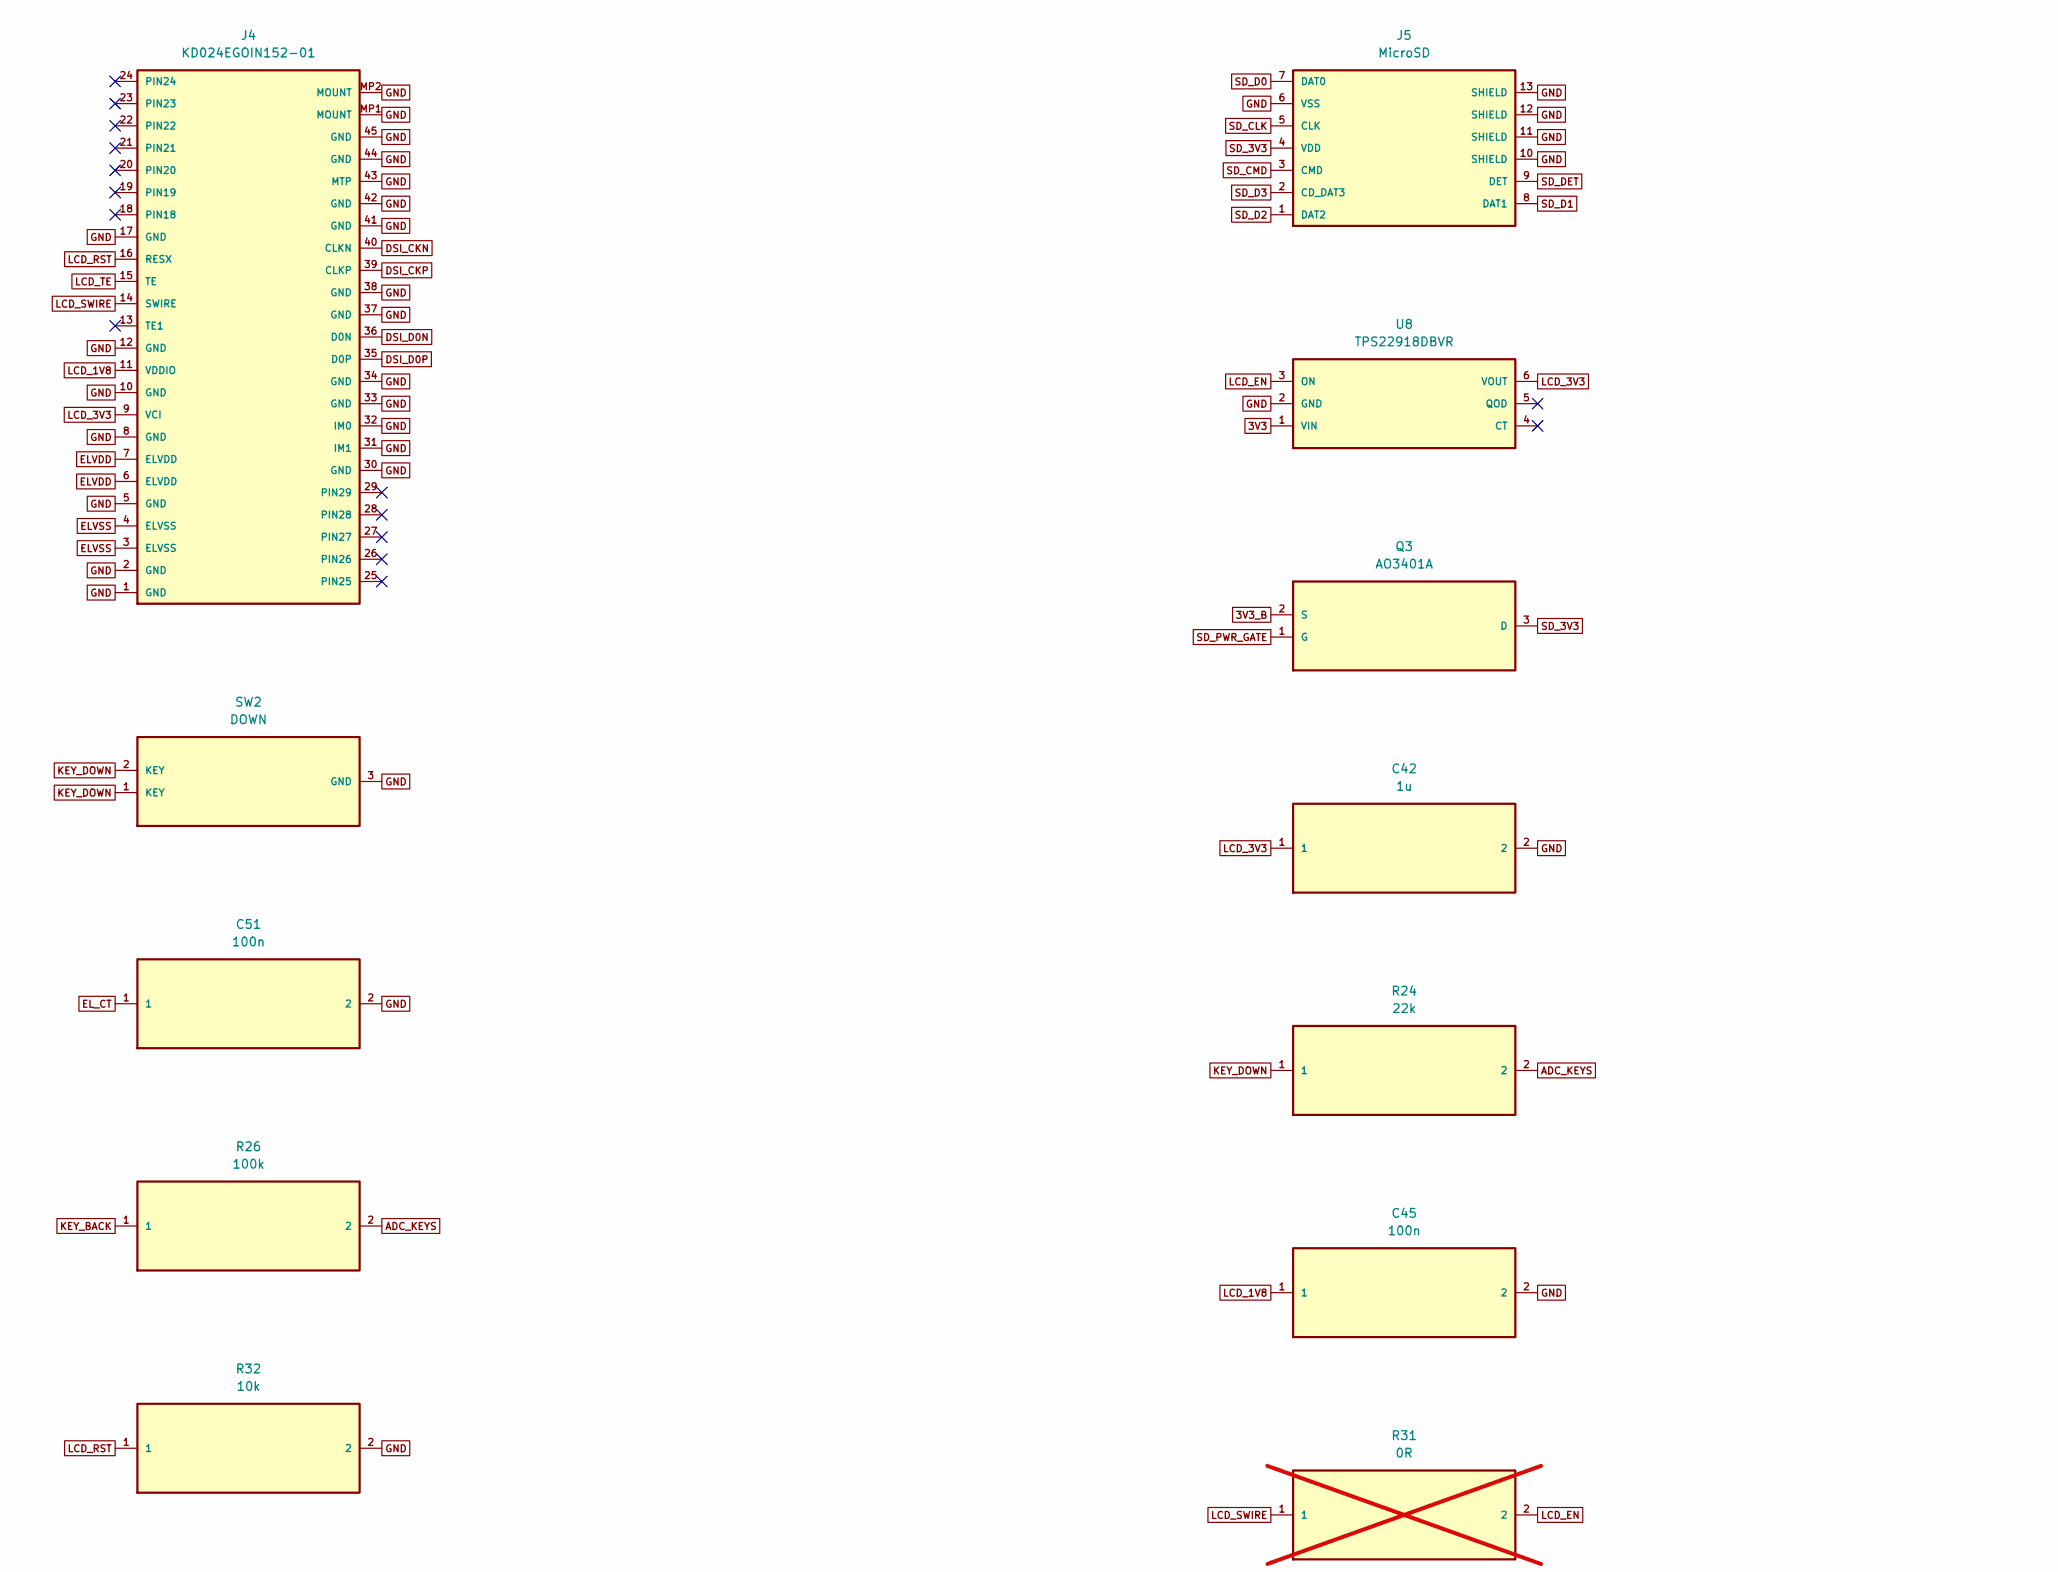
[picture p31: schematic 04_interfaces.kicad_sch, 04 Display / SD / Buttons, part in row 1, column 1]

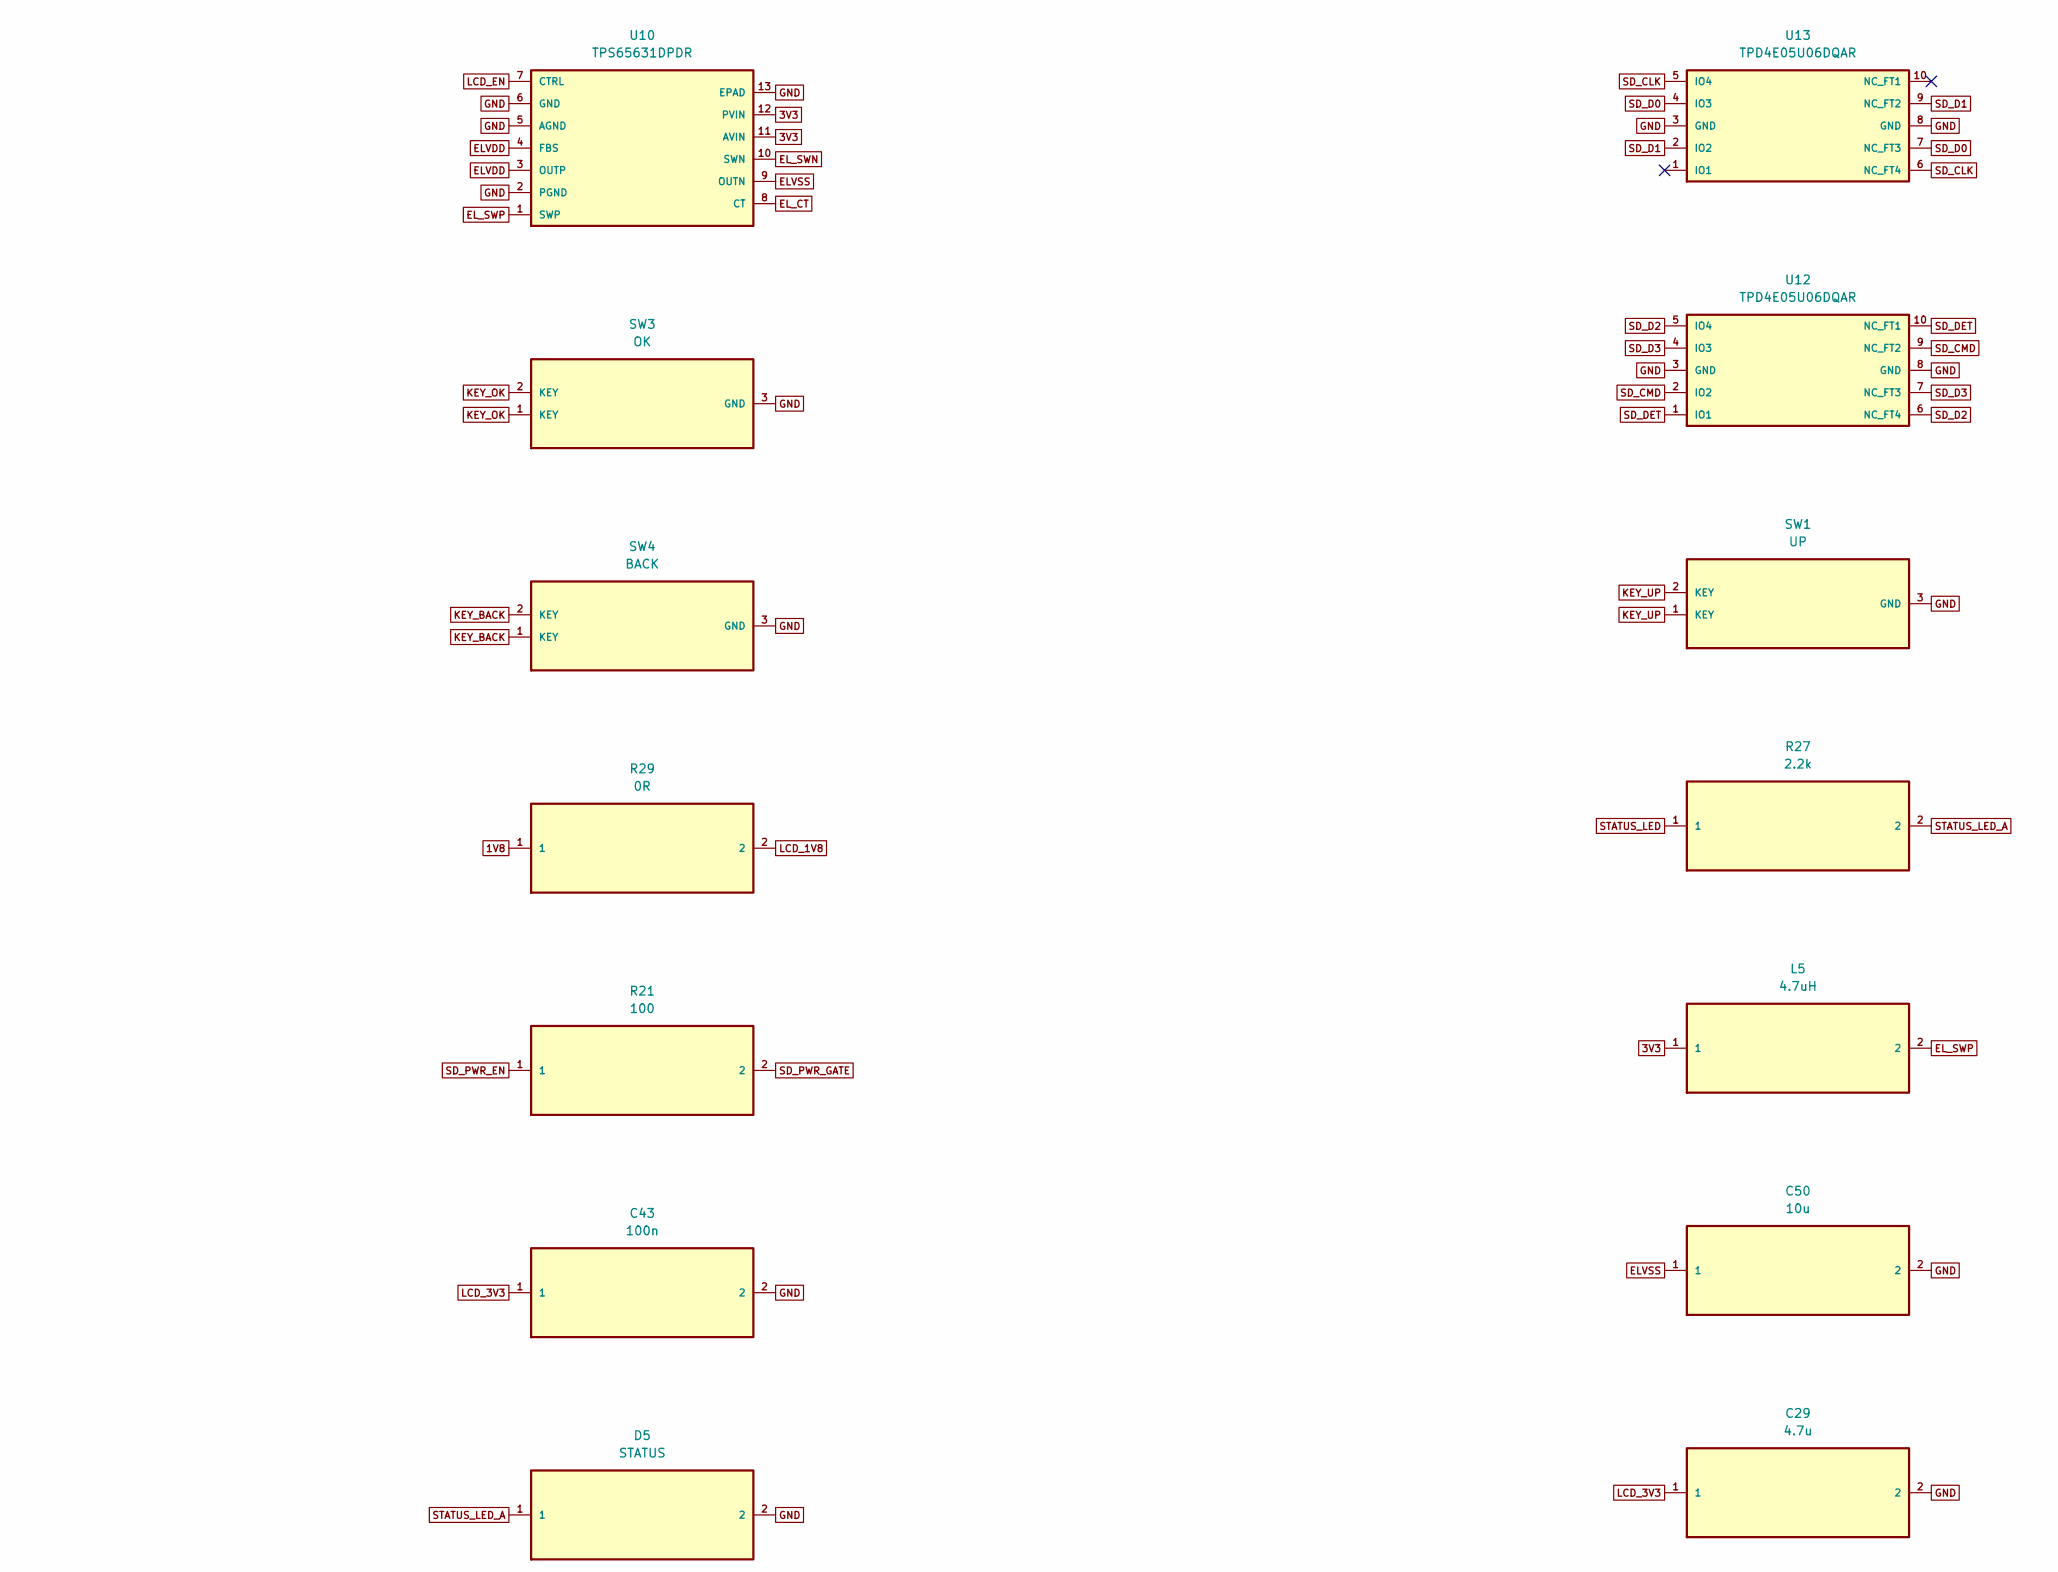
[picture p32: schematic 04_interfaces.kicad_sch, 04 Display / SD / Buttons, part in row 1, column 2]

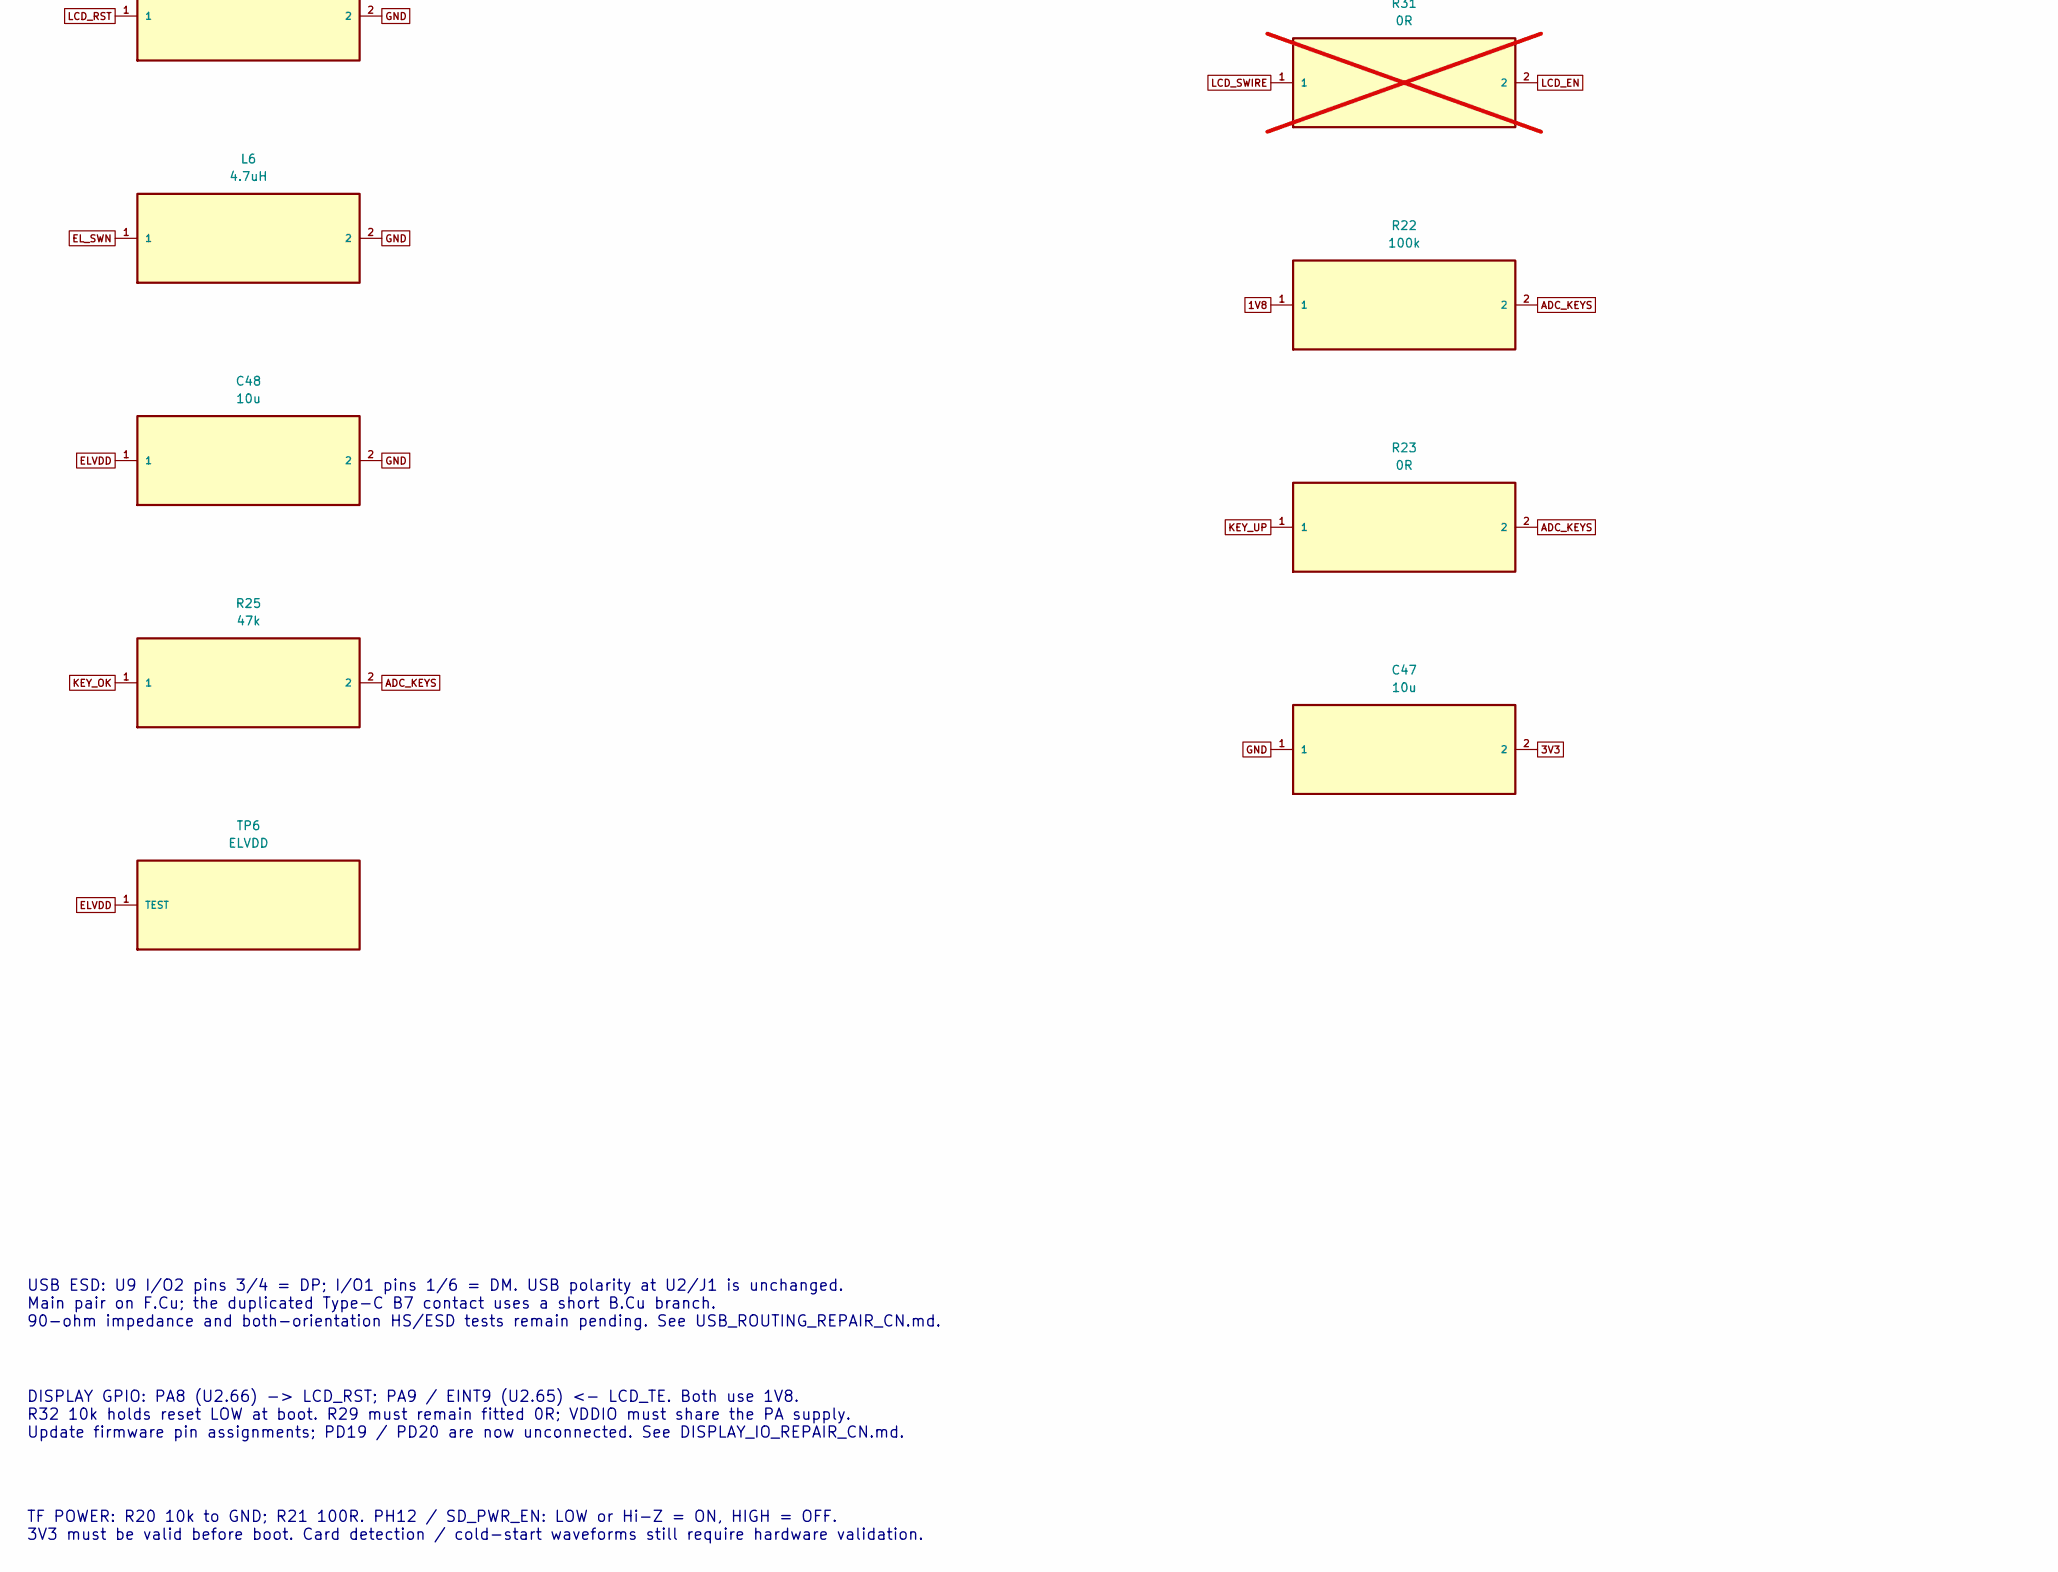
[picture p33: schematic 04_interfaces.kicad_sch, 04 Display / SD / Buttons, part in row 2, column 1]

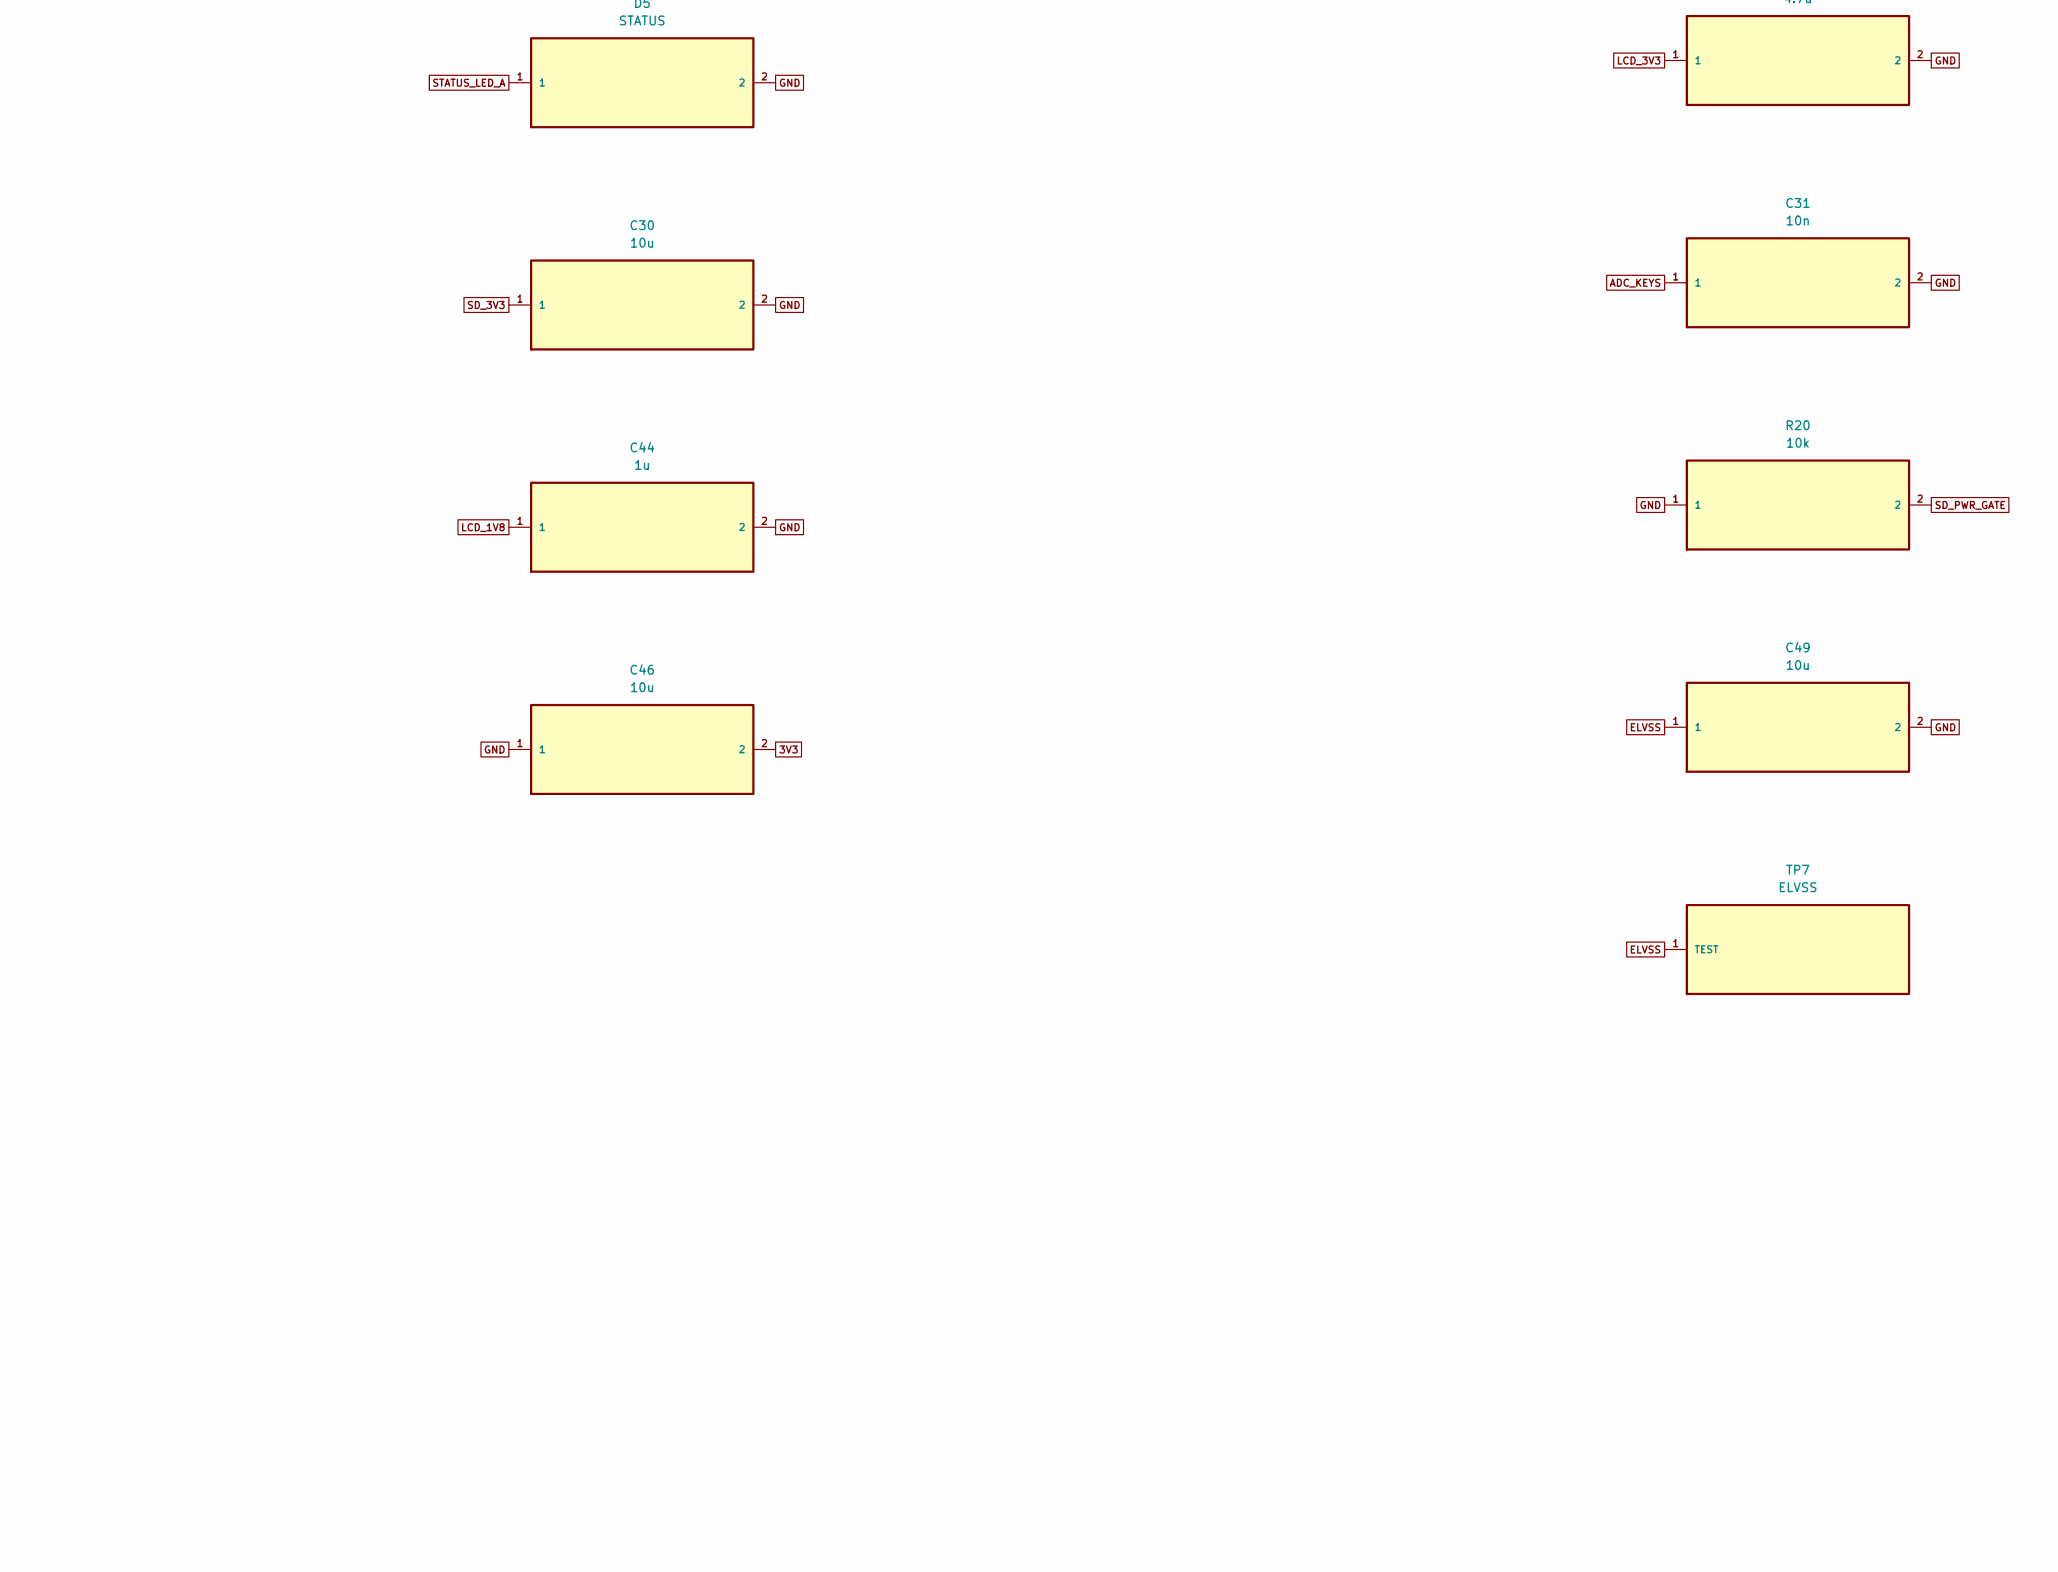
[picture p34: schematic 04_interfaces.kicad_sch, 04 Display / SD / Buttons, part in row 2, column 2]

Parts:
C29: 4.7u; 0603; MPN CL10A475KO8NNNC; LCSC C19666
C30, C48, C49, C50: 10u; 0603; MPN CL10A106KP8NNNC; LCSC C19702
C31: 10n; 0402; MPN CL05B103KB5NNNC; LCSC C15195
C42, C44: 1u; 0603; MPN CL10A105KB8NNNC; LCSC C15849
C43, C45, C51: 100n; 0402; MPN CL05B104KO5NNNC; LCSC C1525
C46, C47: 10u; 0402; MPN CL05A106MQ5NUNC; LCSC C15525
D5: STATUS; LED0603; MPN KT-0603B; LCSC C2288
J4: KD024EGOIN152-01; FPC45; MPN 502598-4593; LCSC C5365339
J5: MicroSD; XKTF-0803-0; MPN XKTF-0803-0; LCSC C381083
L5, L6: 4.7uH; IND_2x2; MPN WPN201610U4R7MT; LCSC C97018
Q3: AO3401A; SOT23-3; MPN AO3401A; LCSC C15127
R20, R32: 10k; 0402; MPN 0402WGF1002TCE; LCSC C25744
R21: 100; 0402; MPN 0402WGF1000TCE; LCSC C25076
R22, R26: 100k; 0402; MPN 0402WGF1003TCE; LCSC C25741
R23, R29: 0R; 0402; MPN 0402WGF0000TCE; LCSC C17168
R24: 22k; 0402; MPN 0402WGF2202TCE; LCSC C25768
R25: 47k; 0402; MPN 0402WGF4702TCE; LCSC C25792
R27: 2.2k; 0402; MPN 0402WGF2201TCE; LCSC C25879
R31: 0R; 0402; not fitted
SW1: UP; SW_SIDE; MPN GT-TC072B-H045-L1; LCSC C5117859
SW2: DOWN; SW_SIDE; MPN GT-TC072B-H045-L1; LCSC C5117859
SW3: OK; SW_SIDE; MPN GT-TC072B-H045-L1; LCSC C5117859
SW4: BACK; SW_SIDE; MPN GT-TC072B-H045-L1; LCSC C5117859
TP6: ELVDD; TestPoint_Pad_D1.0mm
TP7: ELVSS; TestPoint_Pad_D1.0mm
U8: TPS22918DBVR; TPS22918_DBV6; MPN TPS22918DBVR; LCSC C131941
U10: TPS65631DPDR; WSON-12; MPN TPS65631DPDR; LCSC C165127
U12, U13: TPD4E05U06DQAR; TPD4E05U06_DQA; MPN TPD4E05U06DQAR; LCSC C138714

Connections:
1V8: R22.1, R29.1; also elsewhere on the board
3V3: C46.2, C47.2, L5.1, U8.1 (VIN), U10.11 (AVIN), U10.12 (PVIN); also elsewhere on the board
3V3_B: Q3.2 (S); also elsewhere on the board
ADC_KEYS: C31.1, R22.2, R23.2, R24.2, R25.2, R26.2; also elsewhere on the board
DSI_CKN: J4.40 (CLKN); also elsewhere on the board
DSI_CKP: J4.39 (CLKP); also elsewhere on the board
DSI_D0N: J4.36 (D0N); also elsewhere on the board
DSI_D0P: J4.35 (D0P); also elsewhere on the board
ELVDD: C48.1, J4.6 (ELVDD), J4.7 (ELVDD), TP6.1 (TEST), U10.3 (OUTP), U10.4 (FBS)
ELVSS: C49.1, C50.1, J4.3 (ELVSS), J4.4 (ELVSS), TP7.1 (TEST), U10.9 (OUTN)
EL_CT: C51.1, U10.8 (CT)
EL_SWN: L6.1, U10.10 (SWN)
EL_SWP: L5.2, U10.1 (SWP)
GND: C29.2, C30.2, C31.2, C42.2, C43.2, C44.2, C45.2, C46.1, C47.1, C48.2, C49.2, C50.2, C51.2, D5.2, J4.1 (GND), J4.2 (GND), J4.5 (GND), J4.8 (GND), J4.10 (GND), J4.12 (GND), J4.17 (GND), J4.30 (GND), J4.31 (IM1), J4.32 (IM0), J4.33 (GND), J4.34 (GND), J4.37 (GND), J4.38 (GND), J4.41 (GND), J4.42 (GND), J4.43 (MTP), J4.44 (GND), J4.45 (GND), J4.MP1 (MOUNT), J4.MP2 (MOUNT), J5.6 (VSS), J5.10 (SHIELD), J5.11 (SHIELD), J5.12 (SHIELD), J5.13 (SHIELD), L6.2, R20.1, R32.2, SW1.3 (GND), SW2.3 (GND), SW3.3 (GND), SW4.3 (GND), U8.2 (GND), U10.2 (PGND), U10.5 (AGND), U10.6 (GND), U10.13 (EPAD), U12.3 (GND), U12.8 (GND), U13.3 (GND), U13.8 (GND); also elsewhere on the board
KEY_BACK: R26.1, SW4.1 (KEY), SW4.2 (KEY)
KEY_DOWN: R24.1, SW2.1 (KEY), SW2.2 (KEY)
KEY_OK: R25.1, SW3.1 (KEY), SW3.2 (KEY)
KEY_UP: R23.1, SW1.1 (KEY), SW1.2 (KEY)
LCD_1V8: C44.1, C45.1, J4.11 (VDDIO), R29.2
LCD_3V3: C29.1, C42.1, C43.1, J4.9 (VCI), U8.6 (VOUT)
LCD_EN: R31.2, U8.3 (ON), U10.7 (CTRL); also elsewhere on the board
LCD_RST: J4.16 (RESX), R32.1; also elsewhere on the board
LCD_SWIRE: J4.14 (SWIRE), R31.1
LCD_TE: J4.15 (TE); also elsewhere on the board
SD_3V3: C30.1, J5.4 (VDD), Q3.3 (D)
SD_CLK: J5.5 (CLK), U13.5 (IO4), U13.6 (NC_FT4); also elsewhere on the board
SD_CMD: J5.3 (CMD), U12.2 (IO2), U12.9 (NC_FT2); also elsewhere on the board
SD_D0: J5.7 (DAT0), U13.4 (IO3), U13.7 (NC_FT3); also elsewhere on the board
SD_D1: J5.8 (DAT1), U13.2 (IO2), U13.9 (NC_FT2); also elsewhere on the board
SD_D2: J5.1 (DAT2), U12.5 (IO4), U12.6 (NC_FT4); also elsewhere on the board
SD_D3: J5.2 (CD_DAT3), U12.4 (IO3), U12.7 (NC_FT3); also elsewhere on the board
SD_DET: J5.9 (DET), U12.1 (IO1), U12.10 (NC_FT1); also elsewhere on the board
SD_PWR_EN: R21.1; also elsewhere on the board
SD_PWR_GATE: Q3.1 (G), R20.2, R21.2
STATUS_LED: R27.1; also elsewhere on the board
STATUS_LED_A: D5.1, R27.2

Notes on the sheet:
USB ESD: U9 I/O2 pins 3/4 = DP; I/O1 pins 1/6 = DM. USB polarity at U2/J1 is unchanged. Main pair on F.Cu; the duplicated Type-C B7 contact uses a short B.Cu branch. 90-ohm impedance and both-orientation HS/ESD tests remain pending. See USB_ROUTING_REPAIR_CN.md.
TF POWER: R20 10k to GND; R21 100R. PH12 / SD_PWR_EN: LOW or Hi-Z = ON, HIGH = OFF. 3V3 must be valid before boot. Card detection / cold-start waveforms still require hardware validation.
DISPLAY GPIO: PA8 (U2.66) -> LCD_RST; PA9 / EINT9 (U2.65) <- LCD_TE. Both use 1V8. R32 10k holds reset LOW at boot. R29 must remain fitted 0R; VDDIO must share the PA supply. Update firmware pin assignments; PD19 / PD20 are now unconnected. See DISPLAY_IO_REPAIR_CN.md.

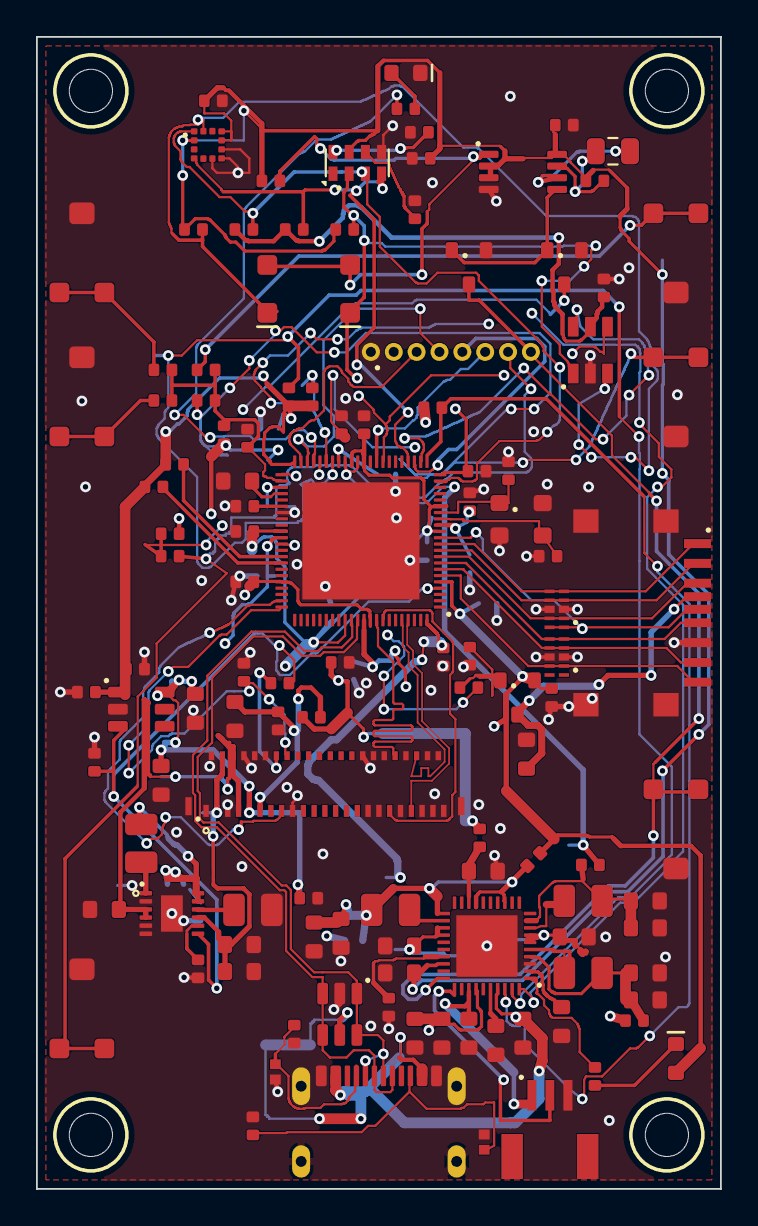
[picture p35: board ak_display_38x64_SPLIT_POWER_CANDIDATE.kicad_pcb from above]

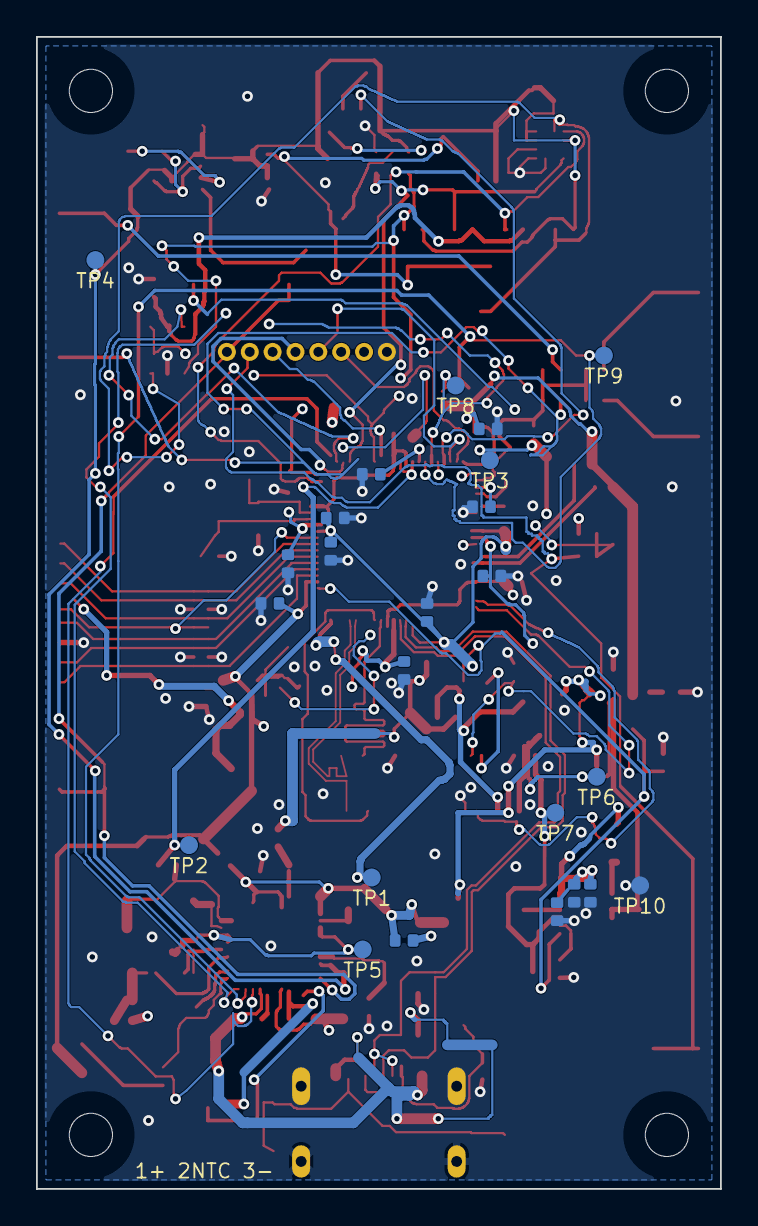
[picture p36: board ak_display_38x64_SPLIT_POWER_CANDIDATE.kicad_pcb from below]

Board: 4 copper layers, 38.0 x 64.0 mm, 147 parts (24 on the bottom side), 89 nets.

Other parts of the board:
H1: M2; MountingHole_1
H2: M2; MountingHole_2
H3: M2; MountingHole_3
H4: M2; MountingHole_4
