LeeSpo/portable-display-epass-EVT1-minboot-r1/01_power.kicad_sch

## KiCad design 01_power.kicad_sch (2026-09-05)

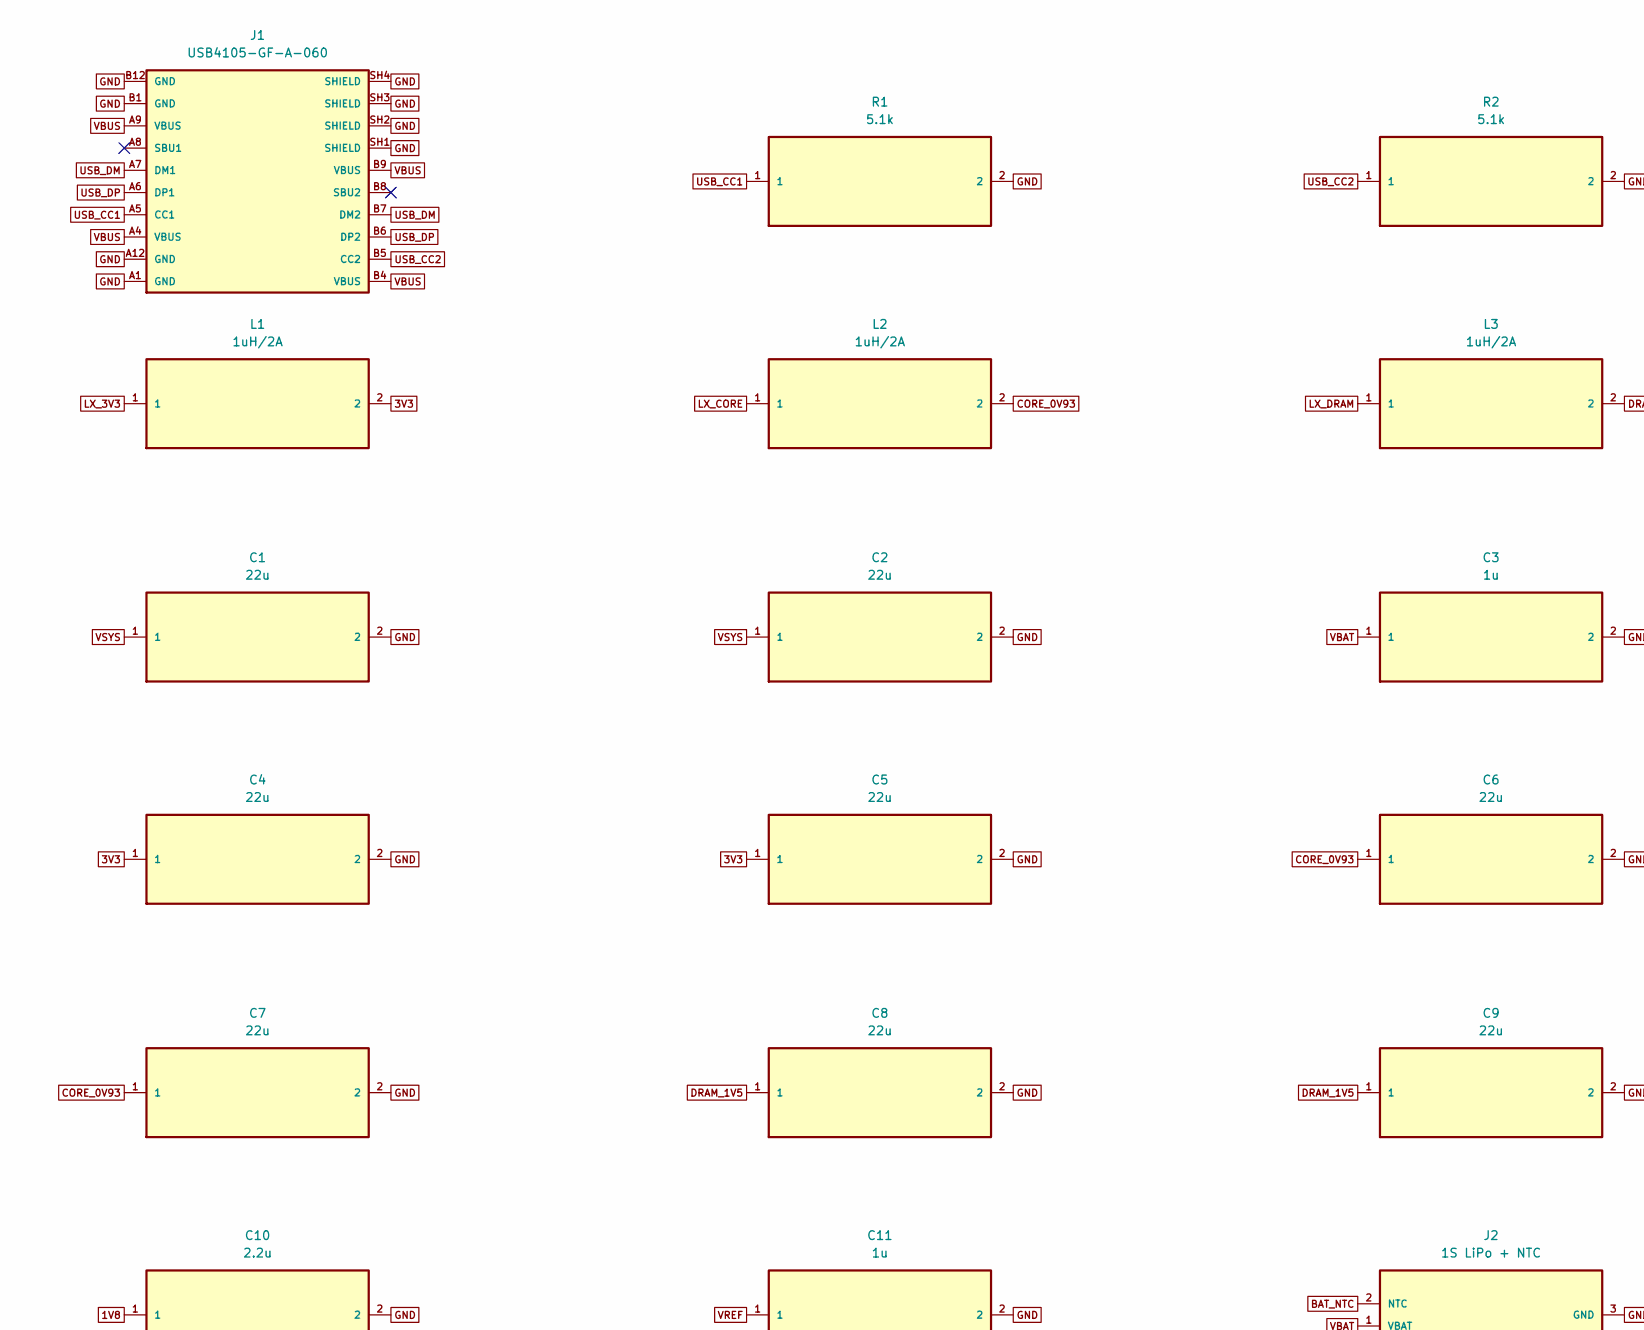
[picture p37: schematic 01_power.kicad_sch, part in row 1, column 1]

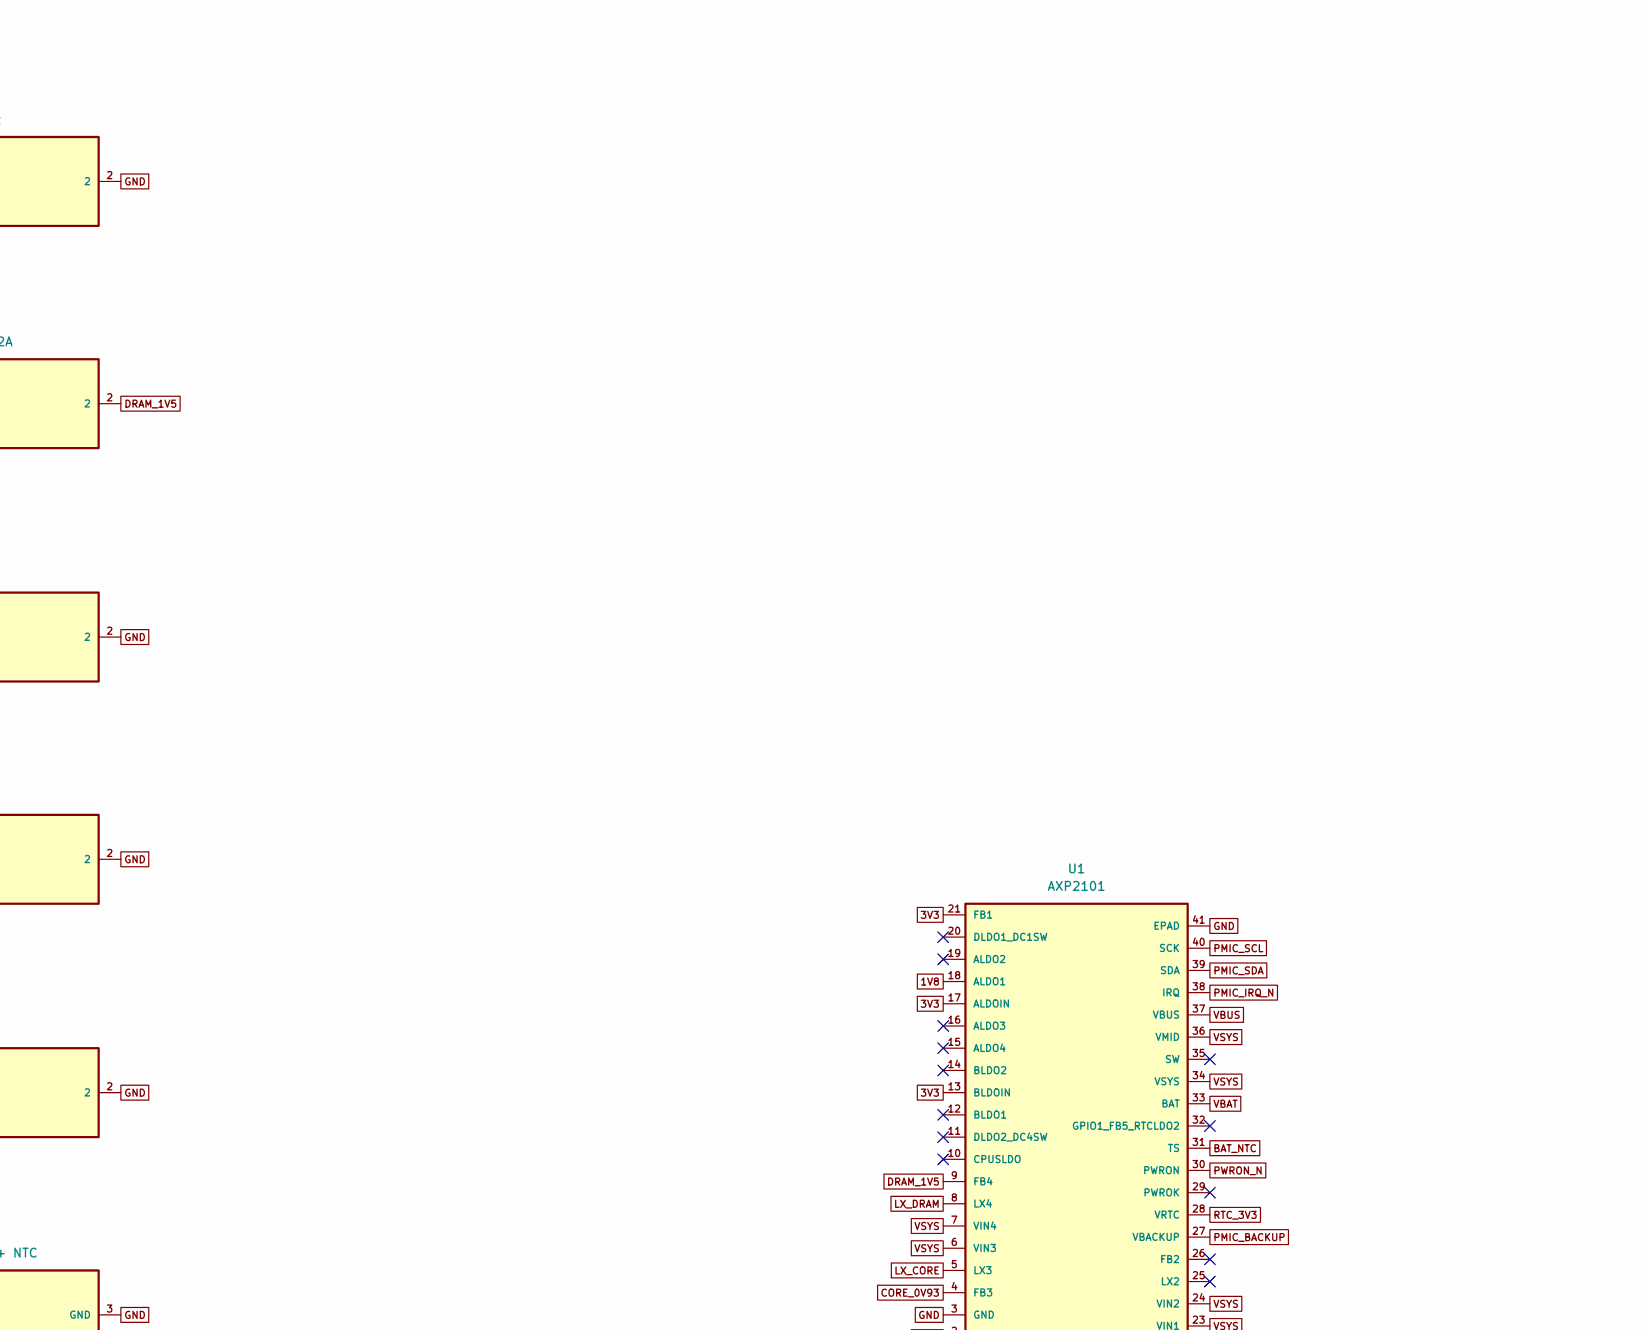
[picture p38: schematic 01_power.kicad_sch, part in row 1, column 2]

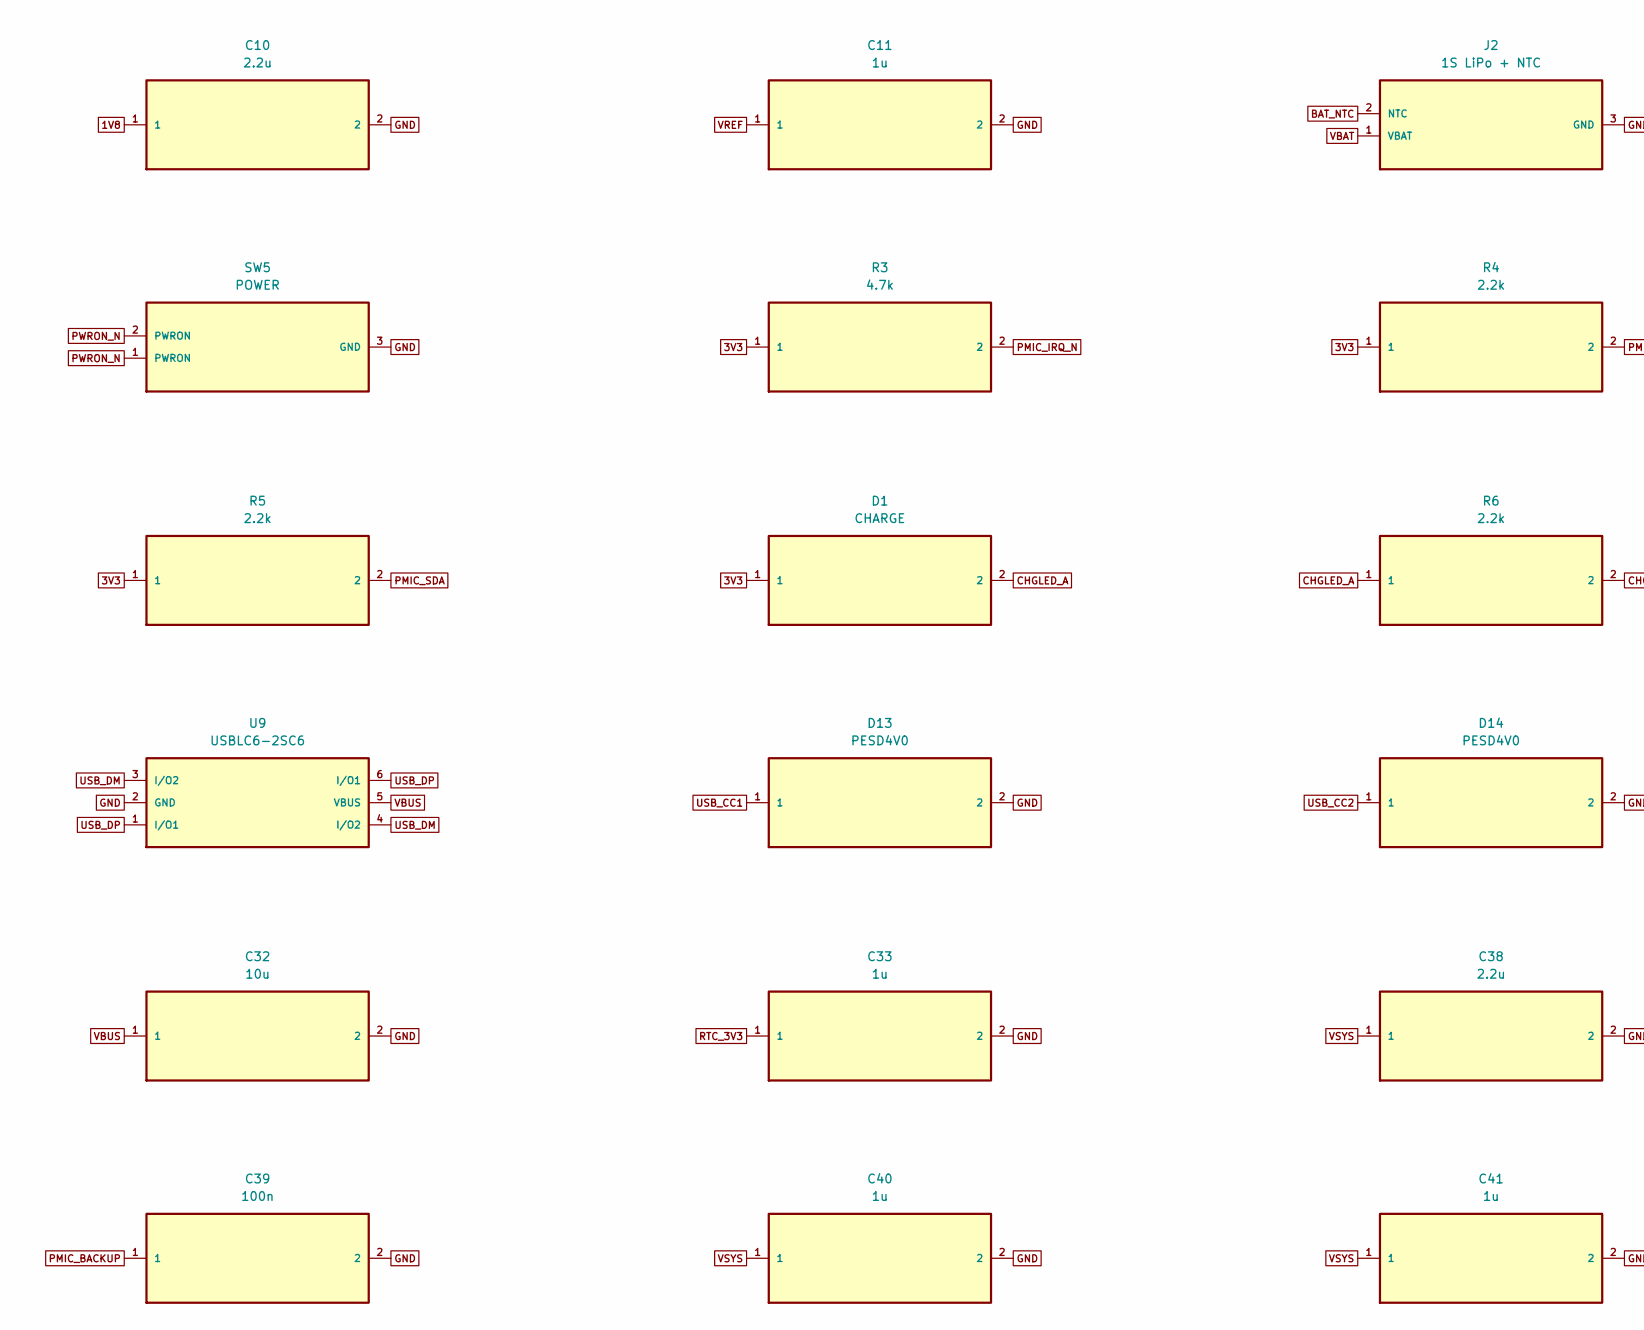
[picture p39: schematic 01_power.kicad_sch, part in row 2, column 1]

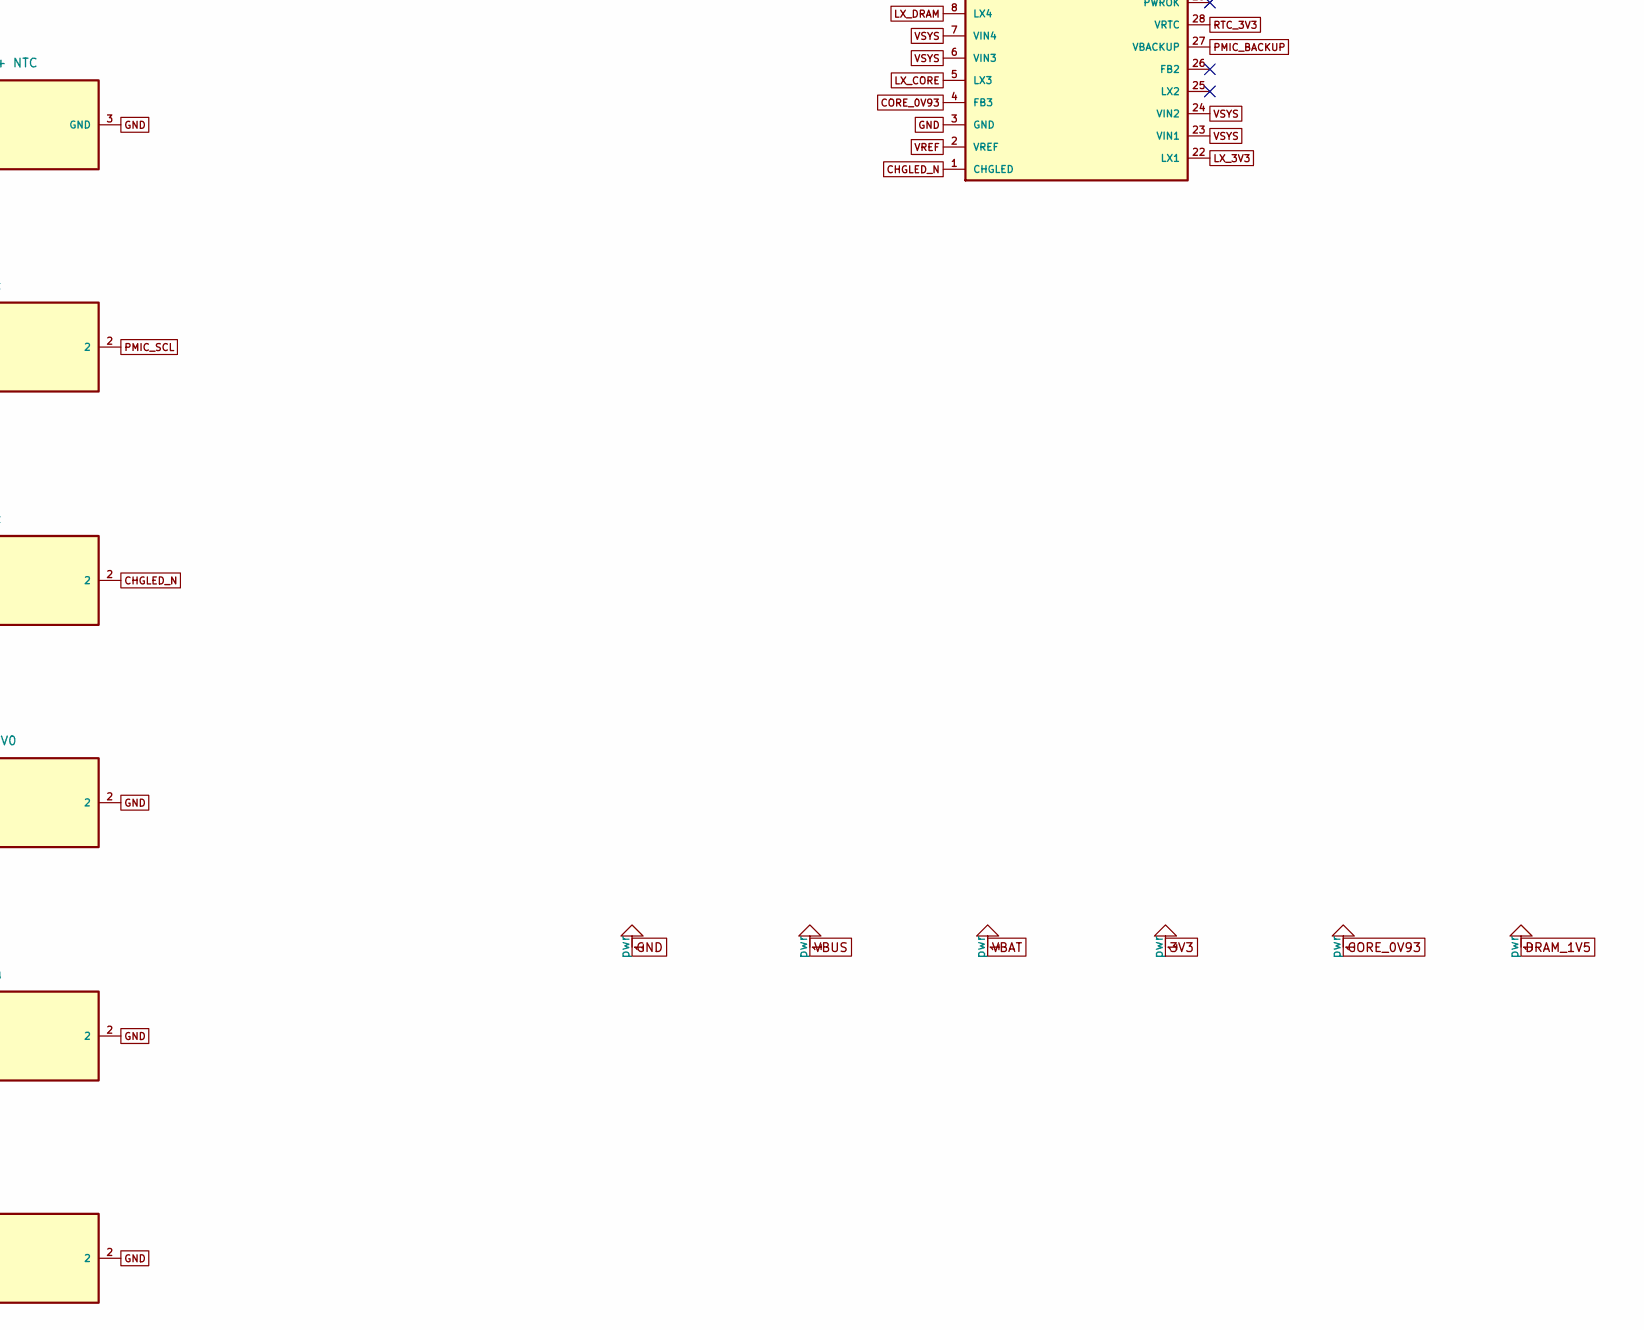
[picture p40: schematic 01_power.kicad_sch, part in row 2, column 2]

Parts:
C1, C2, C4, C5, C6, C7, C8, C9: 22u; 0603; MPN 0603 22u X5R
C3, C11, C33: 1u; 0603; MPN 0603 1u X5R
C10: 2.2u; 0603; MPN 0603 2.2u X5R
C32: 10u; 0603; MPN 0603 10u X5R
C38: 2.2u; 0603
C39: 100n; 0402
C40, C41: 1u; 0603
D1: CHARGE; LED0603; MPN 0603 Green LED
D13, D14: PESD4V0; 0402; MPN PESD4V0Y1BBSF
J1: USB4105-GF-A-060; USB4105; MPN USB4105-GF-A-060; LCSC C3025063
J2: 1S LiPo + NTC; BAT3; MPN S3B-PH-SM4-TB(LF)(SN); LCSC C265101
L1, L2, L3: 1uH/2A; IND_2x2; MPN 1uH 2A shielded
R1, R2: 5.1k; 0402; MPN 0402 5.1k 1%; LCSC C25905
R3: 4.7k; 0402; LCSC C25900
R4, R5, R6: 2.2k; 0402; LCSC C25879
SW5: POWER; SW_SIDE; MPN GT-TC072B-H045-L1; LCSC C5117859
U1: AXP2101; QFN40; MPN AXP2101; LCSC C3036461
U9: USBLC6-2SC6; SOT23-6; MPN USBLC6-2SC6; LCSC C2827654

Connections:
1V8: C10.1, U1.18 (ALDO1)
3V3: C4.1, C5.1, D1.1, L1.2, R3.1, R4.1, R5.1, U1.13 (BLDOIN), U1.17 (ALDOIN), U1.21 (FB1)
BAT_NTC: J2.2 (NTC), U1.31 (TS)
CHGLED_A: D1.2, R6.1
CHGLED_N: R6.2, U1.1 (CHGLED)
CORE_0V93: C6.1, C7.1, L2.2, U1.4 (FB3)
DRAM_1V5: C8.1, C9.1, L3.2, U1.9 (FB4)
GND: C1.2, C2.2, C3.2, C4.2, C5.2, C6.2, C7.2, C8.2, C9.2, C10.2, C11.2, C32.2, C33.2, C38.2, C39.2, C40.2, C41.2, D13.2, D14.2, J1.A1 (GND), J1.A12 (GND), J1.B1 (GND), J1.B12 (GND), J1.SH1 (SHIELD), J1.SH2 (SHIELD), J1.SH3 (SHIELD), J1.SH4 (SHIELD), J2.3 (GND), R1.2, R2.2, SW5.3 (GND), U1.3 (GND), U1.41 (EPAD), U9.2 (GND)
LX_3V3: L1.1, U1.22 (LX1)
LX_CORE: L2.1, U1.5 (LX3)
LX_DRAM: L3.1, U1.8 (LX4)
PMIC_BACKUP: C39.1, U1.27 (VBACKUP)
PMIC_IRQ_N: R3.2, U1.38 (IRQ)
PMIC_SCL: R4.2, U1.40 (SCK)
PMIC_SDA: R5.2, U1.39 (SDA)
PWRON_N: SW5.1 (PWRON), SW5.2 (PWRON), U1.30 (PWRON)
RTC_3V3: C33.1, U1.28 (VRTC)
USB_CC1: D13.1, J1.A5 (CC1), R1.1
USB_CC2: D14.1, J1.B5 (CC2), R2.1
USB_DM: J1.A7 (DM1), J1.B7 (DM2), U9.3 (I/O2), U9.4 (I/O2)
USB_DP: J1.A6 (DP1), J1.B6 (DP2), U9.1 (I/O1), U9.6 (I/O1)
VBAT: C3.1, J2.1 (VBAT), U1.33 (BAT)
VBUS: C32.1, J1.A4 (VBUS), J1.A9 (VBUS), J1.B4 (VBUS), J1.B9 (VBUS), U1.37 (VBUS), U9.5 (VBUS)
VREF: C11.1, U1.2 (VREF)
VSYS: C1.1, C2.1, C38.1, C40.1, C41.1, U1.6 (VIN3), U1.7 (VIN4), U1.23 (VIN1), U1.24 (VIN2), U1.34 (VSYS), U1.36 (VMID)
