LeeSpo/portable-display-epass-EVT1-minboot-r1/verification/native-20260905T063805Z-3f8f32/checked_project/04_interfaces.kicad_sch

## KiCad design verification/native-20260905T063805Z-3f8f32/checked_project/04_interfaces.kicad_sch (2026-09-05)

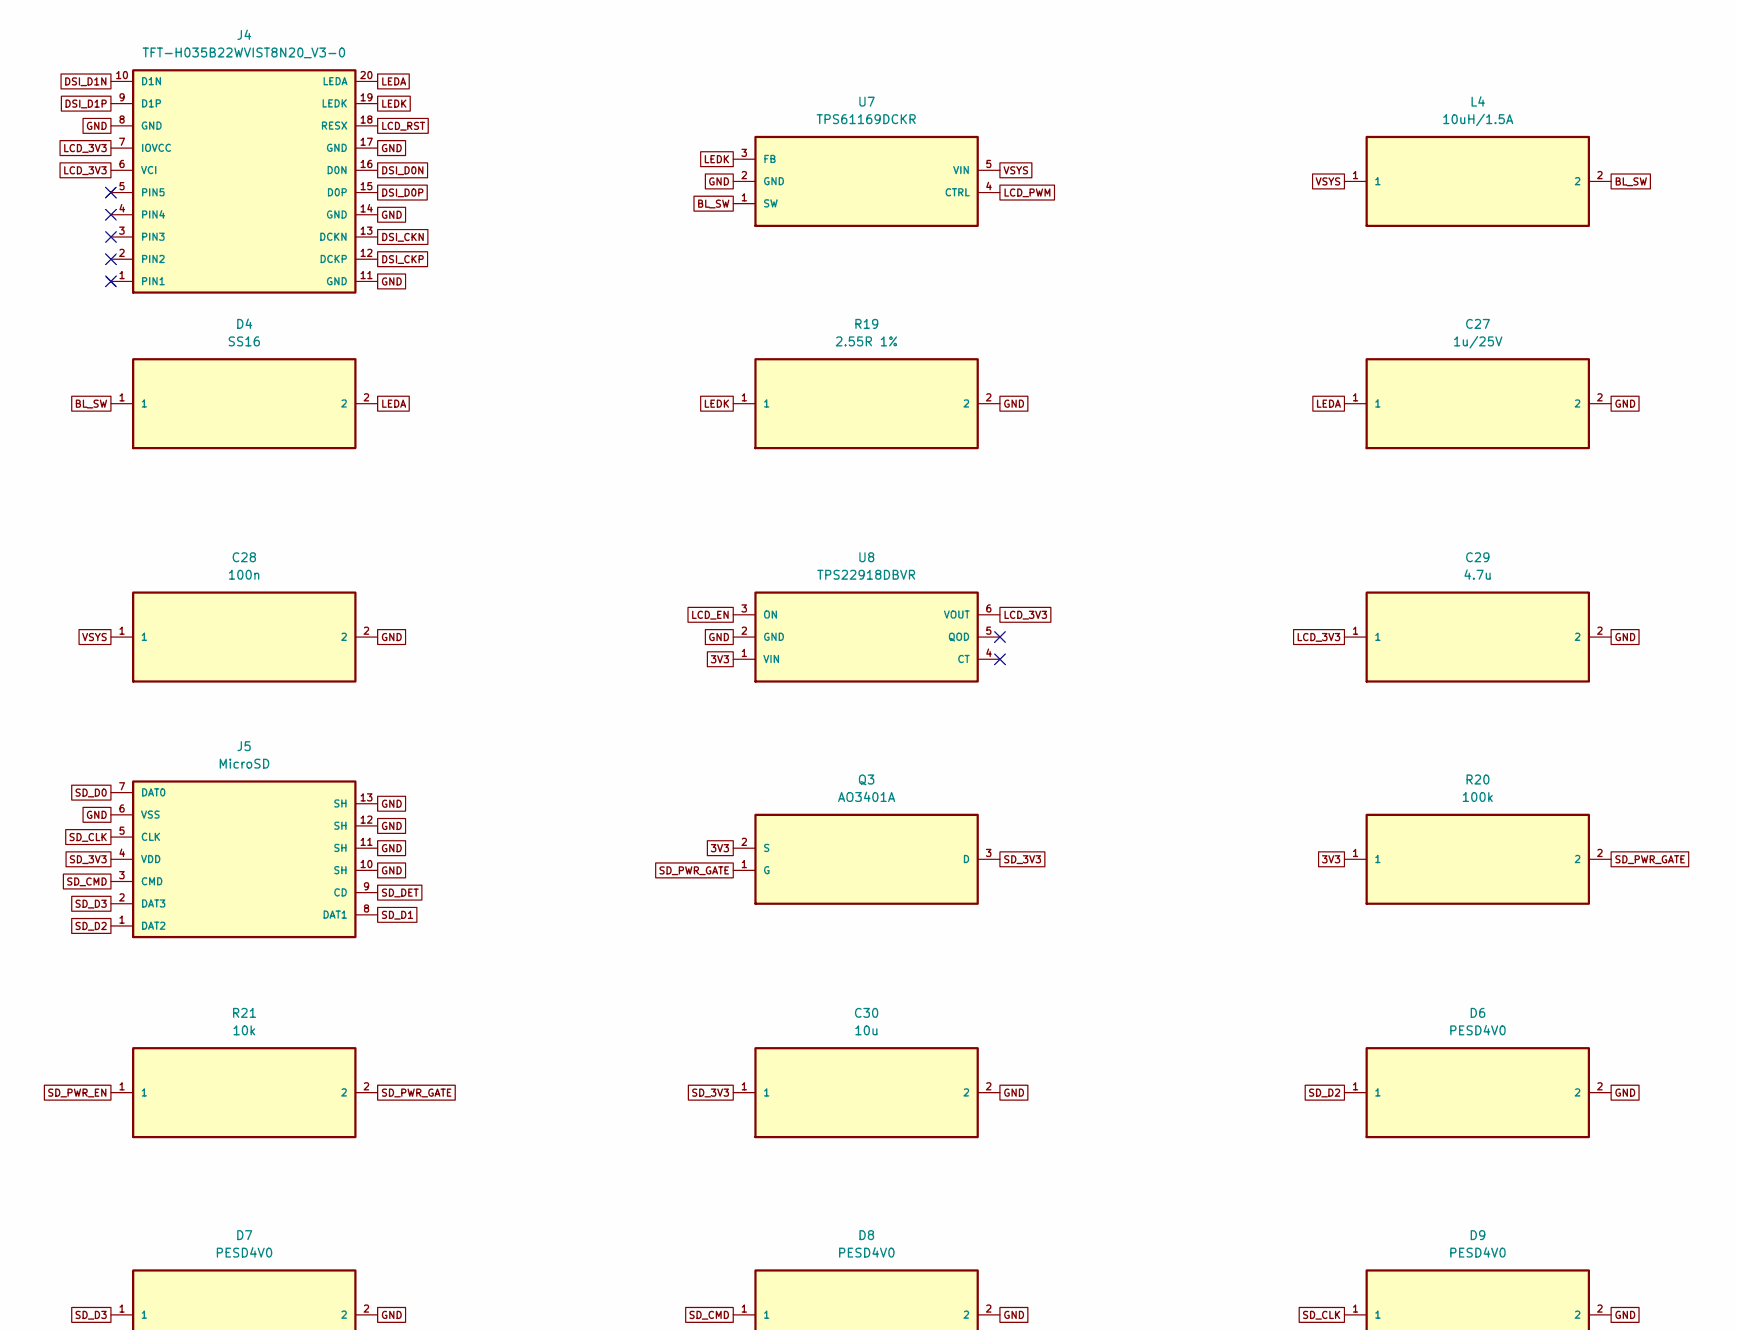
[picture p41: schematic 04_interfaces.kicad_sch, part in row 1, column 1]

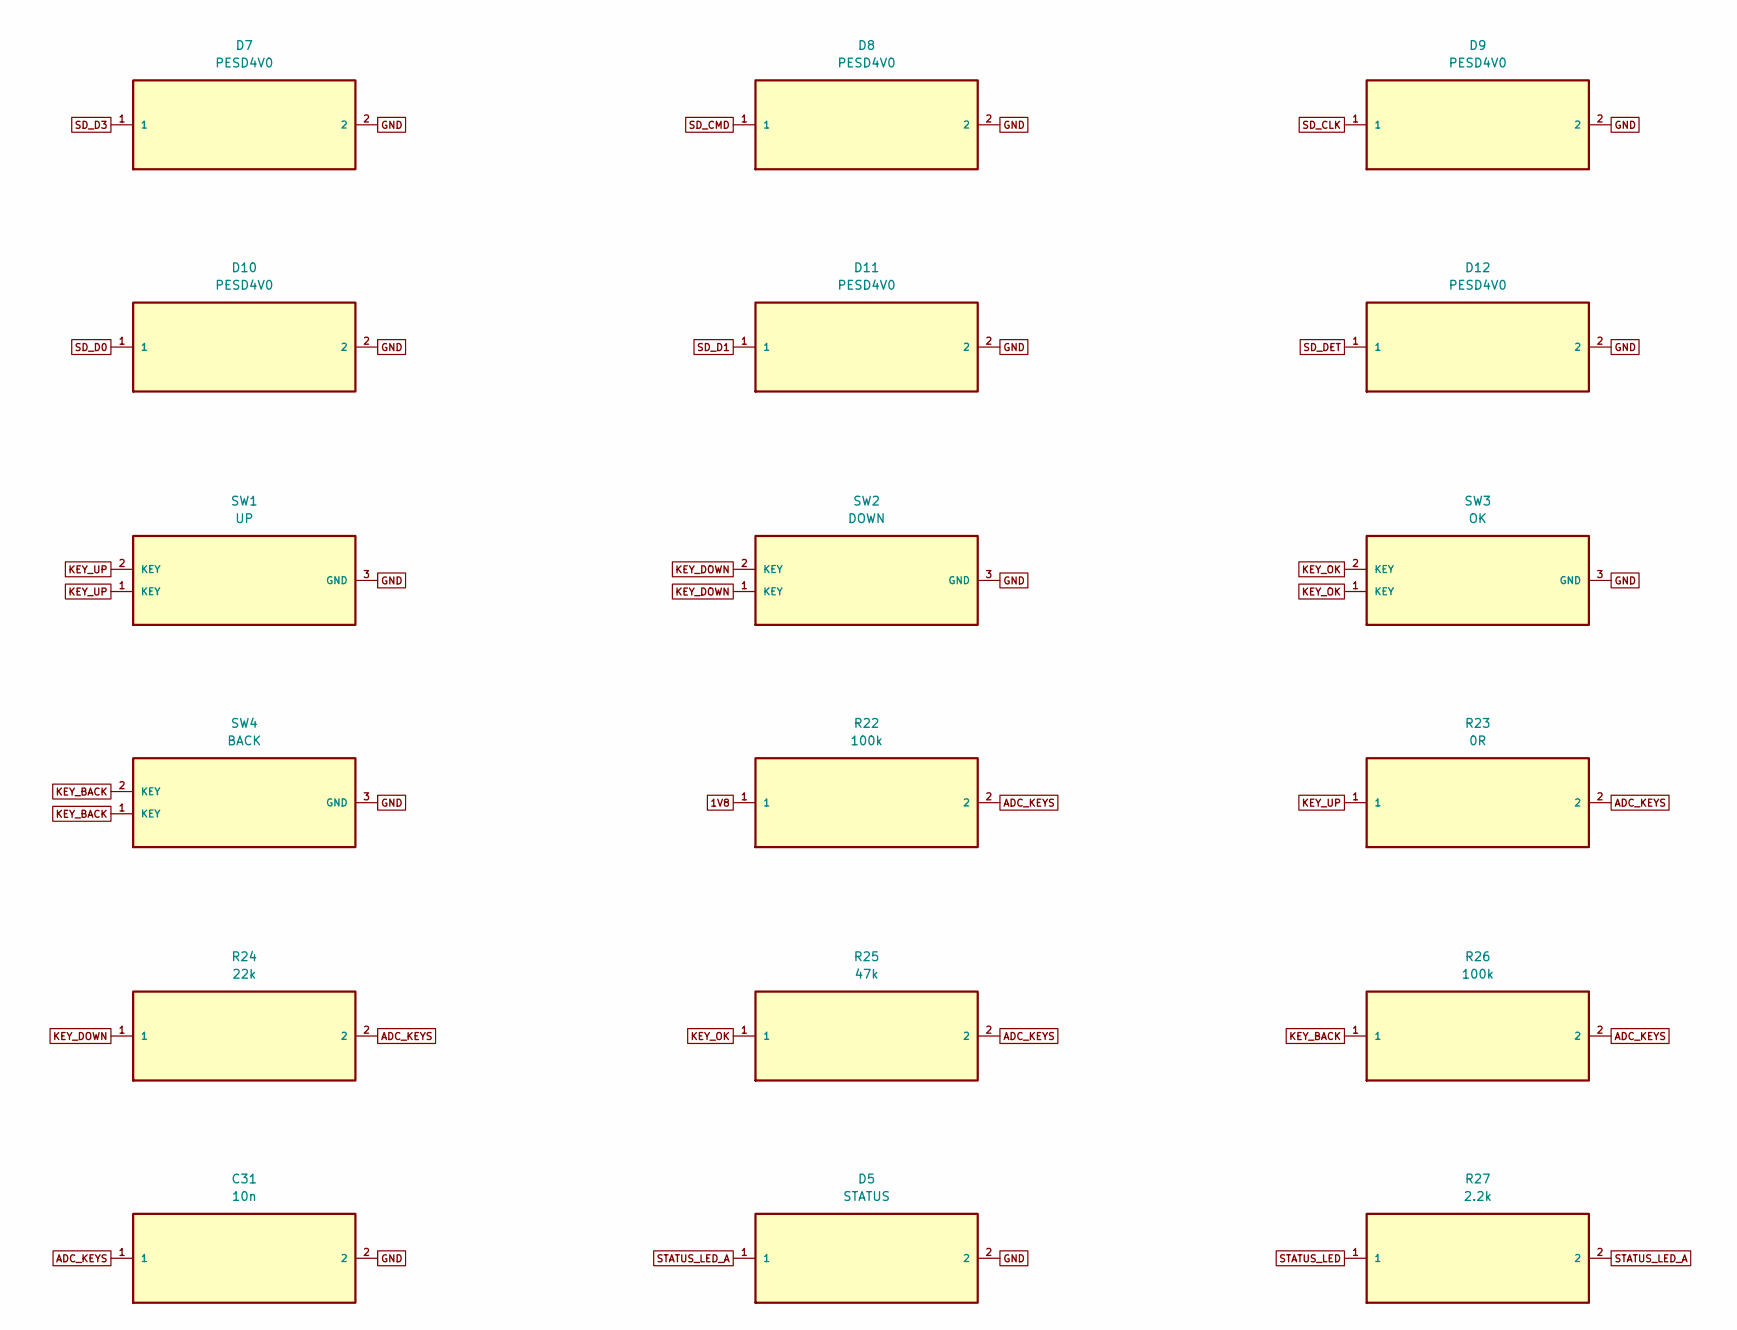
[picture p42: schematic 04_interfaces.kicad_sch, part in row 2, column 1]

Parts:
C27: 1u/25V; 0603
C28: 100n; 0402
C29: 4.7u; 0603
C30: 10u; 0603
C31: 10n; 0402
D4: SS16; D_SOD123
D5: STATUS; LED0603; MPN 0603 Blue LED
D6, D7, D8, D9, D10, D11, D12: PESD4V0; 0402; MPN PESD4V0Y1BBSF
J4: TFT-H035B22WVIST8N20_V3-0; FPC20; MPN FH12-20S-0.5SH(55); LCSC C596730
J5: MicroSD; MICROSD; MPN MUP-M617-2; LCSC C5205359
L4: 10uH/1.5A; IND_2x2
Q3: AO3401A; SOT23-3; MPN AO3401A; LCSC C15127
R19: 2.55R 1%; 0603
R20, R22, R26: 100k; 0402
R21: 10k; 0402
R23: 0R; 0402
R24: 22k; 0402
R25: 47k; 0402
R27: 2.2k; 0402
SW1: UP; SW_SIDE; MPN GT-TC072B-H045-L1; LCSC C5117859
SW2: DOWN; SW_SIDE; MPN GT-TC072B-H045-L1; LCSC C5117859
SW3: OK; SW_SIDE; MPN GT-TC072B-H045-L1; LCSC C5117859
SW4: BACK; SW_SIDE; MPN GT-TC072B-H045-L1; LCSC C5117859
U7: TPS61169DCKR; SC70-5; MPN TPS61169DCKR; LCSC C71045
U8: TPS22918DBVR; SOT23-6; MPN TPS22918DBVR

Connections:
1V8: R22.1
3V3: Q3.2 (S), R20.1, U8.1 (VIN)
ADC_KEYS: C31.1, R22.2, R23.2, R24.2, R25.2, R26.2
BL_SW: D4.1, L4.2, U7.1 (SW)
DSI_CKN: J4.13 (DCKN)
DSI_CKP: J4.12 (DCKP)
DSI_D0N: J4.16 (D0N)
DSI_D0P: J4.15 (D0P)
DSI_D1N: J4.10 (D1N)
DSI_D1P: J4.9 (D1P)
GND: C27.2, C28.2, C29.2, C30.2, C31.2, D5.2, D6.2, D7.2, D8.2, D9.2, D10.2, D11.2, D12.2, J4.8 (GND), J4.11 (GND), J4.14 (GND), J4.17 (GND), J5.6 (VSS), J5.10 (SH), J5.11 (SH), J5.12 (SH), J5.13 (SH), R19.2, SW1.3 (GND), SW2.3 (GND), SW3.3 (GND), SW4.3 (GND), U7.2 (GND), U8.2 (GND)
KEY_BACK: R26.1, SW4.1 (KEY), SW4.2 (KEY)
KEY_DOWN: R24.1, SW2.1 (KEY), SW2.2 (KEY)
KEY_OK: R25.1, SW3.1 (KEY), SW3.2 (KEY)
KEY_UP: R23.1, SW1.1 (KEY), SW1.2 (KEY)
LCD_3V3: C29.1, J4.6 (VCI), J4.7 (IOVCC), U8.6 (VOUT)
LCD_EN: U8.3 (ON)
LCD_PWM: U7.4 (CTRL)
LCD_RST: J4.18 (RESX)
LEDA: C27.1, D4.2, J4.20 (LEDA)
LEDK: J4.19 (LEDK), R19.1, U7.3 (FB)
SD_3V3: C30.1, J5.4 (VDD), Q3.3 (D)
SD_CLK: D9.1, J5.5 (CLK)
SD_CMD: D8.1, J5.3 (CMD)
SD_D0: D10.1, J5.7 (DAT0)
SD_D1: D11.1, J5.8 (DAT1)
SD_D2: D6.1, J5.1 (DAT2)
SD_D3: D7.1, J5.2 (DAT3)
SD_DET: D12.1, J5.9 (CD)
SD_PWR_EN: R21.1
SD_PWR_GATE: Q3.1 (G), R20.2, R21.2
STATUS_LED: R27.1
STATUS_LED_A: D5.1, R27.2
VSYS: C28.1, L4.1, U7.5 (VIN)
