LeeSpo/portable-display-epass-EVT1-minboot-r1/verification/native-20260905T072707Z-d77f91/checked_project/03_sensors.kicad_sch

## KiCad design verification/native-20260905T072707Z-d77f91/checked_project/03_sensors.kicad_sch (2026-09-05)

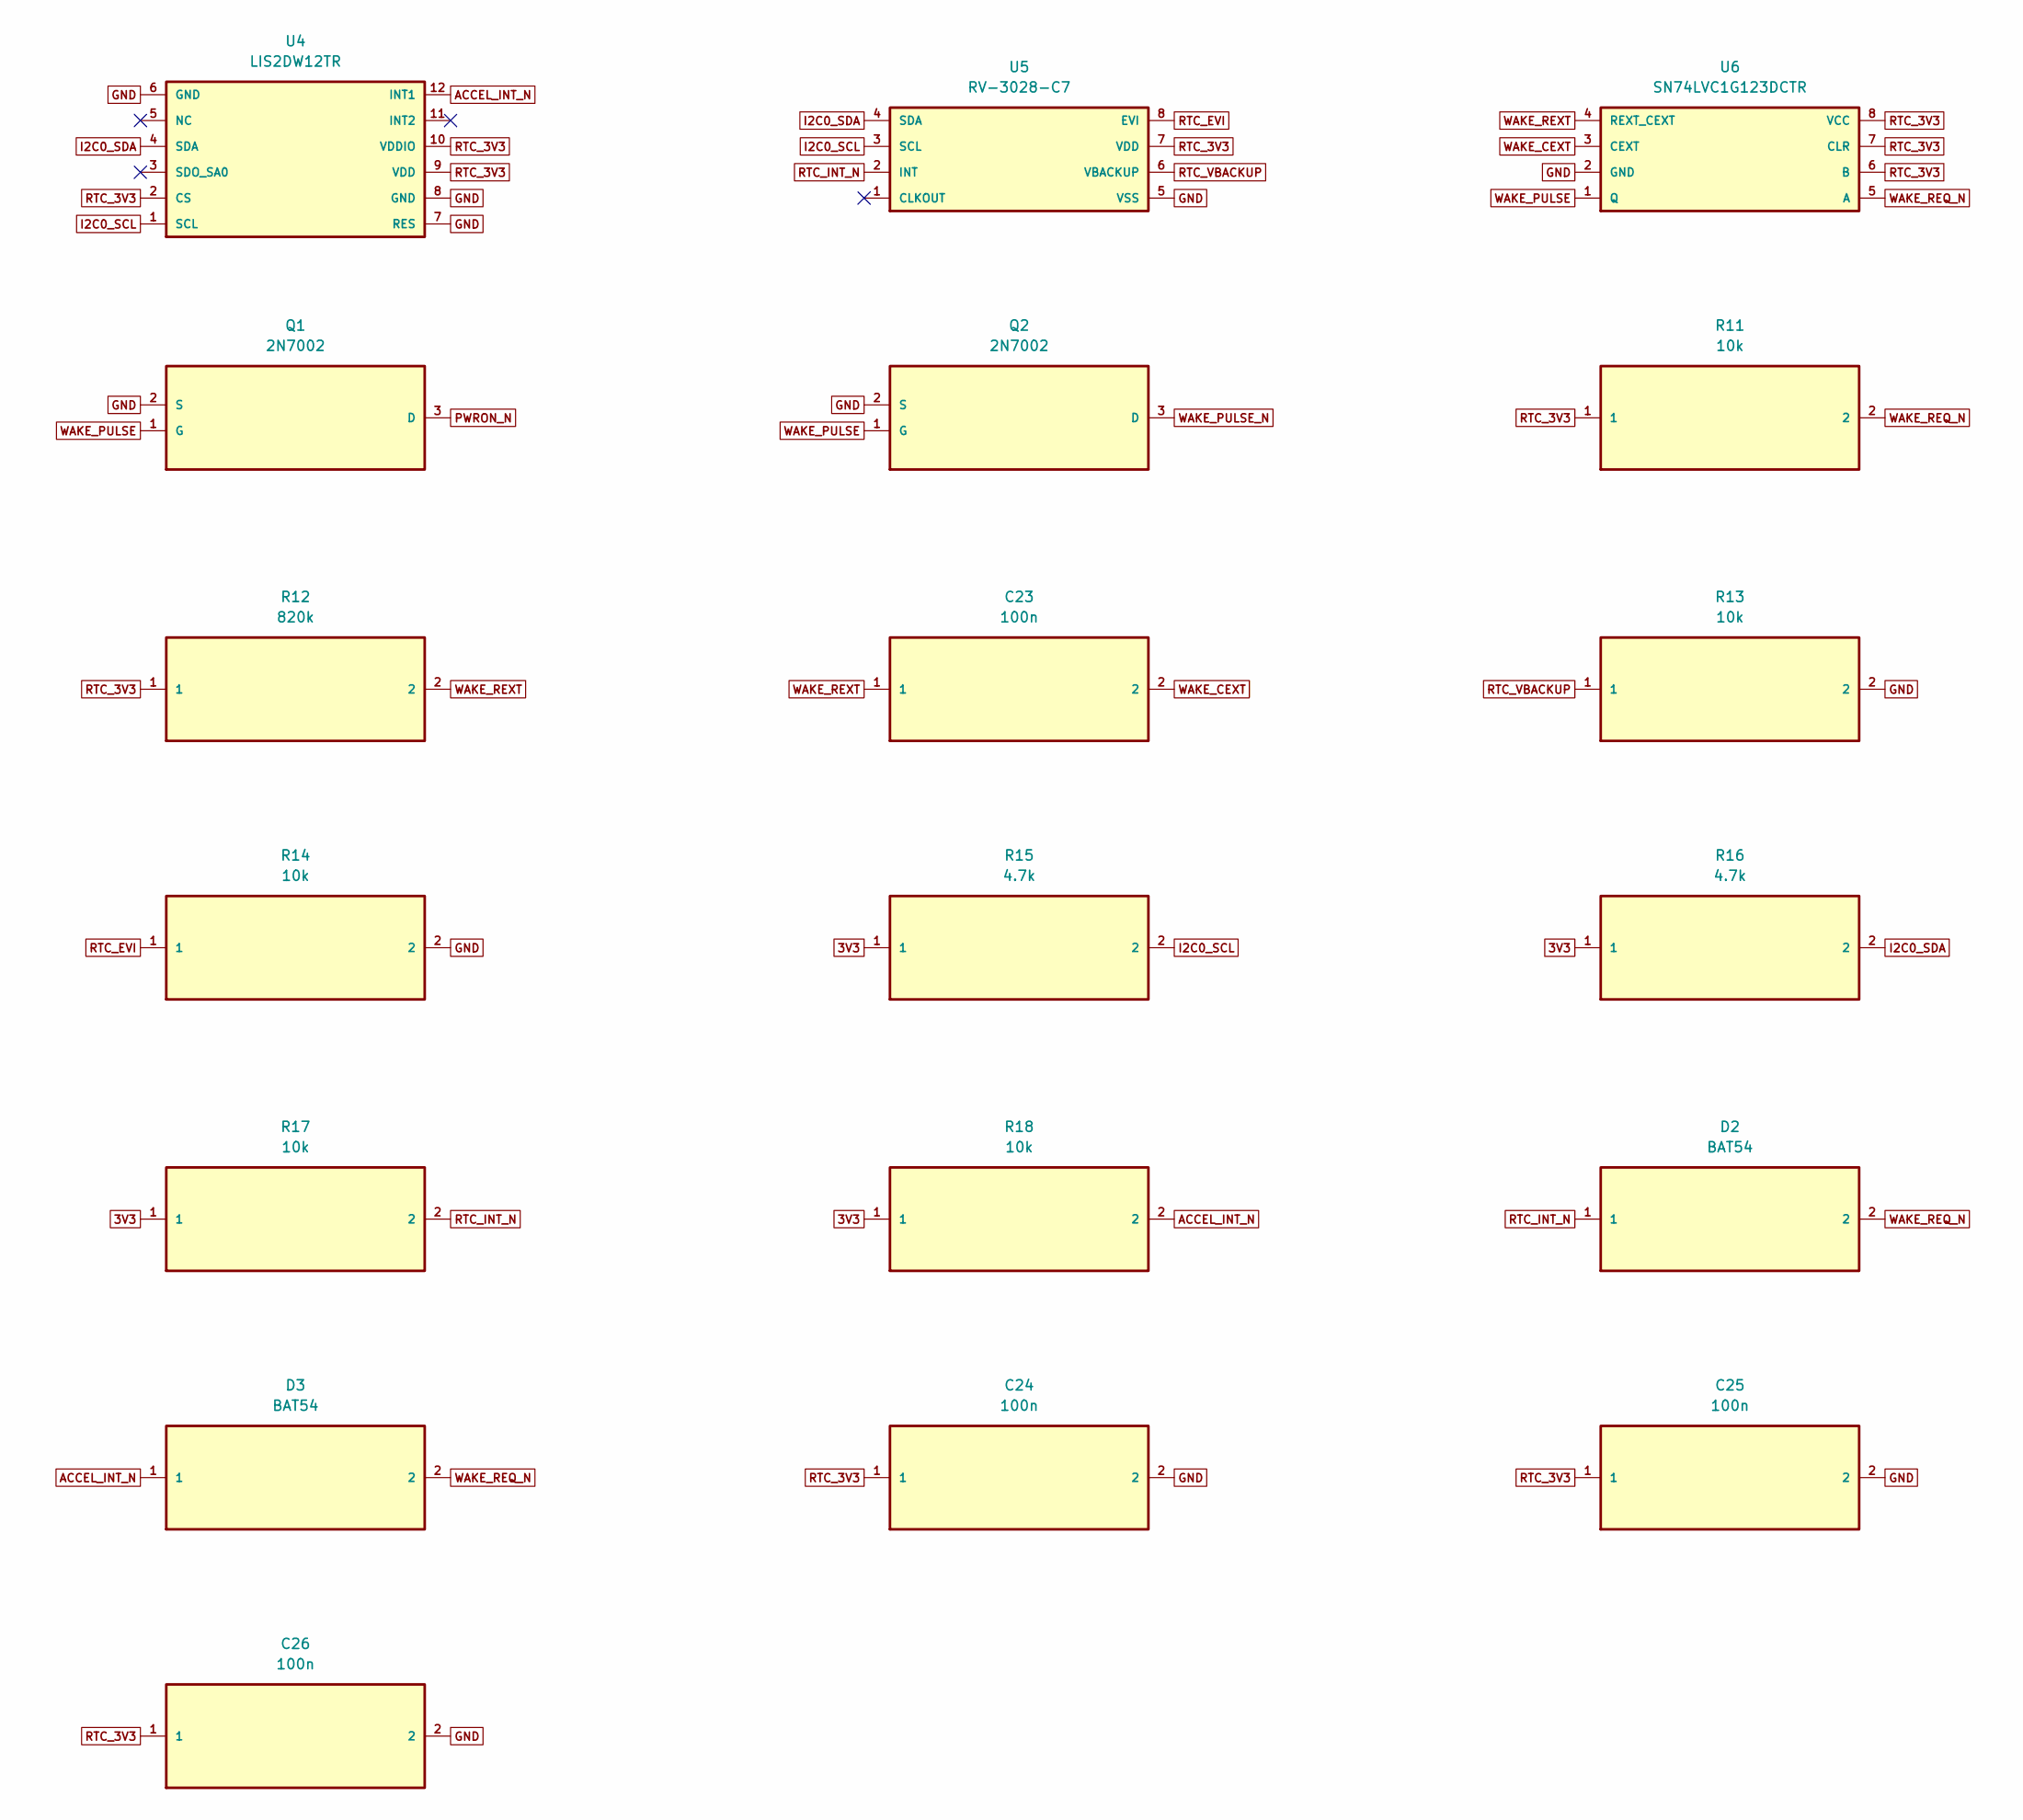
[picture p43: schematic 03_sensors.kicad_sch]

Parts:
C23: 100n; 0402
C24, C25, C26: 100n; 0402; LCSC C1525
D2, D3: BAT54; D_SOD123
Q1, Q2: 2N7002; SOT23-3; MPN 2N7002; LCSC C8545
R11, R13, R14, R17, R18: 10k; 0402
R12: 820k; 0402
R15, R16: 4.7k; 0402
U4: LIS2DW12TR; LGA-12; MPN LIS2DW12TR; LCSC C189624
U5: RV-3028-C7; RTC-8; MPN RV-3028-C7-32.768kHz-1ppm-TA-QC; LCSC C3019759
U6: SN74LVC1G123DCTR; SSOP-8; MPN SN74LVC1G123DCTR

Connections:
3V3: R15.1, R16.1, R17.1, R18.1
ACCEL_INT_N: D3.1, R18.2, U4.12 (INT1)
GND: C24.2, C25.2, C26.2, Q1.2 (S), Q2.2 (S), R13.2, R14.2, U4.6 (GND), U4.7 (RES), U4.8 (GND), U5.5 (VSS), U6.2 (GND)
I2C0_SCL: R15.2, U4.1 (SCL), U5.3 (SCL)
I2C0_SDA: R16.2, U4.4 (SDA), U5.4 (SDA)
PWRON_N: Q1.3 (D)
RTC_3V3: C24.1, C25.1, C26.1, R11.1, R12.1, U4.2 (CS), U4.9 (VDD), U4.10 (VDDIO), U5.7 (VDD), U6.6 (B), U6.7 (CLR), U6.8 (VCC)
RTC_EVI: R14.1, U5.8 (EVI)
RTC_INT_N: D2.1, R17.2, U5.2 (INT)
RTC_VBACKUP: R13.1, U5.6 (VBACKUP)
WAKE_CEXT: C23.2, U6.3 (CEXT)
WAKE_PULSE: Q1.1 (G), Q2.1 (G), U6.1 (Q)
WAKE_PULSE_N: Q2.3 (D)
WAKE_REQ_N: D2.2, D3.2, R11.2, U6.5 (A)
WAKE_REXT: C23.1, R12.2, U6.4 (REXT_CEXT)
