LeeSpo/portable-display-epass-EVT1-minboot-r1/(commit log)

2026-09-06 docs: add 2.4\" true-AOD display branch goals
    Scope: RM690B0/ICNA3312-class MIPI 2-lane AOD panel integration on a branch from board.
    Kept separate from U2 0.3 via experiment; fabrication_released unchanged.
2026-09-06 feat(display): wire KD024 45-pin MIPI1 on J4; DNP TFT backlight; EL nets TBD
    - Replace FPC20 TFT placeholder with Molex 502598-4591 / KD024EGOIN152-01
    - IM0/IM1→GND; VCI via U8; VDDIO from 1V8; TE on PD20; DSI lane0 only
    - ELVDD/ELVSS/SWIRE nets + probe pads; no invented EL PMIC
    - U7 backlight chain DNP; docs/DISPLAY_KD024_NETMAP.md; gates in_progress
    - fabrication_released remains false
2026-09-06 feat(display): add TPS65631 EL± bias (C165127) for KD024
    - Lock EL PMIC to TPS65631DPDR: ELVDD/ELVSS, CTRL=LCD_EN
    - Defaults 4.6V / -4.0V (within KD024 abs max); panel SWIRE optional via R31 DNP
    - Passives per TI typical app; docs/DISPLAY_EL_TPS65631.md
    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
2026-09-06 wip(pcb): place KD024 FPC45 + TPS65631 display island
    - J4 FPC20→FPC45 at (34,38); U10 + L5/L6 + EL/VCI caps placed
    - Local EL Cout copper only; MIPI/control/J4 feeds still ratsnest
    - Cleared pocket copper under new island (SD/KEY restore needed)
    - DRC: 7 copper / 81 unconnected / 27 parity; fabrication_released false
    - See docs/DISPLAY_PCB_STATUS.md
2026-09-06 fix: correct electrical nets and pinouts for U6, VMID, and V851S power domains
2026-09-07 feat: [Grok] implement DRC-aware automatic PCB router
2026-09-07 refactor: transition to TF-only boot architecture , removing SPI NAND components
2026-09-08 feat: introduce split-plane design PCB layout
2026-09-08 feat: update PCB layout with CORE_0V93 routing and add GUI verification reports
2026-09-10 feat: add routing verification scripts and PCB design snapshots for power plane redesign
2026-09-11 feat: update split-power PCB layout with refined footprints, routing verification data, and updated layout documentation.
2026-09-11 feat: add shell script to automate Gerber file export for hardware redesign
2026-09-20 fix(pcb): repair U1/U2 land patterns and re-route escapes for split-power layout
2026-09-21 feat: TF card power
2026-10-01 feat(validation): check component part numbers and footprints
2026-10-01 fix(hardware): extend automatic wake pulse to nominal 3 seconds
    Use a 910k resistor and 3.3uF 0805 timing capacitor, bind JLCPCB parts, and reroute the timing nets. Synchronize schematics, local footprint and independent component requirements. Physical timing and retrigger behavior remain subject to validation.
2026-10-01 docs(hardware): record wake pulse checks and acceptance requirements
    Save ERC, DRC, netlist, connectivity and timing analysis reports with artifact hashes and updated layer previews. Document the measured pulse window, firmware interrupt handling and remaining physical validation.
2026-10-04 feat: add split power candidate hardware design and wake domain verification reports
2026-10-14 fix(pcb): complete FEL recovery copper (SW6/J3.7 -> R33 -> U2.56/PC1, R34 to 3V3)
2026-10-14 fix(sch): regenerate candidate schematic with R33/R34 FEL recovery on PC1
2026-10-14 fix(pcb): add R35 10k LCD_EN pulldown for default-off display power
2026-10-14 fix(pcb): replace D6-D14 with ESDLC5V0LB (C20168172) on dedicated DFN1006-2 land
2026-10-14 fix(pcb): replace J2 battery connector with 1.0mm SH 3P RA (C7430445) on verified land; reroute VBAT/NTC/VBUS/PMIC_IRQ
2026-10-14 fix(pcb): widen VBUS B.Cu main path J1->C32/U1 from 0.25 to 0.6 mm
    J1-adjacent F.Cu necks (0.25) stay: CC2/SBU1/C2-GND pads leave no room.
    A parallel 0.6 path exists from J1 A4/B9. U1.37 fan-in stays 0.18 (pad pitch).
2026-10-14 fix(pcb): add C53 1uF (C52923) + C54 100nF (C1525) at U8 TPS22918 VIN
    Both JLC basic 0402, F.Cu, GND via outside pad (>=0.15 mm pad-to-hole).
    Schematic regenerated; DRC/parity/ERC 0.
2026-10-14 docs: add FEL_REPAIR_CN, PREFLIGHT_DECISIONS_CN and update power_requirements for R35/C53/C54/J2/D6-D14
    Includes fresh verification run (DRC/parity/ERC 0, static checks pass).
2026-10-14 feat(j5): swap microSD to in-stock XKTF-0803-0, TPD4E05U06 flow-through ESD, reroute SD bus off Y1
2026-10-14 fix(power): feed U10 TPS65631 from 3V3 via local In2 taps; 2x10u+100n under U10
2026-10-14 feat(power): 0R bring-up isolation links on AXP2101 rails
2026-10-14 feat(pcb): add B-side decoupling for U2 pins 44/37, reroute low-speed GPIO
2026-10-14 feat(silk): pin-1 dots and diode cathode marks in library and board
2026-10-14 fix(pcb): move 18 vias out of SMD pads
2026-10-14 fix(pcb): shorten FEL_N In1 slot, widen 3V3_B feed, document PMIC_SCL inner hop
2026-10-14 feat(pcb): JLC04101H-3313 stackup, coupled USB/DSI-CK pairs, J4 nail pads per Molex SD-502598-003, POFV decision
2026-10-14 chore(bom): assign LCSC/MPN to 62 parts (JLC basic preferred)
2026-10-14 build(production): JLC package (gerber/drill/BOM/CPL) from aa48459, not released
2026-10-14 feat(pcb): B-side 100nF decoupling C56/C58/C61 for U2 CORE pins 13/17/75
2026-10-15 feat(pcb): 3V3_B decoupling C55/C63 for U2-5/78; bring-up, risk and next-rev docs
2026-10-17 refactor(validation): make split-power checks self-contained
2026-10-17 docs(hardware): document current candidate and historical recovery
2026-10-18 `feat(pcb): improve V1 decoupling, test access, and routing`
